anhenaobe/industrial-comunication-gateway/docs/industrial_linux_gateway_requirements.md

# Industrial Communication Gateway

## Revisión 0.5 — Especificación técnica preliminar de producto y sistema

| Campo | Valor |
|---|---|
| Proyecto | Industrial Communication Gateway (nombre provisional) |
| Tipo de documento | Especificación técnica preliminar de producto y sistema |
| Revisión | 0.5 |
| Estado | Fase de diseño y requisitos; baseline de componentes seleccionada provisionalmente; sin esquemático, PCB, firmware validado ni prototipo completo |
| Fecha | 2026-10-04 |
| Propietario | Equipo del proyecto universitario de Diseño Electrónico |
| Archivo maestro | `docs/industrial_linux_gateway_requirements.md` |

> **Estado de plataforma.** Rev. A utilizará **STM32H723VET6** como plataforma principal de procesamiento y **Zephyr RTOS** como base de software embebido. Esta decisión está **ACCEPTED / BASELINE FOR REV A**. La revisión externa del pinout confirmó recursos suficientes para las interfaces previstas, pero la asignación concreta de pines y periféricos sigue **TBD** y deberá congelarse antes del esquemático. La decisión no implica que existan firmware, PCB, prototipo o validación funcional.

---

## 1. Propósito, descripción y alcance

Este documento define el baseline técnico preliminar de un gateway de comunicación industrial destinado a integrar equipos de campo heterogéneos con redes IP, servicios de supervisión, servidores o sistemas SCADA. Conserva los requisitos y decisiones de revisiones anteriores, registra los cambios de arquitectura aceptados y separa explícitamente lo decidido, los objetivos de diseño, lo implementado, lo validado y los elementos todavía TBD.

### 1.1 Problema

Los entornos industriales combinan equipos con RS-485, CAN-FD, señales digitales de 24 V, interfaces Ethernet y dispositivos legacy que no ofrecen integración directa con servicios IP modernos. Las diferencias de interfaz eléctrica, protocolo, referencia de tierra, protección, temporización y mantenibilidad impiden conectar esos equipos directamente a una red superior de forma defendible.

El equipo, la instalación y el flujo que constituirán el caso industrial demostrador concreto todavía son **TBD** (TBD-02/03). No se atribuyen cliente, planta, pérdidas ni métricas sin evidencia.

El problema de ingeniería no es solo traducir datos. El sistema debe:

- adaptar y proteger las interfaces eléctricas de campo;
- adquirir, validar, asociar tiempo y normalizar información;
- traducir protocolos sin asumir control crítico en tiempo real;
- conservar datos y evidencia diagnóstica ante fallos razonables;
- ofrecer configuración, mantenimiento y recuperación reproducibles;
- separar la electrónica expuesta al entorno industrial del dominio de procesamiento embebido.

### 1.2 Solución propuesta y propósito

La solución se compone de una PCB propia con un **STM32H723VET6**, software embebido basado en **Zephyr RTOS** y bloques industriales de alimentación, protección, conversión, transceptores, acondicionamiento de E/S, almacenamiento persistente, conectores, diagnóstico y prueba. Los componentes principales de interfaz están seleccionados provisionalmente (§3.6); la tecnología y capacidad del almacenamiento y la asignación concreta de pines permanecen TBD.

El producto actúa como puente entre:

| Lado | Función |
|---|---|
| **FIELD SIDE** | Conexión a RS-485, CAN-FD, E/S digitales de 24 V y equipos Ethernet de máquina. |
| **NETWORK / SERVER SIDE** | Comunicación IP con SCADA, servidor, servicios de gestión o API seleccionada. |

Las capacidades objetivo comprenden adquisición, traducción de protocolos, procesamiento local, almacenamiento, logging, diagnóstico y comunicación con servidor. El gateway no se define como controlador de seguridad ni como plataforma de control crítico de tiempo real.

### 1.3 Filosofía de diseño

| Principio | Aplicación al proyecto |
|---|---|
| Modularidad funcional | Mantener límites eléctricos y lógicos documentados entre procesamiento, alimentación, red e interfaces de campo. |
| Robustez | Definir protección, retornos de corriente, aislamiento y comportamiento ante fallos según evidencia del entorno. |
| Mantenibilidad | Proporcionar identificación de versiones, logs, consola de servicio, actualización y recuperación documentadas. |
| Testabilidad | Incorporar puntos de prueba, diagnóstico por bloques y procedimientos reproducibles desde Rev. A. |
| Escalabilidad | Reservar capacidades y expansión externa sin convertirlas en requisitos de Rev. A. |
| Separación de dominios | Mantener el procesamiento embebido separado de transceptores y front-ends expuestos al campo. |
| Diseño industrial | Tratar alimentación, ESD/EFT/surge, grounding, conectores y mecánica como partes del sistema. |
| Trazabilidad | Vincular decisiones, requisitos, TBD y evidencia de verificación mediante IDs estables. |

### 1.4 Alcance de Rev. A

#### In Scope

- integración del STM32H723VET6 como plataforma principal y Zephyr RTOS como base de software;
- congelación de la asignación de periféricos y pines a partir de la suficiencia ya verificada;
- diseño de la PCB propia y su integración mecánica;
- entrada industrial nominal de 24 VDC, regulación, filtrado y protección;
- una interfaz Ethernet como uplink principal y evaluación de una segunda interfaz como objetivo TBD;
- dos canales RS-485 y un canal CAN-FD como arquitectura objetivo;
- cuatro entradas digitales industriales de 24 V y dos salidas digitales industriales como arquitectura objetivo;
- interfaz de servicio desde PC; medio físico y cantidad de interfaces TBD;
- consola o mecanismo de mantenimiento, indicadores de estado y estrategia de watchdog; implementación TBD;
- integración Zephyr, drivers, adquisición y servicios embebidos básicos;
- logging, almacenamiento local, timestamping, configuración y diagnóstico;
- validación eléctrica, funcional y de comunicaciones;
- documentación, DFM y DFT básicas.

#### Out of Scope para Rev. A

- diseño RF, Wi-Fi integrado, antenas propias o LTE integrado directamente en la PCB;
- diseño de memoria DDR externa;
- GPU como requisito de aplicación;
- pantalla local o GUI en pantalla integrada;
- certificación del producto completo o declaración de cumplimiento EMC;
- seguridad funcional certificada;
- visión artificial, IA o control de motores;
- interfaces analógicas industriales 0–10 V o 4–20 mA sin un caso de uso que las justifique;
- procesador o MCU auxiliar adicional sin requisito que lo justifique.

#### Future Expansion

- LTE mediante módulo comercial externo;
- entradas 4–20 mA y 0–10 V;
- TSN, secure boot y actualizaciones firmadas;
- monitorización avanzada y canales adicionales CAN o RS-485;
- procesador auxiliar solo si aparece un requisito específico conforme a §3.3.

### 1.5 Convenciones

- **Deberá:** requisito verificable; **TBD:** parámetro, componente o decisión pendiente de evidencia.
- **Must / Should / Could / Won't:** prioridad MoSCoW para Rev. A.
- **Accepted:** decisión vigente; **Preliminary Accepted:** baseline de diseño sujeto a validación; **Planned:** uso reservado, no dependencia obligatoria; **Deferred:** fuera de Rev. A; **Superseded:** decisión histórica reemplazada.
- Una cantidad marcada **TARGET / PRELIMINARY BASELINE** orienta la arquitectura, pero no se considera congelada hasta cerrar sus criterios de aceptación.
- **SELECTED / PROVISIONAL DESIGN BASELINE:** selección provisional para la arquitectura actual; no implica fabricación, circuito probado ni validación física.
- **Origen:** necesidad, caso de uso o decisión que justifica el requisito.
- Producto (§5) define comportamiento; sistema (§7) lo descompone por responsabilidad.
- **Decided:** decisión formal vigente; **Implemented:** existe una realización revisable; **Validated:** existe evidencia contra un criterio de aceptación; **Not implemented / Not validated:** estado explícito cuando solo existe intención o decisión.

### 1.6 Verificación

| Código | Método | Evidencia |
|---|---|---|
| I | Inspección | Documentación, configuración, montaje o marcado. |
| A | Análisis | Cálculo, simulación o evaluación técnica. |
| T | Ensayo | Medición o estímulo controlado. |
| D | Demostración | Ejecución funcional representativa. |

Un requisito no puede cerrarse mientras su criterio de aceptación siga siendo TBD.

---

## 2. Contexto y Decision Register

### 2.1 Hechos conocidos

| ID | Hecho |
|---|---|
| H-01 | El STM32H723VET6 es la plataforma principal de procesamiento seleccionada para Rev. A y Zephyr RTOS es la base de software embebido. |
| H-02 | El proyecto incluye el diseño de una PCB industrial propia con separación funcional entre procesamiento e interfaces expuestas al campo. |
| H-03 | El sistema integrará equipos industriales externos con una red IP, servidor o SCADA. |
| H-04 | No existe todavía esquemático ni PCB del gateway. |
| H-05 | No se han realizado ensayos eléctricos o funcionales del gateway completo. |
| H-06 | La tecnología, capacidad, resistencia y arquitectura del almacenamiento persistente permanecen TBD. |
| H-07 | Rev. A no incorpora un procesador o MCU auxiliar adicional sin un requisito que lo justifique. |
| H-08 | Una revisión externa del pinout confirmó que el STM32H723VET6 dispone de pines suficientes para las interfaces previstas; la asignación concreta de señales y periféricos sigue TBD. La referencia durable de esa revisión debe incorporarse al repositorio (TBD-38). |

### 2.2 Baseline funcional objetivo de Rev. A

| Elemento | Objetivo preliminar | Estado |
|---|---|---|
| Plataforma de procesamiento | STM32H723VET6 + Zephyr RTOS | Decided / Accepted for Rev. A; firmware not implemented, not validated |
| Ethernet principal | 1 × DP83826I, 10/100, RMII previsto | Seleccionado provisionalmente; implementación pendiente |
| Segundo Ethernet | Segunda interfaz independiente | Target / TBD; requiere justificación y validación de recursos |
| RS-485 | 2 × THVD1420, half-duplex | Seleccionados provisionalmente; parámetros de bus TBD |
| CAN | 1 × ATA6561 CAN-FD | Seleccionado provisionalmente; parámetros de bus TBD |
| Entradas digitales | 2 × ISO1212 → 4 DI aisladas de 24 V | Seleccionados provisionalmente; pasivos y umbrales TBD |
| Salidas digitales | 2 × BSP75N → 2 DO low-side, 24 V / 500 mA nominales por canal | Seleccionados provisionalmente; adaptación de control y estado seguro TBD |
| Interfaz de servicio | Medio soportado desde PC | Función Accepted por D-17; medio, cantidad, protocolo y conectores TBD |
| Almacenamiento | Persistencia local para configuración, logs y datos pendientes | Función accepted; tecnología, capacidad y resistencia TBD |
| Indicadores | Alimentación, sistema y fault; actividad adicional si es práctica | Target; cantidad y semántica TBD |
| Alimentación | 24 VDC nominal → protección → filtro → conversión | Rails mínimos 3.3 V, 5 V y campo 24 V; presupuesto y conversión TBD |

### 2.3 Decision Register

Se preservan los IDs `D-*` de las revisiones anteriores. Las decisiones solicitadas para esta revisión se incorporan sin duplicar las ya existentes.

| ID | Decisión | Estado | Justificación / consecuencia |
|---|---|---|---|
| D-01 | Arquitectura Linux con separación entre plataforma de cómputo y carrier industrial. | **Superseded by D-18** | Se conserva como decisión histórica. La separación funcional entre procesamiento e interfaces industriales permanece, pero Linux y el SoM dejaron de ser el baseline vigente. |
| D-02 | Ethernet cableado como uplink principal. | Accepted | Proporciona la interfaz primaria con la red superior y facilita integración y diagnóstico IP. |
| D-03 | Wi-Fi fuera del alcance inicial. | Accepted | Rev. A no incorpora conectividad Wi-Fi integrada. |
| D-04 | LTE solo mediante módulo comercial externo o expansión futura. | Deferred | Evita diseño RF propio y mantiene LTE fuera de la función base. |
| D-05 | Sin antena ni front-end RF propio. | Accepted | El diseño de RF no forma parte de Rev. A. |
| D-06 | No seleccionar plataforma ni componentes en la revisión 0.2. | Superseded by D-07 | Se conserva por trazabilidad histórica; ya no describe el estado vigente. |
| D-07 | MYC-YM6231 basado en TI AM6231 / AM62x como plataforma de cómputo de Rev. A. | **Superseded by D-18** | Decisión histórica de Rev. 0.3. Se conserva su razonamiento: SoM con Cortex-A53, Cortex-M4F, PRU, Linux, DDR, eMMC y PMIC integrados. Ya no describe la arquitectura vigente. |
| D-08 | No utilizar un MCU auxiliar adicional en Rev. A. | Accepted; clarified by D-18 | Se refiere a un segundo procesador auxiliar. No contradice que la plataforma principal sea ahora un MCU. Solo se reabrirá si aparece una necesidad que el STM32H723VET6 y circuitos de supervisión más simples no puedan satisfacer. |
| D-09 | Reservar el Cortex-M4F interno del SoM anterior para supervisión y tareas deterministas. | **Superseded by D-18** | Decisión histórica asociada exclusivamente al MYC-YM6231; ese recurso no forma parte de la arquitectura vigente. |
| D-10 | Reservar PRU del SoM anterior para I/O determinista o protocolos futuros. | **Superseded by D-18** | Decisión histórica asociada exclusivamente al MYC-YM6231; ese recurso no forma parte de la arquitectura vigente. |
| D-11 | Dos interfaces Gigabit Ethernet como arquitectura objetivo. | Reopened / TBD | Ethernet cableado principal permanece Accepted por D-02. La necesidad, velocidad y viabilidad de una segunda interfaz deben justificarse; no se consideran cerradas. |
| D-12 | Dos interfaces RS-485 independientes. | Preliminary Accepted | 2 × THVD1420 seleccionados provisionalmente en half-duplex; aislamiento, terminación, bias y parámetros de operación TBD. |
| D-13 | Un canal CAN-FD en Rev. A. | Preliminary Accepted | ATA6561 seleccionado provisionalmente; aislamiento, velocidad de operación, terminación y protocolo TBD. |
| D-14 | Cuatro DI de 24 V y dos DO industriales. | Preliminary Accepted | 2 × ISO1212 para DI aisladas y 2 × BSP75N para DO low-side seleccionados provisionalmente; adaptación, pasivos, protecciones específicas y estados seguros TBD. |
| D-15 | Entrada nominal de 24 VDC. | Preliminary Accepted | El rango, potencia y perfil de perturbaciones deben definirse antes de seleccionar protección y conversión. |
| D-16 | Sin pantalla local en Rev. A. | Accepted | La operación y configuración se realizarán mediante interfaces de red y servicio. |
| D-17 | Uso de PC externo para mantenimiento y configuración. | Accepted | El medio podrá ser Ethernet, USB, UART u otro mecanismo soportado; protocolo, conector, permisos y procedimiento permanecen TBD. SSH no es una obligación universal. |
| D-18 | Rev. A utilizará STM32H723VET6 como plataforma principal de procesamiento y Zephyr RTOS como base de software embebido. | **Accepted / Baseline for Rev. A** | Se verificó externamente suficiencia de pines para las interfaces previstas, sin congelar asignaciones concretas. El dispositivo integra Ethernet MAC, CAN-FD y UART/USART suficientes para el alcance planteado; su capacidad de procesamiento se considera adecuada como decisión de arquitectura, pendiente de validación bajo carga. El encapsulado LQFP100 favorece el diseño y fabricación de una PCB propia. Para el alcance actual no se requiere una plataforma Linux completa y una arquitectura embebida dedicada se alinea mejor con las funciones previstas. Coste, consumo, tamaño final, robustez y rendimiento medido no se consideran demostrados. |

### 2.4 Candidatos y decisiones todavía abiertas

| ID | Elemento | Estado y condición para decidir |
|---|---|---|
| C-01 | Perfil completo de alimentación de 24 VDC | Rango, corriente, transientes, hold-up y entorno TBD. |
| C-02 | Parámetros RS-485 | THVD1420 half-duplex seleccionado provisionalmente; velocidad de operación, terminación, bias y aislamiento TBD. |
| C-03 | Parámetros eléctricos y de protocolo de CAN-FD | El canal está aceptado preliminarmente; velocidad, carga, terminación, aislamiento y protocolo están abiertos. |
| C-04 | Cuatro DI aisladas | 2 × ISO1212 seleccionados provisionalmente; umbrales, corriente, pasivos, protección y diagnóstico TBD. |
| C-05 | Dos DO low-side | 2 × BSP75N seleccionados provisionalmente; 24 V / 500 mA nominales por canal; adaptación de control, cargas concretas, estado seguro y protección adicional TBD. |
| C-06 | Entradas analógicas 0–10 V o 4–20 mA | Could / Future Expansion; requieren caso de uso y requisitos metrológicos. |
| C-07 | Procesador o MCU auxiliar | Won't para Rev. A por D-08; no se refiere al MCU principal seleccionado por D-18. |
| C-08 | Aislamiento galvánico por interfaz o dominio | Requiere análisis de tierras, cableado, fallos, EMC y costo. |
| C-09 | Supervisor/watchdog externo | Requiere matriz fallo-detector-acción y justificar independencia respecto al MCU principal. |
| C-10 | Segunda interfaz Ethernet | La necesidad, velocidad, arquitectura física y consumo de recursos permanecen TBD. |
| C-11 | Almacenamiento persistente | Tecnología, interfaz, capacidad, resistencia, integridad y retención permanecen TBD. |

### 2.5 Supuestos de trabajo

| ID | Supuesto | Acción de validación |
|---|---|---|
| S-01 | El demostrador dispondrá de al menos un equipo industrial con interfaz documentada. | Identificar equipo, manual, protocolo y acceso para ensayos. |
| S-02 | La red superior permitirá pruebas Ethernet con servidor o SCADA. | Definir infraestructura, direccionamiento y servicio de prueba. |
| S-03 | Zephyr RTOS proporcionará o permitirá integrar los drivers y servicios necesarios para Rev. A. | Verificar versión, soporte de placa/SoC, drivers, subsistemas y restricciones antes del firmware mínimo. |
| S-04 | La suficiencia global de pines del STM32H723VET6 está validada externamente. | Incorporar la referencia durable de la revisión (TBD-38) y congelar la asignación concreta de periféricos y pines antes del esquemático; no inferir señales individuales. |

---

## 3. Arquitectura del sistema

### 3.1 Arquitectura funcional

```mermaid
flowchart TB
    FIELD["Field devices<br/>Equipos legacy / sensores / actuadores"]
    IFACES["RS-485 ×2 TARGET<br/>CAN-FD ×1 TARGET<br/>Digital I/O 24 V: 4 DI + 2 DO TARGET"]
    CARRIER["Industrial carrier<br/>Power / protection / transceivers<br/>DI isolation integrated / other isolation TBD<br/>Diagnostics / connectors"]
    MCU["STM32H723VET6<br/>Rev. A processing baseline<br/>Pin assignment TBD"]
    ZEPHYR["Zephyr RTOS<br/>Acquisition / protocol services<br/>Normalization / logging / diagnostics"]
    ETH["Ethernet primary<br/>Second interface TBD<br/>DP83826I 10/100 / RMII<br/>Implementation pending"]
    SERVER["SCADA / server<br/>Network-side services TBD"]

    FIELD <--> IFACES
    IFACES <--> CARRIER
    CARRIER <--> MCU
    MCU <--> ZEPHYR
    ZEPHYR <--> ETH
    ETH <--> SERVER
```

El diagrama representa límites funcionales, no conexiones eléctricas finales. Cantidades marcadas `TARGET` corresponden al baseline preliminar y sus implementaciones permanecen sujetas a validación.

### 3.2 Arquitectura de procesamiento y software embebido

```mermaid
flowchart TB
    FIELD["Periféricos e interfaces de campo<br/>Asignación concreta TBD"]
    MCU["STM32H723VET6<br/>Plataforma principal decidida"]
    ZEPHYR["Zephyr RTOS<br/>Base de software decidida<br/>Firmware not implemented / not validated"]
    SERVICES["Adquisición / validación / normalización<br/>Networking / logging / persistencia<br/>Diagnóstico / configuración / actualización"]

    FIELD <--> MCU
    MCU --> ZEPHYR
    ZEPHYR --> SERVICES
```

#### STM32H723VET6 + Zephyr RTOS

| Responsabilidad objetivo | Prioridad Rev. A | Límite actual |
|---|---|---|
| Inicialización de Zephyr RTOS y servicios embebidos | Must | Versión, configuración, arranque y criterios TBD; no implementado. |
| Drivers de interfaces habilitadas | Must | Deben validarse contra la asignación de pines y soporte de Zephyr. |
| Adquisición, validación y normalización de datos | Must | Variables, tasas, latencia y formato TBD. |
| Logging, almacenamiento local y cola persistente | Must | Tecnología, capacidad, retención, integridad y resistencia TBD. |
| Timestamping y orden de eventos | Must | Fuente, exactitud y retención de tiempo TBD. |
| Gestión de red y comunicación con servidor/SCADA | Must | Direccionamiento, protocolos y seguridad TBD. |
| Configuración y diagnóstico | Must | Modelo de datos, permisos y endpoints TBD. |
| Modbus RTU | Should | Aplicable a RS-485; mapa, función y nodos TBD. |
| Modbus TCP | Should | Aplicable si el caso de uso lo requiere. |
| CAN-FD mediante drivers y API soportados | Should; Must si se activa CAN-FD | Driver, bitrate y protocolo de capa superior TBD. |
| MQTT | Should | Broker, QoS, esquema y credenciales TBD. |
| Mantenimiento desde PC | Should | Medio, protocolo, permisos y seguridad TBD. |
| Actualización de software | Should | Mecanismo, autenticación, rollback y firma TBD. |
| API REST | Could | No obligatoria mientras no exista consumidor definido. |
| Interfaz web ligera | Could | Solo si se justifica; no implica pantalla local. |

La lista asigna responsabilidades funcionales a la plataforma STM32H723VET6 + Zephyr. No afirma que el firmware exista ni que todas las funciones `Should` o `Could` se implementarán en Rev. A. MQTT, Modbus TCP, REST y una interfaz web permanecen opciones condicionadas al caso de uso; no son protocolos definitivos por la selección de Zephyr.

### 3.3 Política sobre procesador auxiliar

El STM32H723VET6 es el procesador principal de Rev. A. Rev. A no incorporará otro MCU o procesador auxiliar salvo que aparezca evidencia de una necesidad que no pueda satisfacerse razonablemente con el MCU principal y circuitos de supervisión más simples:

- supervisión independiente del dominio de alimentación del MCU principal;
- power-cycle autónomo del MCU principal;
- requisito de seguridad funcional;
- aislamiento físico de funciones críticas;
- periféricos necesarios no disponibles en la plataforma principal;
- supervisión que deba continuar con el MCU principal apagado.

Reabrir la decisión requerirá actualizar D-08, requisitos, presupuesto de potencia, BOM, arquitectura de firmware, comunicaciones internas, pruebas y análisis de nuevos modos de fallo.

### 3.4 Arquitectura preliminar de alimentación

```mermaid
flowchart TB
    VIN["24 VDC nominal<br/>Input range / current / transients TBD"]
    PROT["Input protection<br/>Fuse/eFuse / reverse polarity / TVS TBD"]
    EMI["EMI filter<br/>Topology and targets TBD"]
    CONV["Power conversion<br/>Topology / components / efficiency TBD"]
    MCU_RAILS["MCU and digital rails<br/>3.3 V / sequence / budget TBD"]
    FIELD_RAILS["Interface / field rails<br/>5 V / 24 V field<br/>Isolation / budget TBD"]

    VIN --> PROT
    PROT --> EMI
    EMI --> CONV
    CONV --> MCU_RAILS
    CONV --> FIELD_RAILS
```

La arquitectura funcional aceptada es `24 VDC nominal → protección → filtrado → conversión → rails requeridos por procesamiento e interfaces`. Se identifican necesidades mínimas de 3.3 V, 5 V y dominio de campo de 24 V; la topología, secuencias, reguladores, DC/DC y potencia siguen pendientes.

Antes de seleccionar componentes de conversión deben definirse: rango de entrada, presupuesto de corriente, carga pico, objetivo de eficiencia, transientes, inversión de polaridad, surge/EFT, hold-up, brownout y presupuesto térmico.

#### Rails mínimos y Power Budget inicial

| Rail / dominio | Necesidades previstas |
|---|---|
| 3.3 V | STM32H723, DP83826I / lógica según configuración, 2 × THVD1420, VIO del ATA6561, VCC1 de los 2 × ISO1212 y lógica adicional. |
| 5 V | VCC del ATA6561; posible interfaz de control del BSP75N. ATA6561 introduce la necesidad de este rail. |
| 24 V | Dominio de campo, entradas digitales y alimentación de cargas externas de las DO según arquitectura final. |

Base para la siguiente fase: extracción formal de consumos desde datasheets, sin estimaciones ni selección de reguladores o DC/DC. El power budget no está completo.

| Bloque | Componente | Cant. | Rail | Ityp | Imax | Ipeak | Estado del dato |
|---|---|---:|---|---|---|---|---|
| Procesamiento | STM32H723VET6 | 1 | 3.3 V; configuración interna pendiente | TO EXTRACT FROM DATASHEET | TO EXTRACT FROM DATASHEET | TO EXTRACT FROM DATASHEET | Pendiente de extracción formal |
| Ethernet PHY | DP83826I | 1 | 3.3 V / lógica según configuración | TO EXTRACT FROM DATASHEET | TO EXTRACT FROM DATASHEET | TO EXTRACT FROM DATASHEET | Pendiente de extracción formal |
| RS-485 | THVD1420 | 2 | 3.3 V | TO EXTRACT FROM DATASHEET | TO EXTRACT FROM DATASHEET | TO EXTRACT FROM DATASHEET | Pendiente de extracción formal |
| CAN-FD | ATA6561 | 1 | VCC 5 V; VIO 3.3 V | TO EXTRACT FROM DATASHEET | TO EXTRACT FROM DATASHEET | TO EXTRACT FROM DATASHEET | Pendiente de extracción por rail |
| DI aisladas | ISO1212 | 2 | VCC1 3.3 V; entradas de campo 24 V | TO EXTRACT FROM DATASHEET | TO EXTRACT FROM DATASHEET | TO EXTRACT FROM DATASHEET | Pendiente: separar lógica y corriente de entrada |
| DO low-side | BSP75N | 2 | Cargas externas 24 V; control ≈5 V mediante adaptación TBD | TO EXTRACT FROM DATASHEET | TO EXTRACT FROM DATASHEET | TO EXTRACT FROM DATASHEET | Pendiente: separar control, cargas y disipación |

Los 500 mA nominales por DO son una especificación preliminar de carga externa, no un consumo interno extraído. La adaptación de control y los bloques adicionales se incorporarán al presupuesto cuando se definan.

### 3.5 System Functional Blocks

| # | Bloque | Función | Estado | Dependencia principal | Componentes/subbloques por seleccionar |
|---:|---|---|---|---|---|
| 1 | Processing platform | Ejecutar firmware Zephyr, adquisición, procesamiento, comunicaciones y diagnóstico. | STM32H723VET6 + Zephyr decided; not implemented / not validated | Asignación concreta, soporte de drivers y presupuesto de recursos | Pin mapping, configuración de Zephyr, memoria y estrategia térmica TBD |
| 2 | Industrial power input | Recibir alimentación industrial nominal de 24 VDC. | Preliminary Accepted | Perfil de instalación | Conector, rango y presupuesto TBD |
| 3 | Input protection | Limitar daño por sobrecorriente, polaridad inversa y transientes. | Required; diseño TBD | Perfil eléctrico/ambiental | Fusible/eFuse, reverse-polarity, TVS TBD |
| 4 | Power conversion | Generar los rails requeridos desde 24 V nominal. | Functional architecture accepted; implementación TBD | Tensiones, secuencia, potencia, eficiencia y térmica | Topología, convertidores, inductores y pasivos TBD |
| 5 | Ethernet interface | Conectar la red superior; segundo enlace TBD. | DP83826I seleccionado provisionalmente | MAC del MCU, 10/100, RMII | Magnetics, clocks, conector y protección TBD |
| 6 | RS-485 interfaces | Dos buses independientes half-duplex. | 2 × THVD1420 seleccionados provisionalmente | UARTs, aislamiento y topología | Terminación, bias, protección y bitrate de operación TBD |
| 7 | CAN-FD interface | Conectar un bus CAN-FD. | ATA6561 seleccionado provisionalmente | FDCAN; VCC 5 V / VIO 3.3 V | Terminación, protección, aislamiento y bitrate de operación TBD |
| 8 | Digital input front-end | Cuatro entradas aisladas de 24 V. | 2 × ISO1212 seleccionados provisionalmente | VCC1 3.3 V; 2 canales por dispositivo | RSENSE, RTHR, CIN y EMC/surge TBD |
| 9 | Digital output stage | Dos DO low-side, 24 V / 500 mA nominales por canal. | 2 × BSP75N seleccionados provisionalmente | Control ≈5 V mediante adaptación TBD | Adaptación, protección adicional, feedback y estado seguro TBD |
| 10 | PC service interface | Servicio, actualización, recuperación o expansión. | Required function; medio TBD | Periféricos y recursos del MCU | USB/UART/Ethernet, conectores, alimentación y ESD TBD |
| 11 | Maintenance console | Exponer logs de arranque, recuperación y debug cuando aplique. | Target | Interfaz soportada por el firmware y niveles eléctricos | Medio, conector/adaptador y protección TBD |
| 12 | Status indicators | Indicar alimentación, heartbeat, fault y actividad práctica. | Target | GPIO, software y panel mecánico | LEDs, drivers, colores y semántica TBD |
| 13 | Supervisor/watchdog strategy | Detectar fallos y ejecutar recuperación con autoridad conocida. | Required strategy; implementación TBD | Matriz fallo-detector-acción | Watchdog del MCU o supervisor externo TBD |
| 14 | Isolation strategy | Separar dominios cuando el análisis lo justifique. | Analysis required | Grounding, cables, entorno y costo | Barreras, aisladores y fuentes aisladas TBD |
| 15 | ESD/EFT/surge protection | Proteger conexiones externas según perfil definido. | Analysis required | Objetivos de ensayo TBD | Dispositivos y redes de protección TBD |
| 16 | Grounding strategy | Definir tierras lógica, chasis y campo, retornos y blindajes. | TBD | Envolvente, aislamiento y EMC | Net classes, unión a chasis y terminación de shield TBD |
| 17 | Persistent storage | Alojar firmware cuando corresponda, configuración, logs y datos pendientes. | Required function; tecnología TBD | Volumen y carga de escritura | Tecnología, interfaz, capacidad, resistencia, organización e integridad TBD |
| 18 | External connectors | Proporcionar conexiones identificadas y retenidas. | TBD | Mecánica, corrientes y cableado | Conectores de power, field, Ethernet, USB y servicio TBD |
| 19 | Test points / DFT | Permitir prueba de rails, reset y señales críticas. | Required | Plan de prueba y layout | Lista, geometría, fixtures y cobertura TBD |
| 20 | Mechanical integration | Alojar PCB, conectores y cableado, disipar calor y dar acceso seguro. | TBD | Dimensiones, conectores y térmica | Envolvente, montaje, retención y solución térmica TBD |

### 3.6 Selección provisional de componentes y subbloques pendientes

Todos los componentes siguientes quedan **SELECTED / PROVISIONAL DESIGN BASELINE** para la arquitectura actual. Son la base del siguiente paso, construir el power budget; no existe hardware fabricado, circuito probado ni selección validada físicamente, y el esquemático y PCB finales siguen pendientes. Se conserva la arquitectura STM32H723VET6 + Zephyr RTOS.

| Bloque | Componente | Cant. | Función y características de la selección provisional |
|---|---|---:|---|
| PROCESSING | STM32H723VET6 | 1 | Microcontrolador principal; arquitectura sin cambios y asignación concreta pendiente. |
| NETWORK | DP83826I | 1 | PHY externo 10BASE-Te / 100BASE-TX para el MAC Ethernet del STM32H723; RMII previsto, lógica compatible con 3.3 V, aplicaciones y temperatura industriales. No es un controlador Ethernet completo. |
| INDUSTRIAL COMMUNICATION / RS-485 | THVD1420 | 2 | Dos interfaces físicas independientes half-duplex; alimentación compatible con 3.3 V, hasta 12 Mbps, fail-safe, protección ESD/EFT elevada, hasta 256 nodos y temperatura industrial. Reemplaza la selección provisional previa de SP3485. |
| INDUSTRIAL COMMUNICATION / CAN-FD | ATA6561 | 1 | Transceiver físico CAN FD, hasta aproximadamente 5 Mbps, protecciones integradas de bus; VCC = 5 V y VIO = 3.3 V para compatibilidad lógica. Se selecciona ATA6561, no ATA6560. |
| INDUSTRIAL I/O / DI | ISO1212 | 2 | Dos canales por dispositivo → 4 entradas digitales aisladas de 24 V. Receptor de 24–60 V; IEC 61131-2 Type 1, 2 y 3, configurable sourcing/sinking, salida compatible con 3.3 V, aislamiento integrado, sin alimentación de campo independiente. Corriente de entrada configurable mediante RSENSE; lado lógico alimentado por VCC1. |
| INDUSTRIAL I/O / DO | BSP75N | 2 | Dos salidas **LOW-SIDE**, especificación preliminar 24 V nominales / 500 mA nominales por salida. Dispositivo autoprotegido, VDS continuo = 60 V, destinado a aplicaciones de 12 V y 24 V con cargas resistivas, inductivas y capacitivas. Protecciones contra cortocircuito, sobretemperatura y sobrecorriente; active clamp, load dump y elevada capacidad de energía inductiva. |

CAN-FD previsto: `STM32H723 FDCAN → ATA6561 → CANH / CANL`. Su VCC requiere disponer de un rail de 5 V.

**Control BSP75N pendiente:** aunque puede activarse con niveles lógicos relativamente bajos, las protecciones están especificadas correctamente a partir de aproximadamente **VIN ≥ 4.5 V**. No asumir conexión directa `STM32 GPIO 3.3 V → BSP75N`. Camino previsto: `STM32 3.3 V → etapa de adaptación / driver TBD → señal ≈5 V → BSP75N`. La etapa exacta aún no está seleccionada.

Los pasivos de las DI no se diseñan en esta actualización. Los procedimientos del datasheet para RSENSE, RTHR, CIN y EMC/surge protection se desarrollarán posteriormente, junto con las protecciones específicas de las otras interfaces.

Fuente de esta actualización: documentación vigente y decisiones de selección comunicadas por el equipo. No se encontraron datasheets locales de los componentes seleccionados; las características aquí registradas proceden de esas decisiones y su verificación documental y extracción formal de consumos siguen pendientes.

Subbloques que todavía requieren definición:

| Block | Required function | Status | Selection pending |
|---|---|---|---|
| 24 V input connector | Recibir alimentación y mantener polaridad/retención identificables. | TBD | Familia, corriente, pitch, orientación y retención |
| Fuse / eFuse | Limitar sobrecorriente y energía de fallo. | TBD | Tecnología, rating, coordinación y recuperación |
| Reverse polarity protection | Evitar daño bajo el perfil de polaridad definido. | TBD | Topología, pérdida y rating |
| TVS | Limitar transientes en la entrada y puertos aplicables. | TBD | Tipo, standoff, clamp y energía según perfil TBD |
| EMI filter | Atenuar perturbaciones conducidas. | TBD | Topología, corner, damping y componentes |
| Power conversion | Alimentar MCU e interfaces con margen. | TBD | Topología, tensiones, secuencia, controladores, frecuencia, potencia y magnetics |
| Auxiliary regulators | Generar los rails adicionales requeridos. | TBD | Tensiones, secuencia, cargas y reguladores |
| Ethernet PHY / magnetics | Enlace desde MAC integrado. | DP83826I seleccionado provisionalmente | Magnetics, clocks, termination y protección |
| Ethernet connector | Conectar el enlace principal; posible segundo enlace TBD. | TBD | Con/sin magnetics, LEDs, shield y retención |
| RS-485 transceivers | Dos interfaces half-duplex. | 2 × THVD1420 seleccionados provisionalmente | Aislamiento, terminación, bias y protección |
| CAN-FD transceiver | Adaptar FDCAN al bus. | ATA6561 seleccionado provisionalmente | Bitrate de operación, aislamiento, terminación y standby |
| Digital input front-end | Cuatro DI aisladas de 24 V. | 2 × ISO1212 seleccionados provisionalmente | RSENSE, RTHR, CIN, EMC/surge y diagnóstico |
| Digital output driver | Dos DO low-side de 24 V / 500 mA nominales. | 2 × BSP75N seleccionados provisionalmente | Adaptación 3.3 V → ≈5 V, estado seguro, protección adicional y feedback |
| Isolators | Cruzar barreras justificadas. | TBD after isolation analysis | Tecnología, canales, ratings y isolated power |
| PC service connector / protection | Exponer el medio de mantenimiento seleccionado. | TBD | USB/UART/Ethernet, tipo de conector, role, ESD y alimentación |
| UART/service interface | Proporcionar consola segura y accesible. | TBD | Nivel lógico, conector, adapter y protección |
| LEDs | Mostrar estados no ambiguos. | TBD | Cantidad, color, brillo, driver y ubicación |
| Temperature / board monitoring sensor | Medir condición de placa si el análisis lo requiere. | Conditional / TBD | Necesidad, sensor, ubicación y bus |
| Watchdog / supervisor | Recuperar fallos no cubiertos si se justifica dispositivo externo. | Conditional / TBD | Cobertura, independencia, timeout y autoridad |
| Field connectors | Conectar RS-485, CAN-FD y E/S. | TBD | Familia, poles, current, keying y shield |
| Test points | Facilitar bring-up, fabricación y diagnóstico. | Required; details TBD | Señales, formato, acceso y fixture |

### 3.7 Flujo conceptual de datos y comandos

| Dirección | Flujo |
|---|---|
| Adquisición | Field device → physical interface → protection/transceiver/input stage → MCU peripheral → Zephyr driver → validation/protocol handling → normalization → local processing → network service → SCADA/server. Logging o persistencia se aplican en los puntos definidos por la política TBD; no todo paquete debe almacenarse antes de transmitirse. |
| Comando | SCADA/server → Ethernet → Zephyr network service → authorization/validation TBD → protocol handler → MCU peripheral → protected field interface → device |

Los comandos solo se habilitarán para casos de uso y actores autorizados. El gateway no se asume apto para lazo de control crítico o respuesta hard real-time; latencia, pérdida de enlace y estados seguros deben definirse por caso de uso.

### 3.8 Arquitectura de comunicaciones

| Interfaz | Objetivo | Uso previsto | Pendiente |
|---|---|---|---|
| Ethernet | DP83826I 10/100, RMII; segundo enlace TBD | Uplink principal | Magnetics, clocks, protocolo, conector, protección y segundo enlace TBD |
| RS-485 | 2 × THVD1420 half-duplex | Modbus RTU y equipos legacy | Aislamiento, bias, terminación, protección y bitrate de operación TBD |
| CAN-FD | ATA6561 desde FDCAN | Driver Zephyr y protocolo de aplicación TBD | Aislamiento, bitrate de operación, terminación, protección y carga TBD |
| USB | Capacidad por definir | Posible mantenimiento, actualización o expansión | Necesidad, roles, alimentación, conectores y protección TBD |
| Interfaz de servicio | Acceso desde PC | Configuración, logs de arranque, recuperación y debug | Medio, nivel, conector, acceso y protección TBD |

### 3.9 Diagnóstico y mantenimiento

| Capacidad | Prioridad | Alcance preliminar |
|---|---|---|
| Power LED | Should | Presencia de rail/estado a definir; no sustituye medición. |
| System/heartbeat LED | Should | Estado y fuente de control TBD. |
| Network/link status | Should | Indicadores del conector, software o ambos TBD. |
| Fault indicator | Should | Causas agrupadas y semántica TBD. |
| Actividad RS-485/CAN | Could | Solo si es práctica y no afecta integridad de señal. |
| Boot logs | Must | Accesibles mediante UART o medio equivalente validado. |
| Firmware and system logs | Must | Persistencia, rotación y retención TBD. |
| Watchdog | Should | Cobertura, timeout y autoridad TBD. |
| Maintenance console | Should | UART de servicio y/o consola de red controlada. |
| Controlled remote/local service | Should | Medio, política de acceso y configuración segura TBD. |
| Diagnostics endpoint | Should | Interfaz, autenticación y datos expuestos TBD. |
| Test points | Must | Rails y señales críticas definidos durante diseño. |

---

## 4. Actores y casos de uso

| Actor | Interacción |
|---|---|
| Equipo industrial | Datos, estados y comandos autorizados mediante RS-485, CAN-FD, E/S digital o Ethernet según el caso. |
| Servidor/SCADA/API | Recepción de datos, consulta de estado y configuración o comandos autorizados por Ethernet/IP. |
| Técnico/usuario | Instalación, configuración, diagnóstico, actualización y recuperación desde PC externo; acceso y permisos TBD. |
| Fuente industrial | Energía nominal de 24 VDC dentro del perfil TBD. |
| Red Ethernet | Conectividad IP, incluidas interrupciones temporales y potencial separación de redes. |

| Caso | Comportamiento esperado |
|---|---|
| UC-01 — Integrar un equipo con IP | Con equipo, interfaz y protocolo documentados: adquirir, validar, normalizar y transmitir datos; asociar tiempo cuando aplique y registrar resultados. Manejar datos inválidos, interfaz/red no disponible y rechazo del servidor. |
| UC-02 — Interrupción de red | Detectar indisponibilidad, conservar datos pendientes dentro de la capacidad definida y recuperar transferencia sin borrar antes del criterio de entrega. |
| UC-03 — Fallo de alimentación | Detectar o tolerar degradación, limitar corrupción y estados indeterminados; autoarrancar, comprobar estado y recuperar operación o informar fallo. |
| UC-04 — Diagnóstico de campo | Distinguir fallos de alimentación, plataforma de procesamiento, electrónica de interfaces, campo y red; consultar versiones/configuración, ejecutar recuperación autorizada y registrar resultado. |
| UC-05 — Configuración y mantenimiento | Validar cambios antes de activarlos, actualizar de forma controlada y recuperar versión/configuración operativa ante fallo. |
| UC-06 — Verificación integrada | Identificar la unidad, probar alimentación, interfaces y diagnóstico, y registrar versiones/resultados; localizar fallos hasta un bloque mantenible cuando sea posible. |

---

## 5. Requisitos de producto

### 5.1 Requisitos funcionales

| ID | Requisito | Especificación/valor | MoSCoW Rev. A | Origen |
|---|---|---|---|---|
| F-01 | El producto deberá adquirir datos de al menos un equipo industrial representativo del caso de uso seleccionado. | Equipo, datos, tasa y protocolo: TBD | Must | UC-01 |
| F-02 | El producto deberá comunicarse mediante al menos una interfaz de campo del baseline aceptado. | RS-485, CAN-FD, E/S digital o Ethernet; selección del demostrador TBD | Must | UC-01, D-11 a D-14 |
| F-03 | El producto deberá procesar localmente los datos necesarios para el caso de uso demostrador. | Validación, normalización y latencia: TBD | Must | UC-01 |
| F-04 | El producto deberá transmitir a un servidor/SCADA los datos definidos mediante Ethernet cableado. | Protocolo, formato, seguridad y rendimiento: TBD | Must | UC-01, D-02 |
| F-05 | El producto deberá detectar una interrupción de comunicación con el destino superior. | Tiempo y criterio de detección: TBD | Must | UC-02 |
| F-06 | El producto deberá almacenar temporalmente datos pendientes y reanudar transferencia al recuperarse la conectividad. | Capacidad, retención y política de reenvío: TBD | Must | UC-02 |
| F-07 | El producto deberá arrancar automáticamente y recuperar una condición operativa definida después del retorno de alimentación válida. | Tiempo de recuperación y estado operativo: TBD | Must | UC-03 |
| F-08 | El producto deberá proporcionar diagnóstico de alimentación, comunicaciones de campo, plataforma/firmware y enlace superior hasta el nivel soportado. | Variables, acceso y granularidad: TBD | Must | UC-01, UC-04 |
| F-09 | El producto deberá permitir consultar identificación, versiones y configuración, y aplicar cambios mediante un procedimiento controlado. | PC externo; medio, permisos y procedimiento TBD | Should | UC-04, UC-05, D-17 |
| F-10 | El producto podrá adquirir y accionar señales industriales discretas conforme al baseline preliminar. | Target: 4 DI de 24 V + 2 DO; características TBD | Should | D-14 |
| F-11 | El producto podrá adquirir señales 0–10 V o 4–20 mA si un caso de uso futuro lo justifica. | Cantidad y desempeño metrológico: TBD | Could | C-06 |
| F-12 | El producto no incorporará conectividad Wi-Fi en Rev. A. | No incluida | Won't | D-03 |
| F-13 | El producto no incorporará diseño propio de antena ni front-end RF en Rev. A. | No incluido | Won't | D-04, D-05 |
| F-14 | El producto podrá usar LTE mediante módulo comercial externo si un caso futuro lo justifica. | Interfaz y módulo: TBD; sin diseño RF propio | Could | D-04 |
| F-15 | El producto no incorporará LTE como función base de Rev. A. | No incluido como función base | Won't | D-04 |
| F-16 | El producto no incorporará un procesador o MCU auxiliar adicional en Rev. A sin requisito que lo justifique. | STM32H723VET6 es el MCU principal; supervisión adicional mediante circuitos justificables TBD | Won't | D-08, D-18 |
| F-17 | El producto no incorporará pantalla local en Rev. A. | Mantenimiento mediante PC externo | Won't | D-16, D-17 |

### 5.2 Requisitos no funcionales

| ID | Requisito | Especificación/valor | MoSCoW Rev. A | Origen |
|---|---|---|---|---|
| NF-01 | El producto deberá mantener comportamiento determinable ante pérdida, corrupción o ausencia de datos de campo. | Estados, timeouts y política: TBD | Must | UC-01 |
| NF-02 | El producto deberá preservar consistencia de datos pendientes frente a interrupciones de red y reinicios razonables. | Modelo de entrega e integridad: TBD | Must | UC-02 |
| NF-03 | El producto deberá evitar estados de salida no definidos durante arranque, apagado, brownout y reinicio. | Estado seguro por salida: TBD | Must si se incluyen salidas | UC-03 |
| NF-04 | El producto deberá operar durante el periodo definido para el demostrador y registrar reinicios o fallos detectables. | Duración y disponibilidad objetivo: TBD | Must | UC-03 |
| NF-05 | El producto deberá ser mantenible mediante documentación versionada, identificación y procedimientos reproducibles. | Artefactos y formato: TBD | Must | UC-04, UC-05 |
| NF-06 | El producto deberá permitir localizar fallos entre alimentación, plataforma/firmware, electrónica de interfaces, campo y red superior cuando la arquitectura lo permita. | Cobertura diagnóstica: TBD | Should | UC-04 |
| NF-07 | Software y configuración deberán poder actualizarse de manera controlada sin sustituir hardware. | Mecanismo, autenticación y recuperación: TBD | Should | UC-05 |
| NF-08 | La PCB deberá diseñarse para fabricación y prueba mediante procesos documentados acordes con los recursos del proyecto. | Reglas DFM/DFT y cobertura: TBD | Must | UC-06 |
| NF-09 | El producto deberá considerar ESD, transientes, EMI/EMC y aislamiento según entorno e interfaces. | Niveles y criterios: TBD | Must | Restricción del entorno |
| NF-10 | El producto deberá tolerar las condiciones mecánicas y ambientales definidas para demostración o instalación. | Temperatura, humedad y vibración: TBD | Must | Restricción del entorno |

---

## 6. Aplicación de MoSCoW

Las tablas de requisitos son la referencia normativa. El baseline incluye Ethernet principal; dos RS-485, un CAN-FD, cuatro entradas digitales y dos salidas son objetivos preliminares que orientan la arquitectura, pero no sustituyen el cierre de interfaces, cargas, aislamiento y validación. La segunda interfaz Ethernet y las interfaces analógicas permanecen `TBD` o `Could / Future Expansion`. Evaluar aislamiento o recuperación no impone un componente concreto, un procesador auxiliar ni un supervisor independiente.

---

## 7. Requisitos de sistema

### 7.1 Alimentación — SR-PWR

| ID | Requisito | Especificación/valor | MoSCoW | Origen | Verificación |
|---|---|---|---|---|---|
| SR-PWR-01 | El sistema deberá aceptar alimentación industrial nominal de 24 VDC. | TARGET; rango, potencia y conector: TBD | Must | UC-03, D-15 | I, A, T |
| SR-PWR-02 | El sistema deberá impedir daño ante inversión de polaridad dentro del perfil definido. | Perfil y respuesta: TBD | Must | UC-03 | A, T |
| SR-PWR-03 | El sistema deberá limitar efectos de sobrecorriente o cortocircuito interno conforme a estrategia documentada. | Umbrales, energía y recuperación: TBD | Must | Protección | A, T |
| SR-PWR-04 | El sistema deberá limitar sobretensiones y transientes hasta niveles compatibles con circuitos internos. | Formas de onda, niveles y criterios: TBD | Must | NF-09 | A, T |
| SR-PWR-05 | El sistema deberá filtrar perturbaciones conducidas conforme al objetivo EMC definido. | Banda, atenuación y límites: TBD | Must | NF-09 | A, T |
| SR-PWR-06 | El sistema deberá generar los rails requeridos por el STM32H723VET6 y los circuitos de interfaz. | Tensiones, tolerancias, secuencia, rails y cargas: TBD | Must | D-18, arquitectura | A, T |
| SR-PWR-07 | El sistema deberá llevar MCU, firmware e interfaces a estados definidos durante brownout, pérdida y retorno de alimentación. | Umbrales, tiempos y estados: TBD | Must | UC-03, NF-03 | A, T, D |
| SR-PWR-08 | El sistema deberá proporcionar estado de alimentación suficiente para diagnóstico y recuperación. | Power-good, mediciones o eventos: TBD | Should | UC-04 | I, T, D |
| SR-PWR-09 | El presupuesto de potencia deberá incluir carga continua, picos, margen, eficiencia y disipación. | Valores y margen: TBD | Must | D-15 | A |
| SR-PWR-10 | La necesidad de hold-up o apagado controlado deberá resolverse contra el riesgo de corrupción del almacenamiento persistente o de los datos. | Tiempo y estrategia: TBD | Should | UC-03, NF-02 | A, T |

### 7.2 Comunicaciones — SR-COM

| ID | Requisito | Especificación/valor | MoSCoW | Estado | Origen | Verificación |
|---|---|---|---|---|---|---|
| SR-COM-01 | El sistema deberá proporcionar Ethernet cableado como enlace principal con la red superior. | DP83826I 10/100 RMII provisional; conector, cable, clocks, magnetics, protección y alcance TBD | Must | Accepted; not implemented / not validated | D-02, D-18, UC-01 | I, T, D |
| SR-COM-02 | El sistema deberá proporcionar al menos una interfaz de campo compatible con el equipo demostrador. | Selección entre baseline; protocolo, velocidad y topología TBD | Must | Accepted | F-02, UC-01 | I, A, T, D |
| SR-COM-03 | La arquitectura deberá contemplar dos canales RS-485 independientes. | 2 × THVD1420 half-duplex provisionales; terminación, bias, protección, aislamiento y bitrate de operación TBD | Should | Preliminary Accepted | D-12 | I, A, T |
| SR-COM-04 | La arquitectura deberá contemplar un canal CAN-FD en Rev. A. | ATA6561 provisional; bitrate de operación, carga, terminación, protección, aislamiento y protocolo TBD | Should | Preliminary Accepted | D-13 | I, A, T |
| SR-COM-05 | Cada interfaz de campo implementada deberá reportar condiciones de error observables. | Condiciones y contadores: TBD | Must | Accepted | UC-04, F-08 | A, T, D |
| SR-COM-06 | La electrónica de interfaz deberá conectar los puertos de campo a periféricos del STM32H723VET6 mediante límites eléctricos y lógicos documentados. | Suficiencia de pines validada externamente; pin mapping y asignación concreta TBD | Must | Accepted como arquitectura; not implemented | D-18, H-08 | I, A |
| SR-COM-07 | Ethernet deberá recuperar comunicación tras una interrupción temporal sin ciclo manual de potencia. | Tiempo y condiciones: TBD | Must | Accepted | UC-02 | T, D |
| SR-COM-08 | La necesidad de una segunda interfaz Ethernet independiente deberá resolverse antes de congelar la arquitectura de red. | Caso de uso, velocidad, recursos y hardware TBD | Should si se justifica | Reopened / TBD | D-11, C-10 | I, A, T |
| SR-COM-09 | La arquitectura deberá proporcionar un medio de servicio desde PC y evaluar USB cuando sea adecuado. | Medio, cantidad, roles, alimentación y conectores TBD | Should | Target | D-17 | I, A, T |
| SR-COM-10 | La arquitectura deberá contemplar una interfaz de servicio para configuración, logs de arranque, recuperación y debug. | USB, UART, Ethernet u otro medio; nivel, conector, acceso y protección TBD | Should | Target | D-17, UC-04 | I, T, D |

### 7.3 Entradas y salidas industriales — SR-IO

| ID | Requisito | Especificación/valor | MoSCoW | Estado | Origen | Verificación |
|---|---|---|---|---|---|---|
| SR-IO-01 | La arquitectura deberá contemplar cuatro entradas digitales de 24 V sin aplicar niveles industriales directamente al dominio lógico del MCU. | 2 × ISO1212 provisionales, aislamiento integrado; umbrales, corriente, filtro y protección adicional TBD | Should | Preliminary Accepted | D-14 | I, A, T |
| SR-IO-02 | La arquitectura deberá contemplar dos salidas digitales con estado seguro definido durante arranque, apagado, brownout y pérdida de control. | 2 × BSP75N low-side provisionales, 24 V / 500 mA nominales por canal; adaptación de control, cargas concretas, estado seguro y aislamiento TBD | Should; comportamiento seguro Must si se implementan | Preliminary Accepted | D-14, NF-03 | A, T |
| SR-IO-03 | Cada salida implementada deberá limitar efectos de sobrecarga y cargas transientes conforme al perfil definido. | Corriente, energía y recuperación: TBD | Must si hay salidas | Preliminary Accepted | D-14 | A, T |
| SR-IO-04 | Si se incluyen entradas 0–10 V o 4–20 mA, deberán cumplir parámetros metrológicos y de protección definidos. | Rango, exactitud, resolución, impedancia y bandwidth TBD | Could | Future | C-06 | A, T |
| SR-IO-05 | Las I/O implementadas deberán exponer diagnóstico suficiente para distinguir estado de proceso de fallos observables. | Cobertura: TBD | Should | Target | UC-04 | A, T, D |

### 7.4 Plataforma y software embebido — SR-LNX

El prefijo `SR-LNX` se conserva por trazabilidad histórica. Desde Rev. 0.4 no implica Linux. Los IDs se reformulan o retiran explícitamente, sin reutilizarlos silenciosamente.

| ID | Requisito | Especificación/valor | MoSCoW | Origen | Verificación |
|---|---|---|---|---|---|
| SR-LNX-01 | El STM32H723VET6 deberá contar con soporte Zephyr adecuado para las funciones del ciclo de Rev. A. | Versión Zephyr, board support, drivers y periodo de mantenimiento: TBD | Must | D-18, UC-01 | I, D |
| SR-LNX-02 | La plataforma deberá proporcionar procesamiento, memoria e I/O suficientes con margen para las cargas del gateway. | Presupuesto y margen: TBD | Must | UC-01 | A, T |
| SR-LNX-03 | El sistema deberá proporcionar almacenamiento persistente suficiente para firmware cuando corresponda, registros, configuración y datos temporales. | Tecnología, interfaz, capacidad, resistencia e integridad: TBD | Must | H-06, UC-02 | I, A, T |
| SR-LNX-04 | El software deberá mantener cola persistente conforme a políticas documentadas de inserción, confirmación, reintento y descarte. | Capacidad, orden y semántica de entrega: TBD | Must | UC-02, NF-02 | I, T, D |
| SR-LNX-05 | El MCU y su firmware deberán autoarrancar después de restaurar alimentación válida. | Tiempo hasta servicio: TBD | Must | UC-03, D-18 | I, T, D |
| SR-LNX-06 | Zephyr deberá iniciar automáticamente las funciones del gateway y permitir supervisar su estado. | Dependencias, secuencia y recuperación: TBD | Must | UC-03, D-18 | I, T, D |
| SR-LNX-07 | El sistema deberá informar versiones y soportar actualización y recuperación controladas. | Mecanismo, autenticación, firma y rollback: TBD | Should | UC-05 | I, T, D |
| SR-LNX-08 | El STM32H723VET6 deberá asignar recursos suficientes para Ethernet, buses de campo, E/S, desarrollo y mantenimiento del baseline. | Suficiencia de pines validada externamente; asignación, multiplexación, DMA, interrupciones y concurrencia TBD | Must | D-12, D-13, D-14, D-18, H-08 | I, A, D |
| SR-LNX-09 | La plataforma deberá soportar watchdog compatible con la estrategia de recuperación. | Fuente, cobertura, timeout y autoridad: TBD | Should | UC-03, C-09 | I, A, T |
| SR-LNX-10 | Zephyr deberá proporcionar o permitir integrar drivers y servicios para las interfaces efectivamente implementadas. | UART/USART, CAN-FD, Ethernet, USB, GPIO y otros según diseño; disponibilidad y configuración TBD | Must | D-18, UC-01 | I, T, D |
| SR-LNX-11 | El software deberá separar adquisición, manejo de protocolo, normalización, persistencia y servicio de red mediante interfaces documentadas. | Arquitectura de software: TBD | Should | §3.7 | I, A, D |
| SR-LNX-12 | Requisito histórico: ninguna función Must dependería del M4F o PRU del SoM anterior sin validar su integración. | No aplicable a la arquitectura STM32H723VET6 | Retired | D-09, D-10, D-18 | I |

#### 7.4.1 Clasificación de migración de SR-LNX

| Clase | IDs | Tratamiento Rev. 0.4 |
|---|---|---|
| A — Funcional y necesario | SR-LNX-02, 04, 07, 09, 11 | Se conservan con semántica independiente del sistema operativo. |
| B — Implementación Linux anterior | SR-LNX-01, 03, 05, 06, 08, 10 | Se reformulan para STM32H723VET6, Zephyr y almacenamiento genérico, manteniendo los IDs. |
| C — Obsoleto | SR-LNX-12 | Se conserva como `Retired`; no se reutiliza. |
| D — Requiere cierre adicional | SR-LNX-01 a 11 excepto 12 | Versión de Zephyr, drivers, recursos, almacenamiento, actualización, watchdog y presupuestos siguen TBD o pendientes de validación. |

### 7.5 Diagnóstico — SR-DIA

| ID | Requisito | Especificación/valor | MoSCoW | Origen | Verificación |
|---|---|---|---|---|---|
| SR-DIA-01 | El sistema deberá registrar eventos de campo y red suficientes para determinar estado, errores y recuperación. | Eventos, severidad y retención: TBD | Must | UC-01, UC-04 | I, T, D |
| SR-DIA-02 | El sistema deberá registrar inicio, fin y efecto observable de interrupciones de conectividad superior. | Resolución temporal y campos: TBD | Must | UC-02 | T, D |
| SR-DIA-03 | El sistema deberá registrar causa de reinicio cuando sea observable por hardware o software. | Causas distinguibles: TBD | Must | UC-03 | A, T, D |
| SR-DIA-04 | El técnico deberá disponer de un medio documentado para consultar estado, logs, versiones y configuración. | PC externo; medio y permisos TBD | Must | UC-04, D-17 | I, D |
| SR-DIA-05 | El sistema deberá distinguir, donde la arquitectura lo permita, fallos de MCU/firmware, electrónica de interfaces, alimentación, campo y Ethernet. | Cobertura y códigos: TBD | Should | UC-04, NF-06 | A, T, D |
| SR-DIA-06 | El sistema deberá mantener referencia temporal suficiente para ordenar eventos y datos. | Fuente, exactitud y retención: TBD | Must | UC-01, UC-04 | A, T |
| SR-DIA-07 | Los indicadores locales implementados deberán tener estados y significados no ambiguos documentados. | Power, heartbeat, network y fault target; detalles TBD | Should | UC-04 | I, D |
| SR-DIA-08 | El sistema deberá conservar logs de arranque y firmware conforme a una política que limite pérdida y desgaste del almacenamiento seleccionado. | Medio, retención, rotación y persistencia: TBD | Must | UC-03, UC-04 | I, T, D |
| SR-DIA-09 | El sistema debería exponer un endpoint de diagnóstico controlado para estado operativo y contadores seleccionados. | Interfaz, autenticación y datos: TBD | Should | UC-04 | I, T, D |

### 7.6 Protección eléctrica y comportamiento ante fallos — SR-SAF

> Esta sección no afirma certificación de seguridad funcional. Define protección del equipo y comportamiento preliminar ante fallos.

| ID | Requisito | Especificación/valor | MoSCoW | Origen | Verificación |
|---|---|---|---|---|---|
| SR-SAF-01 | El sistema deberá pasar a estados definidos ante alimentación fuera de rango, fallo detectable o pérdida de comunicación relevante. | Estado por modo de fallo: TBD | Must | UC-03 | A, T |
| SR-SAF-02 | Las conexiones externas deberán incorporar estrategia documentada frente a ESD y transientes acorde con el entorno definido. | Puertos, niveles y criterio: TBD | Must | NF-09 | I, A, T |
| SR-SAF-03 | La necesidad de aislamiento galvánico deberá evaluarse por interfaz externa y dominio de alimentación. | Criterios y rating, si aplica: TBD | Must | C-08 | I, A |
| SR-SAF-04 | Cuando se requiera aislamiento, todos los elementos que crucen la barrera deberán mantener la separación definida. | Rating, distancias y excepciones: TBD | Must si aplica | SR-SAF-03 | I, A, T |
| SR-SAF-05 | Comandos, reinicios o actualizaciones no autorizados no deberán habilitarse por defecto en interfaces expuestas. | Modelo de acceso y autenticación: TBD | Must | UC-05 | I, A, T |
| SR-SAF-06 | La recuperación deberá evitar ciclos de reinicio indefinidos sin evidencia diagnóstica persistente cuando sea técnicamente posible. | Límites y política: TBD | Should | UC-03, UC-04 | A, T |
| SR-SAF-07 | El diseño deberá documentar grounding, unión a chasis, retornos y tratamiento de shields antes del layout final. | Estrategia: TBD | Must | NF-09 | I, A |

### 7.7 Ambientales y EMC — SR-ENV

| ID | Requisito | Especificación/valor | MoSCoW | Origen | Verificación |
|---|---|---|---|---|---|
| SR-ENV-01 | El sistema deberá operar dentro del rango de temperatura definido para el escenario objetivo. | Rango y gradientes: TBD | Must | NF-10 | A, T |
| SR-ENV-02 | El sistema deberá operar o almacenarse dentro de límites de humedad y condensación definidos. | Límites: TBD | Must | NF-10 | A, T |
| SR-ENV-03 | La arquitectura deberá considerar ESD, EFT/surge y perturbaciones conducidas/radiadas según entorno documentado. | Fenómenos, niveles y criterios: TBD | Must | NF-09 | A, T |
| SR-ENV-04 | El diseño deberá controlar emisiones conducidas y radiadas contra un objetivo definido antes del layout final. | Límites y configuración: TBD | Must | NF-09 | A, T |
| SR-ENV-05 | El sistema deberá tolerar el perfil de vibración y choque definido para instalación, transporte y demostración. | Perfil y criterio: TBD | Must | NF-10 | I, A, T |
| SR-ENV-06 | El sistema deberá soportar operación continua durante el intervalo de validación definido sin pérdida no recuperable de función. | Duración y carga: TBD | Must | NF-04 | T |

Ningún requisito afirma cumplimiento EMC, certificación o nivel de inmunidad específico.

### 7.8 Mecánicos — SR-MEC

| ID | Requisito | Especificación/valor | MoSCoW | Origen | Verificación |
|---|---|---|---|---|---|
| SR-MEC-01 | El conjunto deberá alojar PCB, conectores, cableado y montaje dentro de envolventes definidas. | Dimensiones y montaje: TBD | Must | H-02 | I, A |
| SR-MEC-02 | Conectores de alimentación, campo, Ethernet y servicio deberán ser accesibles e identificados. | Ubicación y marcado: TBD | Must | UC-04, UC-05 | I, D |
| SR-MEC-03 | El diseño deberá permitir ensamblaje, inspección, prueba y sustitución de módulos mantenibles. | Accesos y herramientas: TBD | Must | UC-06, NF-08 | I, D |
| SR-MEC-04 | El sistema deberá proporcionar retención y alivio de esfuerzos para cables y conectores. | Fuerzas y método: TBD | Should | NF-10 | I, A, T |
| SR-MEC-05 | El grado de protección del envolvente no se fijará hasta definir instalación y exposición. | Grado IP: TBD | Won't definir en esta revisión | Pregunta abierta | I |
| SR-MEC-06 | La integración deberá contemplar disipación del MCU, conversión de potencia y etapas de salida con datos de carga reales. | Modelo térmico y límites: TBD | Must | SR-PWR-09 | A, T |

### 7.9 Mantenibilidad — SR-MNT

| ID | Requisito | Especificación/valor | MoSCoW | Origen | Verificación |
|---|---|---|---|---|---|
| SR-MNT-01 | El sistema deberá exponer identificación única de revisiones de hardware, software y configuración. | Formato y ubicación: TBD | Must | UC-04, UC-05 | I, D |
| SR-MNT-02 | La documentación deberá mantener trazabilidad entre requisitos, decisiones, pruebas y resultados. | Markdown/Git; detalle TBD | Must | Ingeniería de requisitos | I |
| SR-MNT-03 | El sistema deberá contar con procedimiento documentado de instalación, configuración, respaldo y recuperación. | Procedimiento: TBD | Must | UC-05 | I, D |
| SR-MNT-04 | La documentación deberá registrar compatibilidad entre revisiones de PCB, firmware, configuración y subconjuntos reemplazables definidos. | Matriz de compatibilidad: TBD | Should | D-18, UC-05 | I, D |
| SR-MNT-05 | El sistema deberá preservar o restaurar configuración válida después de actualización fallida. | Estrategia y límites: TBD | Should | UC-05, NF-07 | A, T |
| SR-MNT-06 | La configuración y mantenimiento normales deberán poder realizarse desde un PC externo sin pantalla local. | Interfaces, herramientas y permisos: TBD | Should | D-16, D-17 | I, D |

### 7.10 Testabilidad — SR-TST

| ID | Requisito | Especificación/valor | MoSCoW | Origen | Verificación |
|---|---|---|---|---|---|
| SR-TST-01 | La PCB deberá proporcionar acceso de prueba a rails y señales críticas. | Lista, geometría y carga admisible: TBD | Must | UC-06, DFT | I, T |
| SR-TST-02 | Deberá ser posible verificar por separado alimentación, interfaces de campo, MCU/firmware y Ethernet. | Estímulos y criterios: TBD | Must | UC-06 | I, T, D |
| SR-TST-03 | Cada requisito aceptado deberá vincularse con procedimiento o evidencia antes de cerrar diseño. | Matriz de verificación | Must | Ingeniería de requisitos | I |
| SR-TST-04 | Las pruebas deberán registrar versiones, configuración, equipos de medida y resultado. | Plantilla y repositorio: TBD | Must | UC-06 | I |
| SR-TST-05 | La PCB deberá incluir DFT suficiente para detectar fallos de ensamblaje relevantes con recursos disponibles. | Cobertura y recursos: TBD | Must | NF-08 | I, A, T |

### 7.11 Rendimiento y capacidad — SR-PER

No se fijan cifras sin una carga de trabajo y evidencia de medición. Los siguientes parámetros deberán presupuestarse y medirse:

| Métrica | Estado | Método/evidencia pendiente |
|---|---|---|
| CPU utilization | TBD | Perfil por servicio y carga representativa |
| RAM utilization | TBD | Medición en estado estable y transientes |
| Storage throughput | TBD | Escritura/lectura de logs y cola persistente |
| Network throughput | TBD | Tráfico por interfaz y simultaneidad |
| Maximum Modbus nodes | TBD | Caso de uso, polling y tiempos de respuesta |
| CAN utilization | TBD | Bitrate, frame mix y carga de bus |
| Maximum logging rate | TBD | Eventos, tamaño, retención y desgaste |
| Startup time | TBD | Power valid hasta servicio operativo |
| Recovery time | TBD | Fallo definido hasta recuperación |
| Watchdog timeout | TBD | Matriz de fallos y peor caso legítimo |

| ID | Requisito | Especificación/valor | MoSCoW | Origen | Verificación |
|---|---|---|---|---|---|
| SR-PER-01 | El presupuesto de recursos deberá incluir CPU, RAM, almacenamiento, red y buses bajo carga representativa. | Límites y escenarios: TBD | Must | SR-LNX-02 | A, T |
| SR-PER-02 | Como objetivo de diseño, el sistema deberá evitar uso sostenido cercano al 100 % de CPU y conservar margen para carga transitoria. | Margen y umbral de aceptación: TBD | Should | Buen diseño / capacidad | A, T |
| SR-PER-03 | Los tiempos de arranque, recuperación y watchdog deberán derivarse del caso de uso y validarse con medición. | Todos los valores: TBD | Must | UC-03 | A, T |

---

## 8. Trazabilidad preliminar

| Fuente | Necesidad principal | Requisitos de producto | Requisitos de sistema principales |
|---|---|---|---|
| D-18 | Baseline STM32H723VET6 + Zephyr RTOS | F-01 a F-09, F-16 | SR-PWR-06, SR-COM-06, SR-LNX-01 a SR-LNX-11 |
| D-08 | Sin procesador auxiliar en el baseline | F-16 | SR-LNX-09, SR-DIA-03, SR-SAF-01/06 |
| D-11 a D-14 | Interfaces objetivo de Rev. A | F-02, F-10 | SR-COM-01 a SR-COM-10, SR-IO-01 a SR-IO-05 |
| UC-01 | Integrar equipo industrial con red IP | F-01 a F-04, F-08, NF-01 | SR-COM-01 a SR-COM-06, SR-LNX-01/02/08/10/11, SR-DIA-01/06 |
| UC-02 | Conservar y reenviar datos | F-05, F-06, NF-02 | SR-COM-07, SR-LNX-03/04, SR-DIA-02/08 |
| UC-03 | Recuperarse de fallos de alimentación | F-07, NF-03, NF-04 | SR-PWR-01 a SR-PWR-10, SR-LNX-05/06/09, SR-DIA-03, SR-SAF-01/06, SR-PER-03 |
| UC-04 | Diagnosticar fallos | F-08, F-09, NF-05, NF-06 | SR-DIA-01 a SR-DIA-09, SR-MNT-01 a SR-MNT-06 |
| UC-05 | Configurar y mantener | F-09, NF-05, NF-07 | SR-LNX-07, SR-SAF-05, SR-MNT-01 a SR-MNT-06 |
| UC-06 | Verificar fabricación e integración | NF-08 | SR-MEC-03, SR-TST-01 a SR-TST-05 |
| Entorno | Robustez eléctrica, EMC y mecánica | NF-09, NF-10 | SR-SAF-02 a SR-SAF-04/07, SR-ENV-01 a SR-ENV-06, SR-MEC-01 a SR-MEC-06 |

Las decisiones D-07, D-09 y D-10 se conservan como historia de la arquitectura MYC-YM6231/Linux y fueron reemplazadas por D-18. La trazabilidad detallada requisito-prueba se desarrollará cuando los TBD relevantes tengan criterios de aceptación.

### 8.1 Trazabilidad NABC: necesidad, arquitectura, beneficio y estado

| Need respaldado | Requisitos | Bloque de arquitectura | Beneficio esperado | Estado de evidencia |
|---|---|---|---|---|
| Integrar RS-485, CAN-FD y señales digitales con una red IP. | F-01 a F-04; SR-COM-01 a SR-COM-06; SR-IO-01 a SR-IO-05 | Field devices → interfaces protegidas → STM32H723VET6/Zephyr → network | Integración de interfaces heterogéneas y adaptación hacia IP. | Decidido como alcance; no implementado; no validado. |
| Conservar información durante interrupciones de conectividad. | F-05 a F-07; SR-COM-07; SR-LNX-03/04 | Procesamiento → almacenamiento persistente TBD → red | Persistencia y reenvío controlado cuando corresponda. | Objetivo de diseño; medio y política TBD; no validado. |
| Detectar y atender fallos del gateway. | F-08/F-09; SR-DIA-01 a SR-DIA-09; SR-MNT-01 a SR-MNT-06 | Diagnóstico/configuración/mantenimiento asociados a la plataforma principal | Mejor capacidad esperada de diagnóstico y mantenimiento. | Objetivo de diseño; no implementado; no validado. |
| Operar con interfaces de campo en un entorno industrial por definir. | NF-09/NF-10; SR-SAF-02 a SR-SAF-04/07; SR-ENV-01 a SR-ENV-06 | Protección/acondicionamiento y aislamiento donde se justifique | Electrónica de campo diseñada alrededor de los riesgos reales del caso de uso. | Requisitos preliminares; niveles y aislamiento TBD. |
| Preparar una Rev. A verificable y fabricable. | NF-08; SR-MEC-03; SR-TST-01 a SR-TST-05 | PCB propia y puntos/medios de prueba por definir | Testabilidad y fabricación consideradas desde requisitos. | Objetivo de diseño; no existe PCB fabricada. |

---

## 9. Estrategia preliminar de verificación

| Nivel | Objetivo | Evidencia prevista |
|---|---|---|
| Revisión de requisitos | Confirmar necesidad, claridad, trazabilidad y clasificación de TBD. | Revisión aprobada y lista de TBD actualizada. |
| Integración STM32H723VET6 + Zephyr | Congelar asignación de periféricos/pines y verificar soporte, drivers, concurrencia, arranque y recursos. | Matriz de periféricos/pines, compilaciones reproducibles y pruebas de firmware. |
| Análisis de arquitectura | Verificar potencia, recursos, ancho de banda, almacenamiento, aislamiento, térmica y EMC. | Cálculos, simulaciones y decisiones registradas. |
| Prueba de PCB Rev. A | Verificar rails, protecciones, interfaces, I/O, diagnóstico y DFT. | Procedimientos y registros por revisión de hardware. |
| Integración hardware-firmware | Verificar arranque, periféricos, control, diagnóstico y recuperación. | Pruebas reproducibles con versiones identificadas. |
| Prueba de sistema | Ejecutar UC-01 a UC-06 con equipo de campo y servidor/SCADA representativos. | Resultados, logs y matriz requisito-evidencia. |
| Ensayos de robustez | Aplicar perfiles ambientales y eléctricos definidos. | Informes de ensayo; niveles todavía TBD. |

No podrá declararse satisfecho un requisito cuyo criterio de aceptación siga siendo TBD.

---

## 10. Riesgos preliminares

| ID | Riesgo | Consecuencia | Tratamiento inicial | Estado |
|---|---|---|---|---|
| R-01 | La asignación concreta de periféricos, DMA, interrupciones o drivers Zephyr presenta conflictos de concurrencia. | Reducción de alcance o iteración del diseño. | Congelar y revisar el mapa de periféricos/pines antes del esquemático; la suficiencia total de pines ya fue validada externamente. | Abierto |
| R-02 | El caso de uso se define tarde o sin equipo real. | Protocolos sin validación representativa. | Seleccionar equipo, manuales, cableado y ventana de ensayo. | Abierto |
| R-03 | El perfil de 24 VDC y sus transientes no se conoce. | Protección insuficiente o sobredimensionada. | Caracterizar fuente y entorno antes de seleccionar componentes. | Abierto |
| R-04 | La pérdida de energía corrompe el almacenamiento persistente o los datos pendientes. | Pérdida de servicio o información. | Definir medio, organización de datos, escrituras, brownout, hold-up y power cycling. | Abierto |
| R-05 | Diferencias de tierra o ruido degradan interfaces de campo. | Errores intermitentes o daño. | Analizar grounding, cableado, aislamiento y protección por puerto. | Abierto |
| R-06 | EMC se considera después del layout. | Iteraciones costosas y fallos de ensayo. | Definir retornos, filtrado, partición y plan de evaluación antes del PCB. | Abierto |
| R-07 | La arquitectura anterior dependía de M4F/PRU sin validación de integración. | Fallos de integración y cronograma en el baseline anterior. | Riesgo histórico eliminado del baseline por D-18; conservar la evidencia de la decisión. | Cerrado por D-18 |
| R-08 | El almacenamiento temporal no tiene capacidad o resistencia suficiente. | Pérdida de datos o desgaste prematuro. | Definir tasa, retención, reintento y presupuesto de escrituras. | Abierto |
| R-09 | Watchdog con cobertura o autoridad insuficiente. | El sistema no se recupera de bloqueos relevantes. | Construir matriz fallo-detector-acción y probar cada ruta. | Abierto |
| R-10 | Alcance excesivo por interfaces simultáneas. | Implementación incompleta o validación superficial. | Congelar demostrador mínimo y usar el baseline como target, no obligación ciega. | Abierto |
| R-11 | Servicios de red se habilitan sin modelo de acceso cerrado. | Superficie expuesta o mantenimiento inseguro. | Definir activos, actores, protocolos y política de actualización. | Abierto |
| R-12 | Restricciones mecánicas o térmicas aparecen tarde. | PCB o envolvente incompatibles. | Obtener modelos, montaje, conectores y datos térmicos antes del diseño físico. | Abierto |
| R-13 | Los recursos de memoria, almacenamiento, alimentación o térmica no cubren la carga real. | Revisión del alcance o del diseño de Rev. A. | Elaborar presupuestos y medir una carga representativa antes de congelar producción. | Abierto |
| R-14 | Añadir un MCU externo sin reabrir formalmente D-08. | Complejidad y modos de fallo no justificados. | Aplicar criterios de §3.3 y control de cambios. | Abierto |

---

## 11. Limitaciones y exclusiones

Los parámetros sin evidencia se concentran en §12. Aunque la plataforma de Rev. A está seleccionada, no hay asignación concreta de periféricos/pines congelada, equipo demostrador final, esquemático, PCB, firmware validado ni ensayos del gateway completo.

| Alcance excluido | Referencia o condición |
|---|---|
| Wi-Fi, antena y front-end RF propios | D-03 a D-05; F-12/F-13 |
| LTE como función base | F-15; solo expansión externa/futura |
| MCU externo adicional | D-08; F-16 |
| Pantalla local | D-16; F-17 |
| Memoria DDR externa | No requerida por el baseline actual; cualquier necesidad futura exige control de cambios. |
| Interfaces analógicas industriales | Could / Future Expansion hasta justificar caso de uso |
| Desarrollo completo de todos los protocolos listados | Se implementarán según MoSCoW y caso de uso |
| Certificación, declaración de cumplimiento EMC, producción en serie y homologación formal | Sin alcance aprobado ni evidencia de conformidad |

---

## 12. Lista consolidada de TBD y cierres históricos

| ID | TBD por cerrar | Impacto principal | Evidencia necesaria |
|---|---|---|---|
| TBD-01 | Versión de Zephyr, soporte de placa, toolchain, drivers, uso de memoria, alimentación y comportamiento térmico. | Integración de plataforma | Documentación oficial, compilación y pruebas de plataforma. |
| TBD-02 | Equipo industrial y escenario demostrador. | Alcance y validación | Acceso a equipo, manual y necesidad del usuario. |
| TBD-03 | Interfaz y protocolo que se demostrarán primero. | Carrier y software | Derivación desde TBD-02. |
| TBD-04 | Velocidad, topología, cableado, terminación, bias y aislamiento de RS-485/CAN-FD. | Integridad y protección | Manuales, entorno y análisis de bus. |
| TBD-05 | Perfil de entrada: rango, corriente, potencia, conector, transientes y comportamiento de fuente. | Protección y conversión | Medición o especificación de instalación. |
| TBD-06 | Rails auxiliares, secuencias, tolerancias, cargas pico, eficiencia y margen. | Arquitectura eléctrica | Presupuesto de potencia y selección de interfaces. |
| TBD-07 | Brownout, hold-up, apagado y recuperación. | Integridad de datos | Capacidades del MCU, arquitectura de alimentación y análisis de almacenamiento. |
| TBD-08 | Datos, tasa, latencia y procesamiento local. | Recursos y pruebas | Caso de uso y protocolo. |
| TBD-09 | Protocolo de red, formato, direccionamiento y seguridad. | Software e interoperabilidad | Requisitos del servidor/SCADA. |
| TBD-10 | Capacidad, retención y descarte de datos pendientes. | Almacenamiento | Modelo de tráfico y necesidad del usuario. |
| TBD-11 | Semántica de entrega: confirmación, duplicados, orden y reintentos. | Integridad de datos | Necesidad del servidor y análisis de fallos. |
| TBD-12 | Tiempo de arranque y recuperación. | Disponibilidad | Caso de uso y medición del firmware. |
| TBD-13 | Variables, granularidad, acceso y retención de diagnóstico. | Mantenimiento | Escenarios de fallo y actores. |
| TBD-14 | Fuente, exactitud y retención de tiempo. | Orden de eventos | Caso de uso y conectividad. |
| TBD-15 | Cobertura, timeout y autoridad del watchdog/supervisor. | Recuperación | Matriz fallo-detector-acción. |
| TBD-16 | Criterios que reabrirían la decisión de MCU externo. | Control de alcance | Nueva necesidad conforme a §3.3; Won't en Rev. A. |
| TBD-17 | I/O digital: niveles, umbrales, cargas, diagnóstico y estados seguros. | Electrónica de campo | Casos de uso y cargas reales. |
| TBD-18 | Aislamiento por puerto o dominio. | Protección, EMC y costo | Análisis de tierras, cableado y fallos. |
| TBD-19 | Temperatura, humedad, condensación, vibración y choque. | Mecánica y selección | Escenario de instalación. |
| TBD-20 | Objetivos de ESD, EFT/surge, emisiones e inmunidad. | Protección y layout | Entorno y objetivos de ensayo. |
| TBD-21 | Envolvente, montaje, dimensiones, conectores y grado IP. | Diseño mecánico | Lugar de instalación y selección de componentes. |
| TBD-22 | Duración de operación continua y disponibilidad objetivo. | Validación | Necesidad académica y operativa. |
| TBD-23 | Actualización, autenticación, firma y recuperación. | Mantenimiento y seguridad | Arquitectura de software y modelo de acceso. |
| TBD-24 | DFM/DFT, puntos de prueba, fixtures y cobertura. | Fabricación y prueba | Tecnología PCB y recursos de laboratorio. |
| TBD-25 | Procedimientos y criterios de aceptación por requisito. | Cierre de verificación | Cierre de TBD anteriores. |
| TBD-26 | Asignación concreta de pines/periféricos y conflictos de DMA, interrupciones o concurrencia. La suficiencia total de pines ya fue validada externamente. | Congelación del baseline | Datasheet, referencia del MCU, configuración Zephyr y revisión del mapa de recursos. |
| TBD-27 | Implementación Ethernet con DP83826I provisional y decisión sobre segundo enlace. | PCB y red | Magnetics, clocks, conector, protección y caso de uso. |
| TBD-28 | THVD1420 y ATA6561 seleccionados provisionalmente; implementación y validación pendientes. | BOM e interfaces | Parámetros de bus, terminación, protección y aislamiento. |
| TBD-29 | ISO1212 y BSP75N seleccionados provisionalmente; adaptación STM32 3.3 V → control BSP75N ≈5 V sin seleccionar. | BOM y estado seguro | Pasivos DI, protecciones específicas, cargas y diagnóstico. |
| TBD-30 | Componentes de protección, filtro y DC/DC principal. | Alimentación y EMC | Cierre de TBD-05/06/20. |
| TBD-31 | Medio físico, roles, alimentación y protección de la interfaz de servicio desde PC. | Servicio/expansión | Casos de mantenimiento y arquitectura de acceso. |
| TBD-32 | Implementación de la consola o interfaz de servicio. | Bring-up y recuperación | Medio, niveles, conector y política de acceso. |
| TBD-33 | Semántica y ubicación de indicadores. | Diagnóstico/mecánica | Casos de fallo y panel. |
| TBD-34 | Uso de M4F/PRU de la arquitectura MYC-YM6231 anterior. | Historia de arquitectura | Cerrado/no aplicable al baseline actual por D-18. |
| TBD-35 | Presupuestos de CPU, RAM, storage, network, Modbus, CAN y logging. | Capacidad | Carga representativa y mediciones. |
| TBD-36 | Grounding, chasis, shields y retornos. | EMC e integridad | Mecánica, aislamiento y revisión de layout. |
| TBD-37 | Presupuesto térmico de MCU, conversión de potencia, interfaces y salidas. | Fiabilidad del diseño | Potencia medida, modelos y prueba térmica. |
| TBD-38 | Referencia durable de la revisión externa que validó la suficiencia global de pines. | Trazabilidad de D-18, H-08 y S-04 | Autor o entidad, fecha, alcance y artefacto revisado; sin inventar asignaciones individuales. |

---

## 13. Preguntas de alcance pendientes

- ¿Qué equipo y protocolo conforman el demostrador mínimo de Rev. A? (TBD-02/03).
- ¿El demostrador solo adquiere datos o también emite comandos y acciona salidas? (TBD-02/17).
- ¿Se requieren simultáneamente todas las interfaces objetivo o se poblarán/probarán por etapas? (TBD-26/27/28/29).
- ¿Qué fallos requieren recuperación automática y qué autoridad necesita el watchdog? (TBD-07/15).
- ¿Qué entorno eléctrico y mecánico limita protección, aislamiento y validación? (TBD-05/18/19/20/21).
- ¿Se reservará físicamente expansión para LTE comercial sin implementarla como función base? (F-14/F-15, TBD-31).
- ¿Existe una necesidad verificable para un segundo Ethernet o debe quedar fuera de Rev. A? (D-11, TBD-27).
- ¿Qué medio de almacenamiento persistente y qué política de retención se usarán? (TBD-07/10/11).
- ¿Qué versión y configuración de Zephyr soportarán las funciones del baseline? (TBD-01).

---

## 14. Próximos pasos de Rev. A

| Prioridad | Decisión | Resultado esperado |
|---:|---|---|
| 1 | Cerrar el caso demostrador. | Equipo, flujo, datos y criterios de éxito definidos. |
| 2 | Cerrar requisitos todavía TBD que condicionan la arquitectura. | Baseline verificable y controlado. |
| 3 | Congelar asignación de periféricos y pinout. | Mapa revisado sin afirmar asignaciones antes de validarlas. |
| 4 | Extraer consumos y construir el power budget. | Datos por componente y rail, cargas, picos y disipación; después definir conversión y reguladores. |
| 5 | Desarrollar interfaces desde la baseline provisional. | Adaptación STM32 → BSP75N, pasivos y protecciones específicos definidos y revisados. |
| 6 | Definir almacenamiento persistente. | Medio, capacidad, retención y recuperación definidos. |
| 7 | Desarrollar el esquemático. | Diseño revisable de Rev. A. |
| 8 | Validar interfaces y presupuestos antes del layout. | Evidencia de viabilidad eléctrica y de recursos. |
| 9 | Desarrollar firmware mínimo en Zephyr. | Bring-up y funciones mínimas reproducibles. |
| 10 | Diseñar PCB Rev. A. | Layout revisado contra requisitos eléctricos, EMC y DFT. |
| 11 | Fabricar Rev. A. | Unidades identificadas para evaluación. |
| 12 | Probar el sistema. | Matriz requisito-evidencia y resultados del demostrador. |

---

## 15. Control de revisión

### 15.1 Reglas de edición

- Modificar este archivo mediante cambios descriptivos y revisables.
- No reutilizar IDs eliminados; conservarlos como retirados o reemplazados.
- Registrar cambios de requisito en historial y actualizar trazabilidad, TBD y preguntas abiertas.
- No reemplazar TBD por estimaciones sin evidencia o decisión registrada.
- Identificar toda decisión que cambie alcance o arquitectura.
- Las revisiones liberadas deberán recibir el mecanismo de control definido por el equipo.

### 15.2 Historial de revisiones

| Revisión | Fecha | Autor | Estado | Descripción |
|---|---|---|---|---|
| 0.1 | 2026-09-07 | Equipo del proyecto / Codex | Preliminary Product and System Requirements | Primera versión: problema, contexto, casos de uso, requisitos de producto y sistema, MoSCoW, diagramas, arquitectura, riesgos, TBD y decisiones siguientes. |
| 0.2 | 2026-09-08 | Equipo del proyecto / Codex | Preliminar | Revisión editorial: compactación de narrativa y duplicados, diagrama funcional consolidado, plataforma Linux pendiente y aclaración de candidatos. Se conservaron IDs y prioridades. |
| 0.3 | 2026-09-13 | Equipo del proyecto / Codex | Preliminar; baseline Rev. A | Selección MYC-YM6231; decisión de no usar MCU externo; responsabilidades A53/Linux, M4F y PRU; alcance, bloques, potencia, interfaces, componentes pendientes, rendimiento, trazabilidad y TBD ampliados. |
| 0.4 | 2026-09-15 | Equipo del proyecto / Codex | Preliminar; baseline Rev. A actualizado | D-18 selecciona STM32H723VET6 + Zephyr RTOS. D-07, D-09 y D-10 quedan `SUPERSEDED`; se neutralizan dependencias Linux/SoM, se conserva trazabilidad de SR-LNX y se actualizan arquitectura, riesgos, TBD y pasos siguientes. |
| 0.5 | 2026-10-04 | Equipo del proyecto / Codex | Selección provisional de componentes | STM32H723VET6, DP83826I, THVD1420, ATA6561, ISO1212 y BSP75N como SELECTED / PROVISIONAL DESIGN BASELINE; rails mínimos, adaptación DO pendiente y tabla inicial de power budget sin consumos extraídos. |
