anhenaobe/industrial-comunication-gateway/docs/hardware/evidence/autonomous_closure/WORKING_PLAN.md

# Autonomous closure working record — 2026-11-08

User authorizes engineering changes, local symbols/footprints/BOM/docs/native reversible corrections, coherent commit on main, no push. No PCB/firmware/professor edits. Preserve manually drawn sheets; no whole-sheet regeneration. Current baseline backups and native reads are adjacent JSONs. No goal tool requested; no subagents authorized.

Phase1 complete: nativeAltium accessible;5sheets,108components,453pins;67source symbols/38footprints. Manual changes since previous audit must be preserved (new J3 SWD,D?PHYESD,updatedD2TDS3311,C7TORCH15u100V,R5/R8=100k,U10/U11BSPfootprint links). New criticalfault: U1UVLO2 andOVP3 physically shorted via wirePZUXORAP. R3=33.2k has both endsOVP. Currentrecords in disk_before.json/metadata_before.json. Mainproject main/no committedhardware/docs baseline; pre-existing firmware mods untouched.

Priority native fixes: Power remove wirePZUXORAP (10100,7500→10000,7500→9700,7500),replace only (10000,7500→9800,7500),keepingOVPlabel9800,7500. This disconnects U1OVP3 from UVLO2 verticalwire9700,7300..7700; optionalUVLOlabel10000,7700. C16 still16V on24V;C7nowTORCH15u100Vsymbolonly exactX7S not coveredfamily no verifiedlandpattern/effectiveC; retain only afterqualifiedalternative or replace with acceptedTDK4.7u100V bank. U2/U3NC3stillopen,CVCC1uFstale;PGpullupsR6/R9present;sourceguideCFFconditionalDNP. Ethernet C46/C52returnlogicGND insteadCHASSIS;J2shieldfloating;newD?ESDprotectedpins1/2/4/5attachedMDIbutNC6/7/9/10notpass-throughneedexternalcontinuity pairs1-10,2-9,4-7,5-6. FieldDI R21/R22 1k incorrectly onlogicOUT1/2;move only theseR tofieldside,retainOUTMCUports,attachfreeendsFIELD_DI1+/2+ andsense toSENSE1/2. U10/U11all8pinsunconnected. Usernowpermits necessaryarchitectureupdates.

DO investigated SN74LVC2T45 cannot guarantee4.5V loaded. TLV9032 minrelativeVOHgood butRevH explicitlydeletesPOR;TLV7012POR/failsafe good butVOH4.65specified5Vonly givesalmostzero marginat4.86railifdrop. BTF3050TE3.3Vprotected alternativeclamps40Vandcurrentlimit8A excessivefor500mA;BSPkept. Proposedbest: perchannel BC847B,215 NPN + Nexperia PMV65XP,215 PMOS usedonlyon5Vlogicdriver,not24Vload. GPIO existing10kdown→4.7k→NPNbase1,emitter2GND,collector3→100ohm→PMOSgate1;10kG-S tosource2=5V;drain3→BSP IN;2.49k IN-toSource/GND outputdown. Conservative VGSmin=(4.86249-.2)*9900/(9900+101)=4.615V (≥4.5);RDSmax.074ohm25C/.105ohm150C at-4.5V;loadscreenBSP2.7mA@7V plus5.17/2.465k≈4.8mA givesnegligibleVOHdrop;explicitmonotoniccurrentboundinference,notmanufacturerall-conditionguarantee. GPIOHiZdown→NPNoff→PMOSG=S→BSPoff;3.3Vonly/5VonlyOFF;MCUactivelyHIGHwhile5VriseswillturnON sofirmwareinitializeLOWandexternalDOsupplyoffbringup. Source specs PDF needdownload/readnotyet. BC847 maxVCEsat.2V at10mAIb.5mA;loadedcollector~.5mA withGPIObase~.3mAstrongsaturationengineeringderating. NPNleak5uA150C×gatepull10k=.05VwellbelowPMOSVthmin.47;PmosIDSS100uA150C×outputpull2.49k=.249VbelowBSPthresholdmin1V. PMOScurrentproduction verifiedNexperia producttable;stockunknown. Official PDFs: assets.nexperia.com/documents/data-sheet/BC847X_SER.pdf (Rev13July2022),PMV65XP.pdf(12Feb2013,2017branding);pin1B/G,2E/S,3C/D. PMV65XP datasheetp10 has manufacturerreflowSOT23lands;BC847SOT23 canuseNexperia/NXPSOT23samepackage drawinghttps://www.nxp.com/docs/en/package-information/SOT23.pdf. Needview exactpad dimensionsbeforeauthoring. SN74libraryhistoricalnotdelete;BOMqty0superseded,add4transistors/6newres+2outputdowns asappropriate.

Known tools schema stored functions stores mission_...; invoke suite exactnames afterschema. app_set_active_document(file_path) worksnativefocus. sch_place_components(placements,document_path) canfocusandbatchplace. sch_place_wires(wires{x1,y1,x2,y2} inmils) activeonly; sch_place_net_label(text,x,y) singular exists; obj_batch_modify scopes doc:absolute and exactfilters. proj_replace_component(designator,new_lib_ref,new_library) activeonly. No native edits performed in this mission yet. Prior save remintsallpinUniqueIds437;componentUID/model/electricalpreserved. Now userauthorityallowsreversibleedits;fullreadbacknotblindstopunlessotherbadmutation. Needdedicatedsave/check compareonlycorrectedproperties,fullnativegetnets/ERC. NativecompileLibPkgpossible notyetexplored. Officialfilebackend read/write librariespreferred no speculative scriptCurrentPartID.

Generator integration: docs/hardware/evidence/build_passive_deliverables.py uses layers freeze/tps/eth/cap/do overlay; add autonomous overlay LAST to patch currentselections/newrows/assets replacements withoutduplicates. sync_guide.py buildsfromolderbeforeguide snapshot;add missionoverridebeforefinalwrites orusecurrentguide asbaselineandstructuredpatchessaved forregen. NeverallowregenrestoreoldDO/MCUheader/TPSwiring. Docs currentcounts66/38 outdated67/38;guideJ3expected1Vref,2SWDIO... actualuserJ3=1SWDIO,2GND,3SWCLK,4NRST,5GND,6Vref. Adopt actual unkeyedproject-specificpinoutaftermechanicaldrawing;do not rewire validuserchoice. J3headerexistinggeneric noexactMPN;needsselectedverifieddrawing. J1actualCUI TB002-500-02BE validconnectorsourceoutsideproject;BOMoldJL126 needsreconcileexisting. NeedresetbuttonexactMPN,3polebus/DIand2poleDOterminals,terminationjumpersverifiedphysicaldrawings. Sourcepassivefootprintscandidatesmanyrequireauthoritativefamilylandpattern;donotclaimverifiedfrombodydimensions.

Next: obtain small official PDFs to libraries/sources/autonomous_closure (userauthorized),inspect neededpin/landpages,authornewDOsymbols/footprintsandresistors,repairTPS pad11 composite regionsviafilebackend ifsupportsPadCustomprimitive/netinheritance elsevalidatedconservativecentralpadwithmanufacturerrecommendedgeometry preservingcopper. RNX0012A/Binspectexisting vsdatasheets. Then nativecriticalfixes/newDOcompleteconnections with localplacementonly;restpassives/connectorswhereevidence. Updateguide/BOM/maps/report per-subsystemstates;reproduciblefullpin/net/component/coppervalidation+idempotentgenerators;nativeERC(actualstillerrorsnothide),compileonlygenuinelysupported;gitdiffcheck/status;commitonlycoherenttaskfilesneverfirmware,pushnone. Keepcommentary≤60sec.

Native execution change: deleted wirePZUXORAP,placed replacement10000,7500?9800,7500,andUVLOlabel10000,7700. proj_save verified. Savedrecords confirmexactoldwiregone/newwirepresent. SubsequentcompiledgetnetsstilloldOVP couldbestale;force_recompileblocked Pre-editcheckpointcannotverifycontext;proj_compilesameblocked;getnetsnow ExpectedoneAltiumeditorfound0. Noapplicationrestartattempted. TreatUVfixSAVED_GEOMETRY_ONLY_PENDING_NATIVE_RECOMPILE;stopnativeeditinguntilavailable. Continuelibraries/docs/research. Noothernativeeditsinmissionyet.

<!-- FINAL_STATE -->
Final decisions supersede the early research alternatives above. SelectedDOdriver:DiodesMMBT3904-7-F+DMP2035U-7,2each;4.7kbase/4.7kG-S/100ohmgate/2.49kBSPdown,existing10kGPIOdown. NoNexperiaalternativewasadopted. Sourceinventory76/48.20legacy passive/model links and13other existing verification-metadata updates;all67originalpinarrayspreserved. New9symbols/10feet. DQA/TPSradii corrected toAltiumhalf-side convention. AllmandatorysourcegeometryexceptTPSnetmapping closed;Samsungcatalogp159closesbothremainingMLCCfoottypes. NativePowergeometryrepairpendingfreshcompile;othernativefunctionalrecordsintact;projectsave regeneratedIDs/referencecache. NoPCB/professor/firmwarewrites. See finalreport/verification artifacts. No more CADwrites should occur withoutnewreadback.
