anhenaobe/industrial-comunication-gateway/docs/hardware/evidence/tps26620/resistor_specs.txt

RC0603FR-0713K3L.pdf
RC0603FR-0713K3L
Aliases (RC0603FR0713K3L)
YAGEO, RC, Thick Film, SMD Chip, 13.3 kOhms, 1%, 0603 / 1608
B1
L
W
B2
T
Click here for the 3D model.
General Information
Supplier
YAGEO
Series
RC
Style
SMD Chip
Description
Standard Thick Film Chip 
Resistors
RoHS
Yes
Termination
Tin
Shelf Life
104  Weeks
Case Code  (EIA / mm)
0603 / 1608
Dimensions
L
1.6mm +/-0.1mm
W
0.8mm +/-0.1mm
T
0.45mm +/-0.1mm
B1
0.25mm +/-0.15mm
B2
0.25mm +/-0.15mm
Specifications
Resistance
13.3 kOhms
Resistance Tolerance
1%
Power
0.1 W (70C)
Temp. Coefficient
-/+100 ppm/C
Temperature Range
-55/+155°C
Voltage DC
75 V (Max Continuous Voltage at 
Full Rated Power), 150 Max Over 
Voltage, 150 Dielectric 
Withstanding Voltage
Packaging Specifications
Packaging
T&R, 178mm
Statements of suitability for certain applications are based on our knowledge of typical operating conditions for such applications, but are not intended to constitute - and 
we specifically disclaim - any warranty concerning suitability for a specific customer application or use. This Information is intended for use only by customers who have the 
requisite experience and capability to determine the correct products for their application. Any technical advice inferred from this Information or otherwise provided by us 
with reference to the use of our products is given gratis, and we assume no obligation or liability for the advice given or results obtained.
Generated 11/07/2026
©︎ 2006 - 2026 YAGEO

RC0603FR-0730K1L.pdf
RC0603FR-0730K1L
Aliases (RC0603FR0730K1L)
YAGEO, RC, Thick Film, SMD Chip, 30.1 kOhms, 1%, 0603 / 1608
B1
L
W
B2
T
Click here for the 3D model.
General Information
Supplier
YAGEO
Series
RC
Style
SMD Chip
Description
Standard Thick Film Chip 
Resistors
RoHS
Yes
Termination
Tin
Shelf Life
104  Weeks
Case Code  (EIA / mm)
0603 / 1608
Dimensions
L
1.6mm +/-0.1mm
W
0.8mm +/-0.1mm
T
0.45mm +/-0.1mm
B1
0.25mm +/-0.15mm
B2
0.25mm +/-0.15mm
Specifications
Resistance
30.1 kOhms
Resistance Tolerance
1%
Power
0.1 W (70C)
Temp. Coefficient
-/+100 ppm/C
Temperature Range
-55/+155°C
Voltage DC
75 V (Max Continuous Voltage at 
Full Rated Power), 150 Max Over 
Voltage, 150 Dielectric 
Withstanding Voltage
Packaging Specifications
Packaging
T&R, 178mm
Statements of suitability for certain applications are based on our knowledge of typical operating conditions for such applications, but are not intended to constitute - and 
we specifically disclaim - any warranty concerning suitability for a specific customer application or use. This Information is intended for use only by customers who have the 
requisite experience and capability to determine the correct products for their application. Any technical advice inferred from this Information or otherwise provided by us 
with reference to the use of our products is given gratis, and we assume no obligation or liability for the advice given or results obtained.
Generated 11/07/2026
©︎ 2006 - 2026 YAGEO

RC0603FR-0733K2L.pdf
RC0603FR-0733K2L
Aliases (RC0603FR0733K2L)
YAGEO, RC, Thick Film, SMD Chip, 33.2 kOhms, 1%, 0603 / 1608
B1
L
W
B2
T
Click here for the 3D model.
General Information
Supplier
YAGEO
Series
RC
Style
SMD Chip
Description
Standard Thick Film Chip 
Resistors
RoHS
Yes
Termination
Tin
Shelf Life
104  Weeks
Case Code  (EIA / mm)
0603 / 1608
Dimensions
L
1.6mm +/-0.1mm
W
0.8mm +/-0.1mm
T
0.45mm +/-0.1mm
B1
0.25mm +/-0.15mm
B2
0.25mm +/-0.15mm
Specifications
Resistance
33.2 kOhms
Resistance Tolerance
1%
Power
0.1 W (70C)
Temp. Coefficient
-/+100 ppm/C
Temperature Range
-55/+155°C
Voltage DC
75 V (Max Continuous Voltage at 
Full Rated Power), 150 Max Over 
Voltage, 150 Dielectric 
Withstanding Voltage
Packaging Specifications
Packaging
T&R, 178mm
Statements of suitability for certain applications are based on our knowledge of typical operating conditions for such applications, but are not intended to constitute - and 
we specifically disclaim - any warranty concerning suitability for a specific customer application or use. This Information is intended for use only by customers who have the 
requisite experience and capability to determine the correct products for their application. Any technical advice inferred from this Information or otherwise provided by us 
with reference to the use of our products is given gratis, and we assume no obligation or liability for the advice given or results obtained.
Generated 11/07/2026
©︎ 2006 - 2026 YAGEO

RC0603FR-07768KL.pdf
RC0603FR-07768KL
Aliases (RC0603FR07768KL)
YAGEO, RC, Thick Film, SMD Chip, 768 kOhms, 1%, 0603 / 1608
B1
L
W
B2
T
Click here for the 3D model.
General Information
Supplier
YAGEO
Series
RC
Style
SMD Chip
Description
Standard Thick Film Chip 
Resistors
RoHS
Yes
Termination
Tin
Shelf Life
104  Weeks
Case Code  (EIA / mm)
0603 / 1608
Dimensions
L
1.6mm +/-0.1mm
W
0.8mm +/-0.1mm
T
0.45mm +/-0.1mm
B1
0.25mm +/-0.15mm
B2
0.25mm +/-0.15mm
Specifications
Resistance
768 kOhms
Resistance Tolerance
1%
Power
0.1 W (70C)
Temp. Coefficient
-/+100 ppm/C
Temperature Range
-55/+155°C
Voltage DC
75 V (Max Continuous Voltage at 
Full Rated Power), 150 Max Over 
Voltage, 150 Dielectric 
Withstanding Voltage
Packaging Specifications
Packaging
T&R, 178mm
Statements of suitability for certain applications are based on our knowledge of typical operating conditions for such applications, but are not intended to constitute - and 
we specifically disclaim - any warranty concerning suitability for a specific customer application or use. This Information is intended for use only by customers who have the 
requisite experience and capability to determine the correct products for their application. Any technical advice inferred from this Information or otherwise provided by us 
with reference to the use of our products is given gratis, and we assume no obligation or liability for the advice given or results obtained.
Generated 11/07/2026
©︎ 2006 - 2026 YAGEO
