anhenaobe/industrial-comunication-gateway/docs/hardware/evidence/native_schematic_audit/findings_initial.csv

id | severity | sheet | parts_pins | actual | expected | evidence | correction
A01 | CRITICAL | Power | U2.12,U3.12,L1.1,L2.1,C10.1,C19.1 | All on SW | Independent B3_SW and B5_SW | Native437-pin table; guide2/3; TI SNVSB49D p4/Fig10-1 | Rename the two SW power ports in each converter; no shared switch node
A02 | CRITICAL | Power | C7,C16 | C0805C475K4RACTU,16V on 24V | C5750X7R2A475K230KA,100V | Placed MPN/rating; guide2/3 exact capacitor selection | Replace these with selected100V parts; add one extra4.7uF per buck per selected bank
A03 | MAJOR | Power | U2.9/10,U3.9/10 | Vin only connected to both regulators/PG pullups; distinct from24V | Both VIN pins and EN to TPS OUT/24V | Native pins; TI SNVSB49D p4 pins2/10/9 | Rename Vin power ports to24V; retain existing protected rail alias
A04 | MAJOR | Power | R5,R7,R6 | R5=43.2k upper;R7=43.2k lower;R6=100k on PG | Upper100k/lower43.2k; PG open | TI SNVSB49D Table10-1/1V VFB; guide2 | R5 exact100k; remove/DNP PG pullupR6 separately; result currently nominal2V
A05 | MAJOR | Power | R8,R10,R9 | R8=43.2k upper;R10=24.9k lower;R9=100k on PG | Upper100k/lower24.9k;PG open | TI SNVSB49D Table10-1; guide3 | R8 exact100k; remove/DNP PG pullupR9 separately; result currently nominal2.735V
A06 | MAJOR | Power | U2.3,U3.3 | Individually single-pin nets | Each to its own SW12 | TI SNVSB49D p4 Pin Functions | Connect U2.3 to B3_SW and U3.3 to B5_SW; never join switch nodes
A07 | MAJOR | Power | C12,C21 | CL10A105KB8NNNC1uF | Selected C0805C225K5RACTU2.2uF50V | Guide2/3 current capacitor closure; TI p4 requires quality1uF | Replace exact selected CVCC parts; source1uF alone is not intrinsically wrong but superseded application selection
A08 | MAJOR | Power | D2.1–6 | TDS3011P.C | TDS3311P.C same functional6-pin shunt | Approved freeze; guide1 | Replace exact approved source model preserving1/2/3GND,4/5/6VIN_CLAMP; do not merely rename comment
A09 | MAJOR | Ethernet | J2.2,T1.14 | J2.1/2 bothTX+;T1.14TX- single-pin | J2.2 to T1.14TX- | Native nets; Pulse HX1188FNL sheet2/StewartCT710001;guide6 | Change only TX+ label at9600,5000 toTX-
A10 | MAJOR | Ethernet | C46.1,C52.1 | Both on logicGND | Both on CHASSIS; independent A/B capacitor branches | Guide6 accepted topology; native nets | Reassign both capacitor returns to defined CHASSIS after chassis policy confirmed; ground-boundary edits require separate approval
A11 | MAJOR | Ethernet | J2.S1/S2 | Separate single-pin floating nets | Defined CHASSIS shield return | Guide6; CT710001 shell drawing | Finish shield/chassis implementation; do not bond logicGND automatically
A12 | MAJOR | MCU | U4.71/76 | SWCLK onPA12/71;PA14/76 single-pin | SWCLK onPA14/76 | ST DS13313 LQFP100/Table7/8;guide4 | Move SWCLK label to actual PA14 connection6400,4000; no peripheral reassignment
A13 | MAJOR | MCU | Debug/reset access | No SWD header,NRST14 only capacitorC28;SW1 is BOOT recovery | Six-pin SWD/header + reset access perguide4 | Actual106-component inventory; guide4 | Add selected header/reset contacts after exact MPN/contact drawing closure; do not mistake SW1 for reset
A14 | MAJOR | Ethernet | PHY-side ESD | No TPD4E05U06DQAR placed | Selected PHY-side ESD array and explicit pass-through connections | Guide6 accepted circuit | Place selected model and four signal paths; avoid mass reroute
A15 | MAJOR | Ethernet | U6.6/7 and U7.6/7 | Single-pin bus nets; no RS485/CAN connector/termination jumper | A/B and CANH/L to approved external connectors; optional termination | Native nets/inventory; guide7/8 | Complete external interfaces after connector pin drawings; no extra bias/TVS selection
A16 | CRITICAL | Field_IO | R21.2/U8.4/U4.3 and R22.2/U8.5/U4.4 | 1k field threshold resistor tied to logic OUT/MCU net | 1k high side to external field input; low side to SENSE; never OUT | TI ISO1212 SLLSEY7G p4 Pin Functions/Fig8-2;guide9 | Remove RTHR free ends from OUT1/OUT2 and terminate on separate fieldDI terminals; ground/isolation-boundary correction requires separate approval
A17 | MAJOR | Field_IO | U10/U11.IN/D/S/S_TAB | All eight terminals individual single-pin nets; U9B1/B2 separate | IN←B1/B2; D→separate load negatives;S+tab→DO_EXT_RETURN | Diodes DS33016 pp1,8;guide10 | Complete local BSP wiring and external terminals; no invented numeric pads
A18 | MAJOR | Field_IO | U9B1/B2 | No B-side10k pull-downs | One10k from each DO_DRIVE to established source return | Guide10; native inventory R24/25 only A-side | Add two selected10k parts; preserve architecture and confirm defaultOFF before loads
A19 | MAJOR | Field_IO | U9→BSP drive | Physical wiring absent and loadedVOH not guaranteed | ≥4.5V IN-to-localS for overtemperature protection | Diodesp4/TI SCES516N Table5.5;guide10 | Retain separate loaded-drive/resetOFF acceptance; no driver architecture substitution
A20 | MAJOR | TopLevel | Four sheet symbols | FileName=File Name;Designator=Designator | Actual four sheet filenames and meaningful unique sheet IDs | Native eSheetSymbol/ERC detail; project Flat | Map each intended block explicitly; labels/positions alone do not prove which child was intended
A21 | CAD PENDING | All | R12,R14,C46,R19,R17,C52,U10,U11,R22,R21,SW1,L1,C6,C4,C5,L2,C15,C13,C14,F1,D1,U1,C2,C1,R1,R3,R4,R2 | 28 placed components have no footprint model | Exact compatible model required for PCB | Native BOM independently matched saved records | Bind verified models locally; do not global-update or infer missing links from library presence
A22 | CAD PENDING | Power/Ethernet/Field_IO | TPS,RNX,RHB,DBQ,DCT,genericR/C | Existing source CAD_CANDIDATE or absent instance models | Verified exact land/mask/paste/pin-pad map before PCB | Current CAD mapping; TPS custom EP unresolved | Next footprint task; no fabrication readiness claim
A23 | MINOR | Power | C11,C20,R6,R9 | No project variants; conditionalCFF and PG resistors physically present withoutDNP | CFF DNP unless approved;PG unused | Guide2/3;project variant_count0 | Record DNP explicitly or remove only intended option; no bulk variant changes
A24 | INFORMATIONAL | Power | U1.4/U1.9 | Open; ERC reports SHDN floating | Intentional internal enable; FLT unused | TI SLVSDT4F p4/9.3;guide1 | Do not wire SHDN to24V or groundRTN to silenceERC; targeted NC markers only
A25 | INFORMATIONAL | Ethernet | U5.1/.26/.27 | Open; ERC calls floating | Enhanced ModeSelect open;unusedRMII TXD2/3 perguide | TI SNLS647I pp5–7;guide5 | No false repair based onERC alone; mark intentional NC where appropriate
A26 | INFORMATIONAL | Power | J1 | TB002-500-02BE;BOM JL126-50002G01 | Actual selected/accepted connector identity needs reconciliation | Placed metadata vs currentBOM | Do not substitute valid connector automatically; retain actual identity in inventory
A27 | INFORMATIONAL | MCU/other | 10k pull-down parts | Several FOJAN5%FRC0603J103TS instead of selectedYageo1% | Selected exactMPN consistency | Placed metadata/currentBOM | Record mismatch; not an automatic electrical failure or mandatory equivalent replacement
