anhenaobe/industrial-comunication-gateway/docs/auditoria_nabc_2026-09-15.md

# Auditoría del proyecto Industrial Gateway

**Repositorio:** `anhenaobe/industrial-linux-gateway`

**Fecha de auditoría:** 2026-09-15

**Alcance:** repositorio completo, documentación técnica, diagramas, presentación y comparación con competidores.
**Restricciones observadas:** auditoría documental; no se modificaron los artefactos técnicos, no se seleccionó una plataforma de procesamiento y no se realizó ningún commit.

> **Nota de vigencia (actualizada el 2026-09-15):** este archivo conserva la auditoría del estado anterior a la decisión D-18 y debe leerse como una instantánea histórica. Después de la auditoría se decidió **STM32H723VET6 + Zephyr RTOS** como baseline de Rev. A, se creó la fuente NABC y se incorporaron referencias competitivas. Las frases de este informe que presentan la plataforma como abierta, o MYC-YM6231/Linux como baseline vigente, quedaron superadas por la revisión 0.4 del [documento maestro](industrial_linux_gateway_requirements.md). Los hallazgos no deben borrarse porque documentan el punto de partida.

## Resumen ejecutivo

El proyecto tiene una base técnica útil, pero todavía no está listo para cumplir la entrega NABC solicitada por el profesor.

Los problemas principales son:

1. no existe una presentación en el repositorio ni un enlace a una presentación externa;
2. no existe una sección de competencia, matriz competitiva ni referencias oficiales;
3. el documento maestro mantiene MYC-YM6231/Linux como baseline aceptado, mientras el diagrama más reciente deja abierta la plataforma entre Linux MPU/SoM y Zephyr MCU;
4. los diagramas están presentes únicamente en el árbol local y no están versionados en Git;
5. los beneficios son deducibles de los requisitos, pero no están formulados ni trazados como argumentos NABC;
6. no hay evidencia para afirmar menor coste, tamaño, consumo o mayor robustez.

El enfoque funcional del gateway sigue siendo pertinente: integración de interfaces industriales heterogéneas, adquisición y normalización de datos, comunicación IP, persistencia, diagnóstico y mantenimiento. La siguiente revisión debe reconciliar todos los artefactos alrededor de una plataforma todavía abierta y convertir esa base en una presentación breve, visual y verificable.

## 1. Inventario del repositorio

El repositorio remoto es público y su rama principal observada coincide con el commit local `afcd2f3`.

```text
industrial-linux-gateway/
├── LICENSE
└── docs/
    ├── industrial_linux_gateway_requirements.md
    └── figures/                                  ← sin seguimiento en Git
        ├── industrial_gateway_architecture.drawio
        ├── industrial_gateway_architecture.svg
        └── .$industrial_gateway_architecture.drawio.bkp
```

| Artefacto | Versión y estado identificado |
|---|---|
| Documento de requerimientos | Rev. 0.3, fecha interna 2026-09-13; último commit 2026-09-14. Es el documento maestro publicado, pero su estado arquitectónico está desactualizado. |
| `industrial_gateway_architecture.drawio` | Última modificación local: 2026-09-14 16:11. Es la versión editable más reciente encontrada y refleja la selección abierta. |
| `industrial_gateway_architecture.svg` | Última modificación local: 2026-09-14 10:56. Conserva el contenido funcional genérico, pero una disposición anterior. |
| `.$industrial_gateway_architecture.drawio.bkp` | Respaldo de edición anterior. No debe presentarse como otro documento vigente. |
| Decision Register | Está dentro del documento maestro, §2.3; no existe como archivo independiente. |
| Otros diagramas | Tres diagramas Mermaid dentro del documento: arquitectura funcional, procesamiento y alimentación. |
| README | No encontrado. |
| Presentación | No encontrada; tampoco se encontró un enlace a una presentación externa. |
| PDFs, PPTX, documentación adicional o material NABC independiente | No encontrados. |
| Esquemático, PCB, firmware, BOM o resultados de pruebas | No encontrados. |

Solo `LICENSE` y el documento de requerimientos estaban versionados al realizar la auditoría. La presencia local de las figuras no demuestra que el profesor pueda acceder a ellas desde el repositorio.

La desactualización del SVG no se dedujo únicamente de las fechas: su bloque de procesamiento tiene ancho 360 frente a 377 en el `.drawio`, y el panel de alimentación 1020 frente a 1150. Su geometría coincide con el respaldo anterior en los elementos contrastados.

## A. Cumplimiento de las instrucciones del profesor

Las calificaciones siguientes corresponden al material existente en el momento de la auditoría.

| Criterio | Resultado | Evidencia |
|---|---|---|
| Repositorio accesible | **PASS** | GitHub confirma un repositorio público y las referencias remotas son accesibles. |
| Presentación disponible | **FAIL** | No existe en el repositorio ni hay un enlace que permita localizarla. |
| Enfoque NABC | **PARTIAL** | Hay material para Need y Approach; Benefits está implícito y Competition está ausente. |
| Documento de requerimientos | **PARTIAL** | Existe una especificación extensa y trazable, pero contiene decisiones arquitectónicas desactualizadas. |
| Diagrama de bloques | **PARTIAL** | Existe localmente y contiene los bloques necesarios; no está publicado ni alineado con el documento maestro. |
| Competidores comerciales | **FAIL** | No hay comparación con Siemens, Moxa o Advantech. |
| Enlaces oficiales | **FAIL** | El documento técnico no incluye referencias a fabricantes competidores. |
| Análisis de beneficios | **PARTIAL** | Hay requisitos que permiten justificar beneficios, pero no una argumentación comparativa explícita. |
| Consistencia técnica | **FAIL** | Documento y diagrama describen estados diferentes de selección de plataforma. |
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
