anhenaobe/industrial-comunication-gateway/docs/competitor_references.md

# Competitor References

**Consulta:** 2026-09-15

**Propósito:** respaldar la sección Competition de la entrega NABC con fuentes oficiales del fabricante.

## Reglas de comparación

- Se compara una variante identificable, sin combinar características de otros miembros de la familia.
- `No documentado` no significa que una capacidad sea imposible mediante accesorios.
- Las capacidades del gateway propio son objetivos de diseño: no están implementadas ni validadas.
- Precio se deja `N/A` porque no se encontró una fuente oficial verificable y comparable.
- La posición defendible es mejor ajuste potencial al conjunto específico de requisitos, no superioridad global frente a productos comerciales.
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
