anhenaobe/industrial-comunication-gateway/docs/hardware/evidence/autonomous_closure/DBQ_p45.png

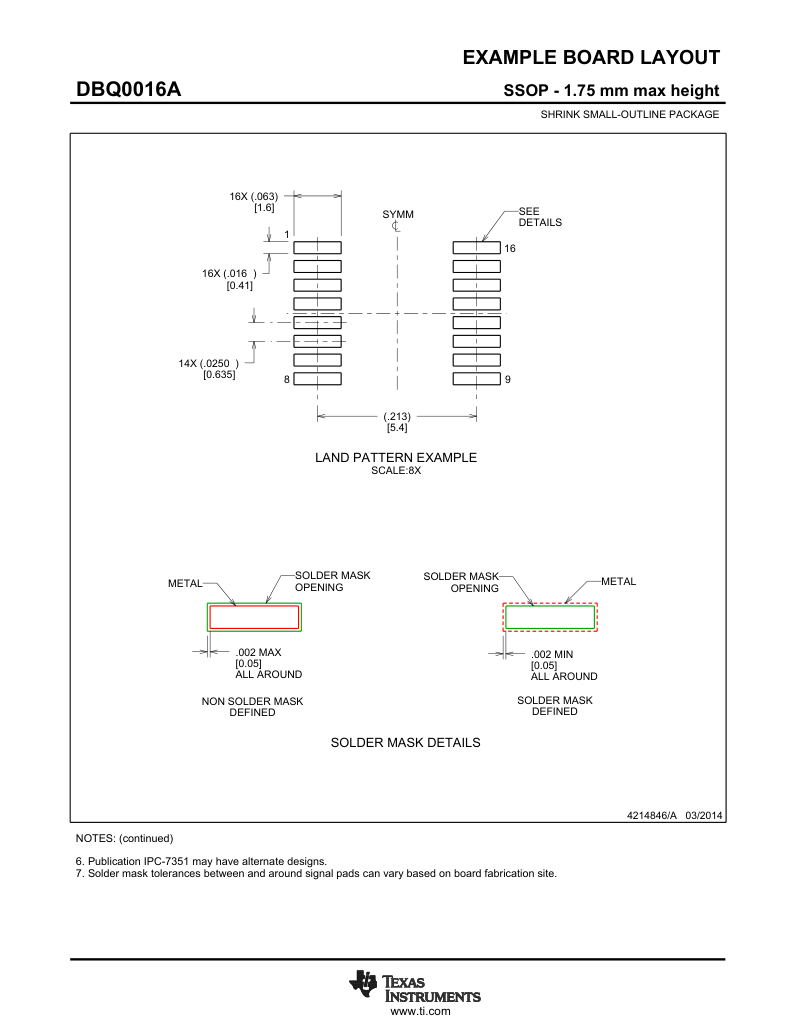
docs/hardware/evidence/autonomous_closure/DBQ_p45.png
