anhenaobe/industrial-comunication-gateway/docs/hardware/evidence/autonomous_closure/DMP2035U_p7.png

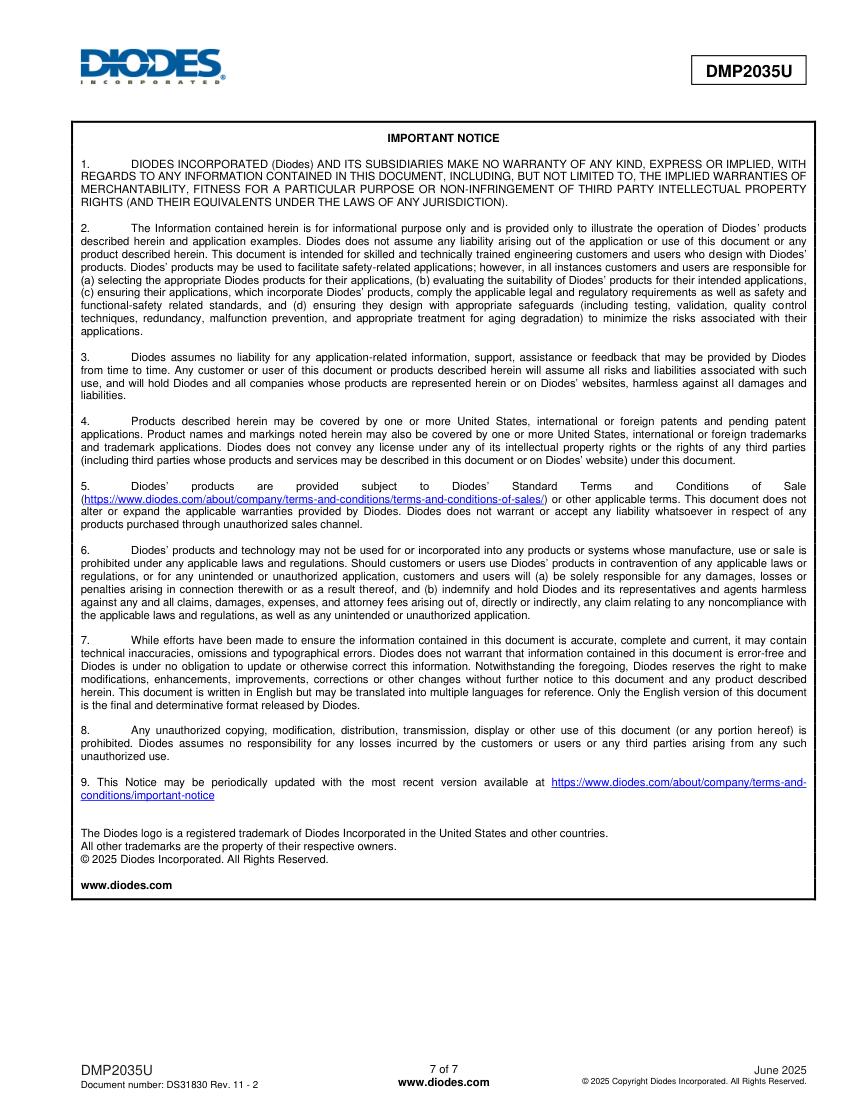
docs/hardware/evidence/autonomous_closure/DMP2035U_p7.png
