anhenaobe/industrial-comunication-gateway/docs/hardware/evidence/autonomous_closure/DQA_p29.png

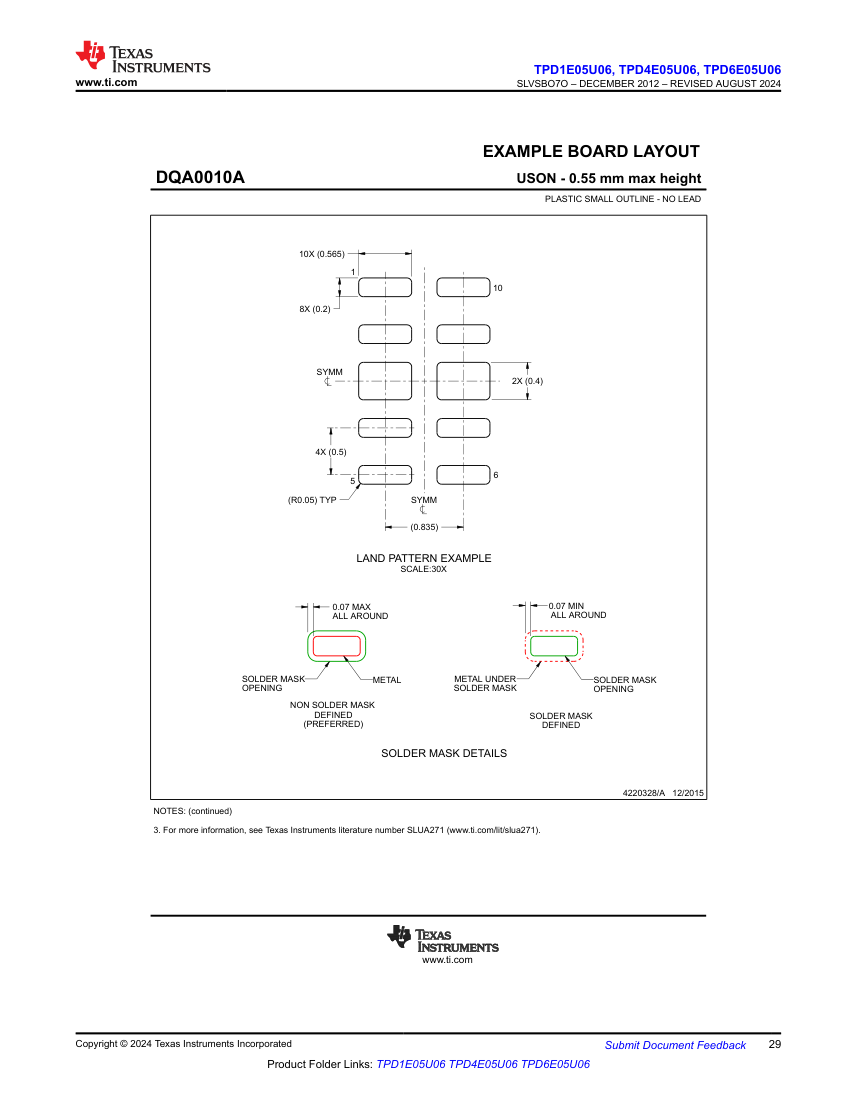
docs/hardware/evidence/autonomous_closure/DQA_p29.png
