anhenaobe/industrial-comunication-gateway/docs/hardware/evidence/autonomous_closure/DQA_p30.png

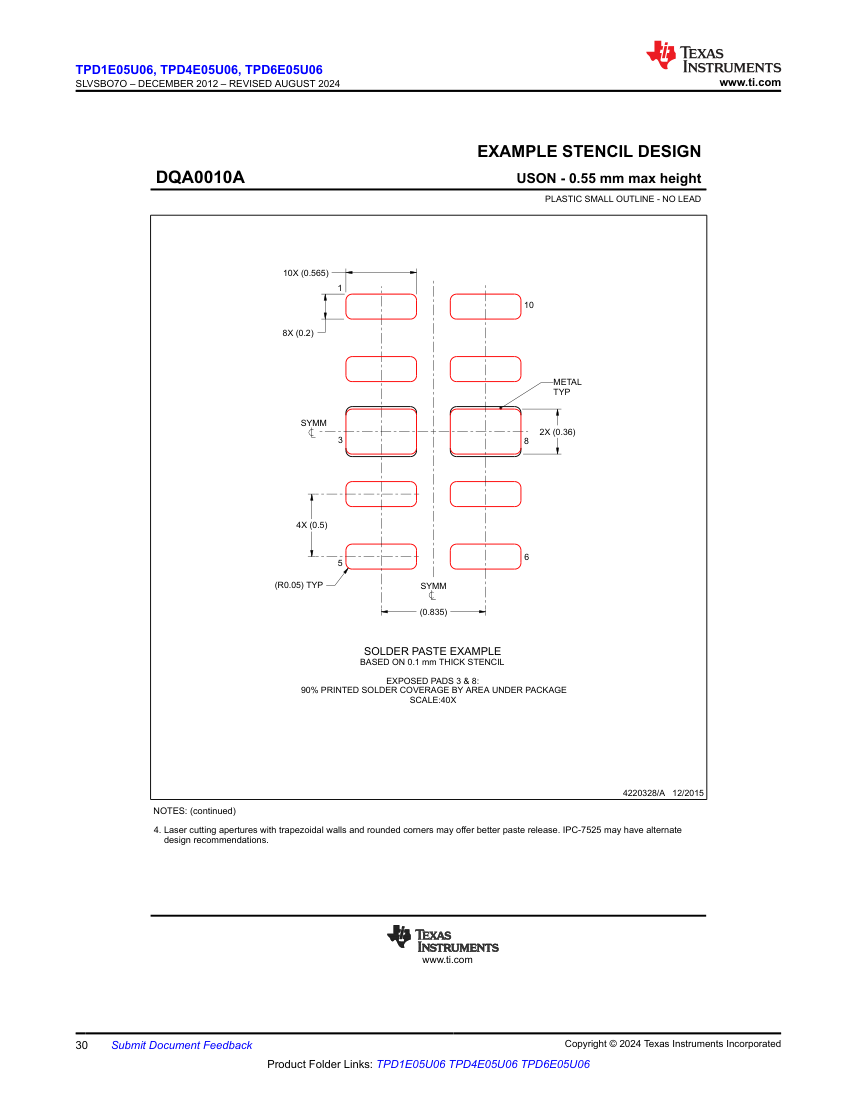
docs/hardware/evidence/autonomous_closure/DQA_p30.png
