anhenaobe/industrial-comunication-gateway/docs/hardware/evidence/autonomous_closure/HX_p2.png

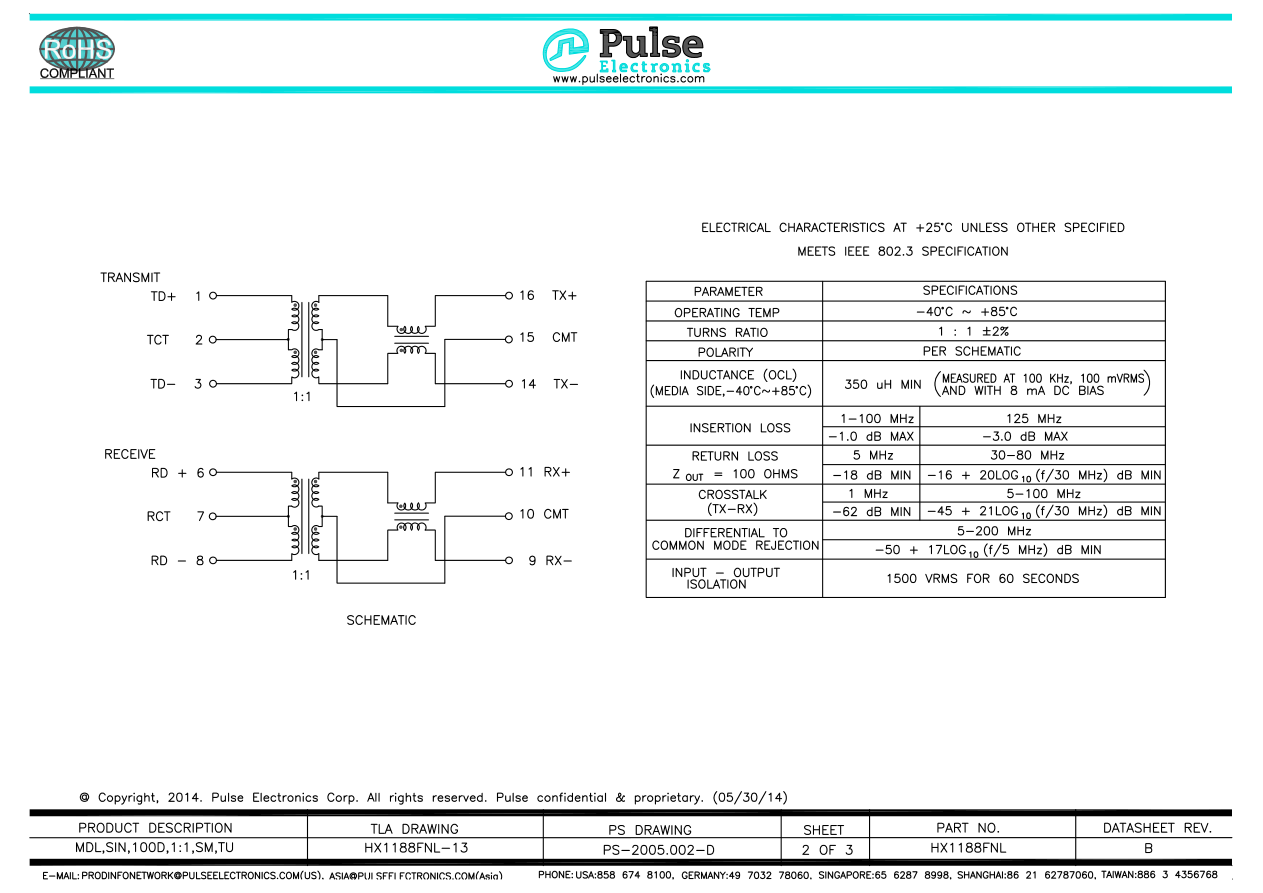
docs/hardware/evidence/autonomous_closure/HX_p2.png
