anhenaobe/industrial-comunication-gateway/docs/hardware/evidence/autonomous_closure/HX_p3.png

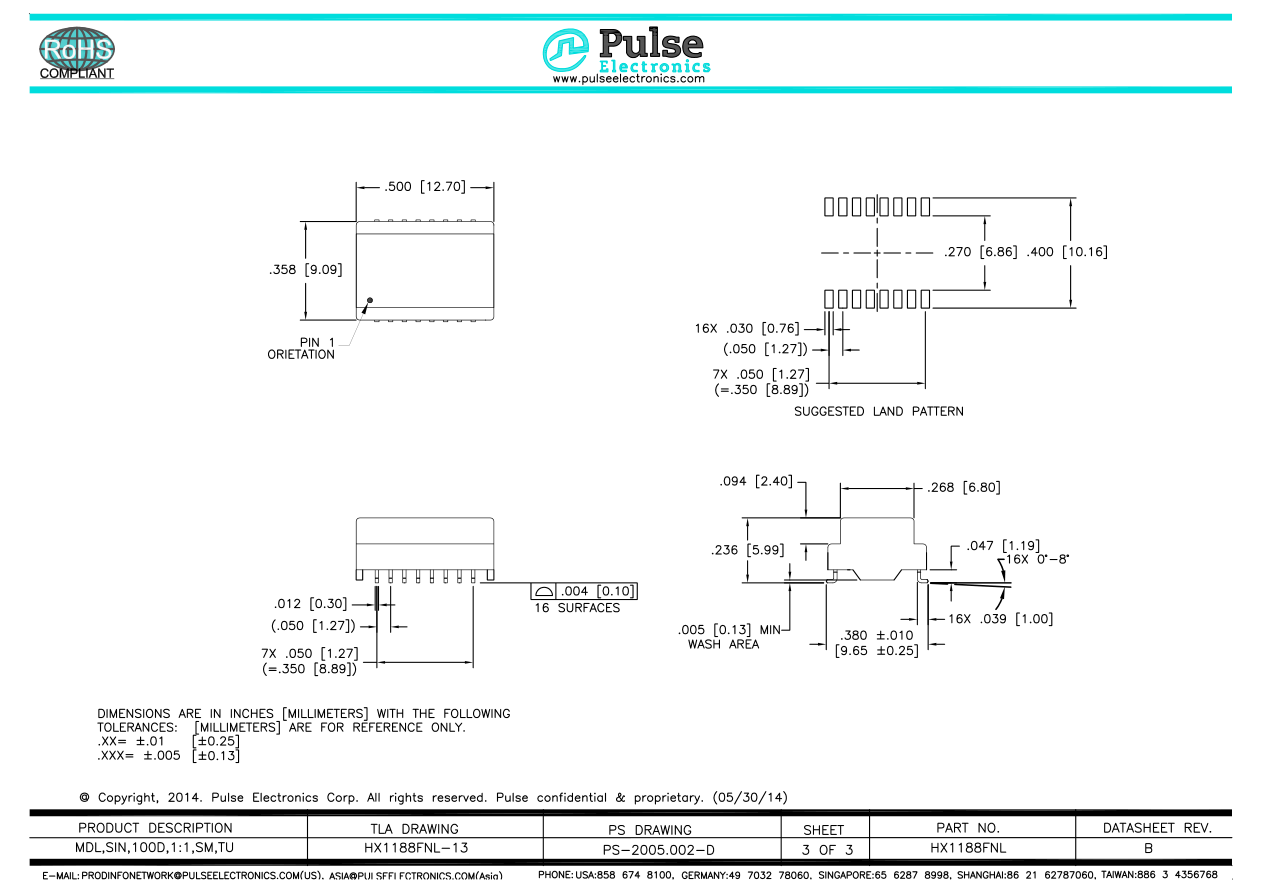
docs/hardware/evidence/autonomous_closure/HX_p3.png
