anhenaobe/industrial-comunication-gateway/docs/hardware/evidence/autonomous_closure/KC_p5.png

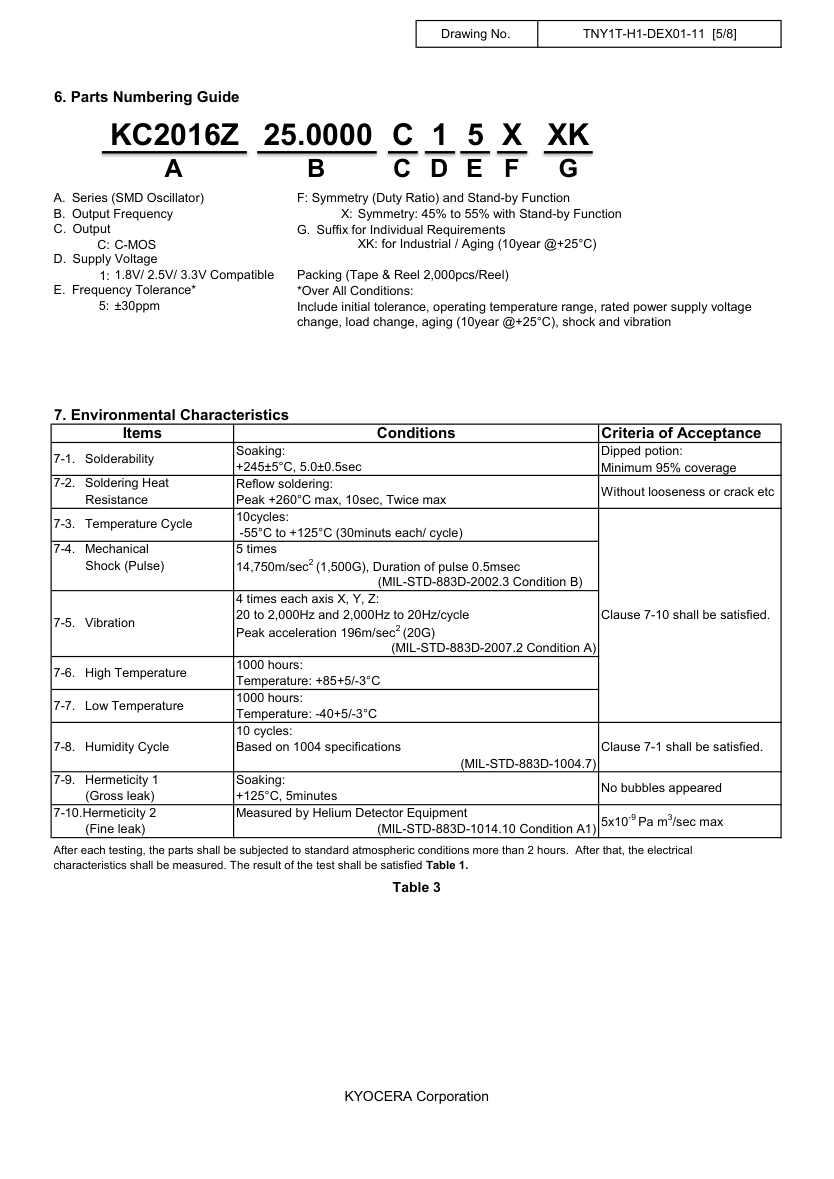
docs/hardware/evidence/autonomous_closure/KC_p5.png
