anhenaobe/industrial-comunication-gateway/docs/hardware/evidence/autonomous_closure/MMBT3904_p1.png

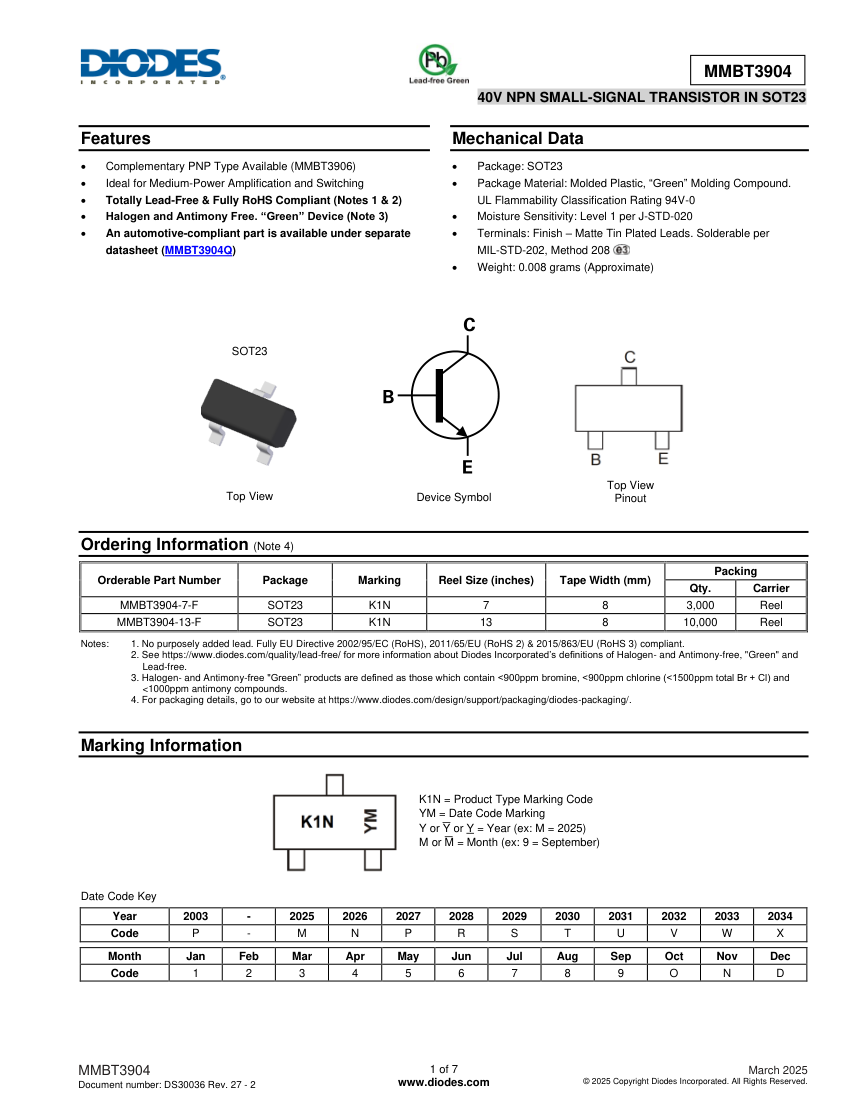
docs/hardware/evidence/autonomous_closure/MMBT3904_p1.png
