anhenaobe/industrial-comunication-gateway/docs/hardware/evidence/autonomous_closure/MMBT3904_p7.png

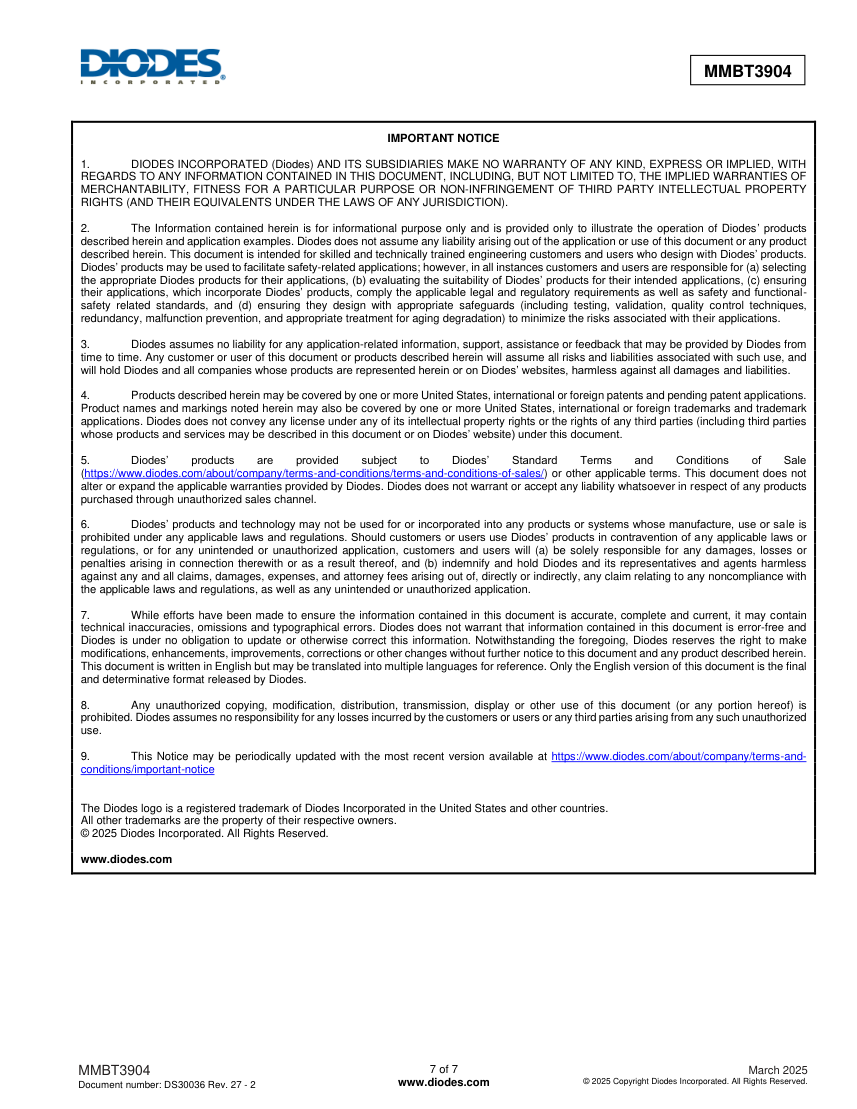
docs/hardware/evidence/autonomous_closure/MMBT3904_p7.png
