anhenaobe/industrial-comunication-gateway/docs/hardware/evidence/autonomous_closure/RHB_p112.png

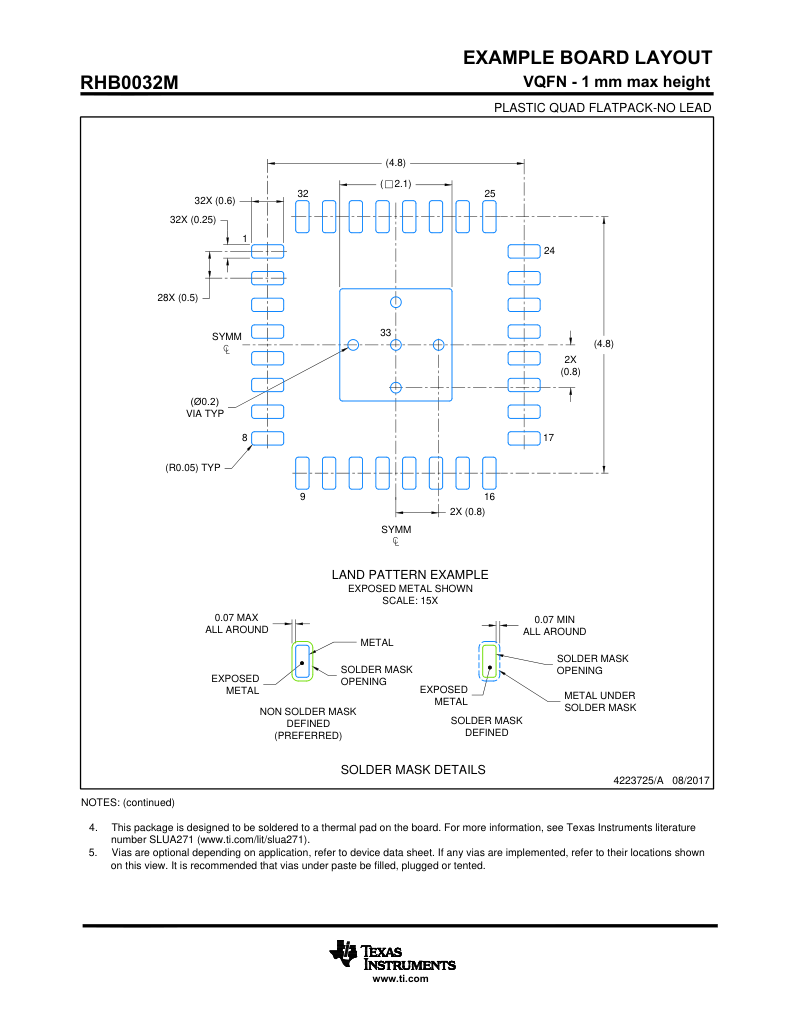
docs/hardware/evidence/autonomous_closure/RHB_p112.png
