anhenaobe/industrial-comunication-gateway/docs/hardware/evidence/autonomous_closure/RHB_p113.png

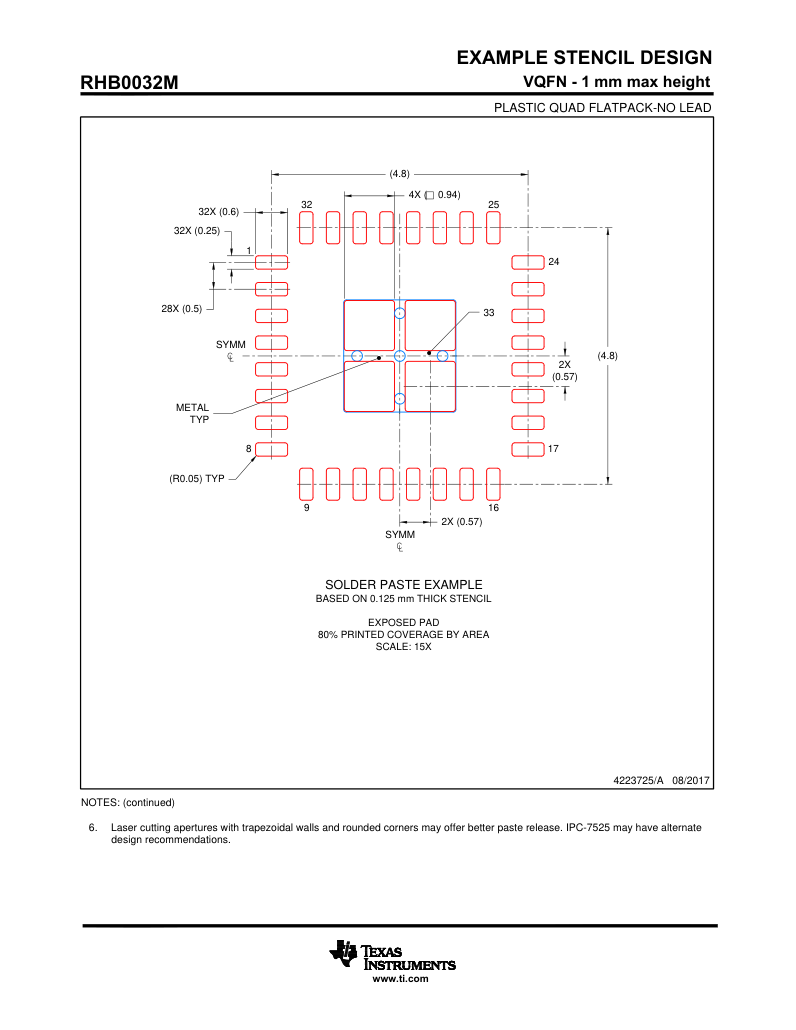
docs/hardware/evidence/autonomous_closure/RHB_p113.png
