anhenaobe/industrial-comunication-gateway/docs/hardware/evidence/autonomous_closure/RJ_holes_detail.png

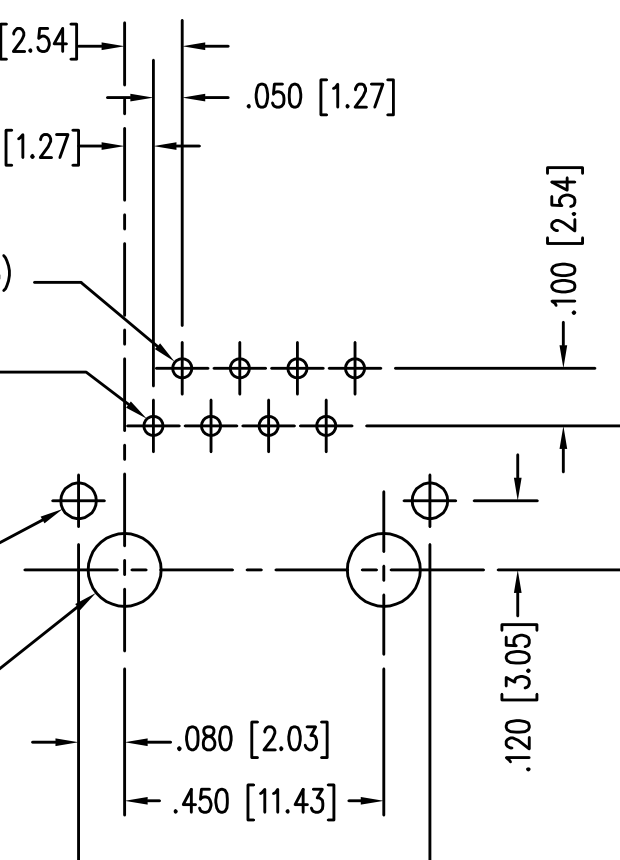
docs/hardware/evidence/autonomous_closure/RJ_holes_detail.png
