anhenaobe/industrial-comunication-gateway/docs/hardware/evidence/autonomous_closure/RJ_p1.png

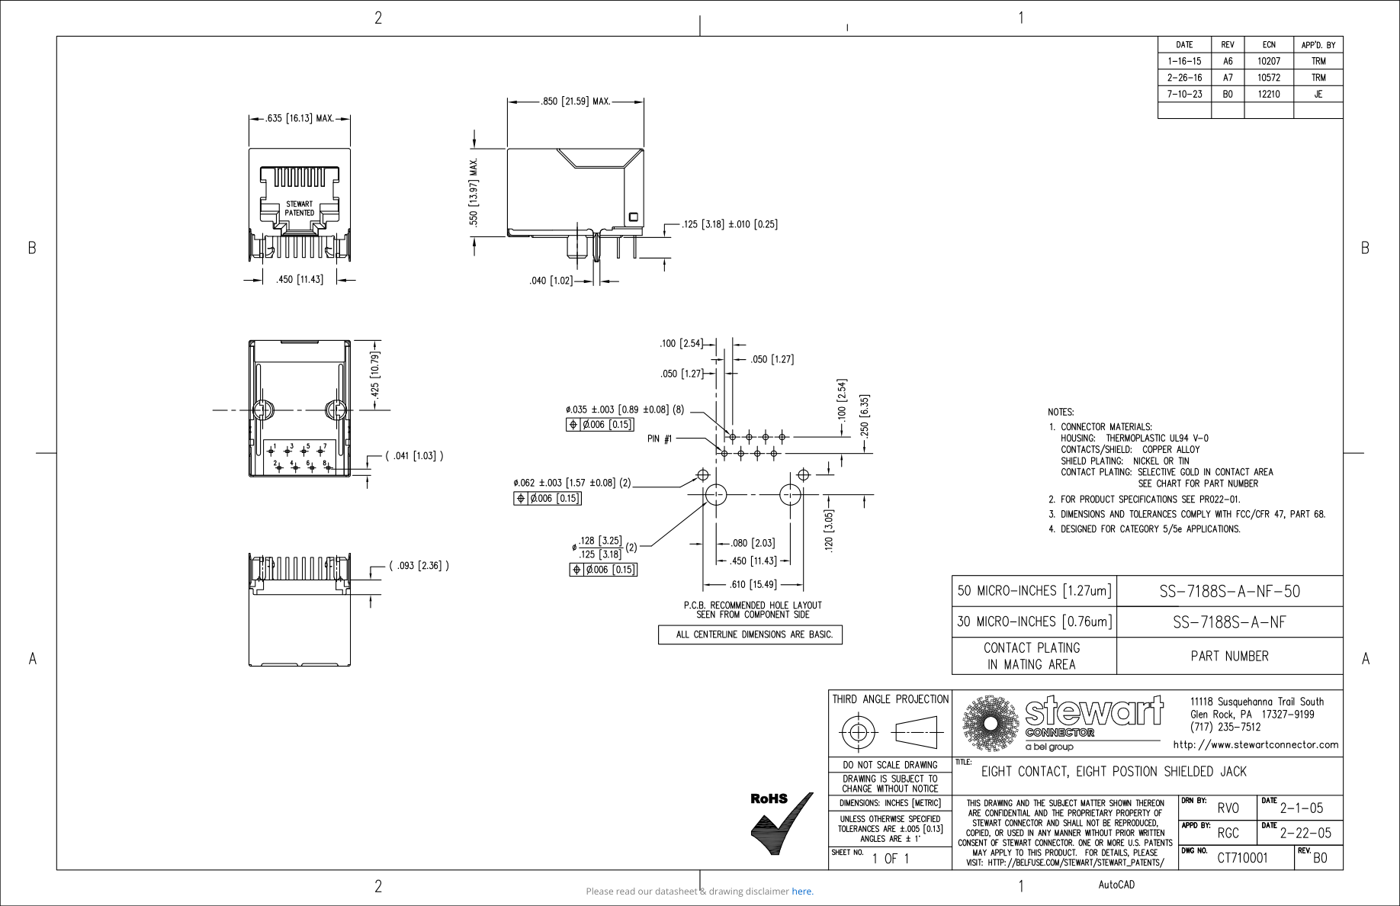
docs/hardware/evidence/autonomous_closure/RJ_p1.png
