anhenaobe/industrial-comunication-gateway/docs/hardware/evidence/autonomous_closure/RNX_p45.png

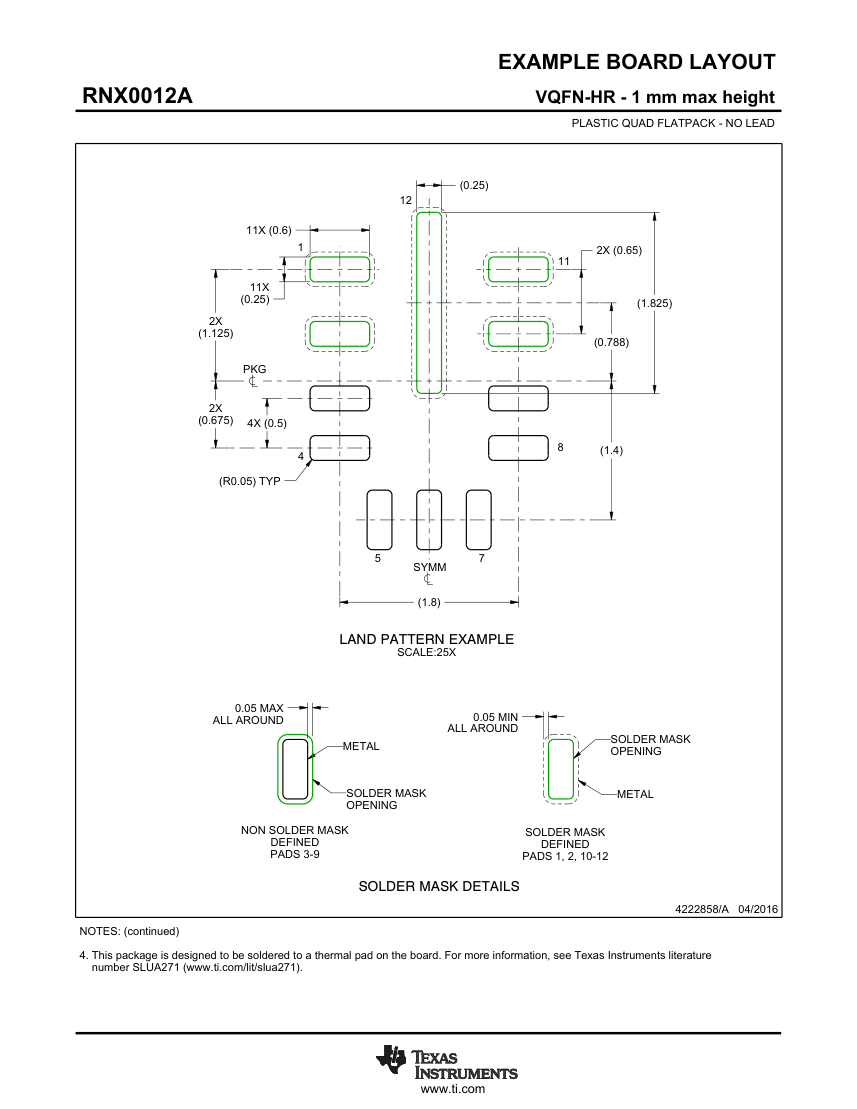
docs/hardware/evidence/autonomous_closure/RNX_p45.png
