anhenaobe/industrial-comunication-gateway/docs/hardware/evidence/autonomous_closure/Samsung_land_p159.png

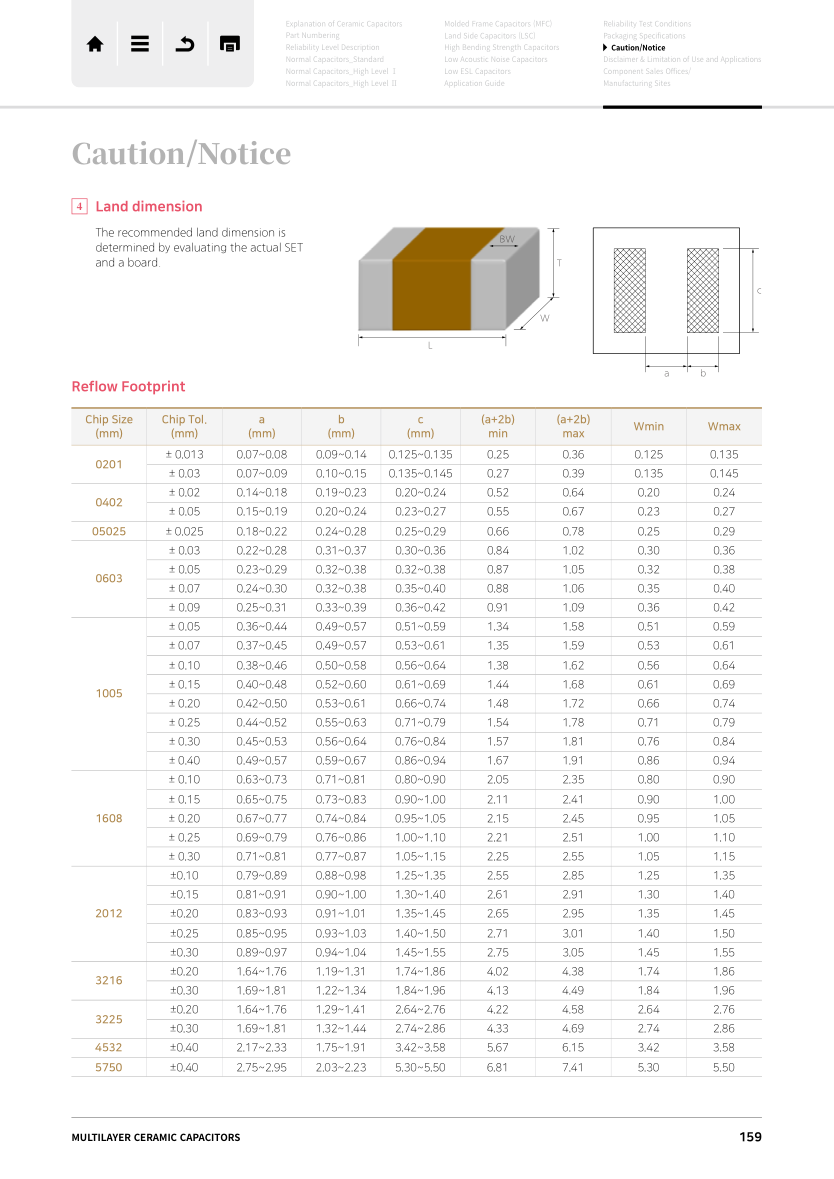
docs/hardware/evidence/autonomous_closure/Samsung_land_p159.png
