anhenaobe/industrial-comunication-gateway/docs/hardware/evidence/autonomous_closure/si2301cd_p8.png

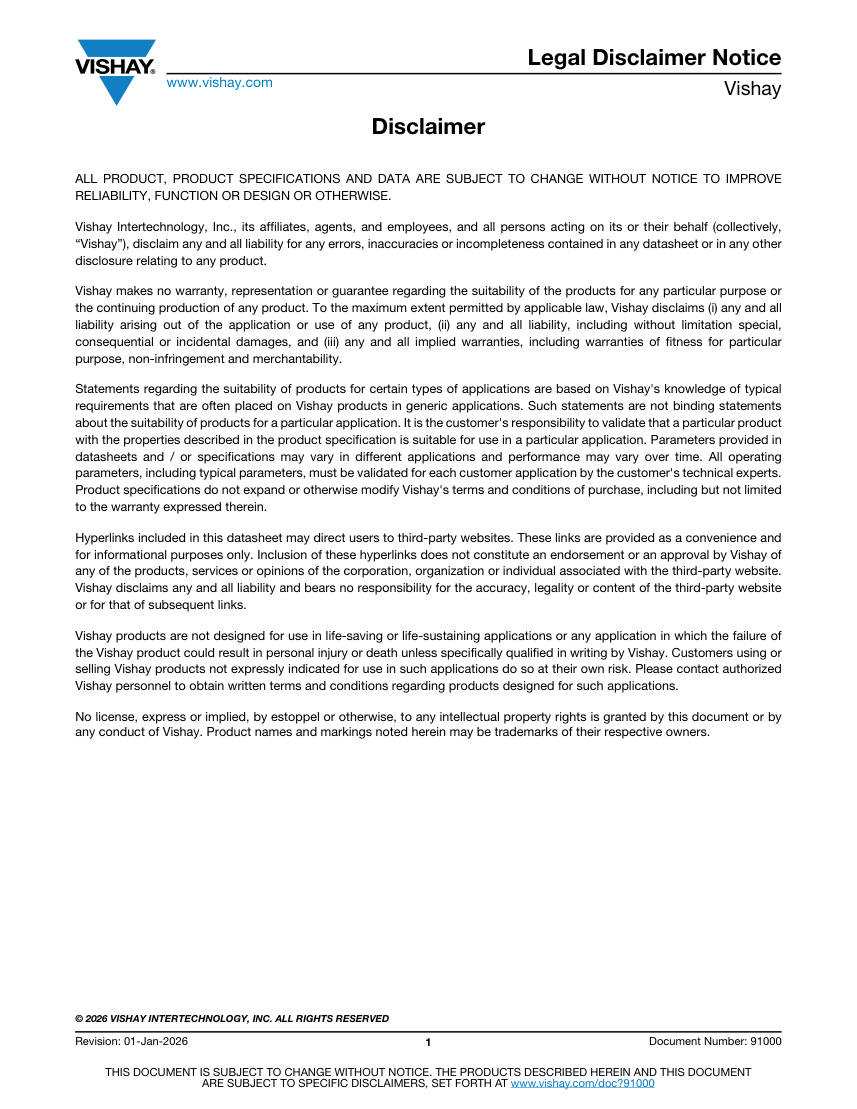
docs/hardware/evidence/autonomous_closure/si2301cd_p8.png
