anhenaobe/industrial-comunication-gateway/docs/hardware/evidence/autonomous_closure/SOIC_MC_p20.png

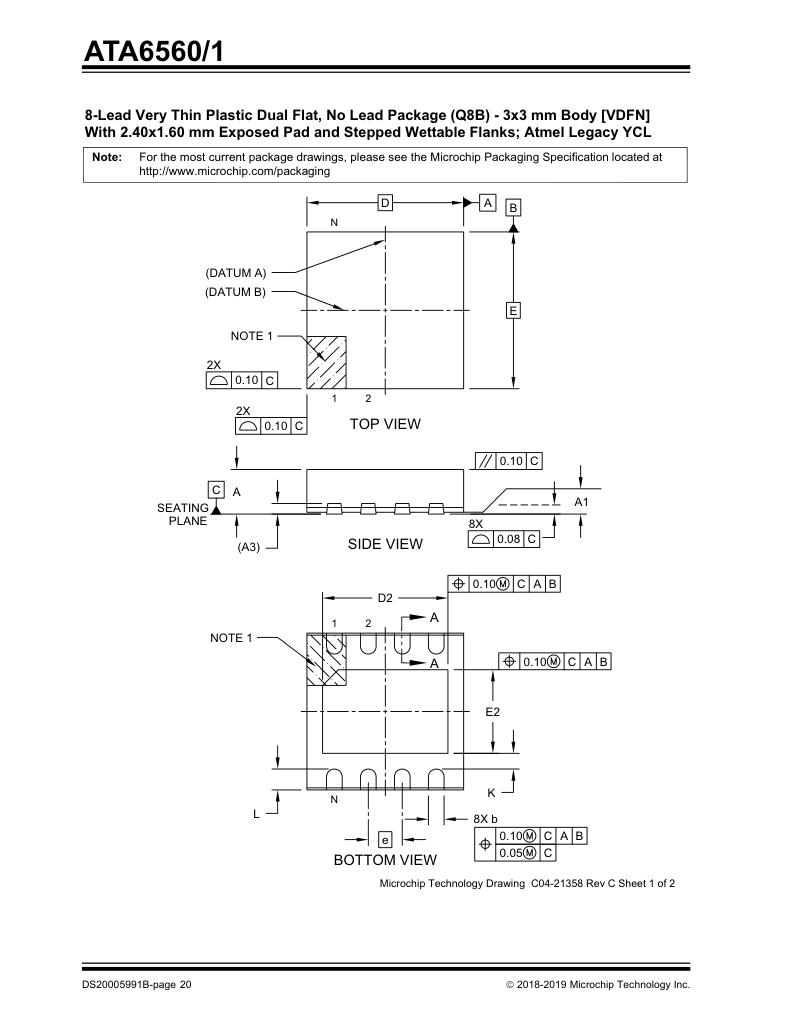
docs/hardware/evidence/autonomous_closure/SOIC_MC_p20.png
