anhenaobe/industrial-comunication-gateway/docs/hardware/evidence/autonomous_closure/SOIC_TI_p31.png

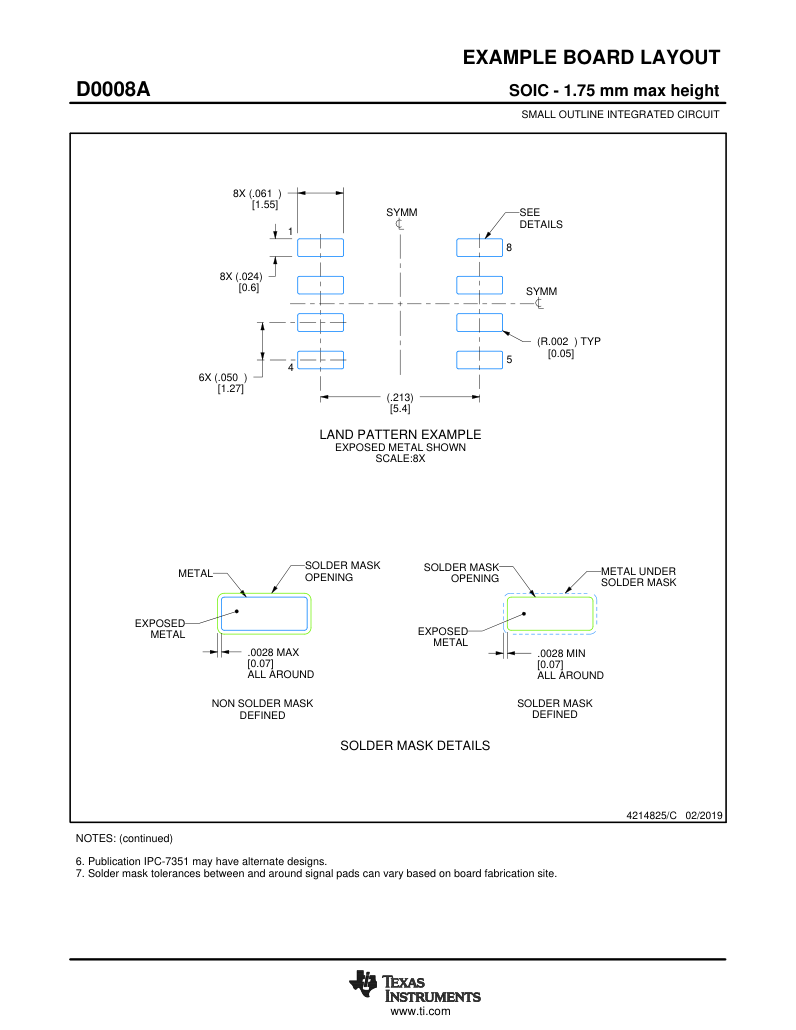
docs/hardware/evidence/autonomous_closure/SOIC_TI_p31.png
