anhenaobe/industrial-comunication-gateway/docs/hardware/evidence/autonomous_closure/tb_p1.png

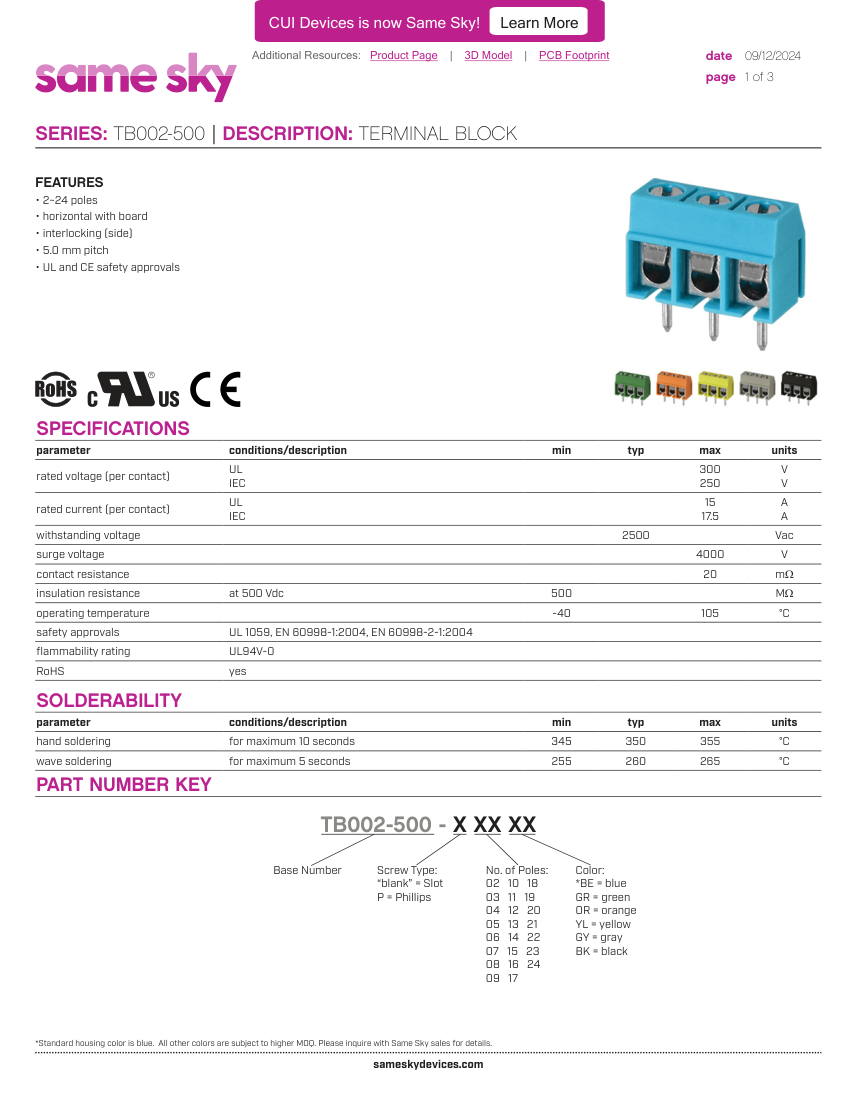
docs/hardware/evidence/autonomous_closure/tb_p1.png
