anhenaobe/industrial-comunication-gateway/docs/hardware/evidence/autonomous_closure/tb_p2.png

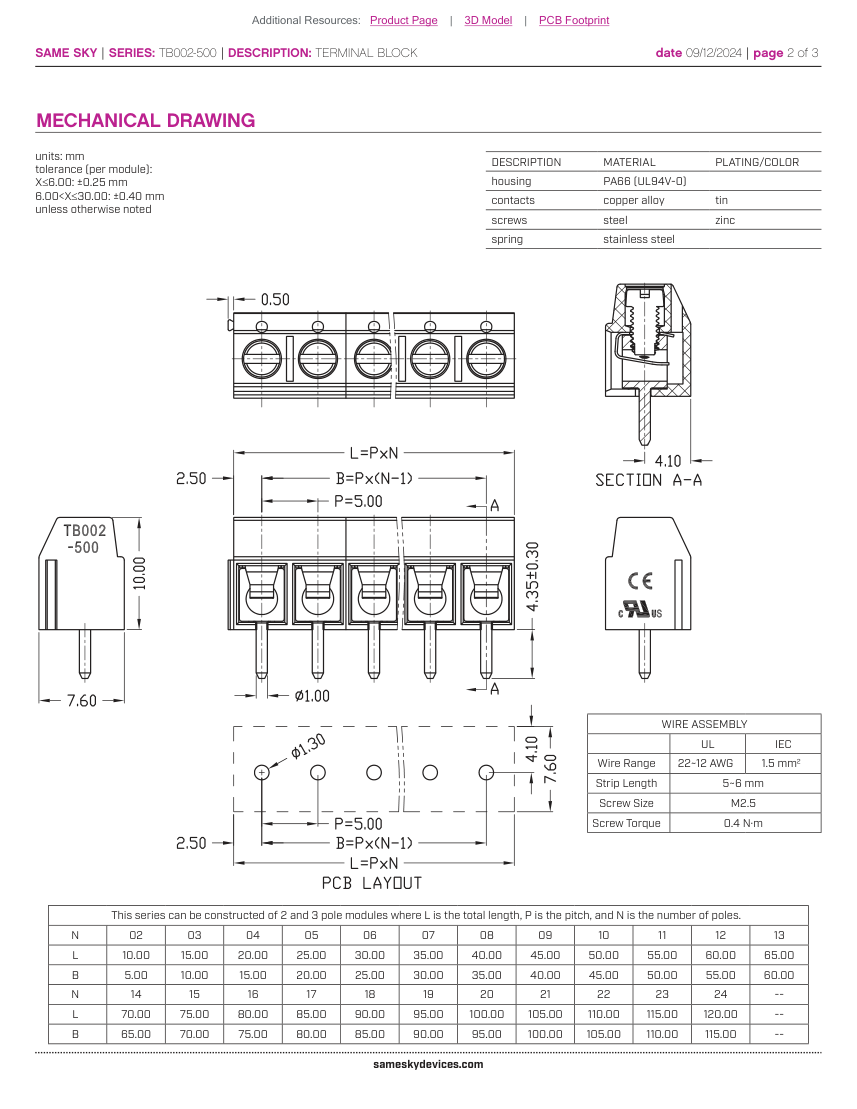
docs/hardware/evidence/autonomous_closure/tb_p2.png
