anhenaobe/industrial-comunication-gateway/docs/hardware/evidence/autonomous_closure/TPS_p43.png

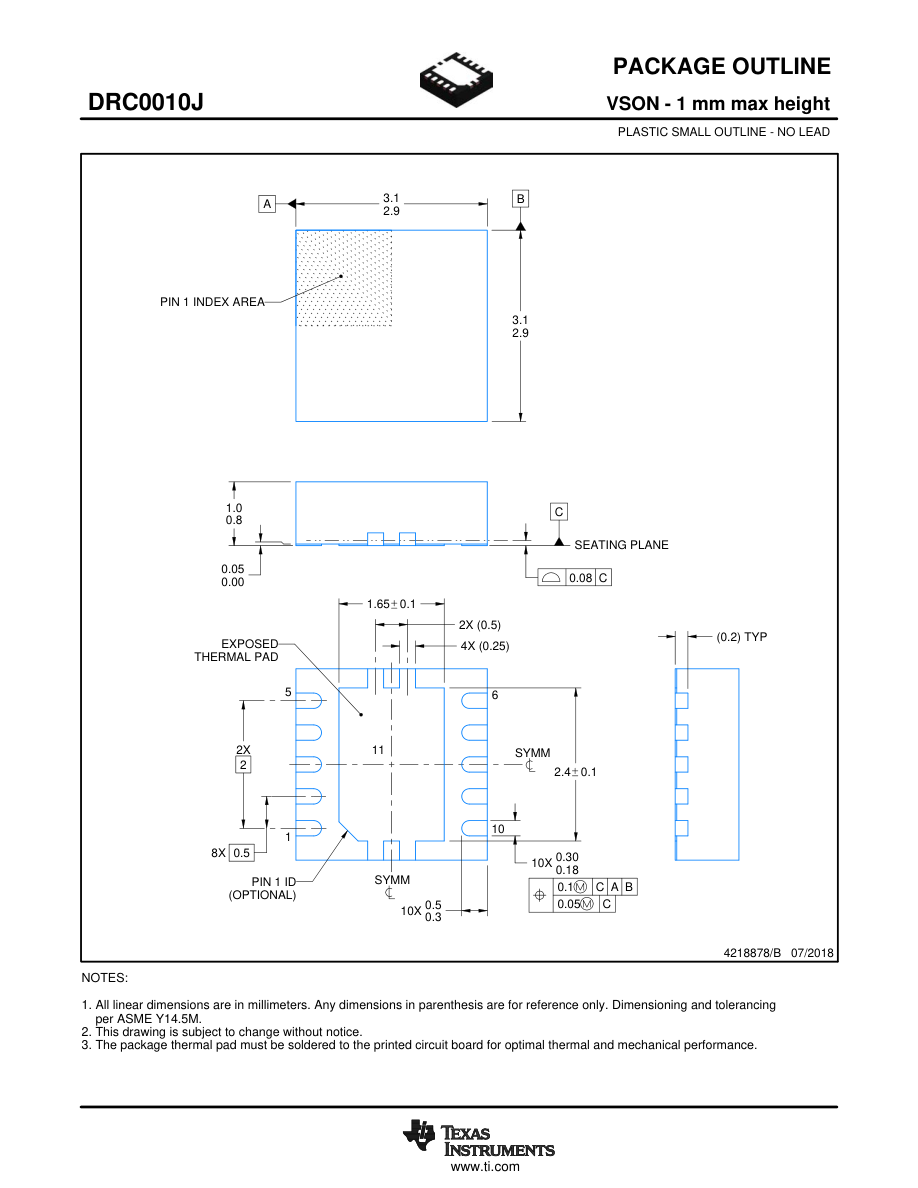
docs/hardware/evidence/autonomous_closure/TPS_p43.png
