anhenaobe/industrial-comunication-gateway/docs/hardware/evidence/autonomous_closure/XAL_lands_detail.png

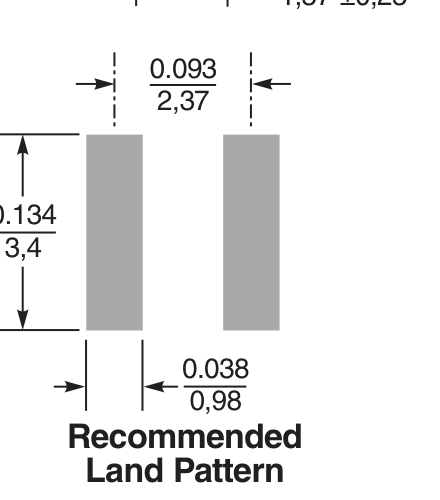
docs/hardware/evidence/autonomous_closure/XAL_lands_detail.png
