anhenaobe/industrial-comunication-gateway/docs/hardware/evidence/autonomous_closure/XAL_p4.png

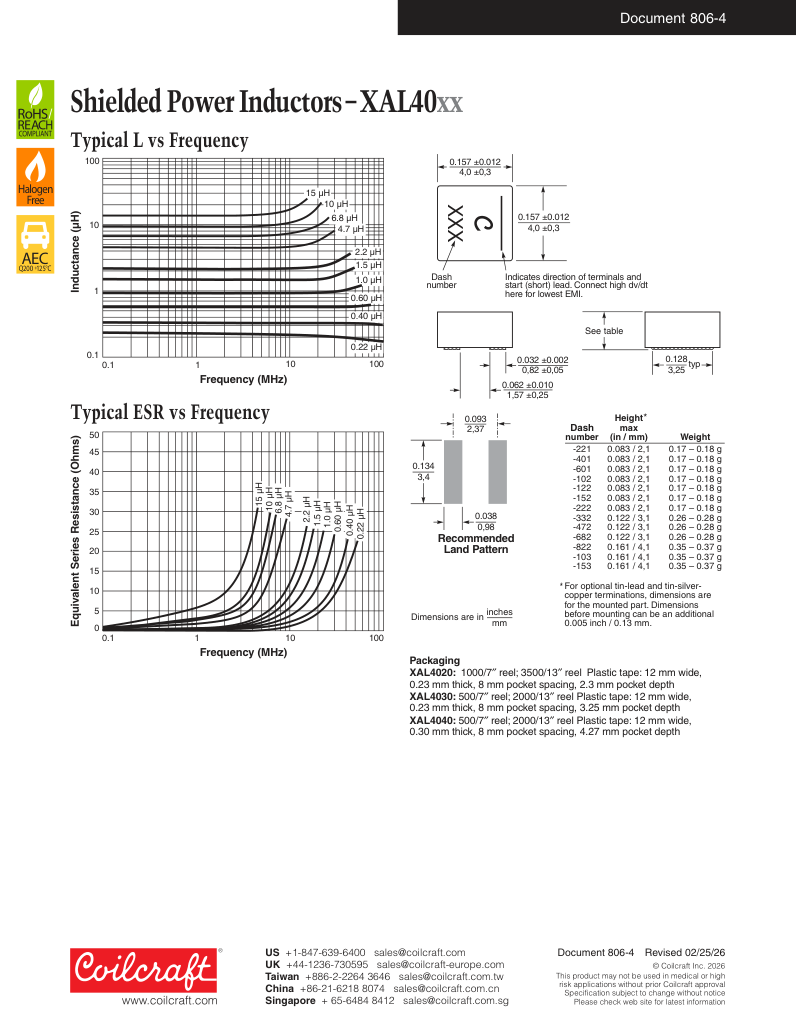
docs/hardware/evidence/autonomous_closure/XAL_p4.png
