anhenaobe/industrial-comunication-gateway/docs/hardware/evidence/bsp75n_closure/bsp_p1.png

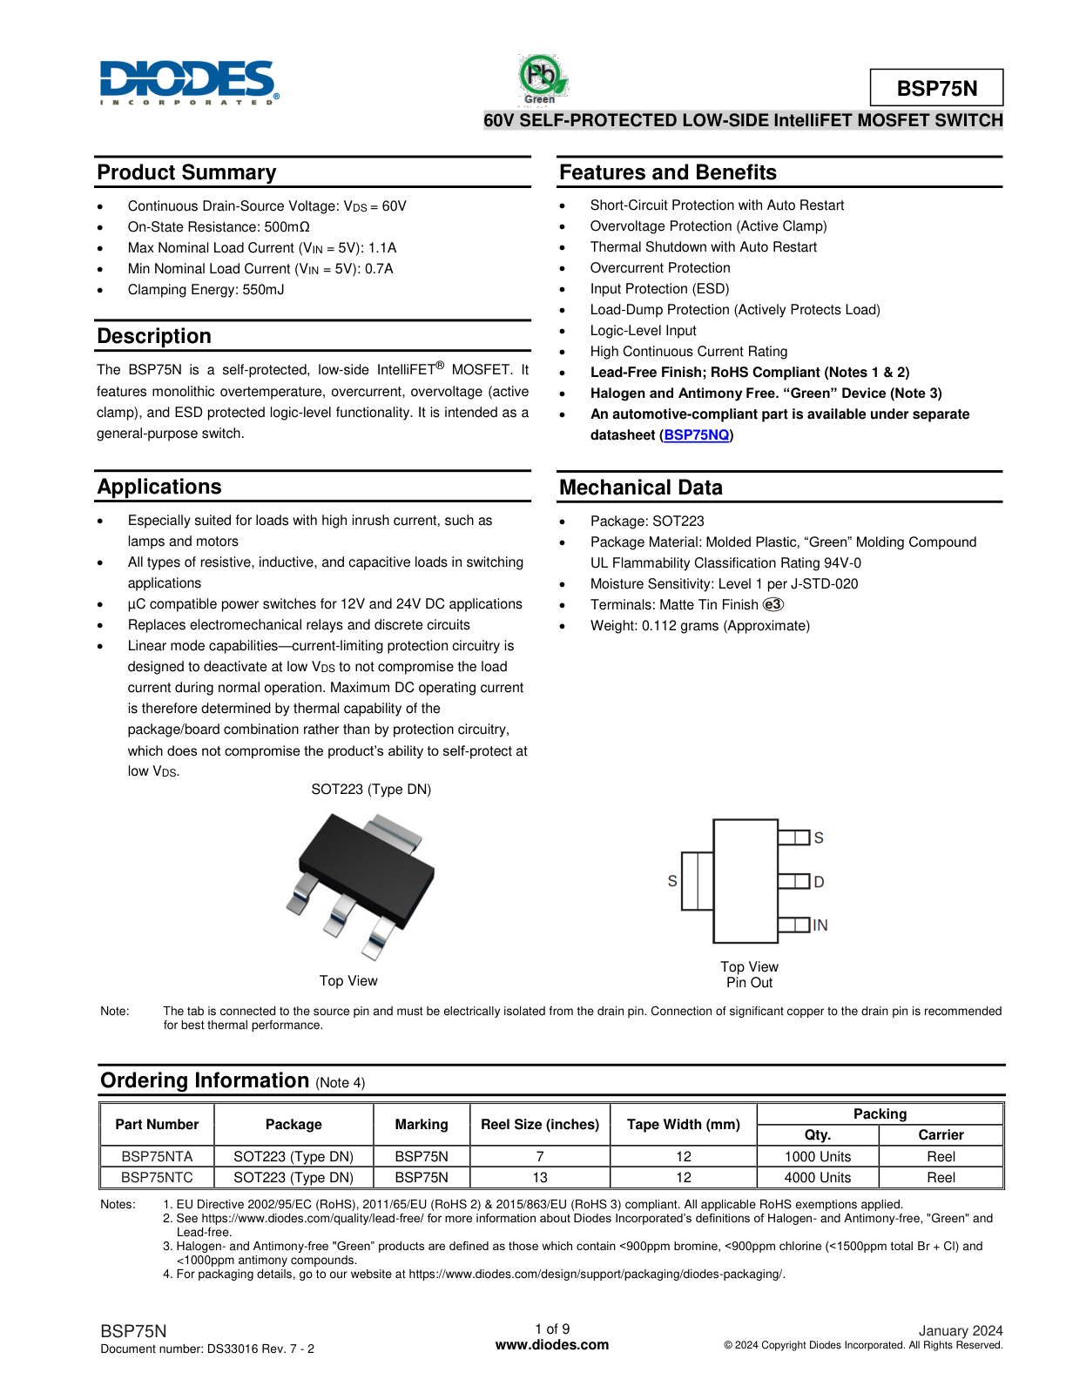
docs/hardware/evidence/bsp75n_closure/bsp_p1.png
