anhenaobe/industrial-comunication-gateway/docs/hardware/evidence/bsp75n_closure/bsp_p3.png

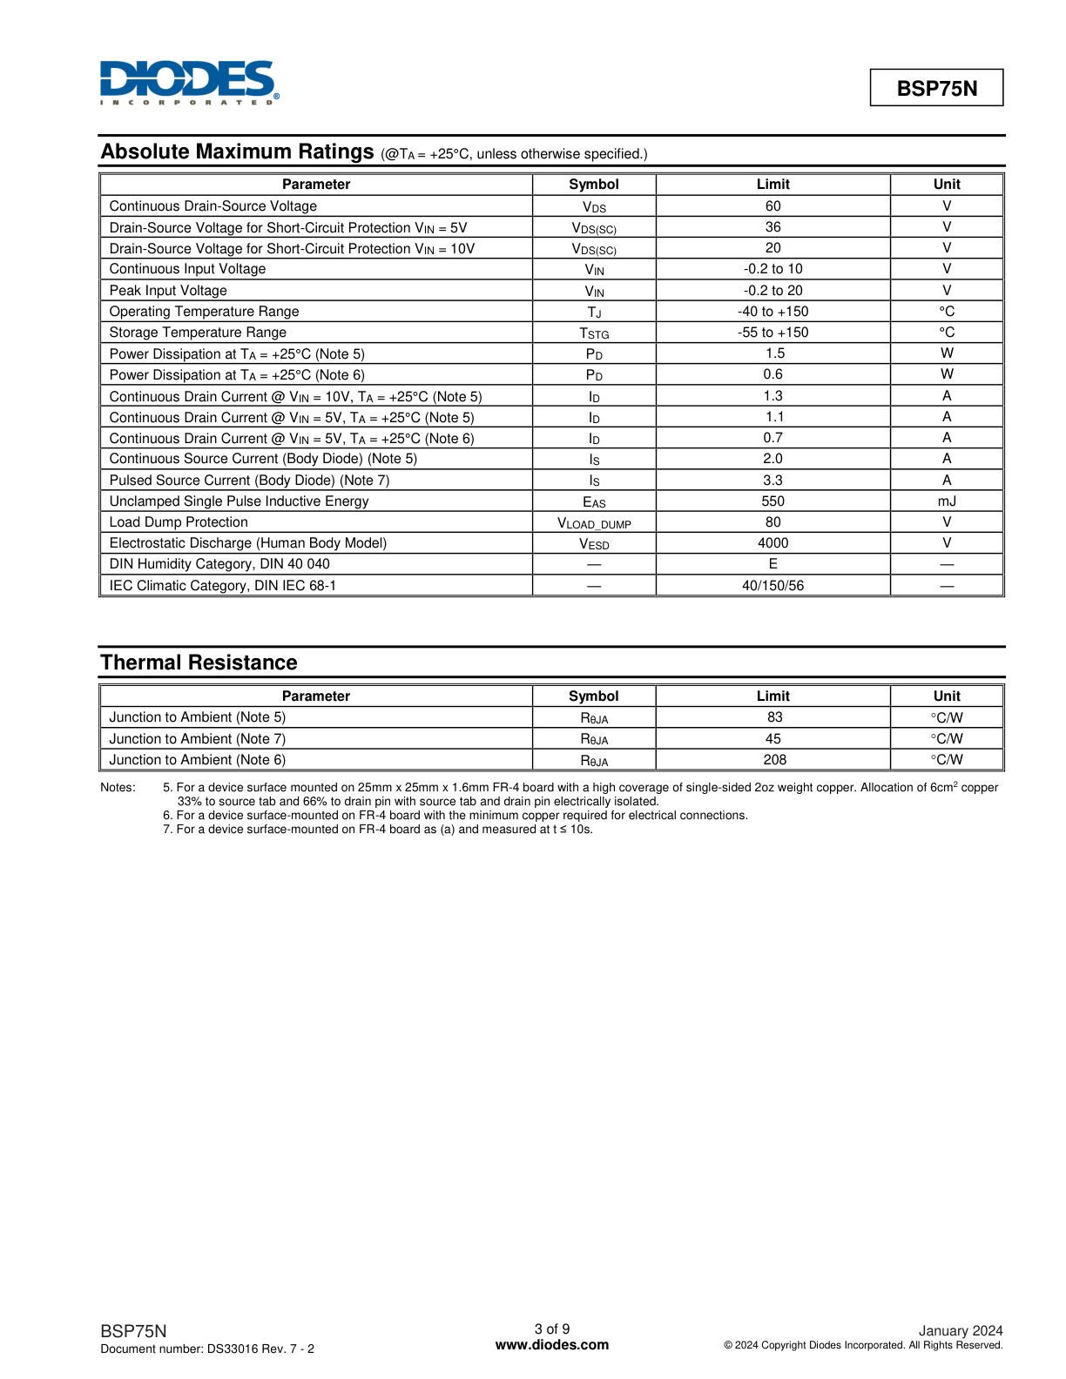
docs/hardware/evidence/bsp75n_closure/bsp_p3.png
