anhenaobe/industrial-comunication-gateway/docs/hardware/evidence/bsp75n_closure/translator_p6.png

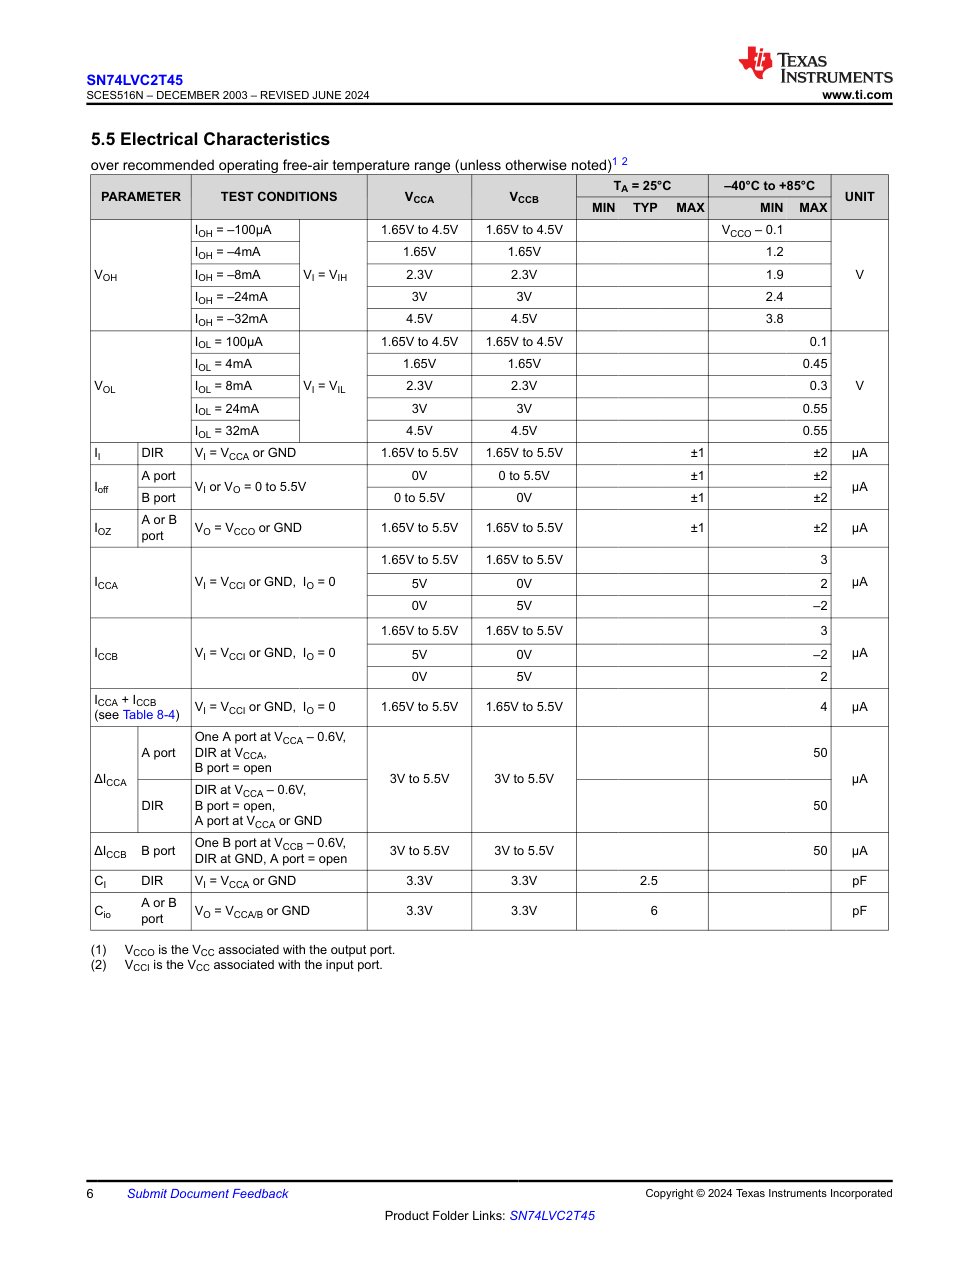
docs/hardware/evidence/bsp75n_closure/translator_p6.png
