anhenaobe/industrial-comunication-gateway/docs/hardware/evidence/electrical_closure/CDSOT23-SM712-p1.png

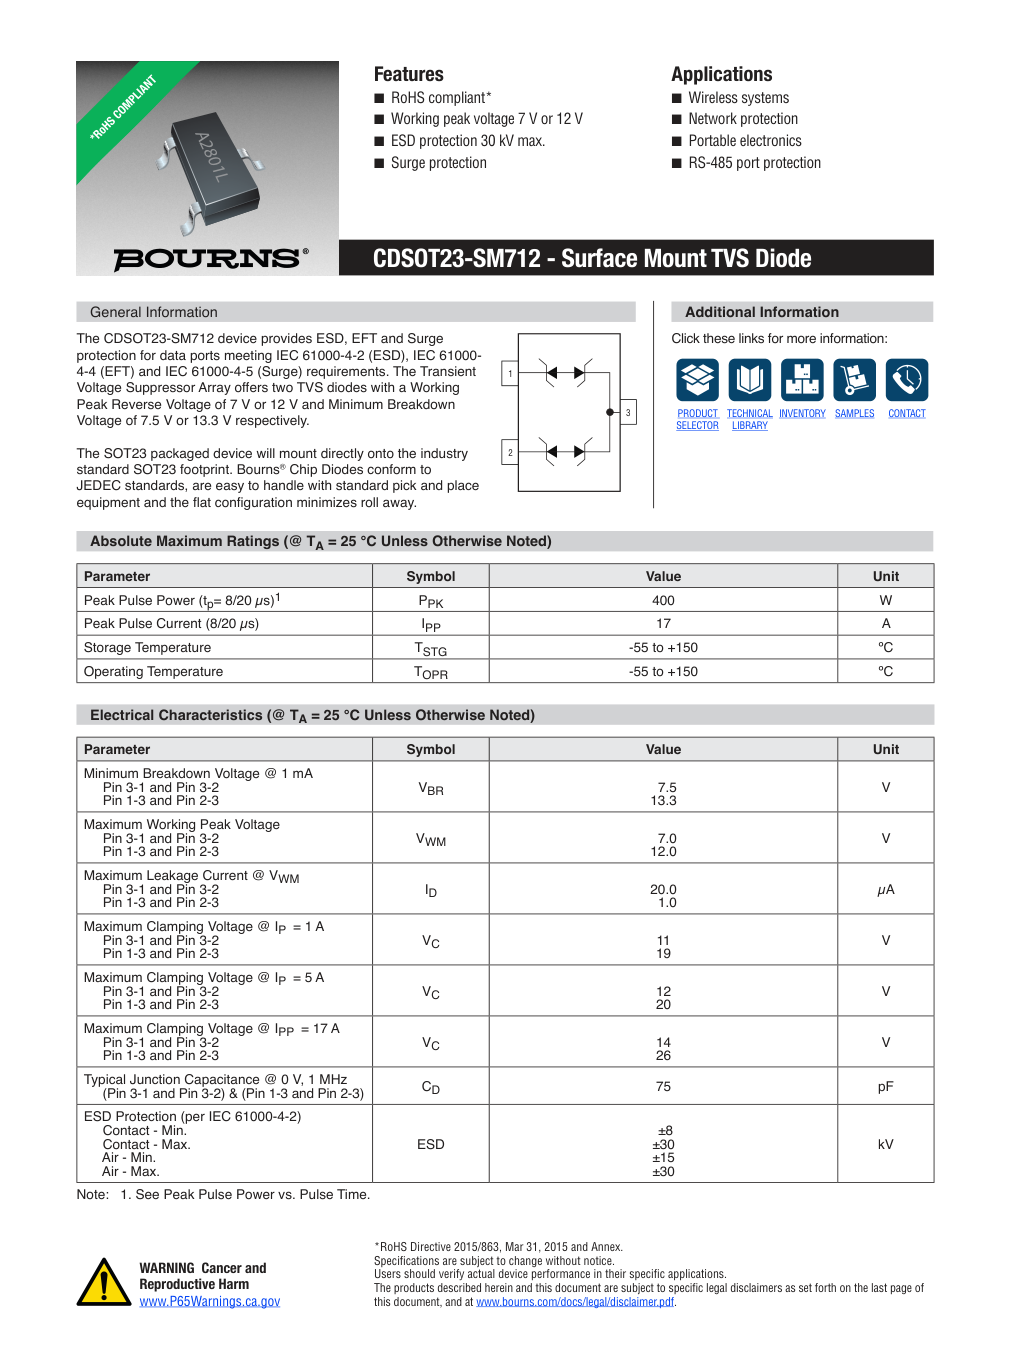
docs/hardware/evidence/electrical_closure/CDSOT23-SM712-p1.png
