anhenaobe/industrial-comunication-gateway/docs/hardware/evidence/electrical_closure/CDSOT23-SM712-p3.png

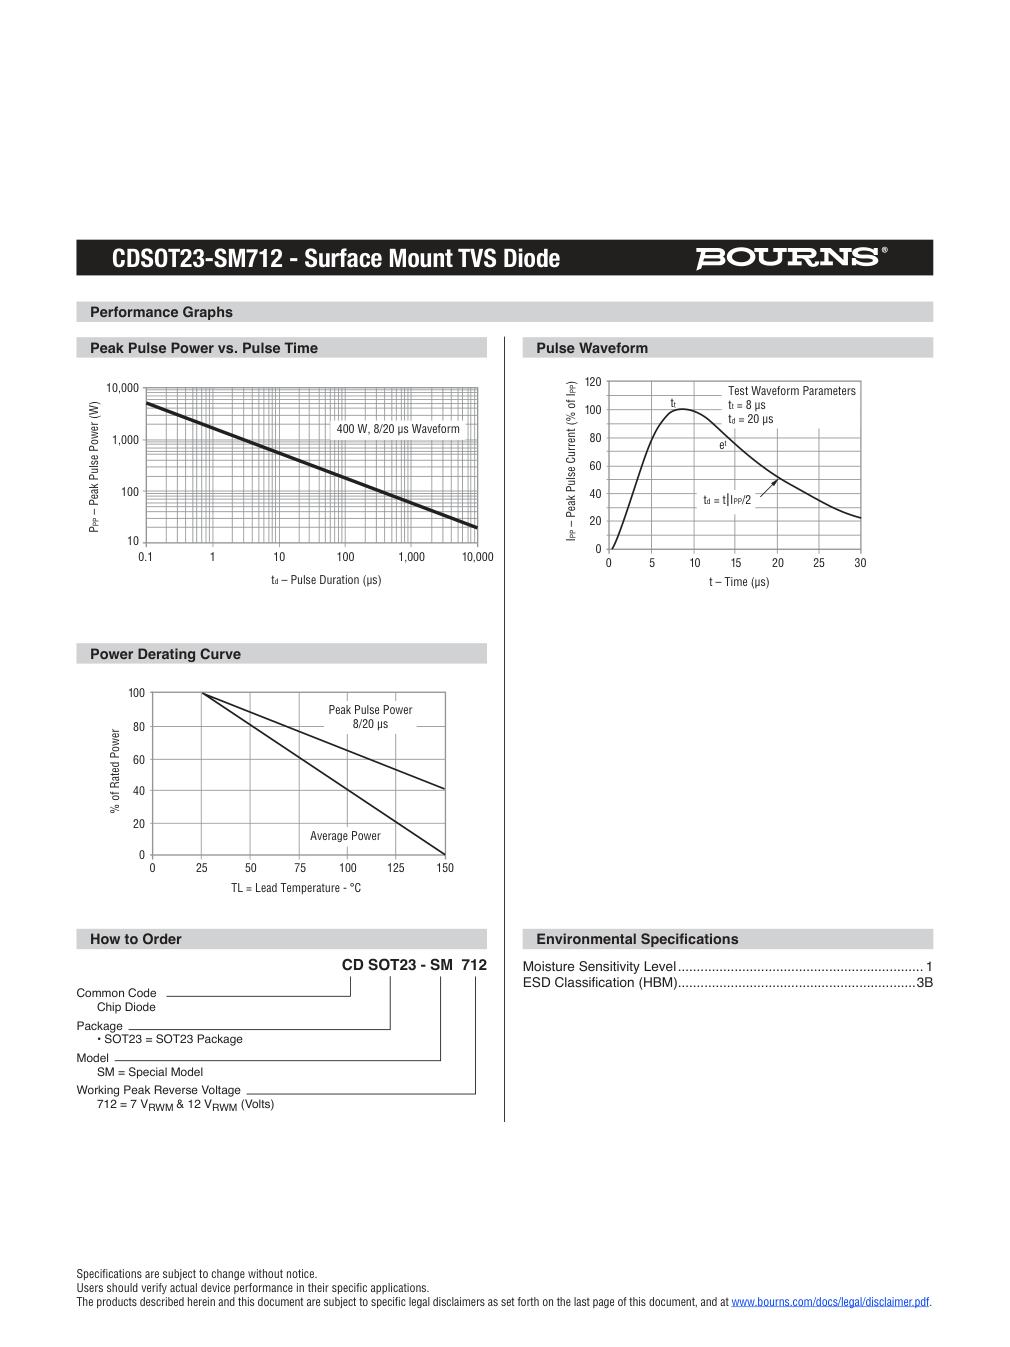
docs/hardware/evidence/electrical_closure/CDSOT23-SM712-p3.png
