anhenaobe/industrial-comunication-gateway/docs/hardware/evidence/electrical_closure/ethernet-evm-phy.png

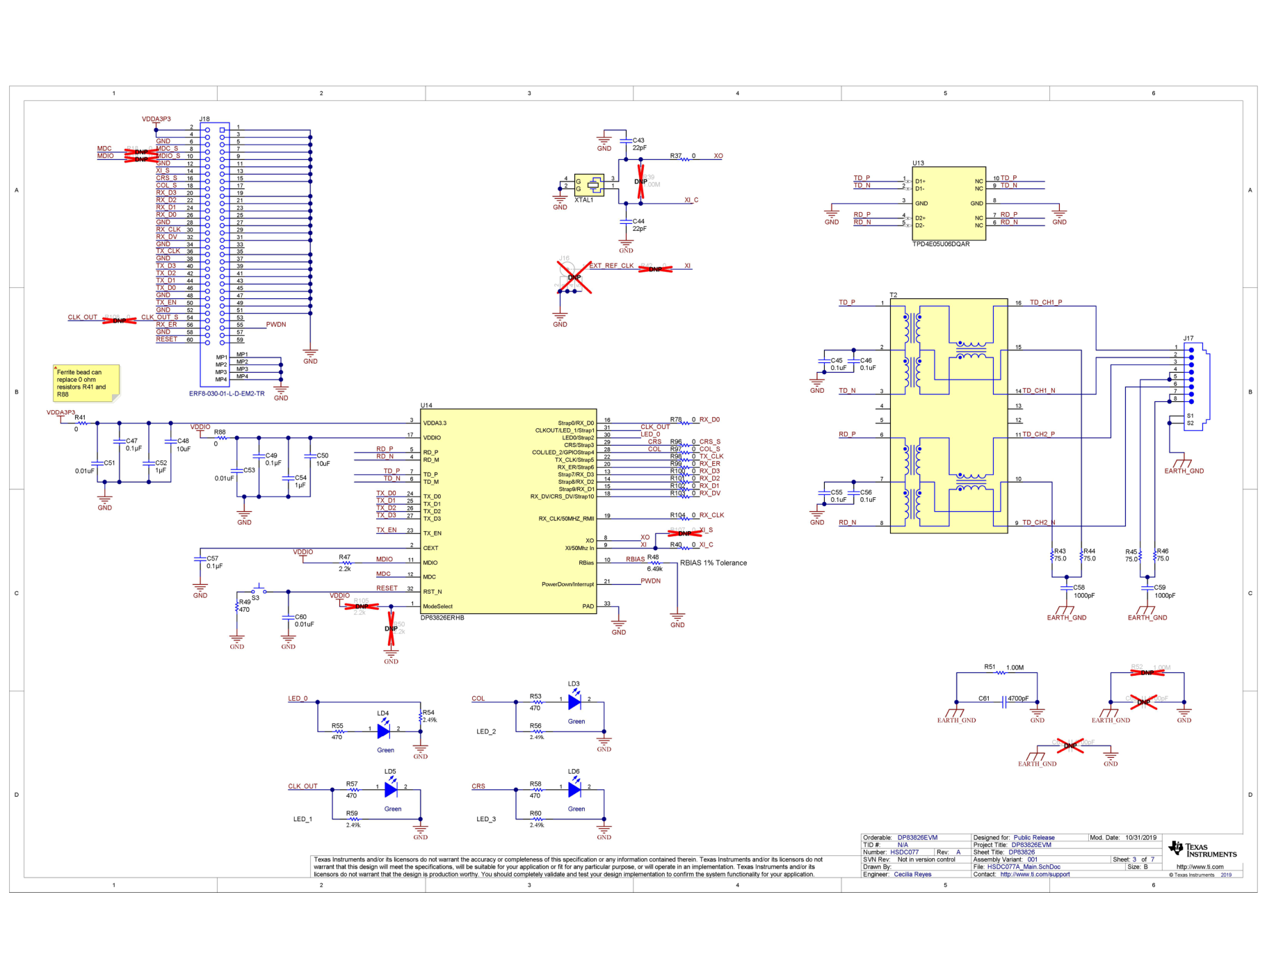
docs/hardware/evidence/electrical_closure/ethernet-evm-phy.png
