anhenaobe/industrial-comunication-gateway/docs/hardware/evidence/electrical_closure/ethernet-evm-reference.png

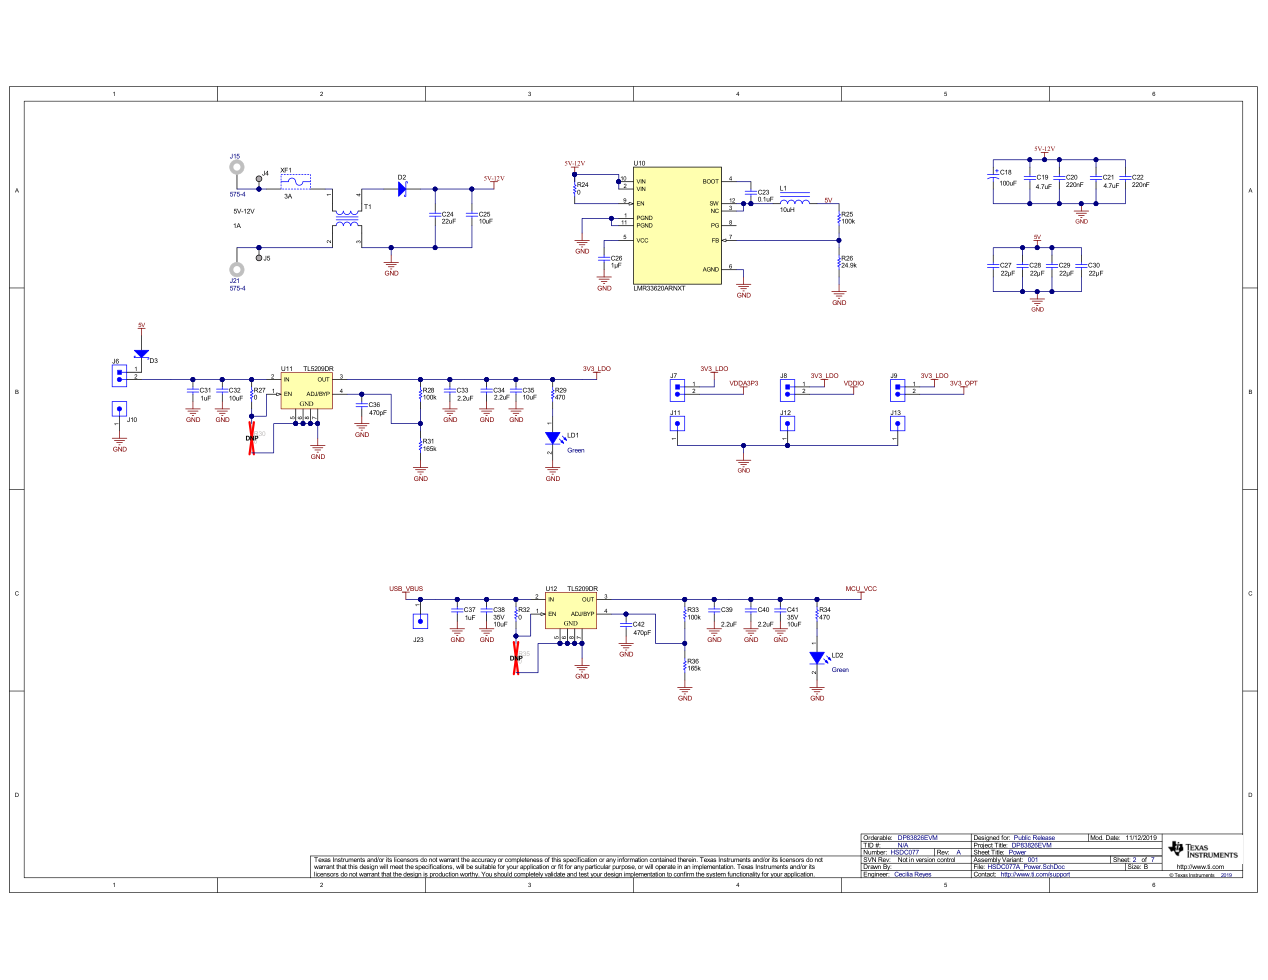
docs/hardware/evidence/electrical_closure/ethernet-evm-reference.png
