anhenaobe/industrial-comunication-gateway/docs/hardware/evidence/electrical_closure/Firstohm_MM-p2.png

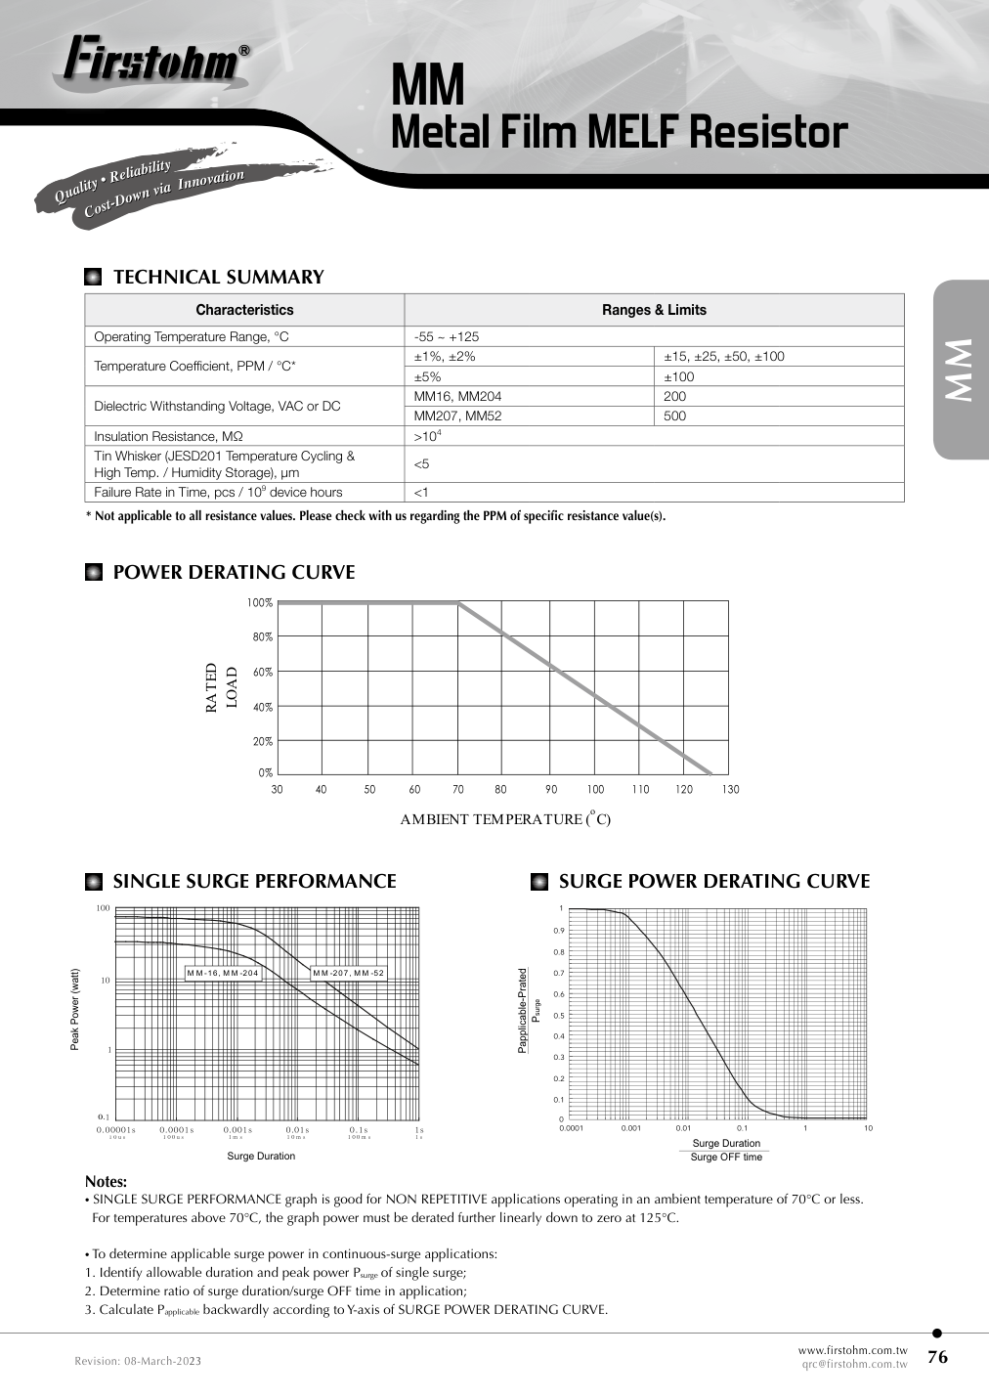
docs/hardware/evidence/electrical_closure/Firstohm_MM-p2.png
