anhenaobe/industrial-comunication-gateway/docs/hardware/evidence/electrical_closure/HX1188FNL-p1.png

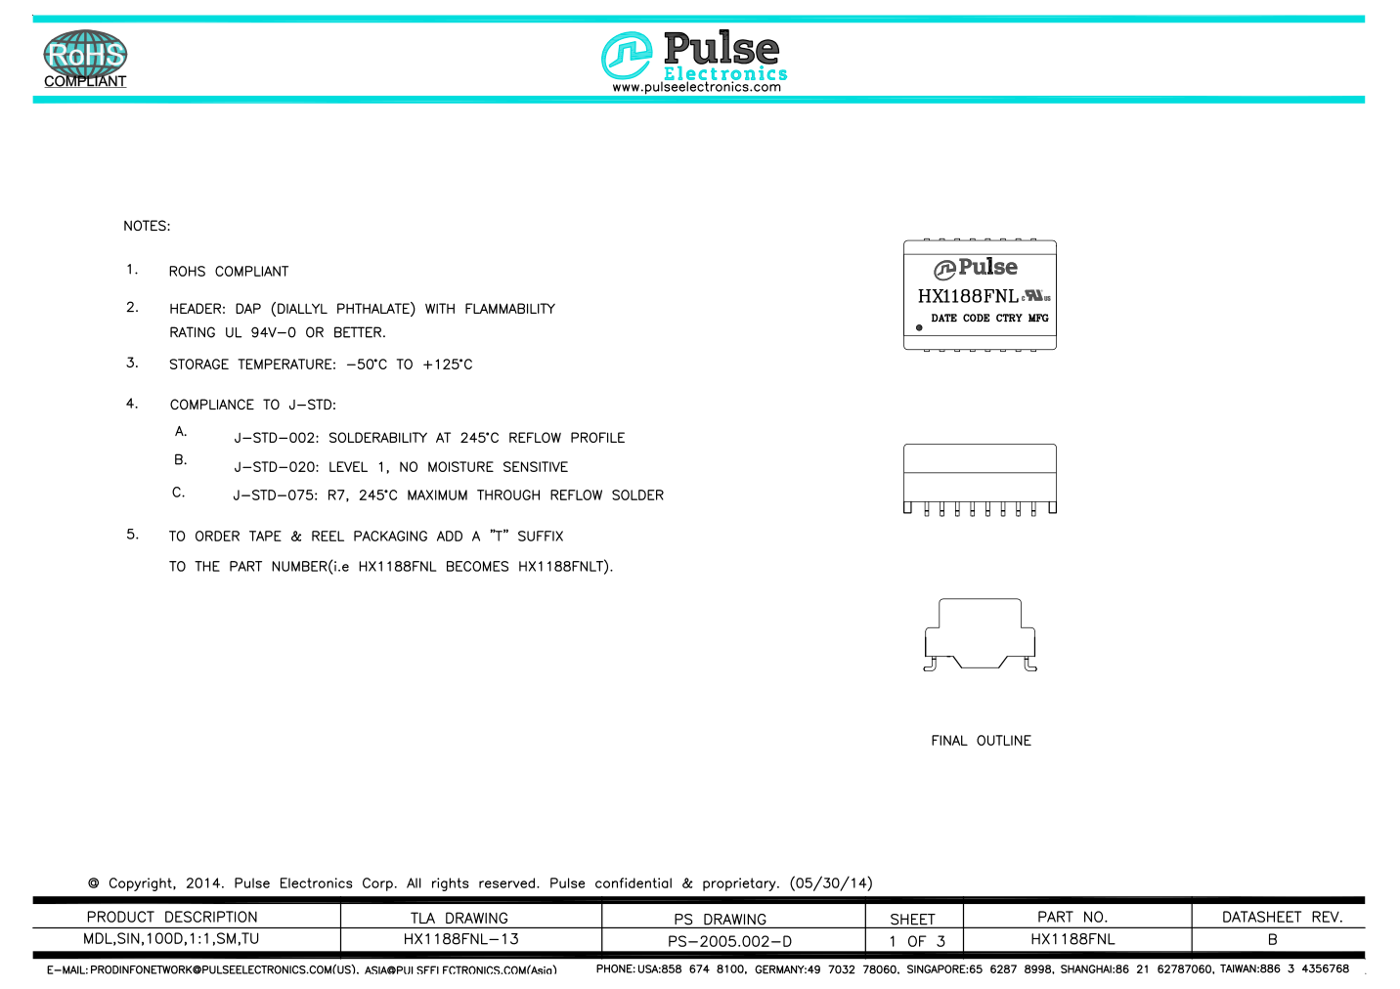
docs/hardware/evidence/electrical_closure/HX1188FNL-p1.png
