anhenaobe/industrial-comunication-gateway/docs/hardware/evidence/electrical_closure/rj45-hole-detail2.png

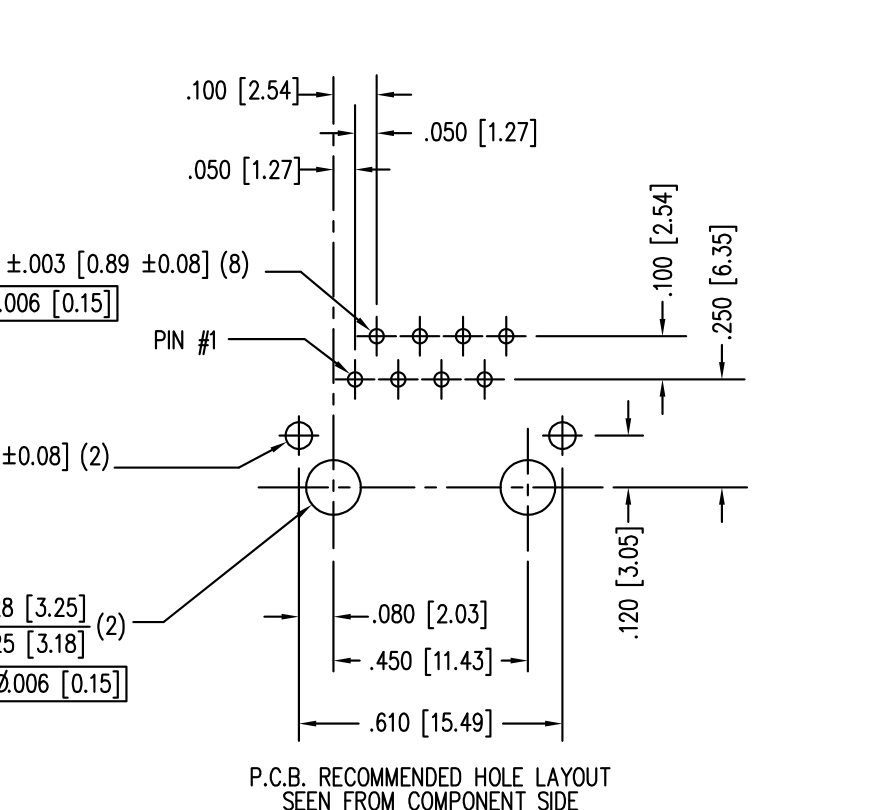
docs/hardware/evidence/electrical_closure/rj45-hole-detail2.png
