anhenaobe/industrial-comunication-gateway/docs/hardware/evidence/electrical_closure/rj45-hole-detail.png

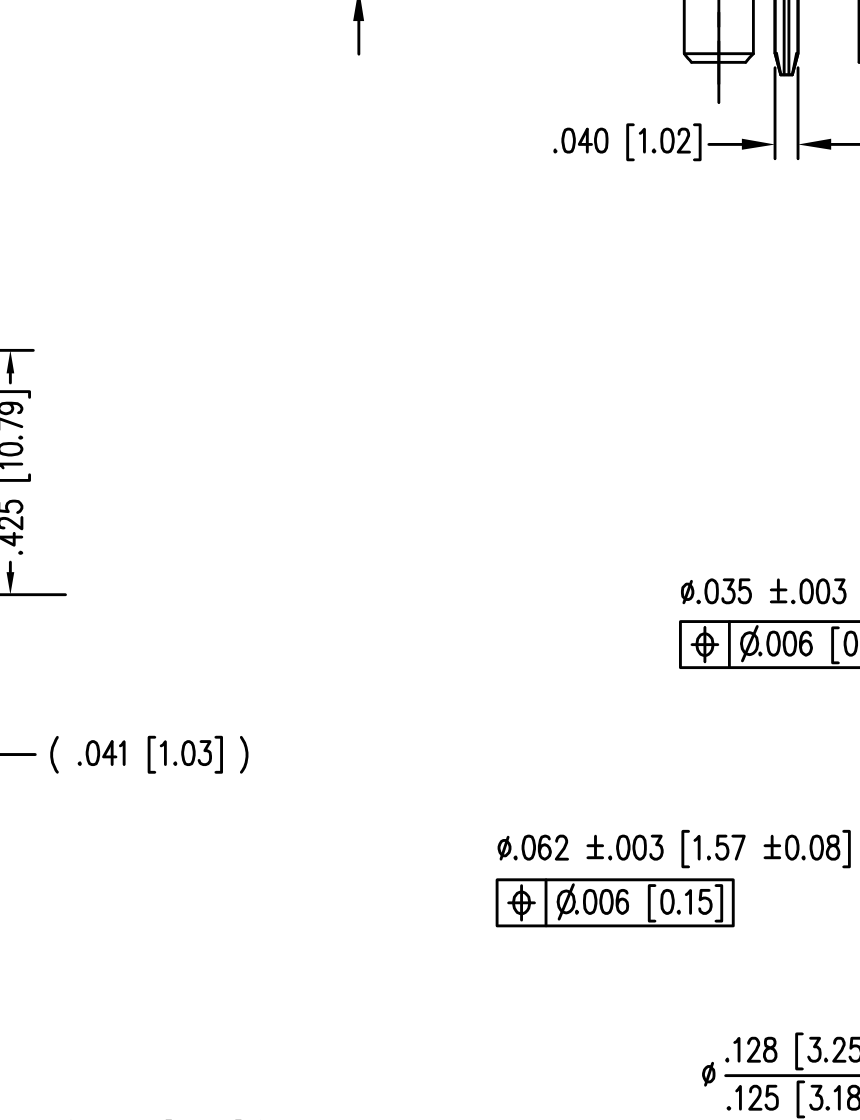
docs/hardware/evidence/electrical_closure/rj45-hole-detail.png
