anhenaobe/industrial-comunication-gateway/docs/hardware/evidence/electrical_closure/rs485-reference-p19.png

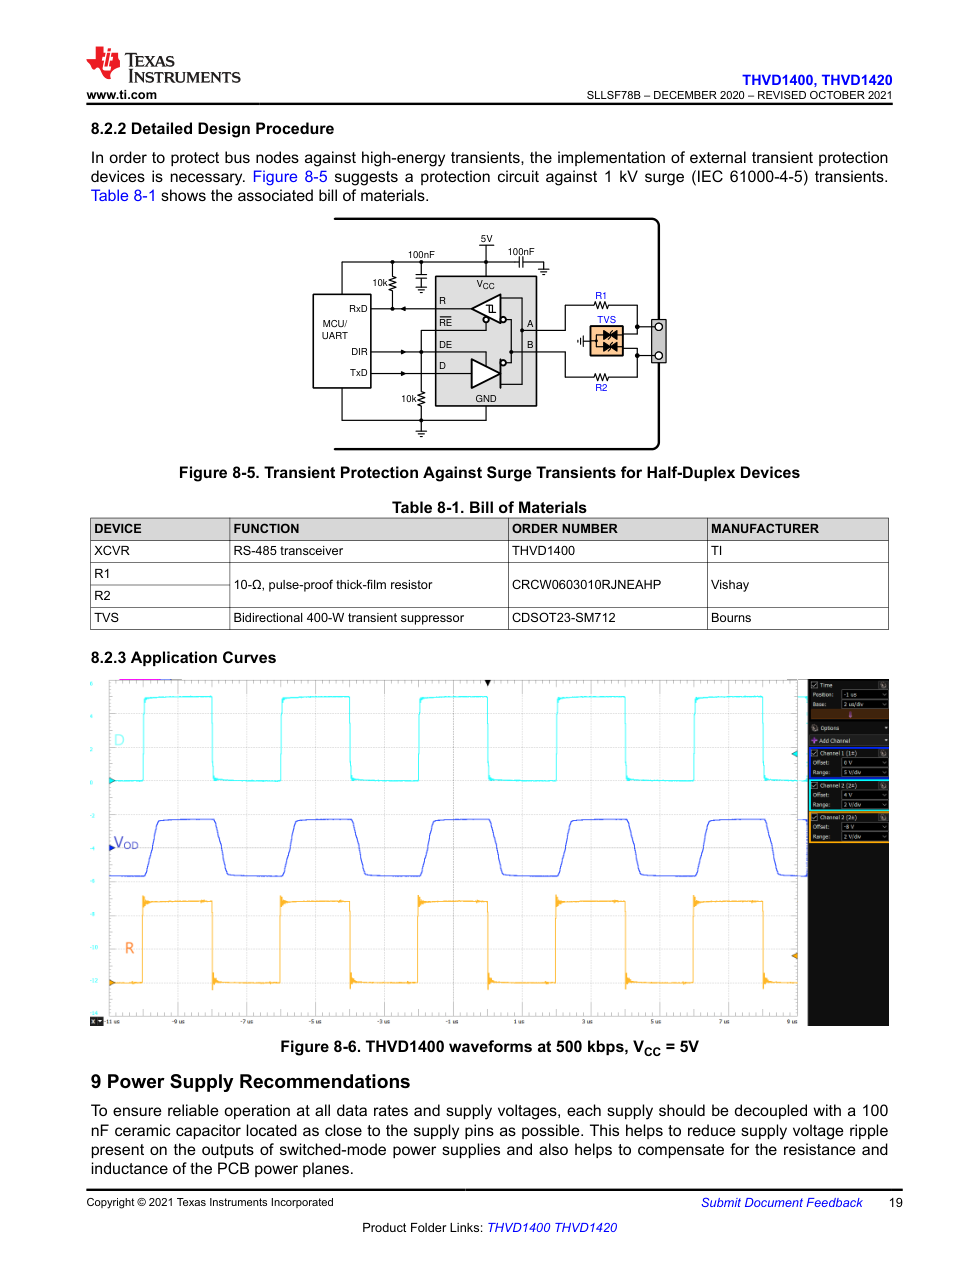
docs/hardware/evidence/electrical_closure/rs485-reference-p19.png
