anhenaobe/industrial-comunication-gateway/docs/hardware/evidence/electrical_closure/tpd4-p28.png

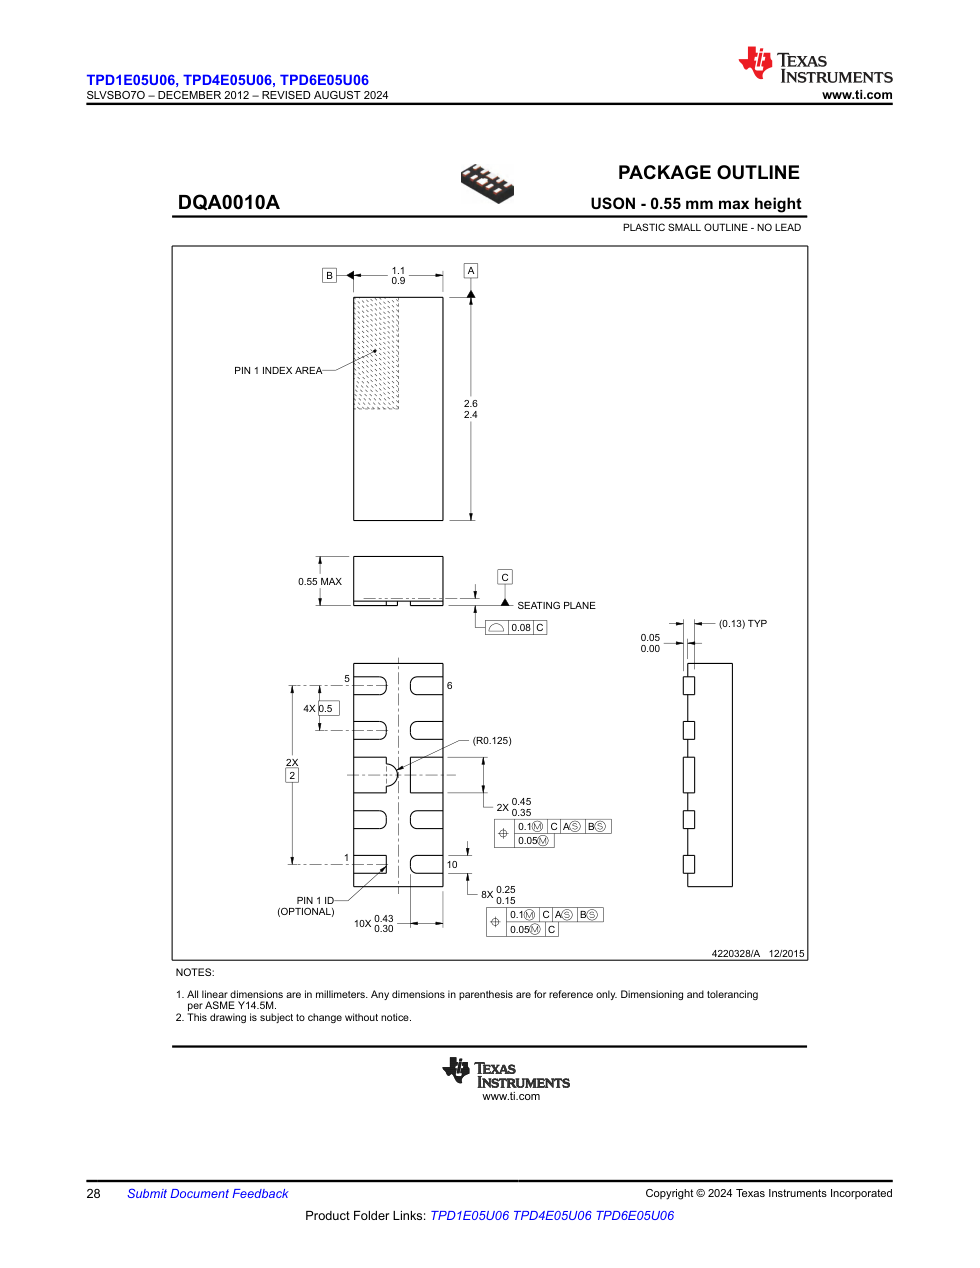
docs/hardware/evidence/electrical_closure/tpd4-p28.png
