anhenaobe/industrial-comunication-gateway/docs/hardware/evidence/ethernet_1nf/p4.png

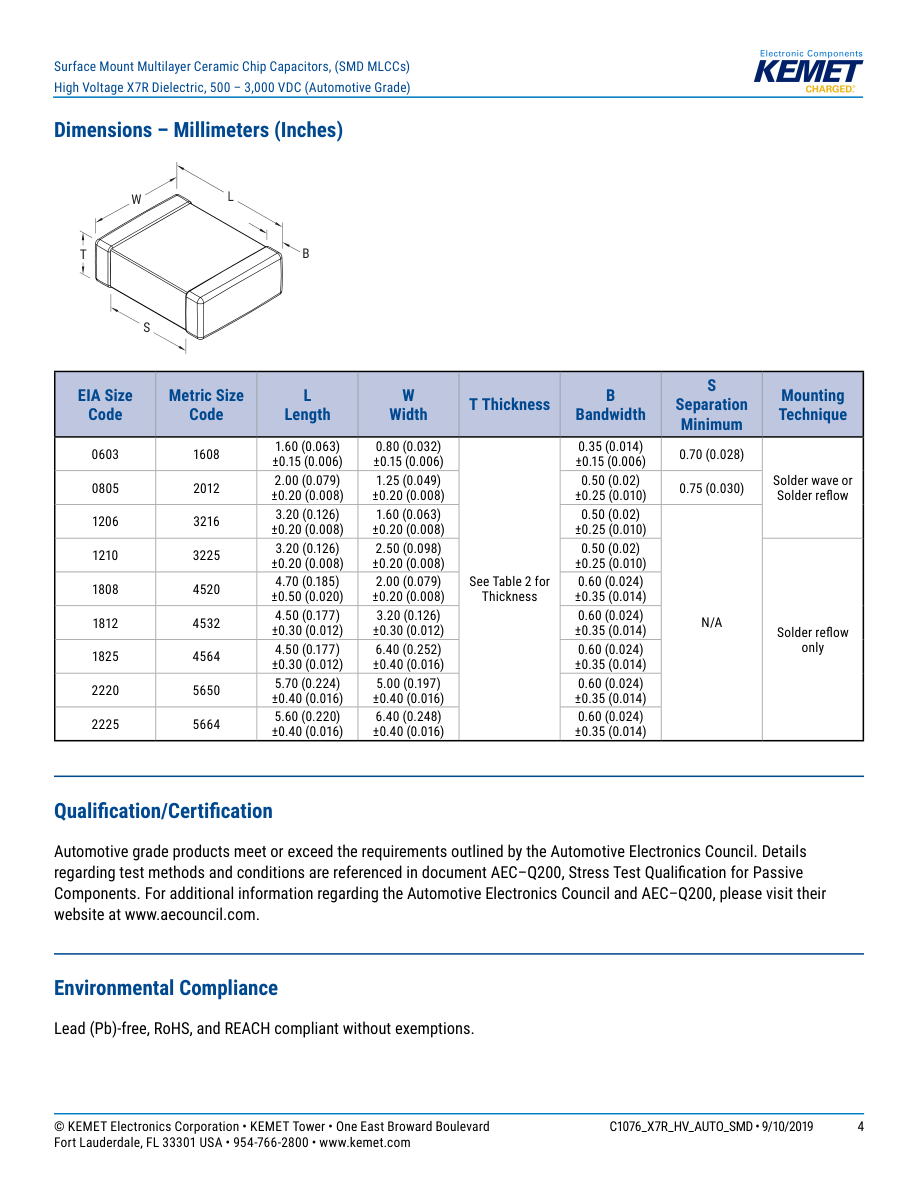
docs/hardware/evidence/ethernet_1nf/p4.png
