anhenaobe/industrial-comunication-gateway/docs/hardware/evidence/ethernet_1nf/p6.png

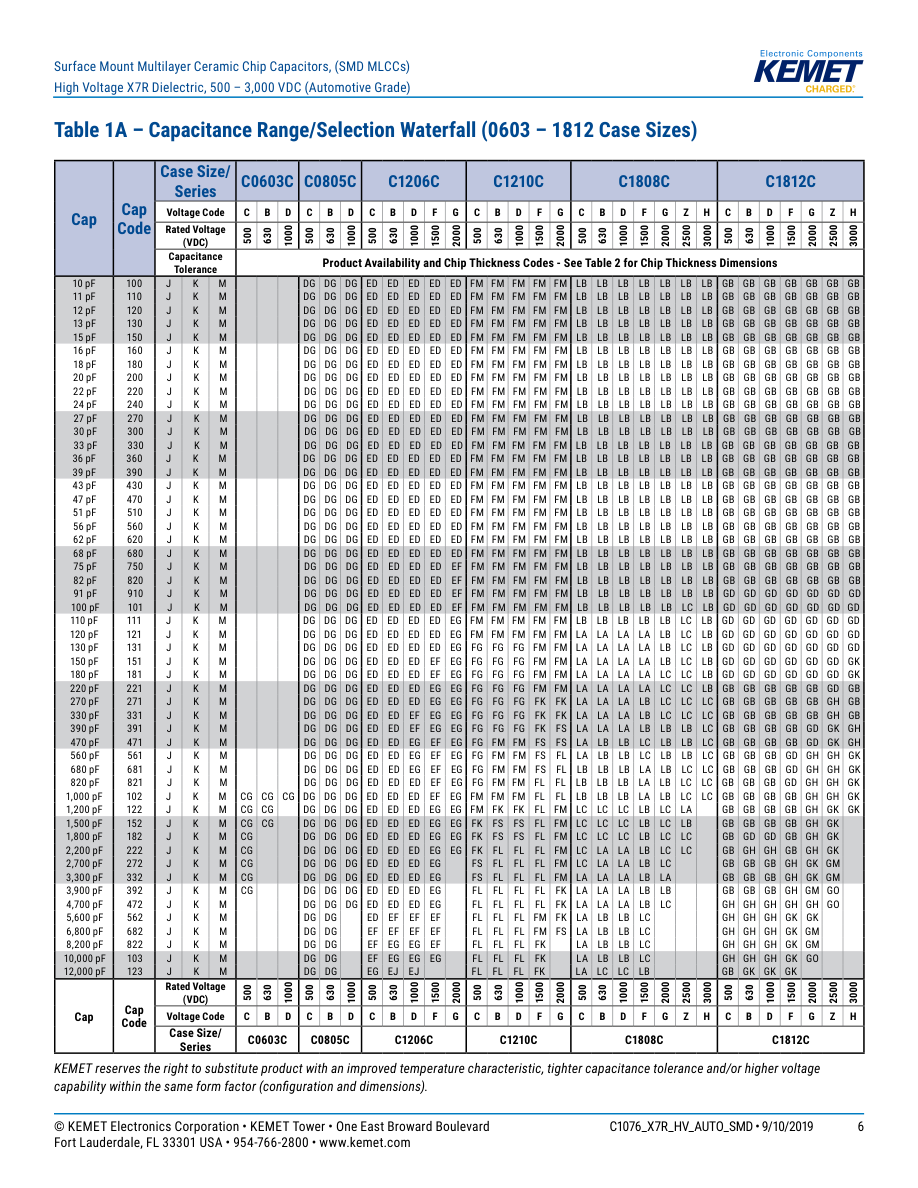
docs/hardware/evidence/ethernet_1nf/p6.png
