anhenaobe/industrial-comunication-gateway/docs/hardware/evidence/ethernet_1nf/p7.png

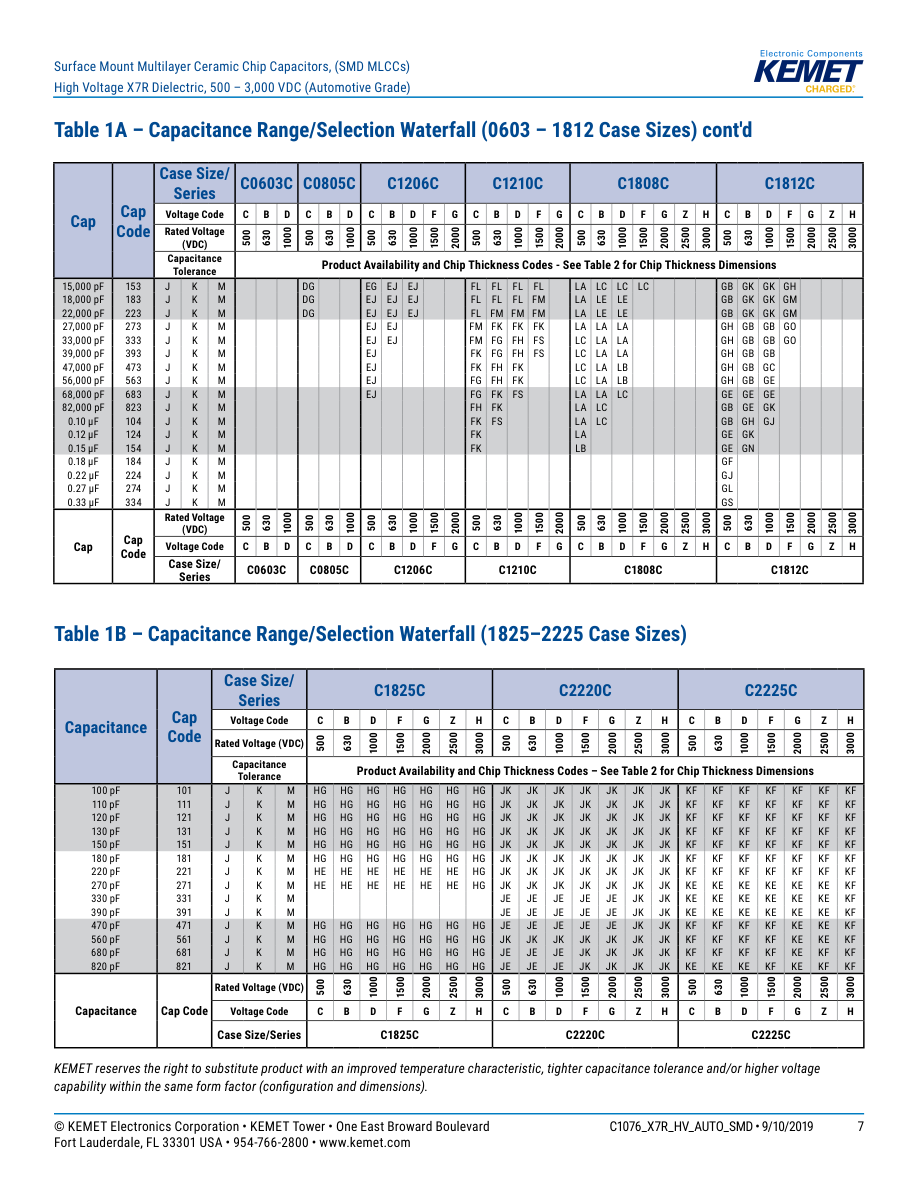
docs/hardware/evidence/ethernet_1nf/p7.png
