anhenaobe/industrial-comunication-gateway/docs/hardware/evidence/ethernet_1nf/p8.png

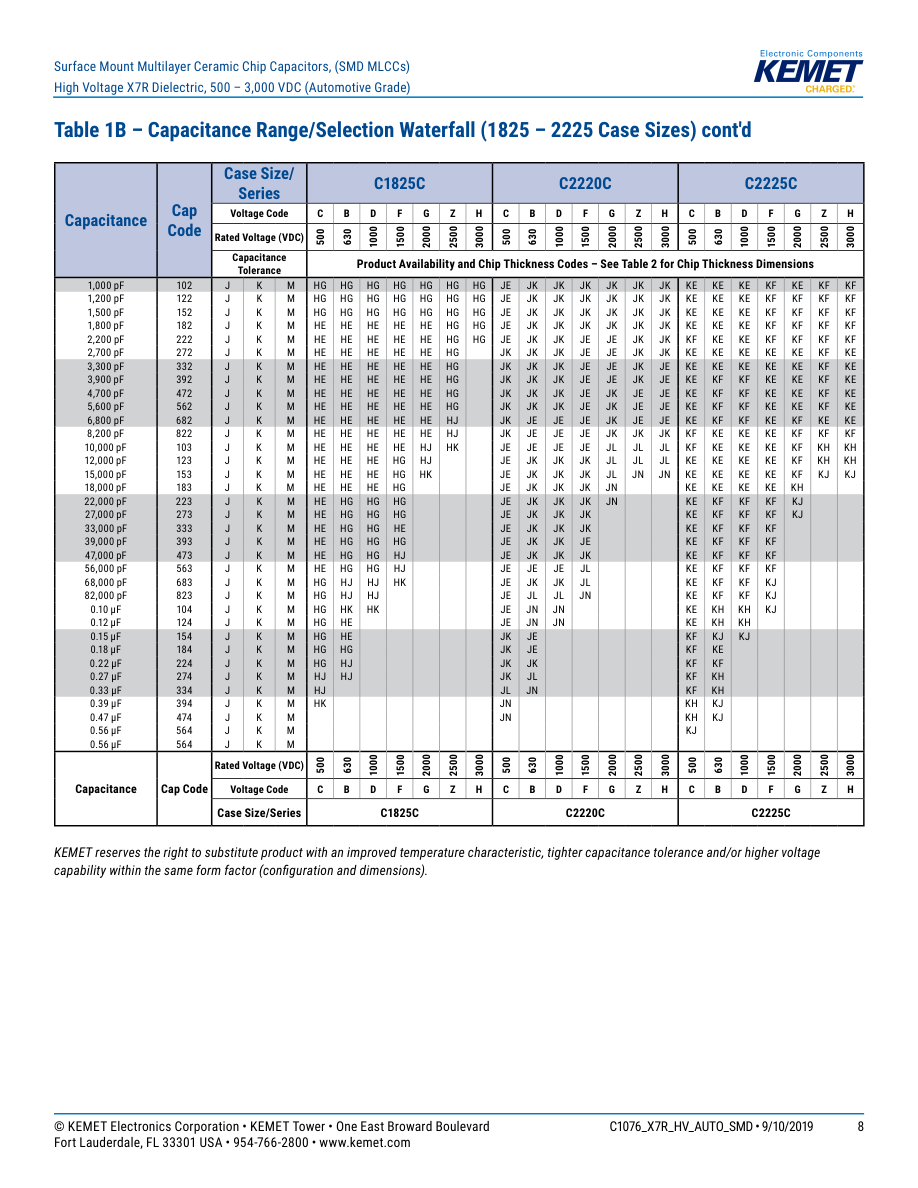
docs/hardware/evidence/ethernet_1nf/p8.png
