anhenaobe/industrial-comunication-gateway/docs/hardware/evidence/ethernet_1nf/p9.png

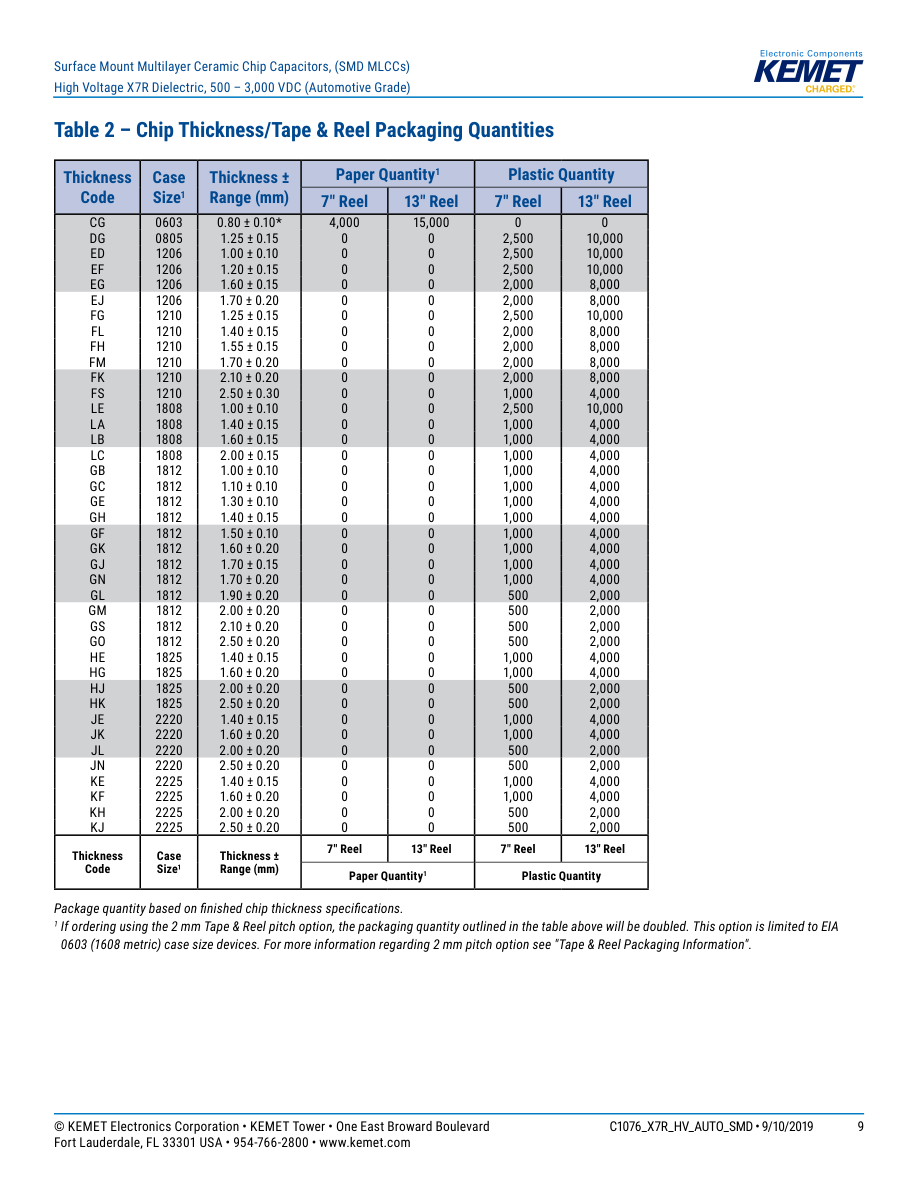
docs/hardware/evidence/ethernet_1nf/p9.png
