anhenaobe/industrial-comunication-gateway/docs/hardware/evidence/ethernet_1nf/p10.png

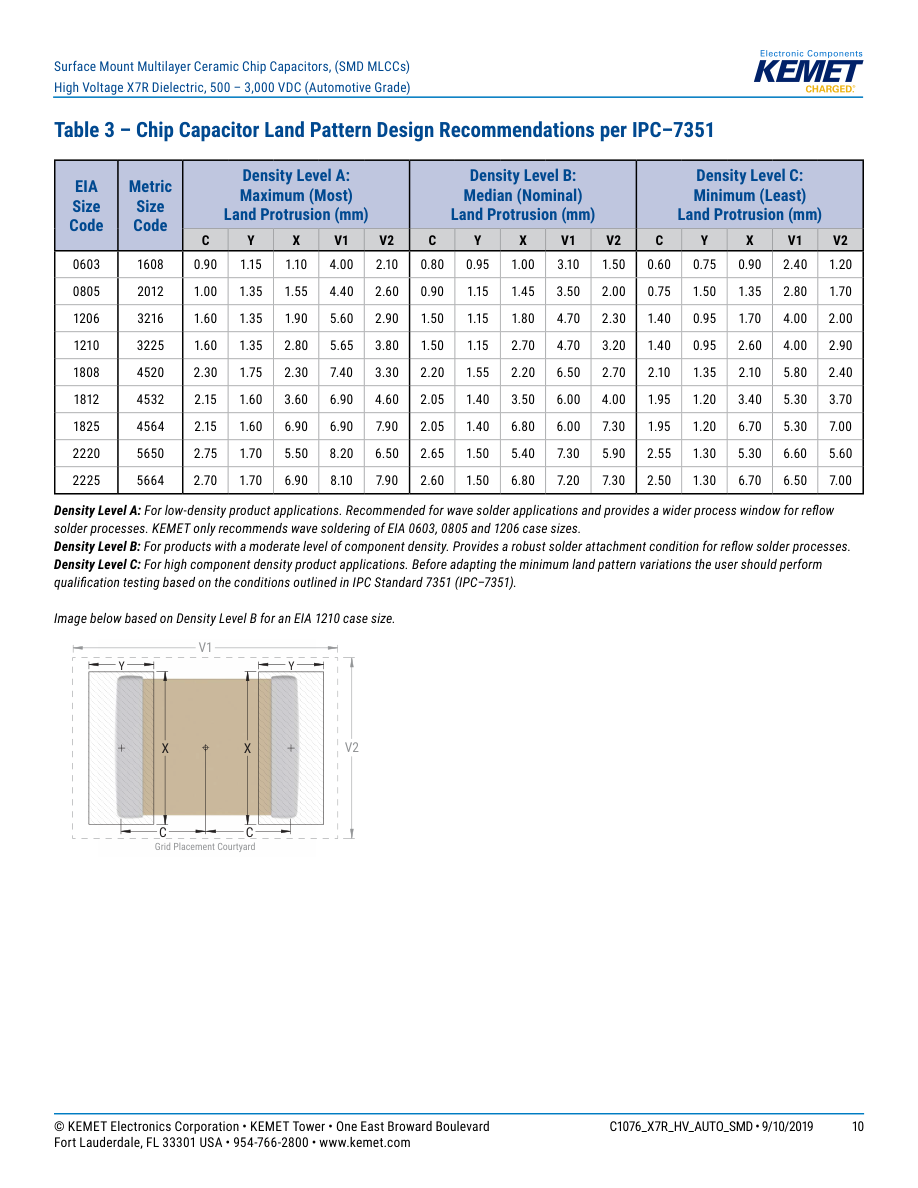
docs/hardware/evidence/ethernet_1nf/p10.png
