anhenaobe/industrial-comunication-gateway/docs/hardware/evidence/ethernet_75ohm/vishay_p9.png

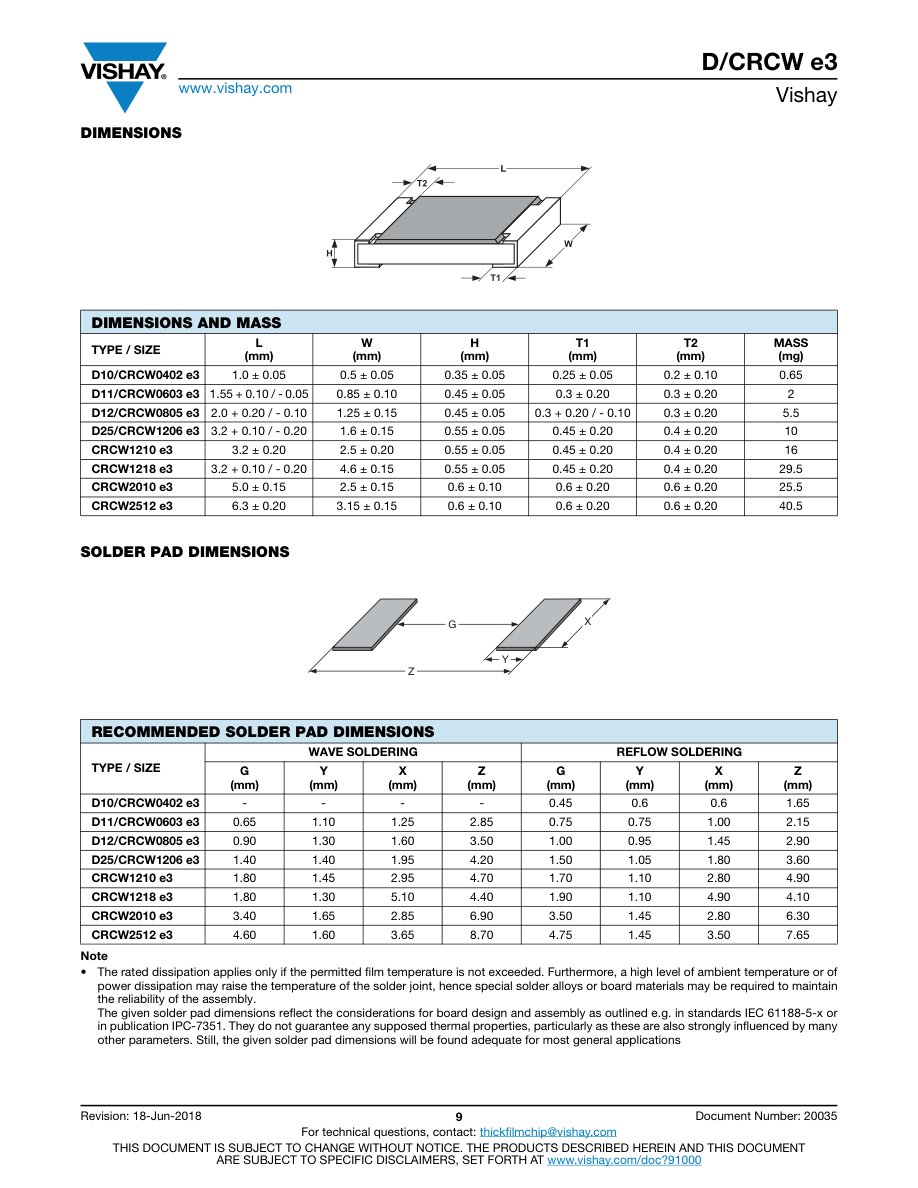
docs/hardware/evidence/ethernet_75ohm/vishay_p9.png
