anhenaobe/industrial-comunication-gateway/docs/hardware/evidence/input_protection/DMP6023LSS.pdf-p1.png

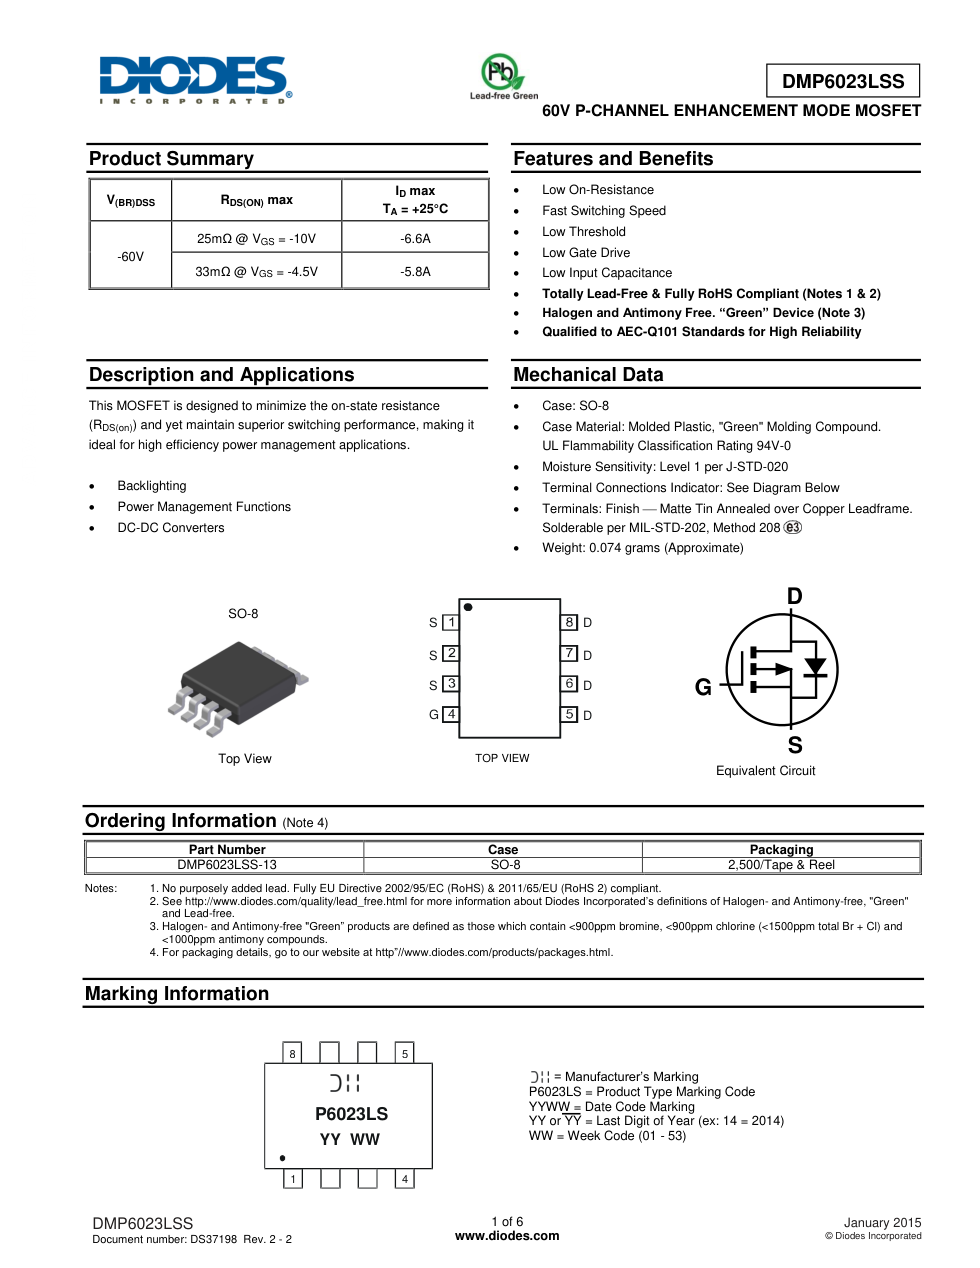
docs/hardware/evidence/input_protection/DMP6023LSS.pdf-p1.png
