anhenaobe/industrial-comunication-gateway/docs/hardware/evidence/input_protection/NIS3071-D.PDF-p1.png

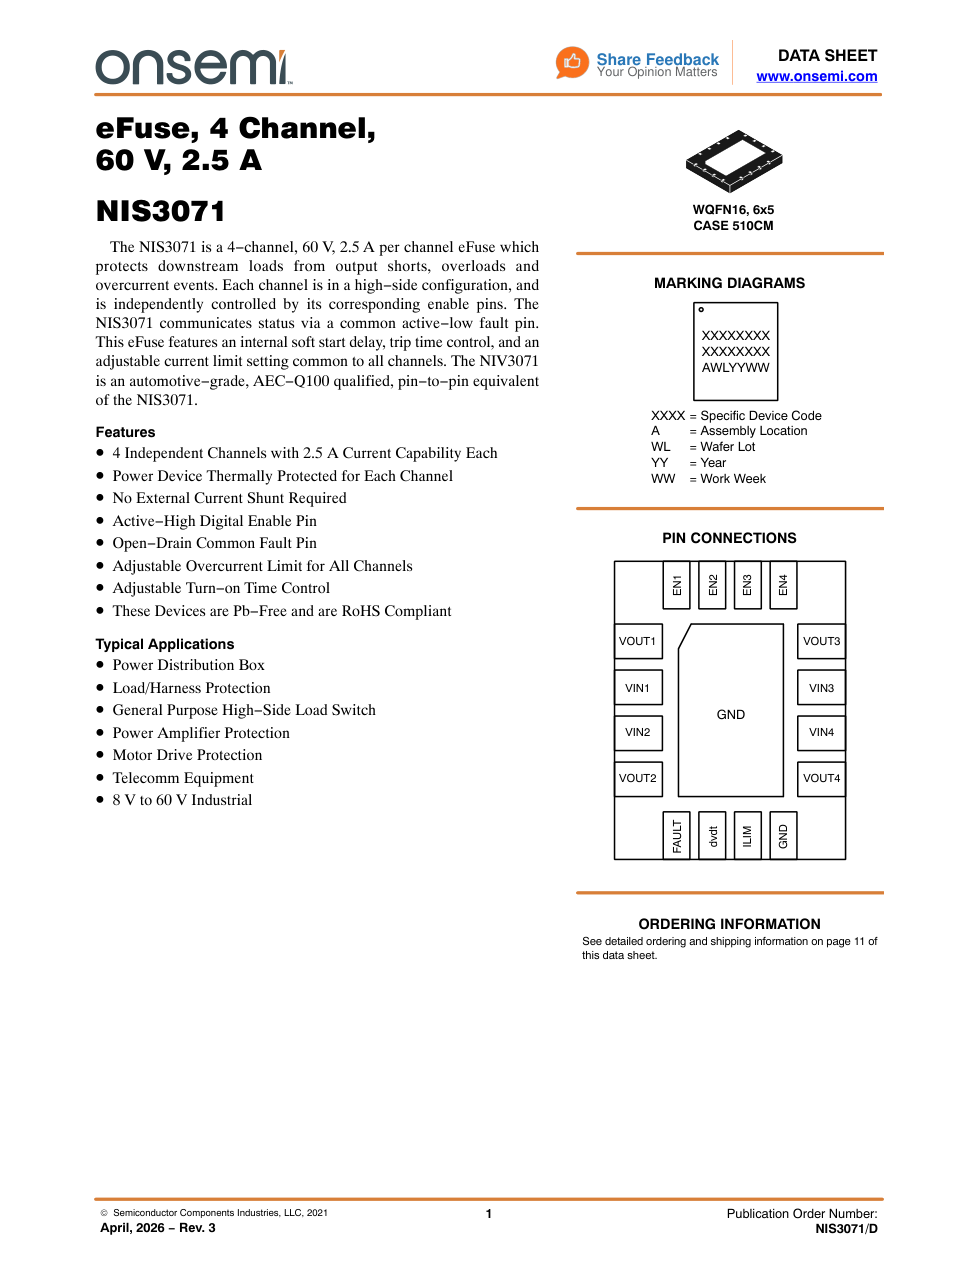
docs/hardware/evidence/input_protection/NIS3071-D.PDF-p1.png
