anhenaobe/industrial-comunication-gateway/docs/hardware/evidence/input_protection/NIS3071-D.PDF-p6.png

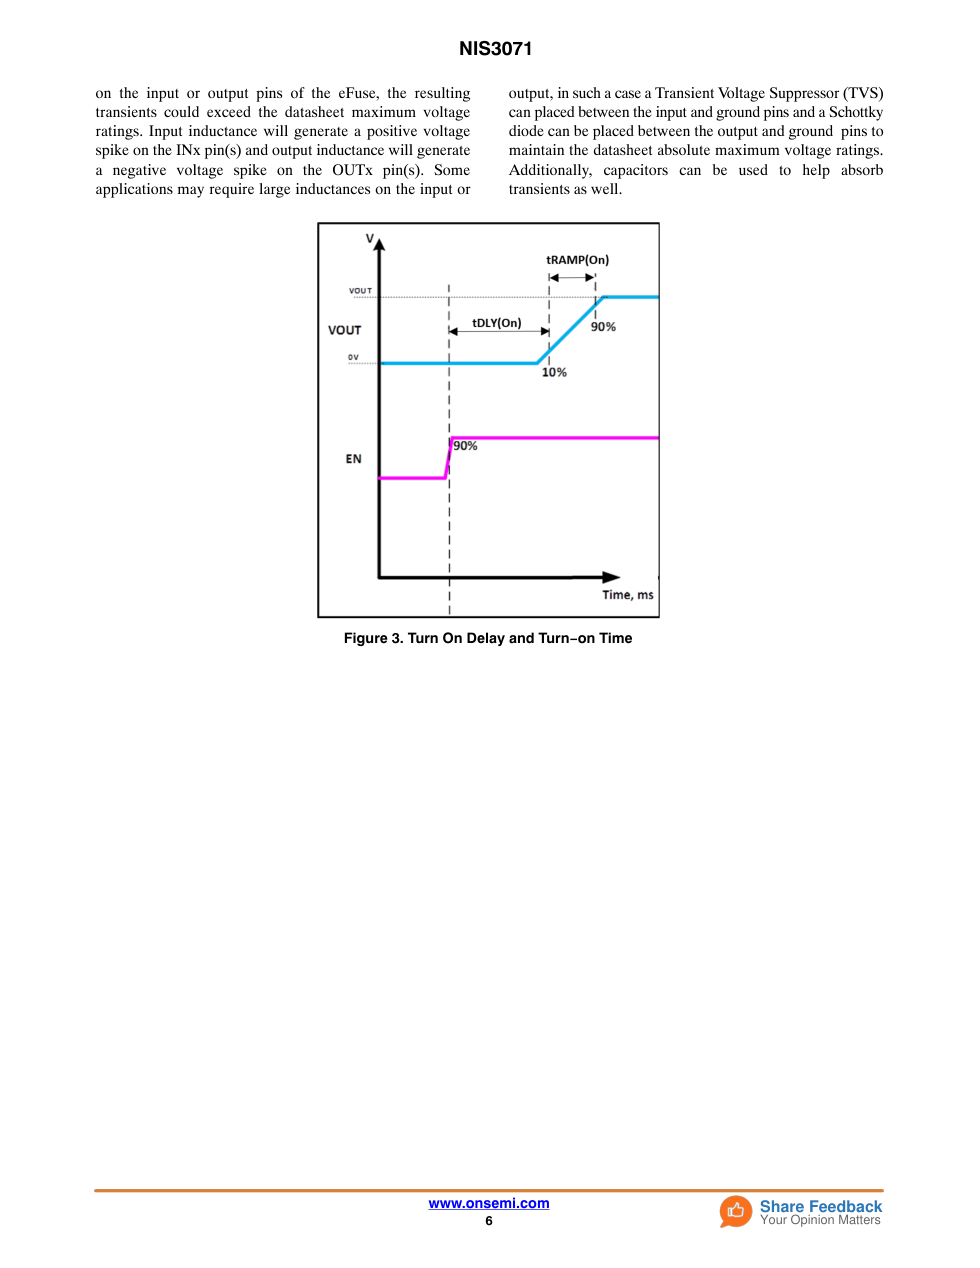
docs/hardware/evidence/input_protection/NIS3071-D.PDF-p6.png
