anhenaobe/industrial-comunication-gateway/docs/hardware/evidence/input_protection/nis_mount_detail.png

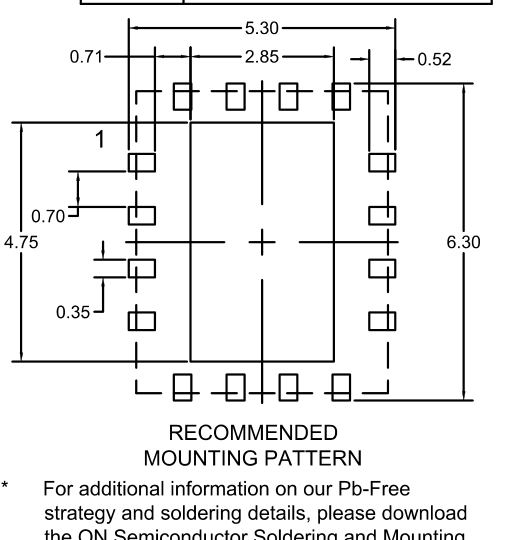
docs/hardware/evidence/input_protection/nis_mount_detail.png
