anhenaobe/industrial-comunication-gateway/docs/hardware/evidence/input_protection/ss3_p1.png

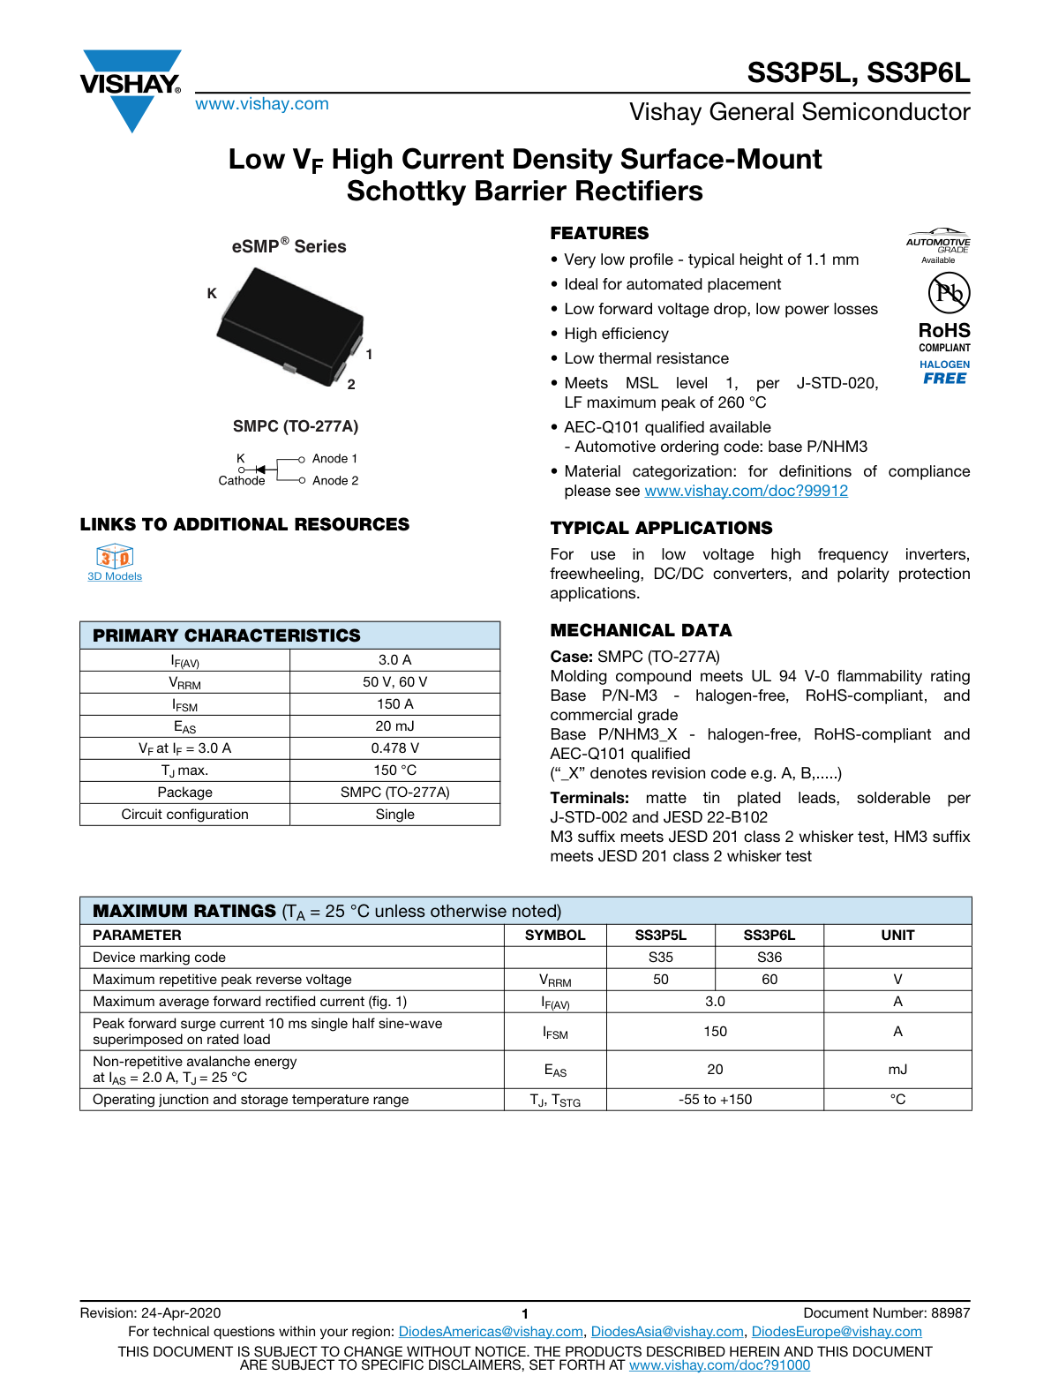
docs/hardware/evidence/input_protection/ss3_p1.png
