anhenaobe/industrial-comunication-gateway/docs/hardware/evidence/input_protection/ss3_p_land.png

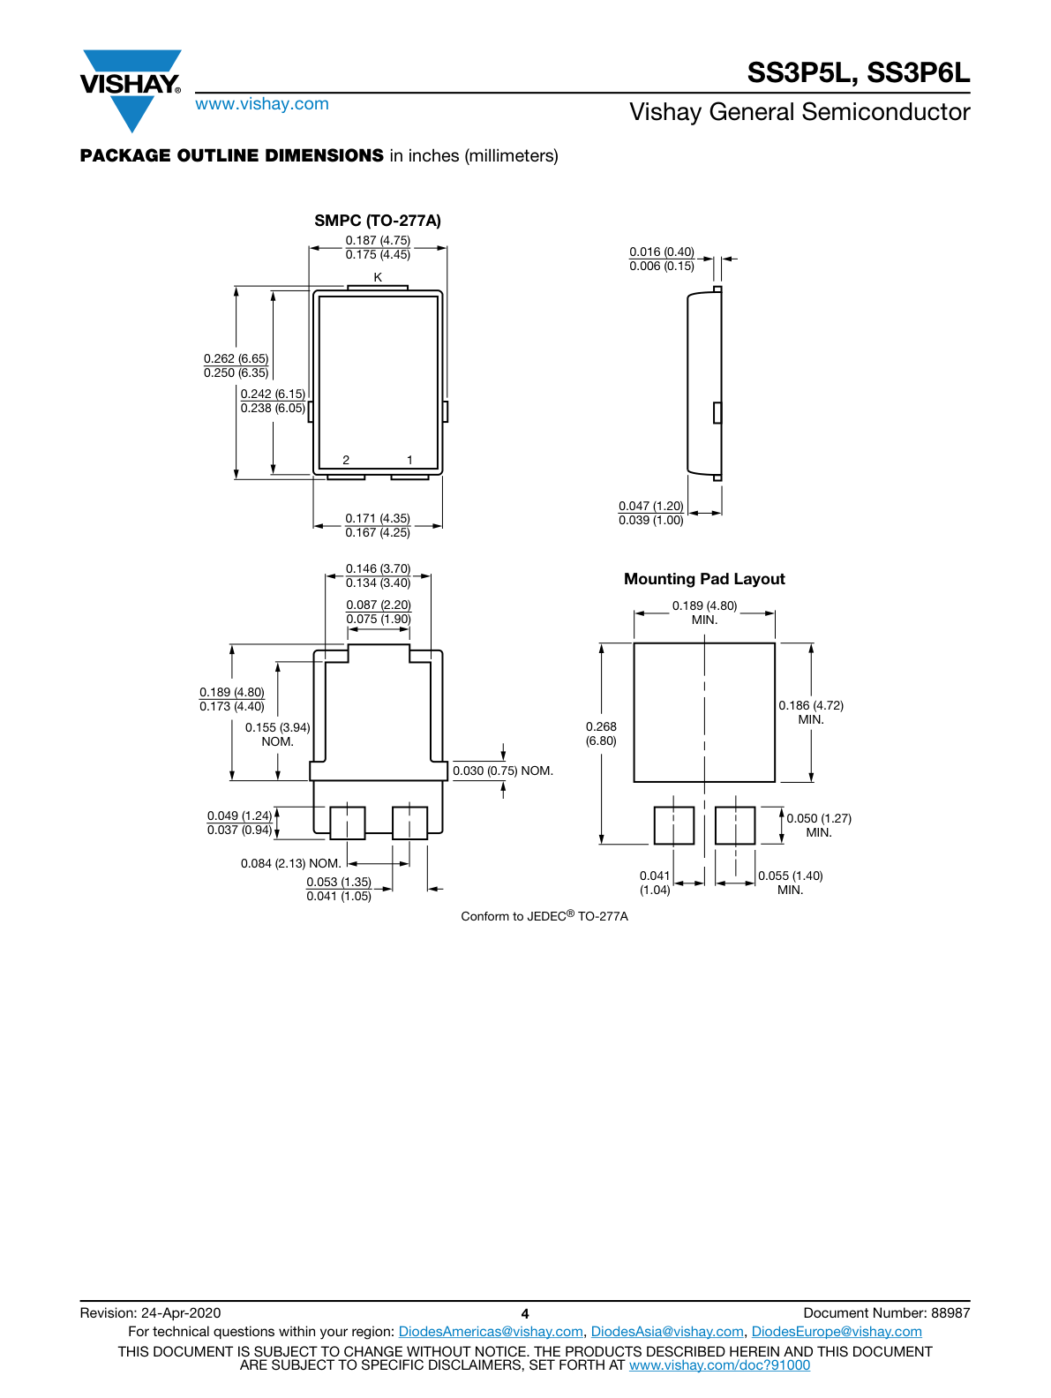
docs/hardware/evidence/input_protection/ss3_p_land.png
