anhenaobe/industrial-comunication-gateway/docs/hardware/evidence/input_protection/TDS3011P.pdf-p1.png

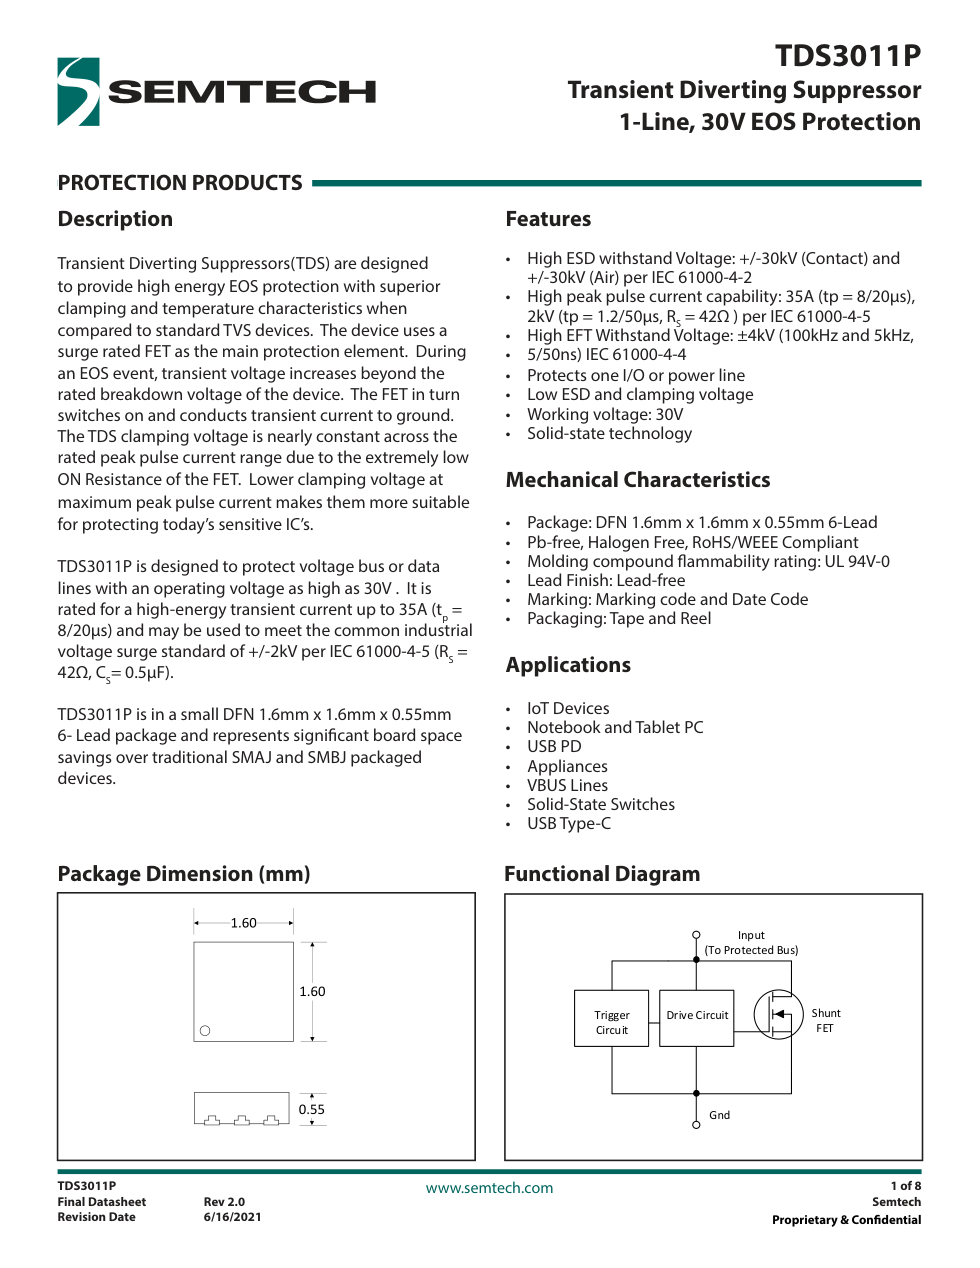
docs/hardware/evidence/input_protection/TDS3011P.pdf-p1.png
