anhenaobe/industrial-comunication-gateway/docs/hardware/evidence/input_protection/TDS3011P.pdf-p4.png

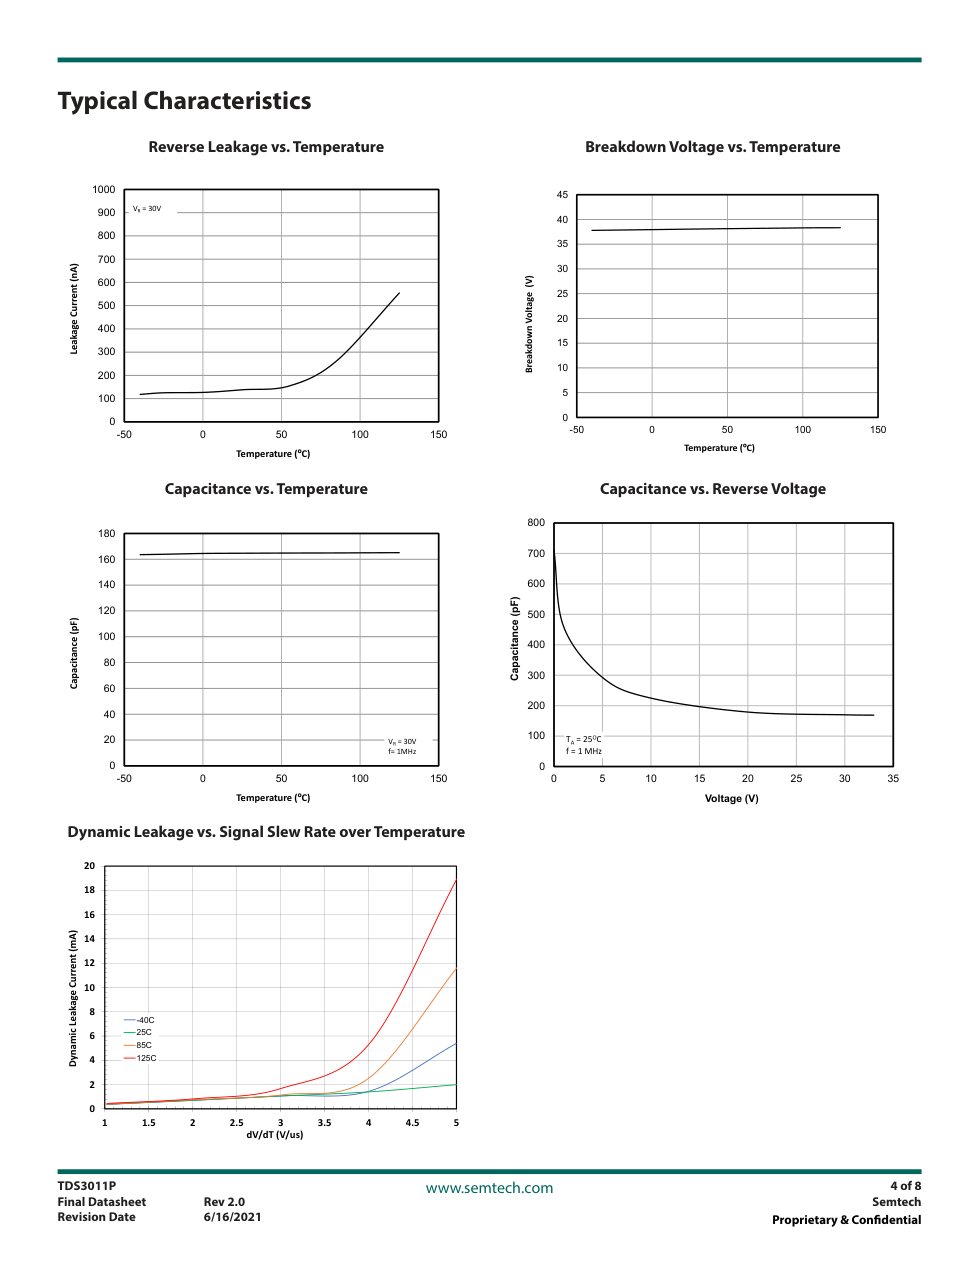
docs/hardware/evidence/input_protection/TDS3011P.pdf-p4.png
