anhenaobe/industrial-comunication-gateway/docs/hardware/evidence/input_protection/TDS3011P.pdf-p5.png

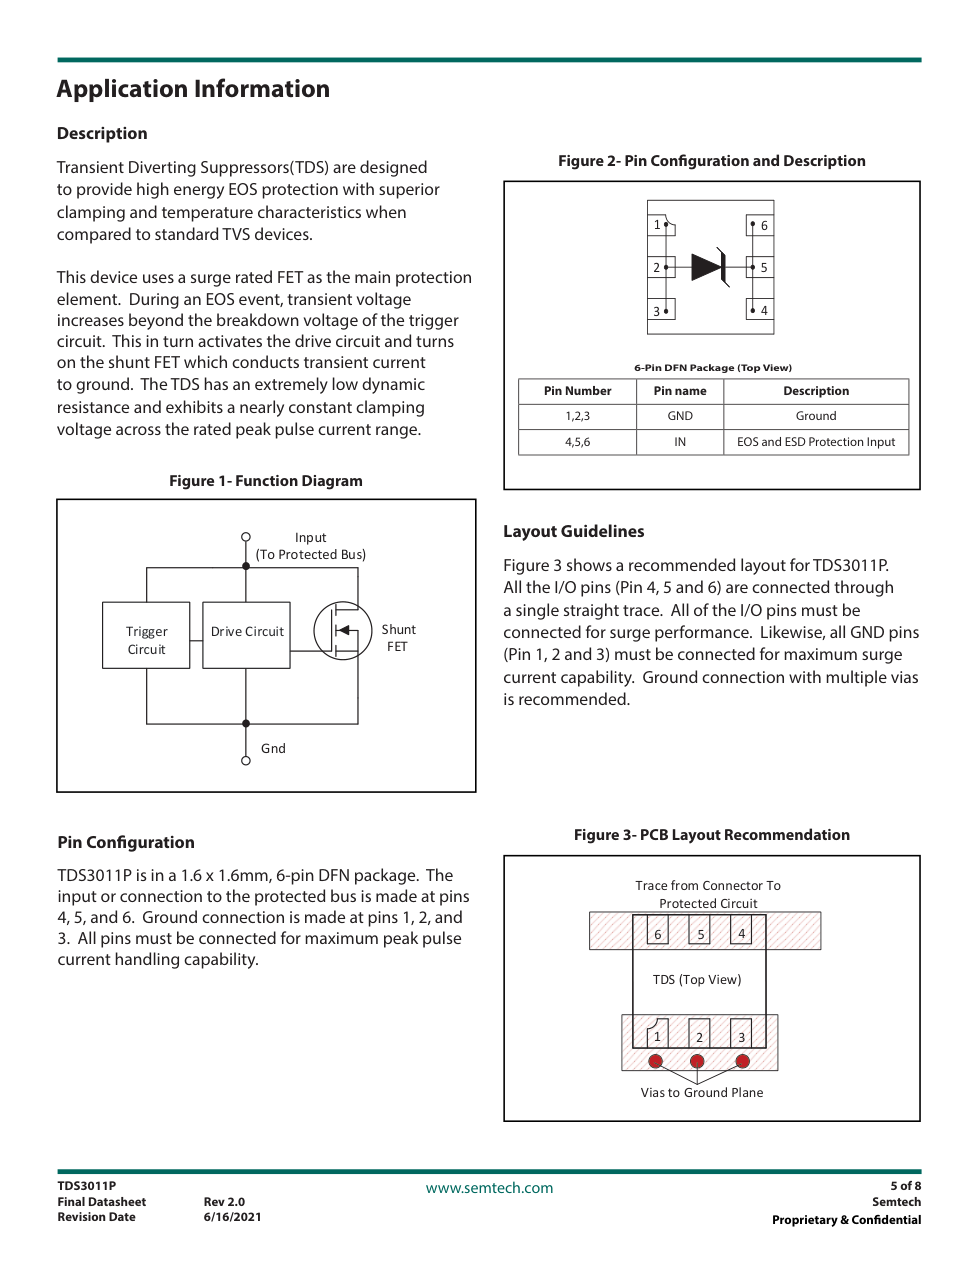
docs/hardware/evidence/input_protection/TDS3011P.pdf-p5.png
