anhenaobe/industrial-comunication-gateway/docs/hardware/evidence/input_protection_final_review/AND90248-p3.png

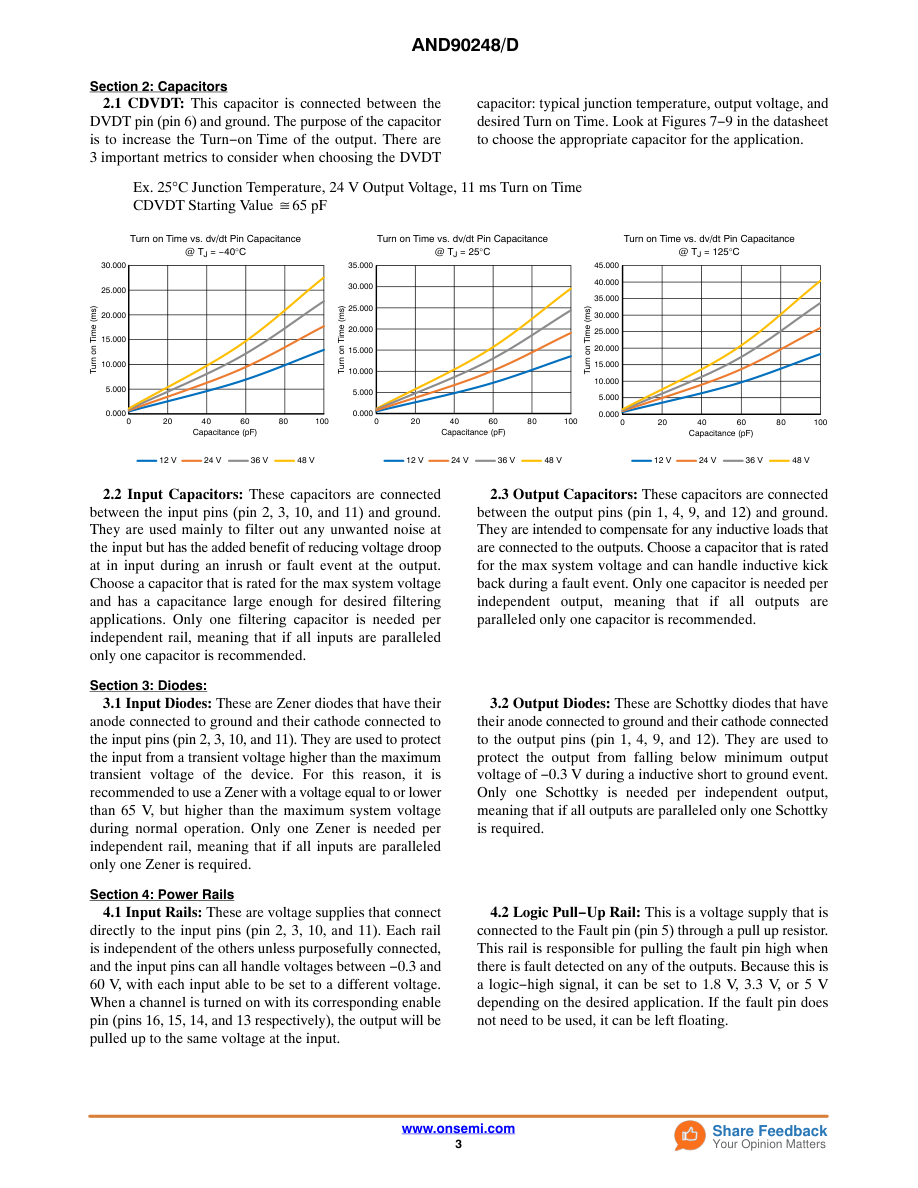
docs/hardware/evidence/input_protection_final_review/AND90248-p3.png
