anhenaobe/industrial-comunication-gateway/docs/hardware/evidence/input_protection_final_review/nis_dvdt.png

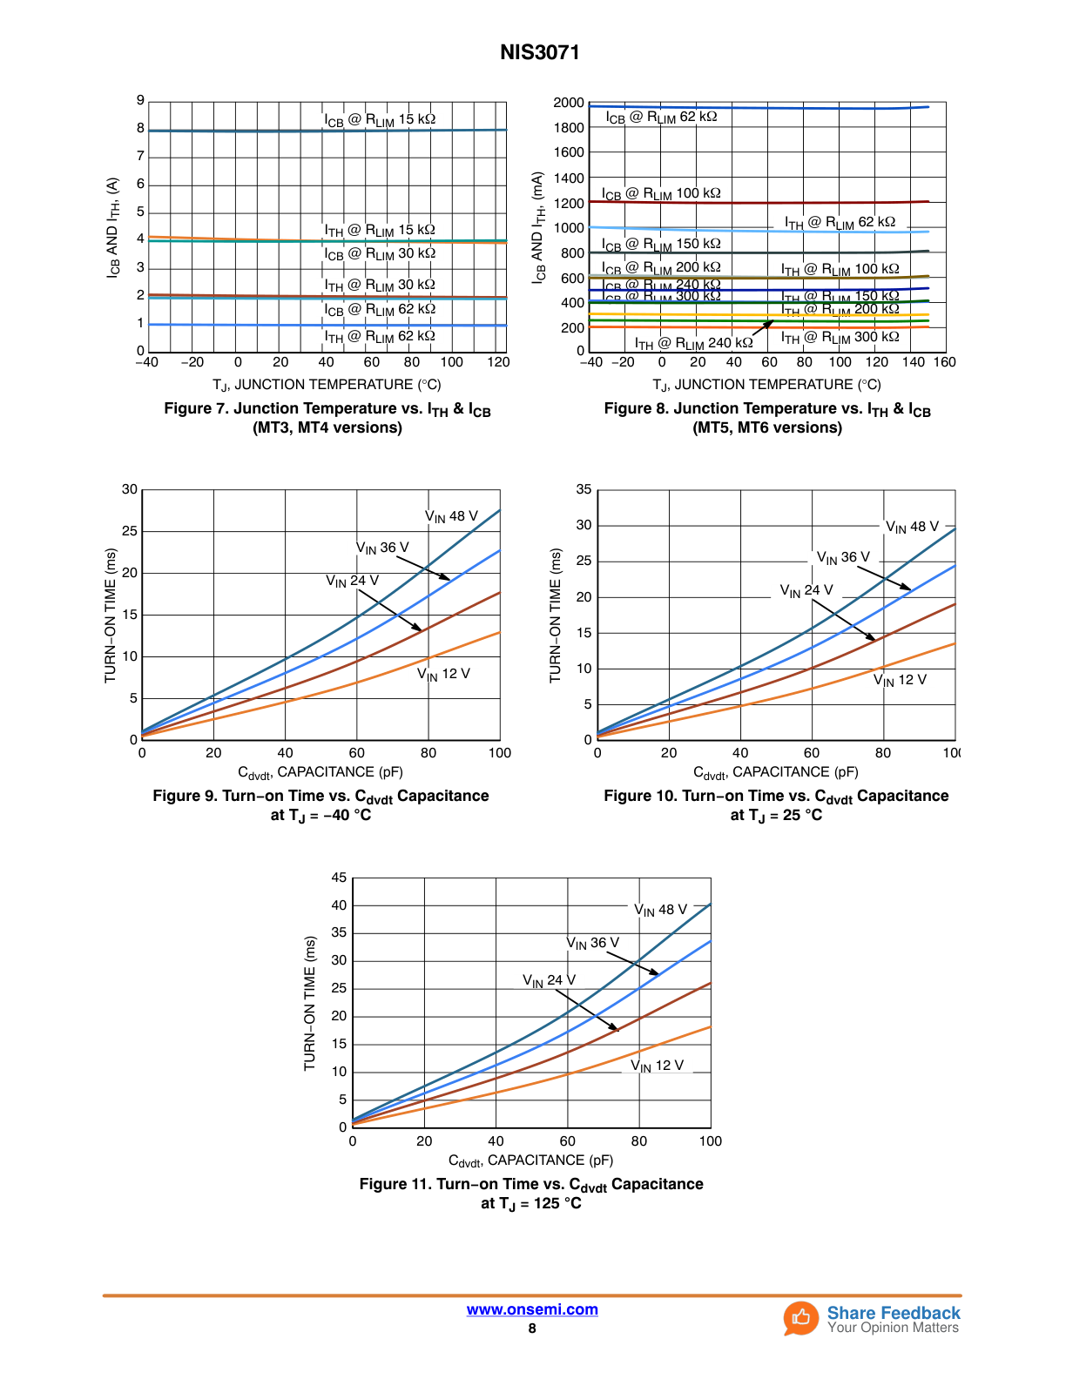
docs/hardware/evidence/input_protection_final_review/nis_dvdt.png
