anhenaobe/industrial-comunication-gateway/docs/hardware/evidence/input_protection_final_review/nis_rlim_full.png

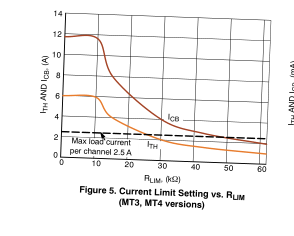
docs/hardware/evidence/input_protection_final_review/nis_rlim_full.png
