anhenaobe/industrial-comunication-gateway/docs/hardware/evidence/input_protection_freeze/cap.png

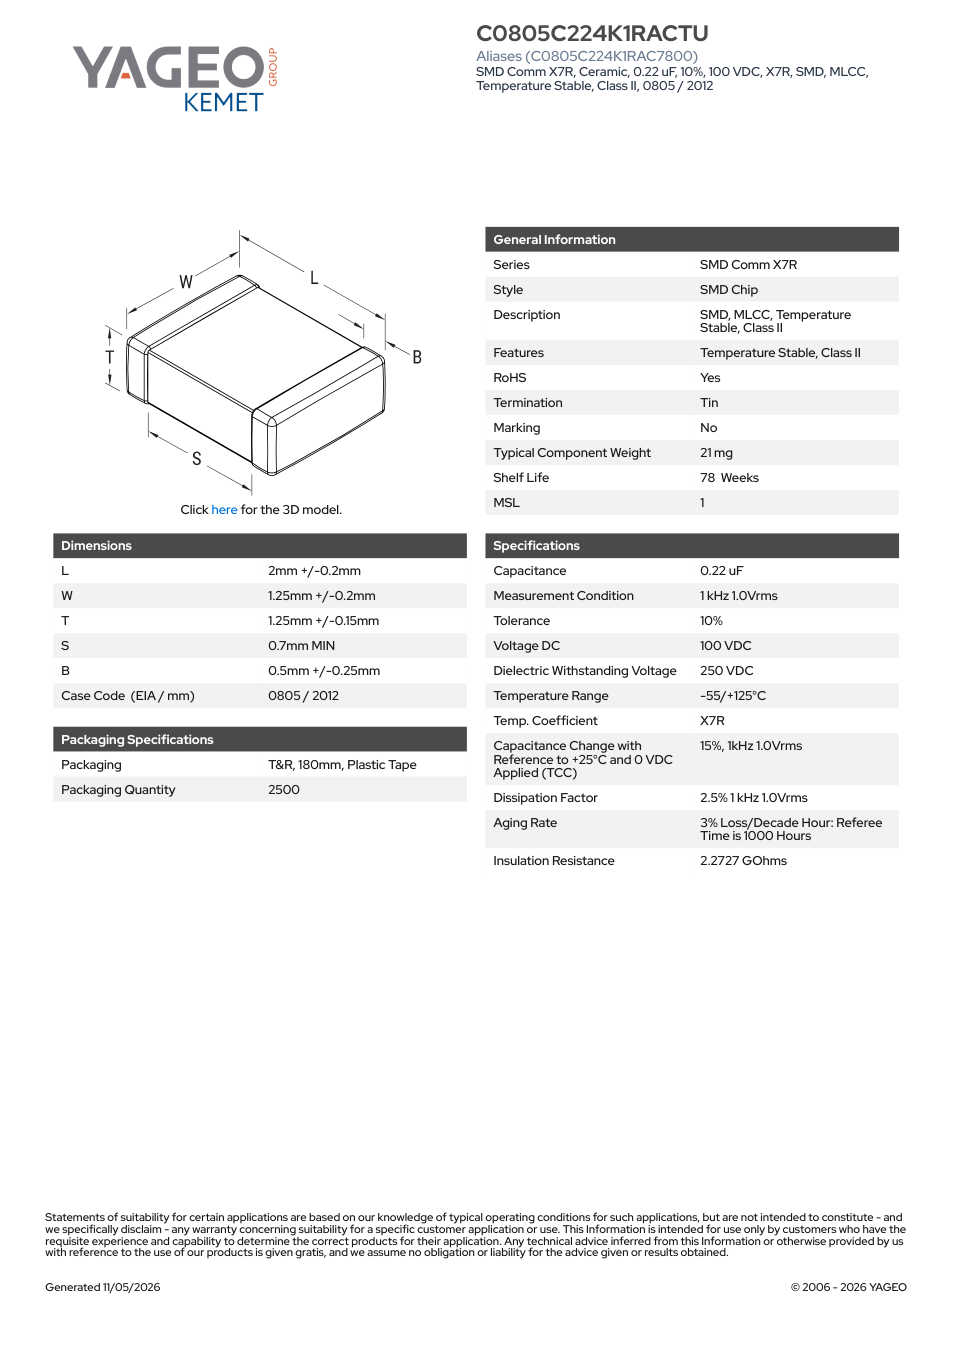
docs/hardware/evidence/input_protection_freeze/cap.png
