anhenaobe/industrial-comunication-gateway/docs/hardware/evidence/input_protection_freeze/KEMET_family.pdf-p12.png

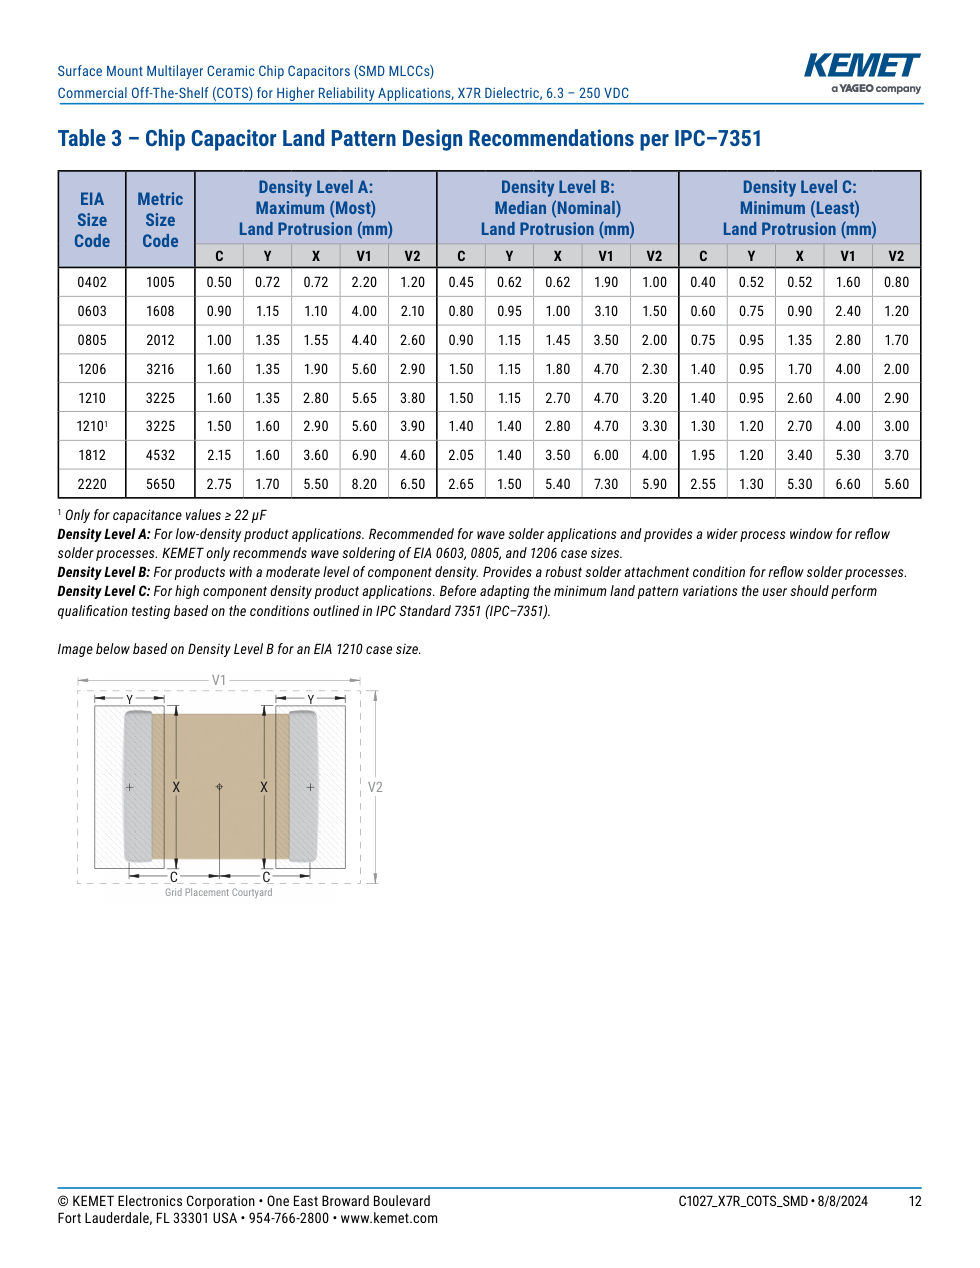
docs/hardware/evidence/input_protection_freeze/KEMET_family.pdf-p12.png
