anhenaobe/industrial-comunication-gateway/docs/hardware/evidence/input_protection_freeze/res.png

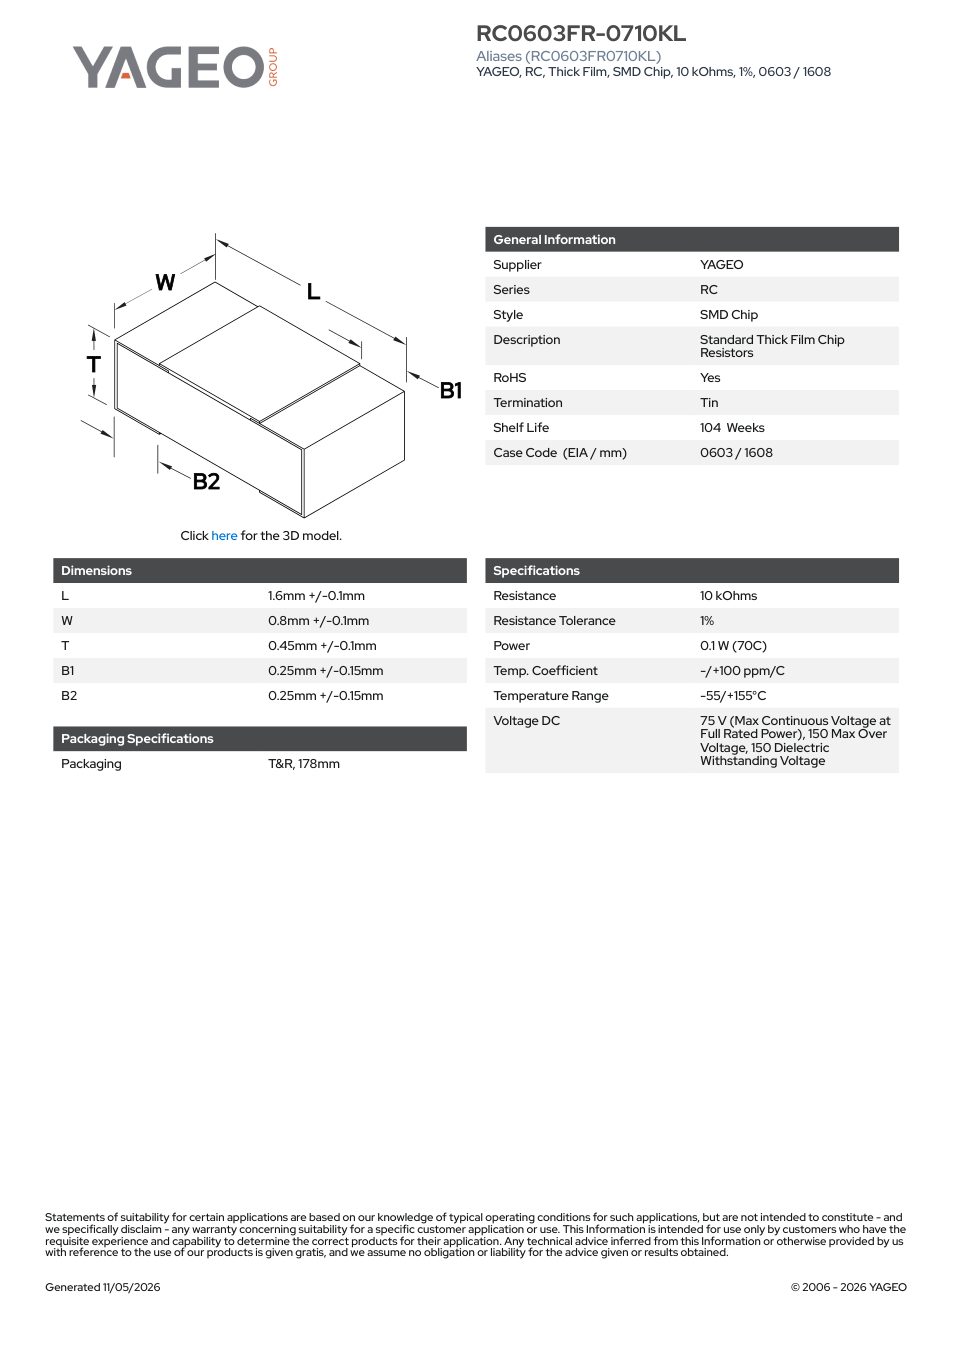
docs/hardware/evidence/input_protection_freeze/res.png
