anhenaobe/industrial-comunication-gateway/docs/hardware/evidence/input_protection_freeze/TDK_p1.png

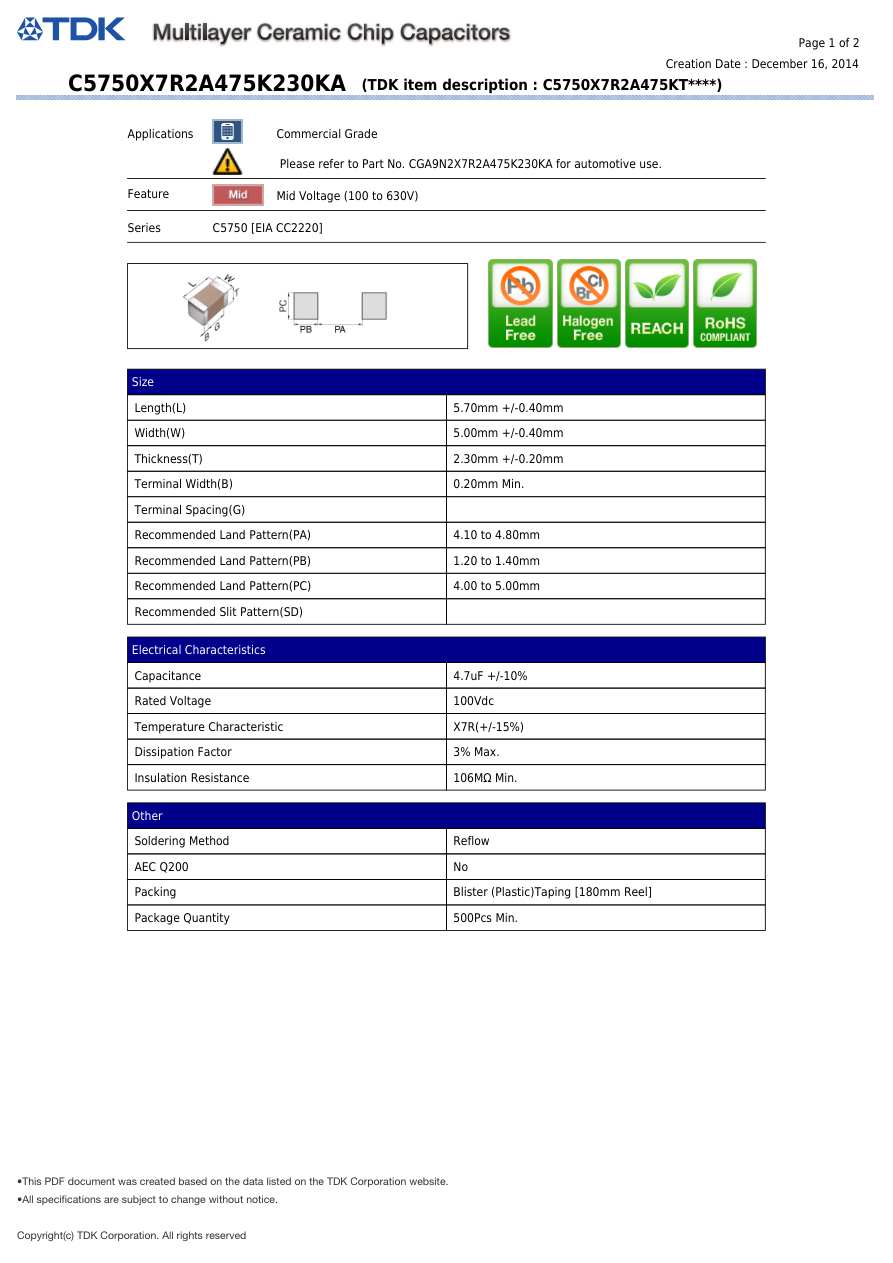
docs/hardware/evidence/input_protection_freeze/TDK_p1.png
