anhenaobe/industrial-comunication-gateway/docs/hardware/evidence/input_protection_freeze/TDK_p2.png

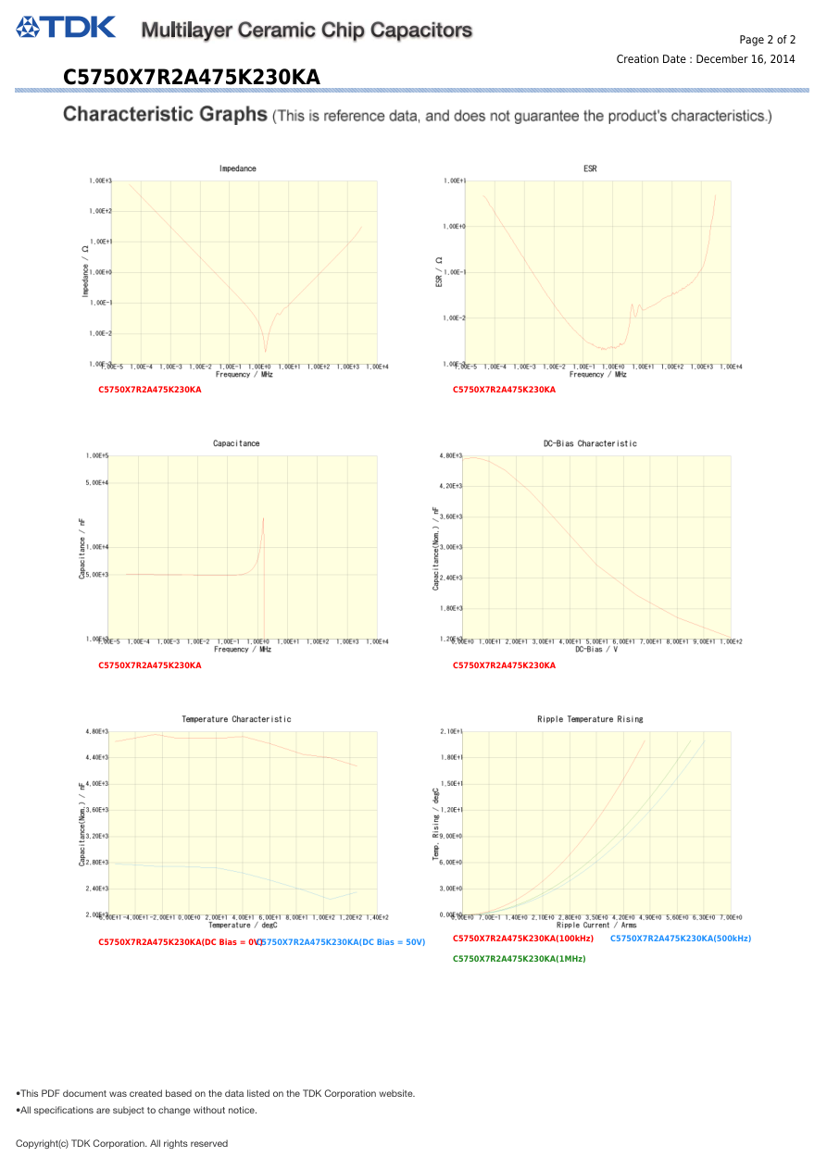
docs/hardware/evidence/input_protection_freeze/TDK_p2.png
