anhenaobe/industrial-comunication-gateway/docs/hardware/evidence/input_protection_freeze/yageo_lands.png

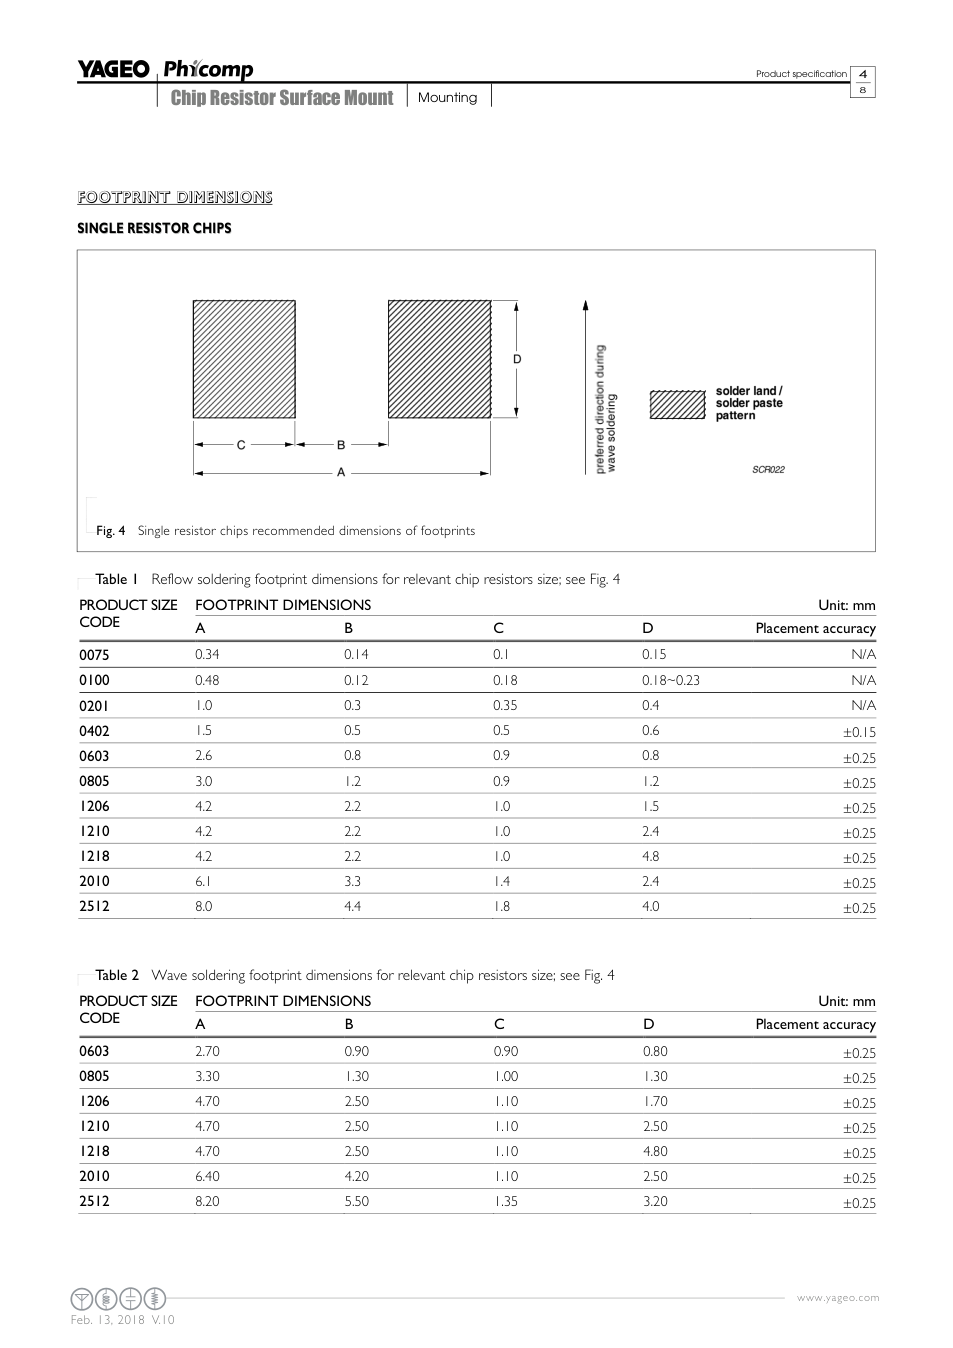
docs/hardware/evidence/input_protection_freeze/yageo_lands.png
