anhenaobe/industrial-comunication-gateway/docs/hardware/evidence/library_preparation/20005991B-p23.png

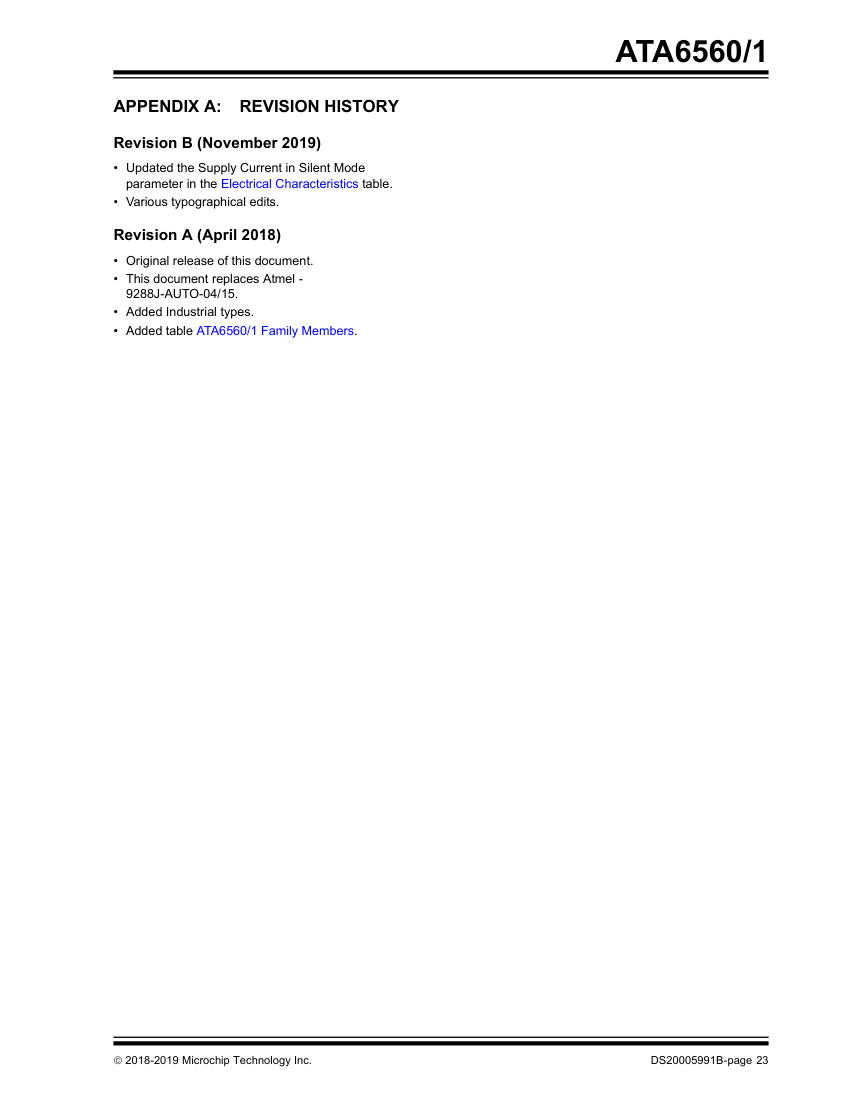
docs/hardware/evidence/library_preparation/20005991B-p23.png
