anhenaobe/industrial-comunication-gateway/docs/hardware/evidence/library_preparation/BSP75N-p7.png

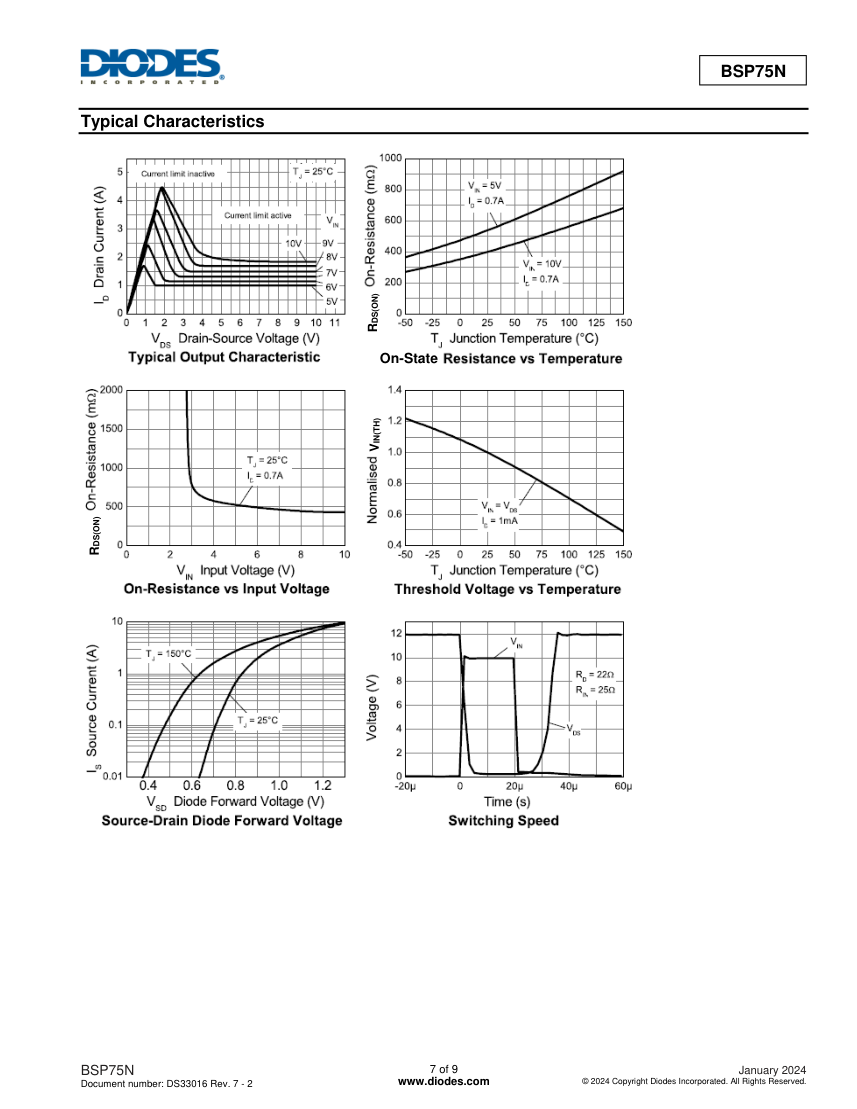
docs/hardware/evidence/library_preparation/BSP75N-p7.png
