anhenaobe/industrial-comunication-gateway/docs/hardware/evidence/library_preparation/dp83826i-p5.png

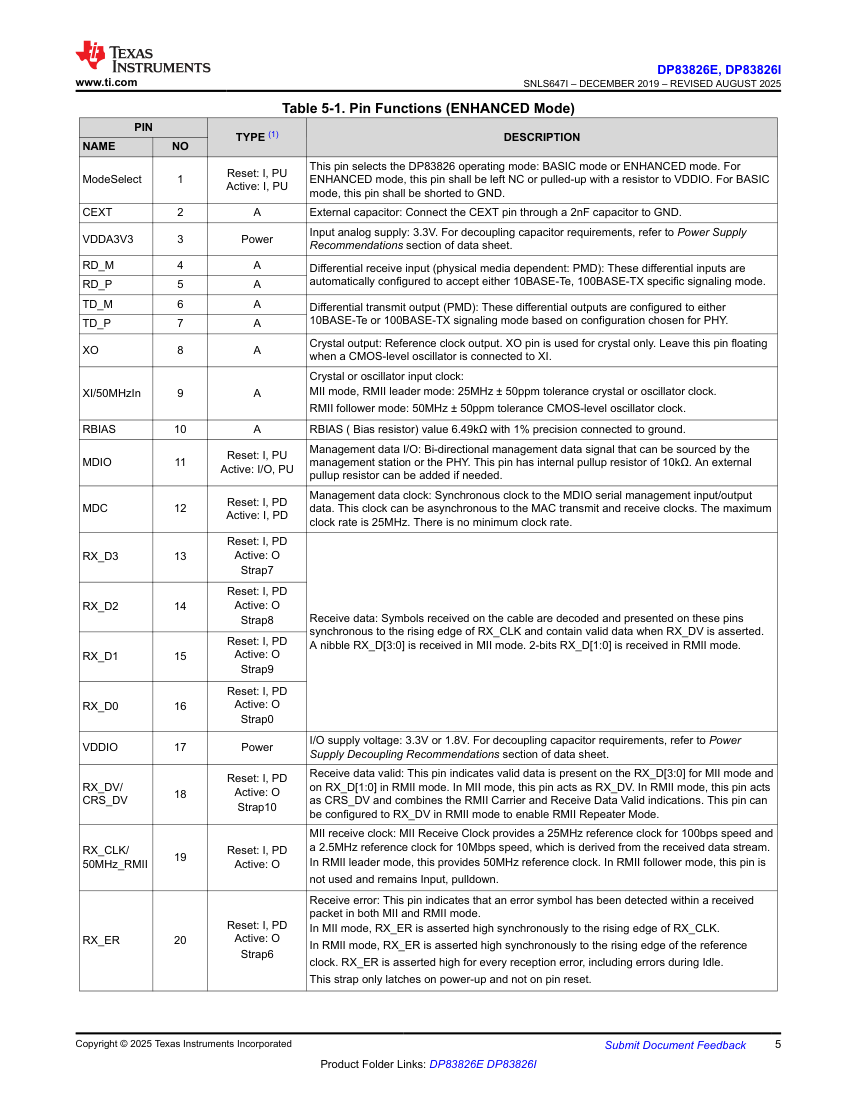
docs/hardware/evidence/library_preparation/dp83826i-p5.png
