anhenaobe/industrial-comunication-gateway/docs/hardware/evidence/library_preparation/dp83826i-p6.png

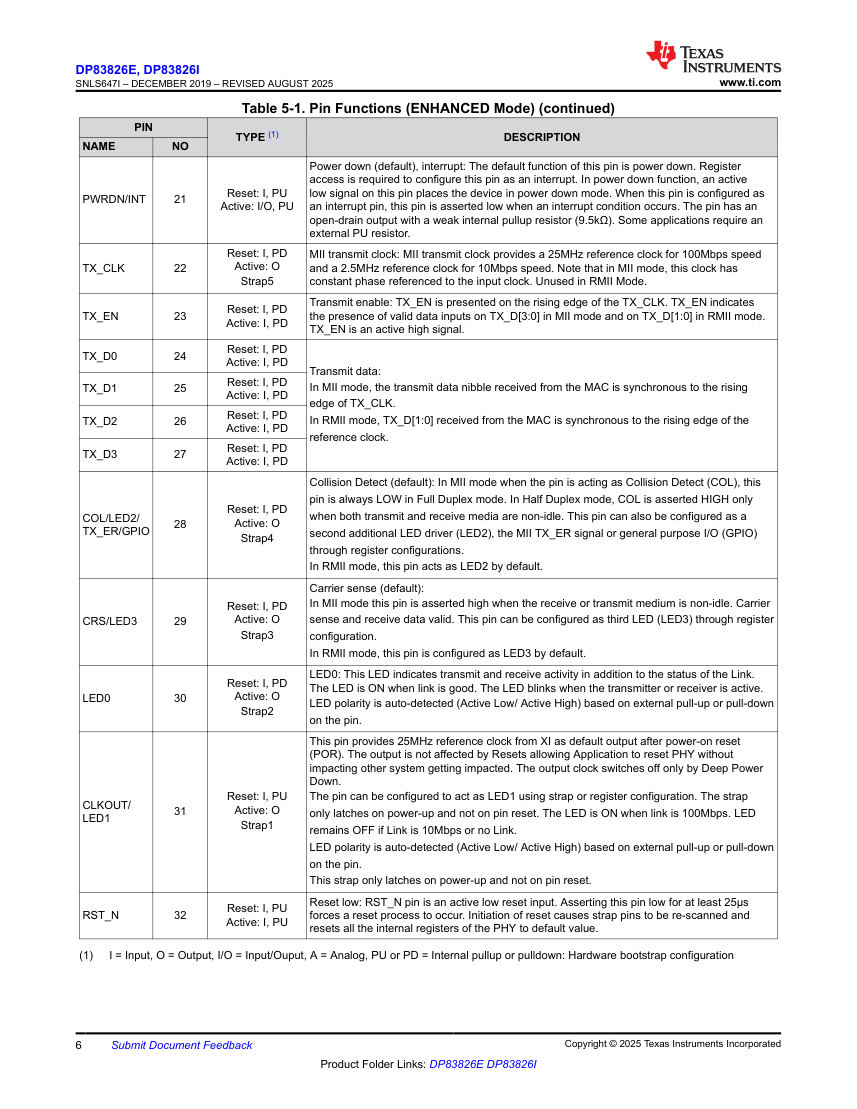
docs/hardware/evidence/library_preparation/dp83826i-p6.png
