anhenaobe/industrial-comunication-gateway/docs/hardware/evidence/library_preparation/DS_stm32h723zg-p219.png

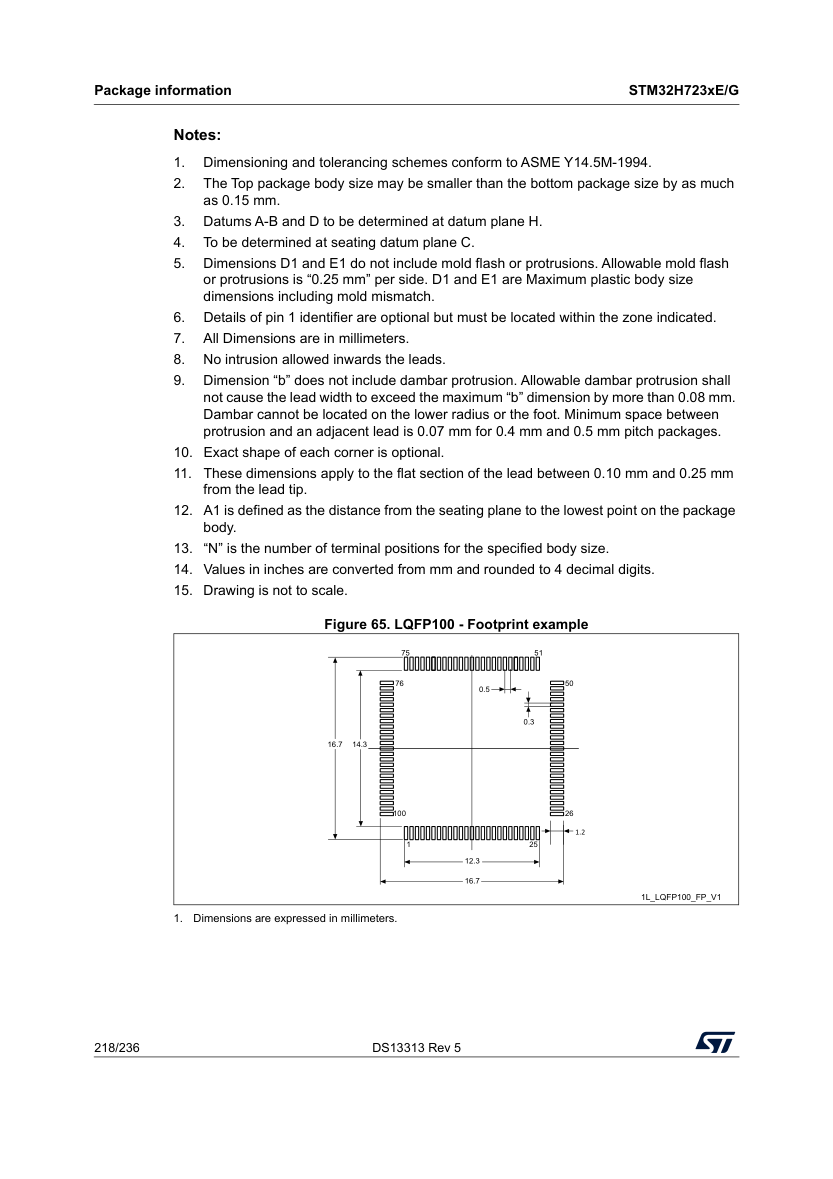
docs/hardware/evidence/library_preparation/DS_stm32h723zg-p219.png
