anhenaobe/industrial-comunication-gateway/docs/hardware/evidence/library_preparation/iso1212-p4.png

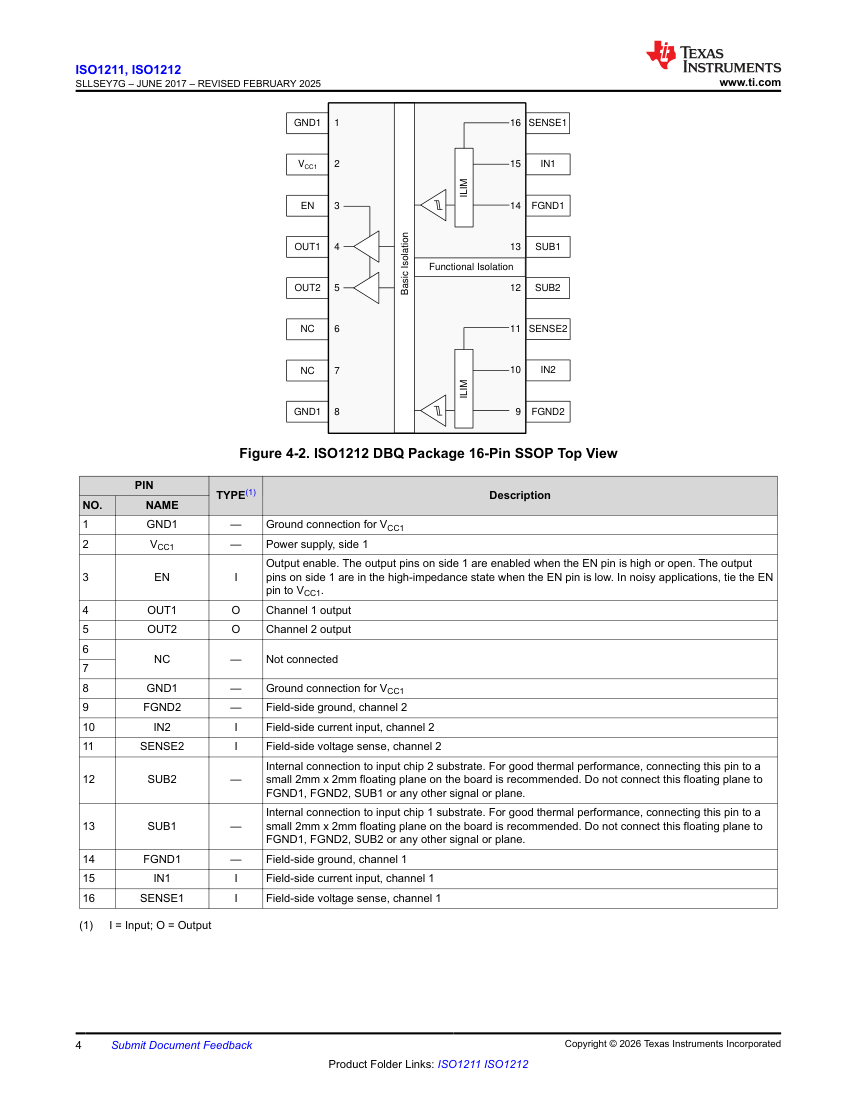
docs/hardware/evidence/library_preparation/iso1212-p4.png
