anhenaobe/industrial-comunication-gateway/docs/hardware/evidence/library_preparation/lmr36015-p44.png

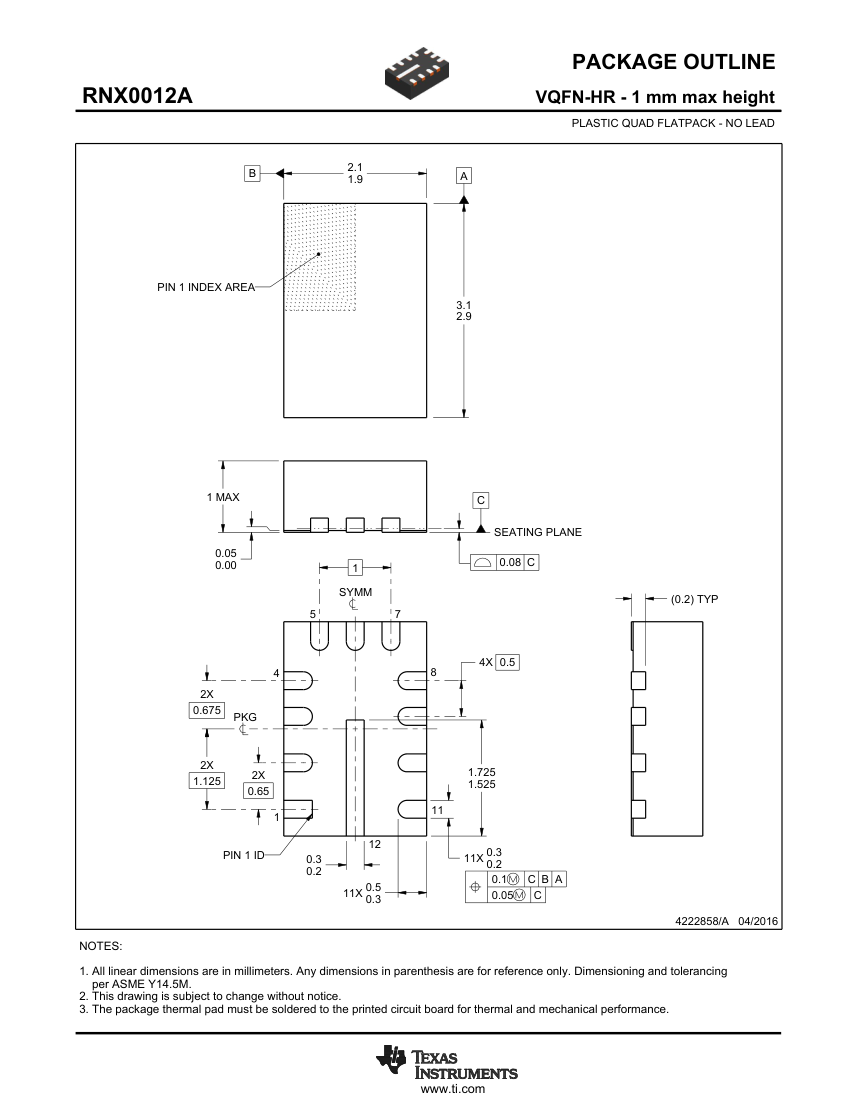
docs/hardware/evidence/library_preparation/lmr36015-p44.png
