anhenaobe/industrial-comunication-gateway/docs/hardware/evidence/library_preparation/sn74lvc2t45-p29.png

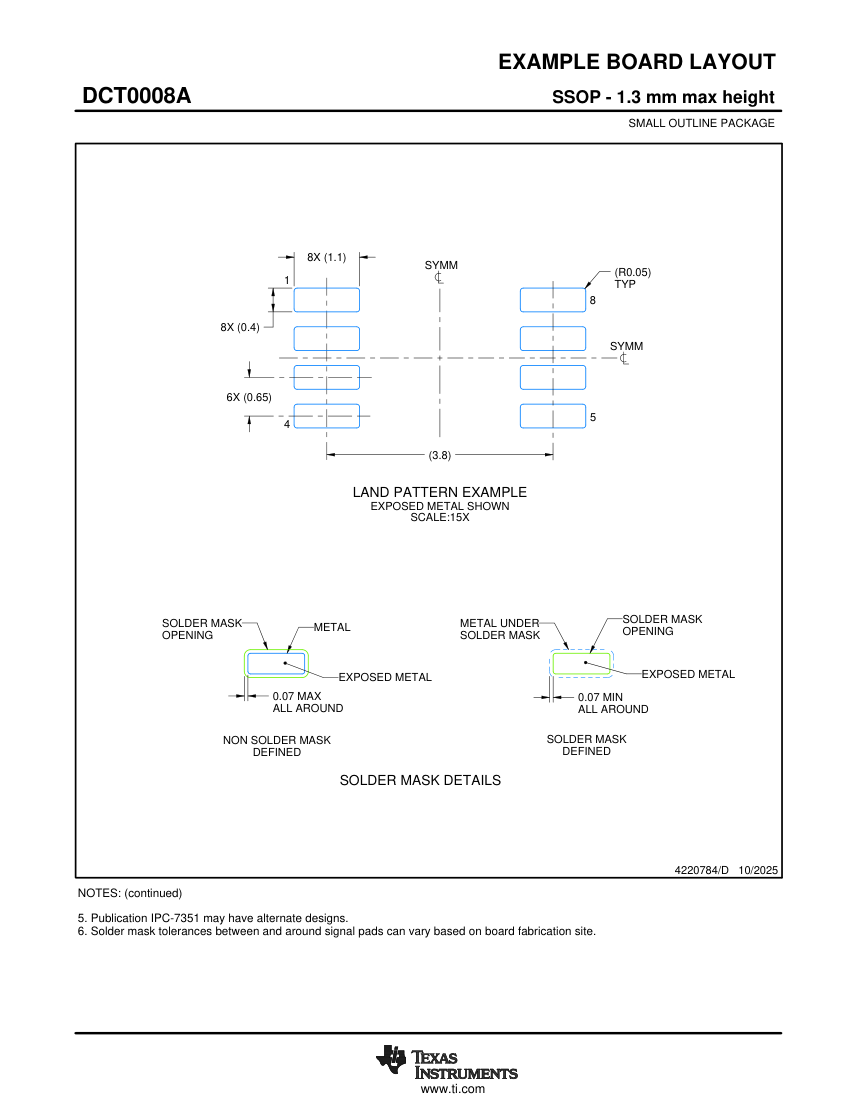
docs/hardware/evidence/library_preparation/sn74lvc2t45-p29.png
