anhenaobe/industrial-comunication-gateway/docs/hardware/evidence/library_preparation/thvd1400-p3.png

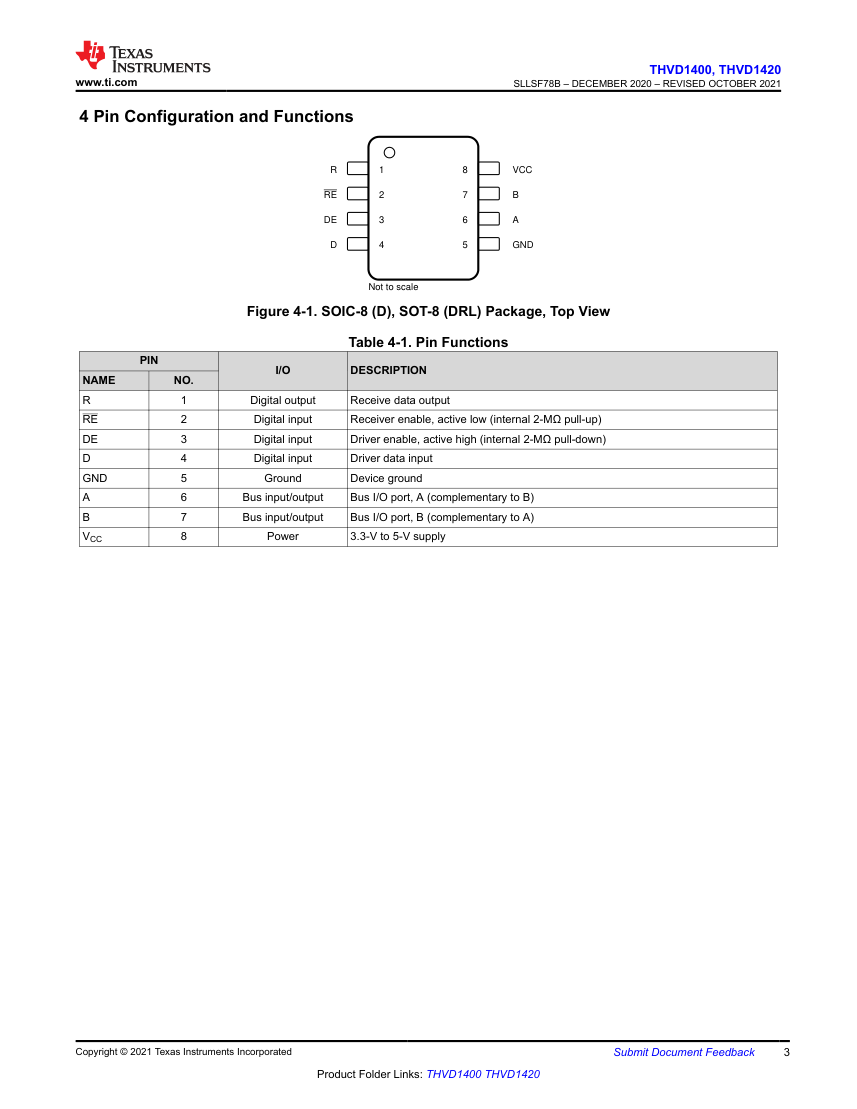
docs/hardware/evidence/library_preparation/thvd1400-p3.png
