anhenaobe/industrial-comunication-gateway/docs/hardware/evidence/library_preparation/thvd1400-p29.png

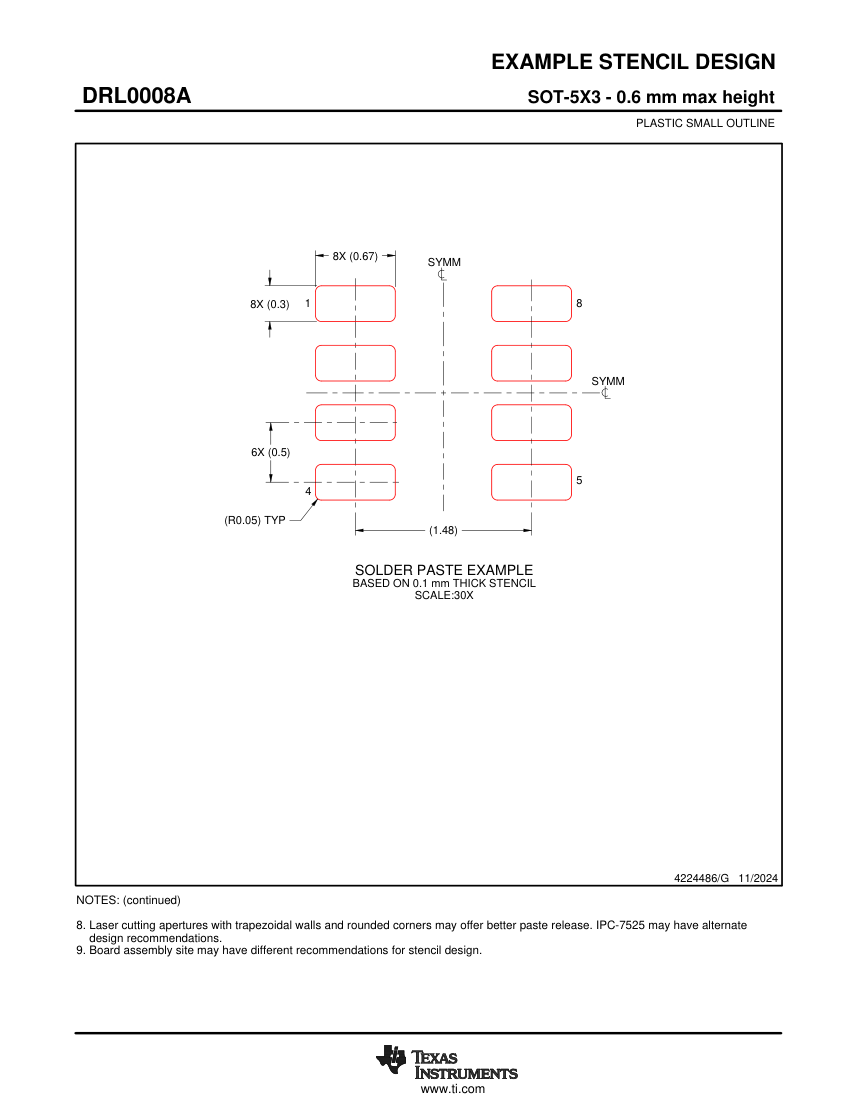
docs/hardware/evidence/library_preparation/thvd1400-p29.png
