anhenaobe/industrial-comunication-gateway/docs/hardware/evidence/passive_sources/dp83826i-p99.png

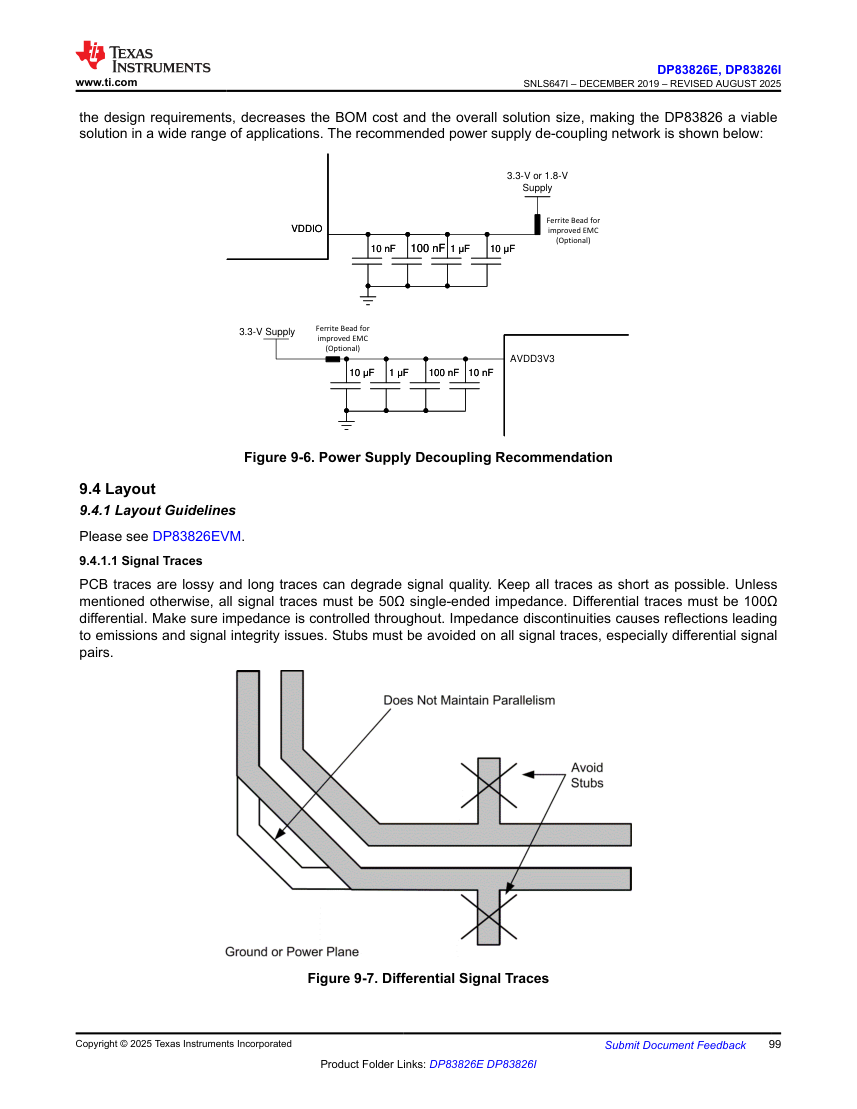
docs/hardware/evidence/passive_sources/dp83826i-p99.png
