anhenaobe/industrial-comunication-gateway/docs/hardware/evidence/passive_sources/DS_stm32h723zg-p54.png

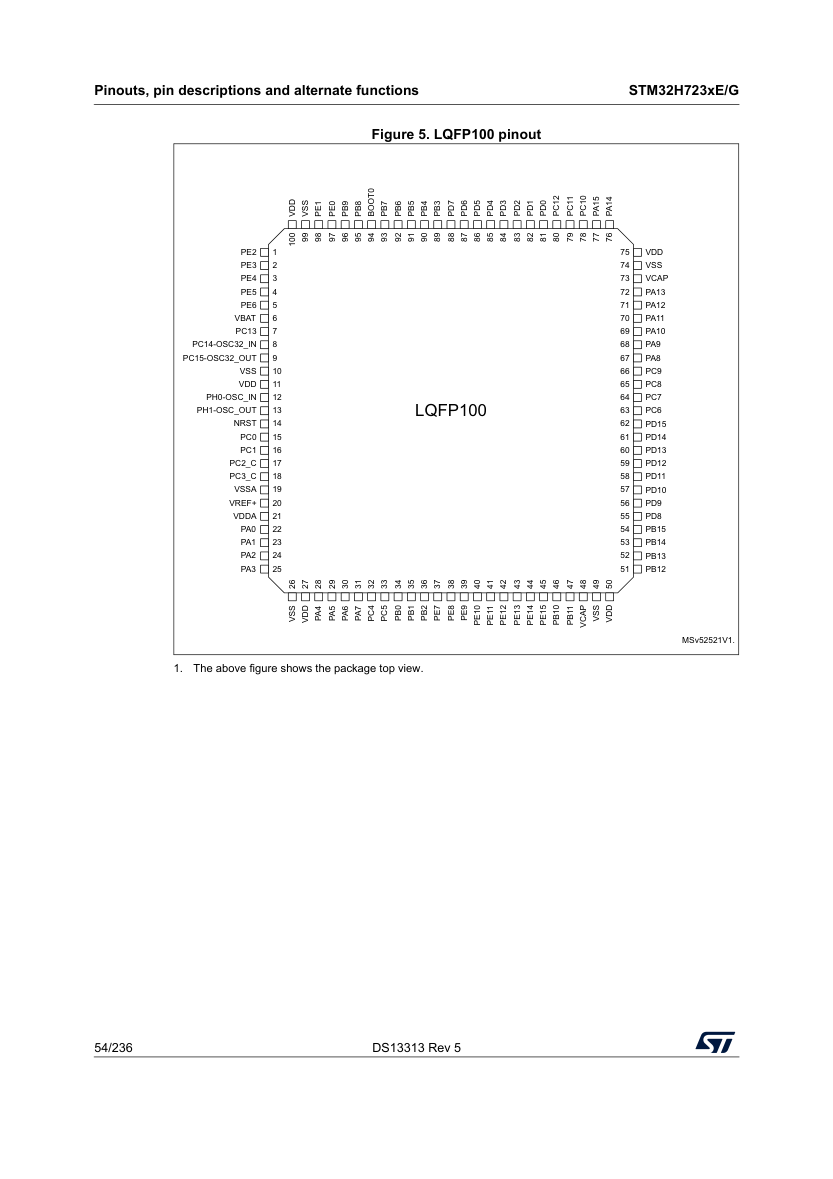
docs/hardware/evidence/passive_sources/DS_stm32h723zg-p54.png
