anhenaobe/industrial-comunication-gateway/docs/hardware/evidence/passive_sources/lmr36015-p21.png

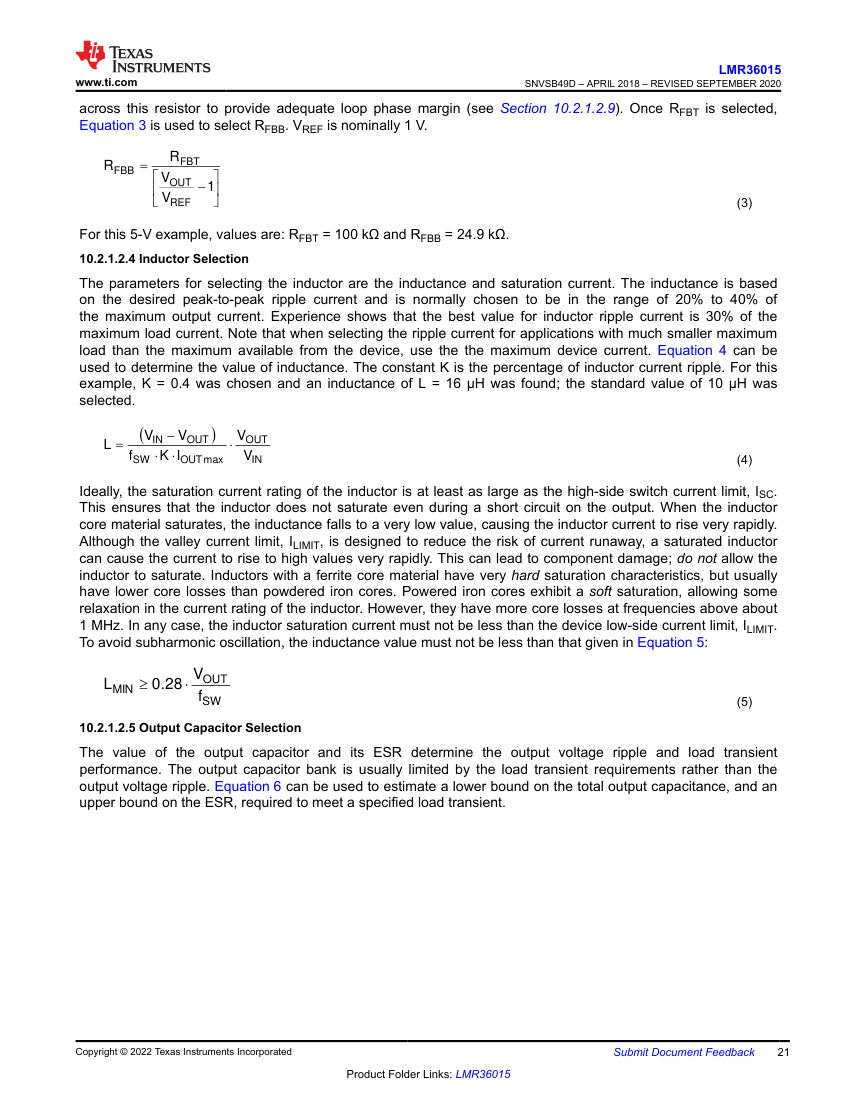
docs/hardware/evidence/passive_sources/lmr36015-p21.png
