anhenaobe/industrial-comunication-gateway/docs/hardware/evidence/pin_length_normalization/preview.png

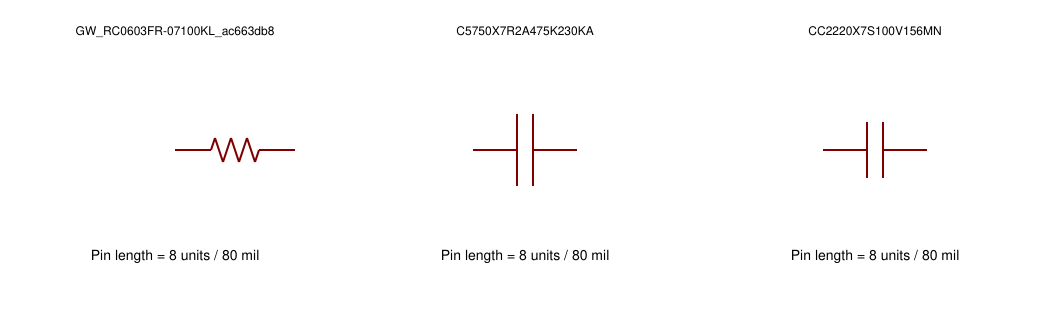
docs/hardware/evidence/pin_length_normalization/preview.png
