anhenaobe/industrial-comunication-gateway/docs/hardware/evidence/tps26620/p4.png

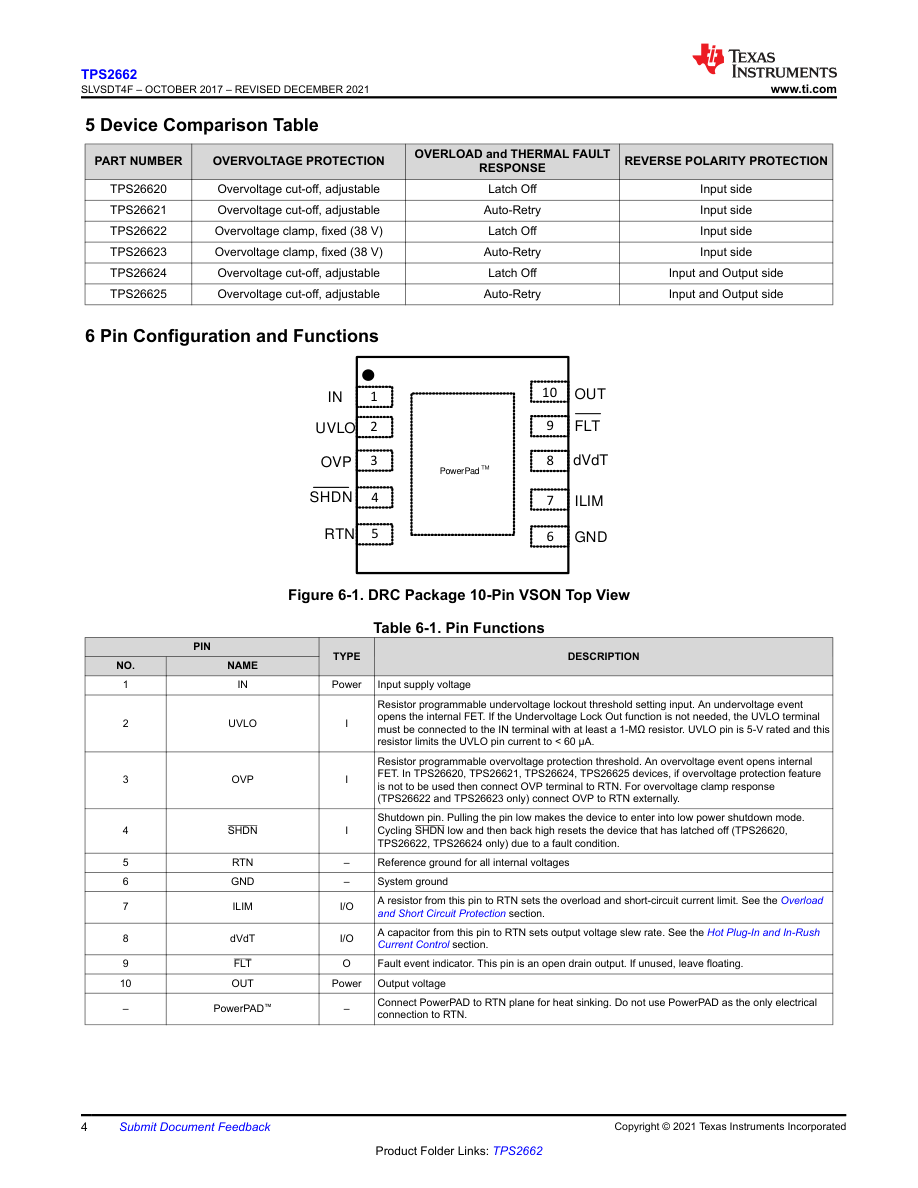
docs/hardware/evidence/tps26620/p4.png
