anhenaobe/industrial-comunication-gateway/docs/hardware/evidence/tps26620/p17.png

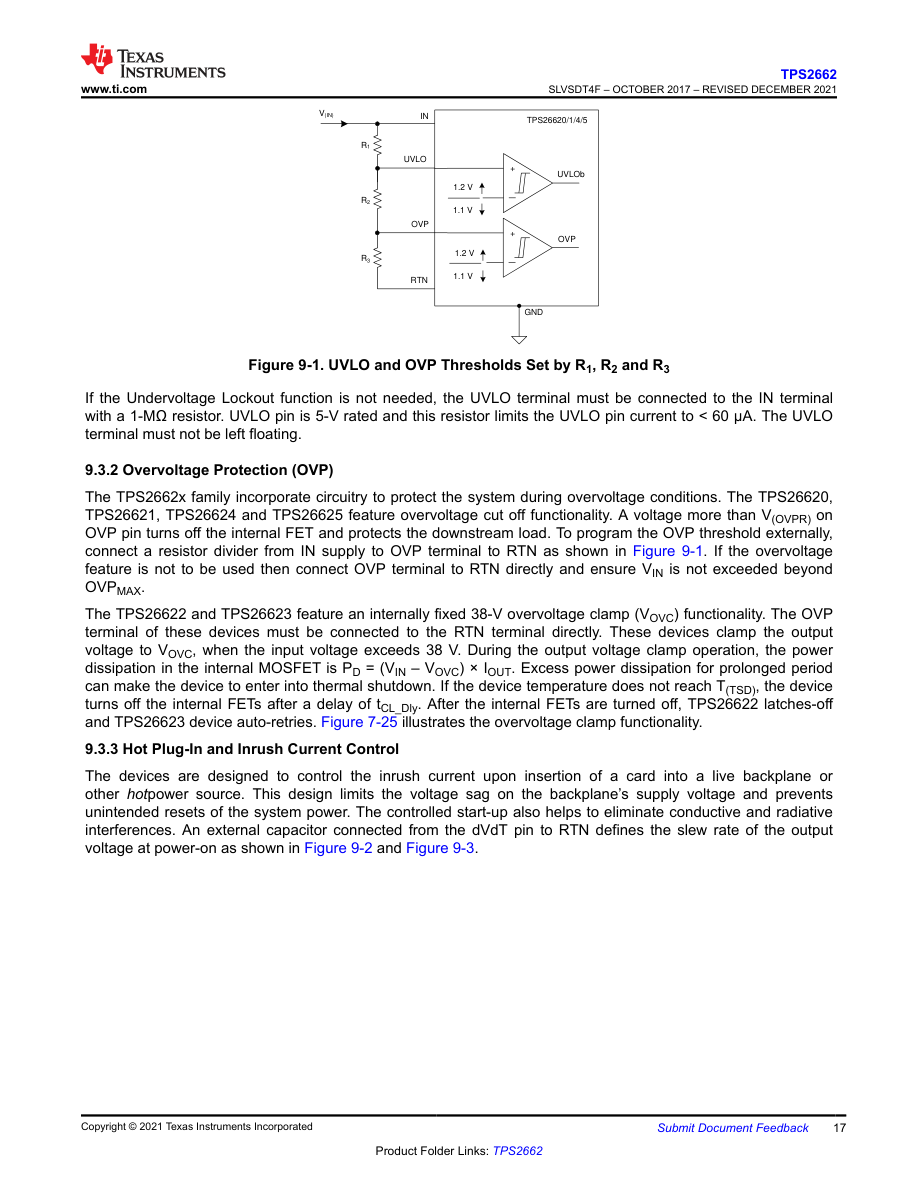
docs/hardware/evidence/tps26620/p17.png
