anhenaobe/industrial-comunication-gateway/docs/hardware/evidence/tps26620/p18.png

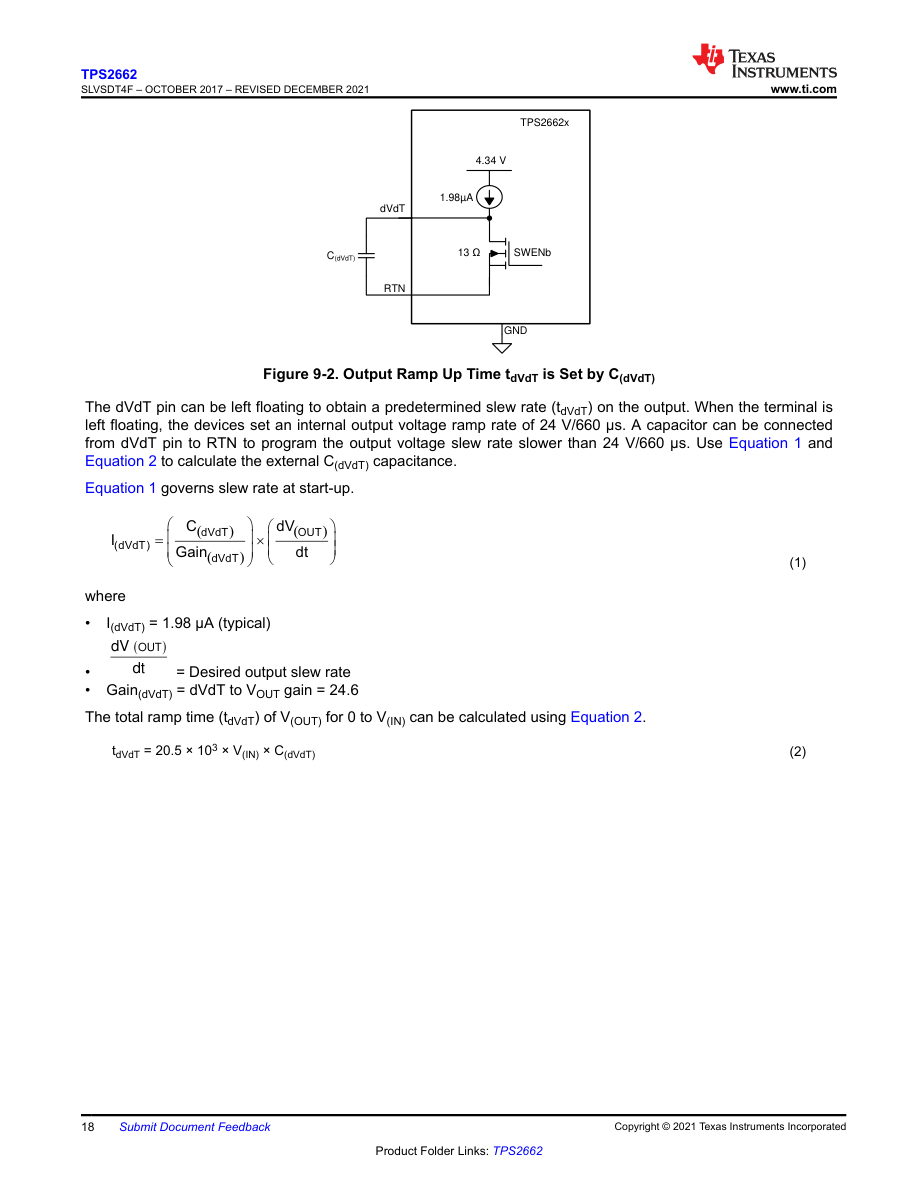
docs/hardware/evidence/tps26620/p18.png
