anhenaobe/industrial-comunication-gateway/docs/hardware/evidence/tps26620/p19.png

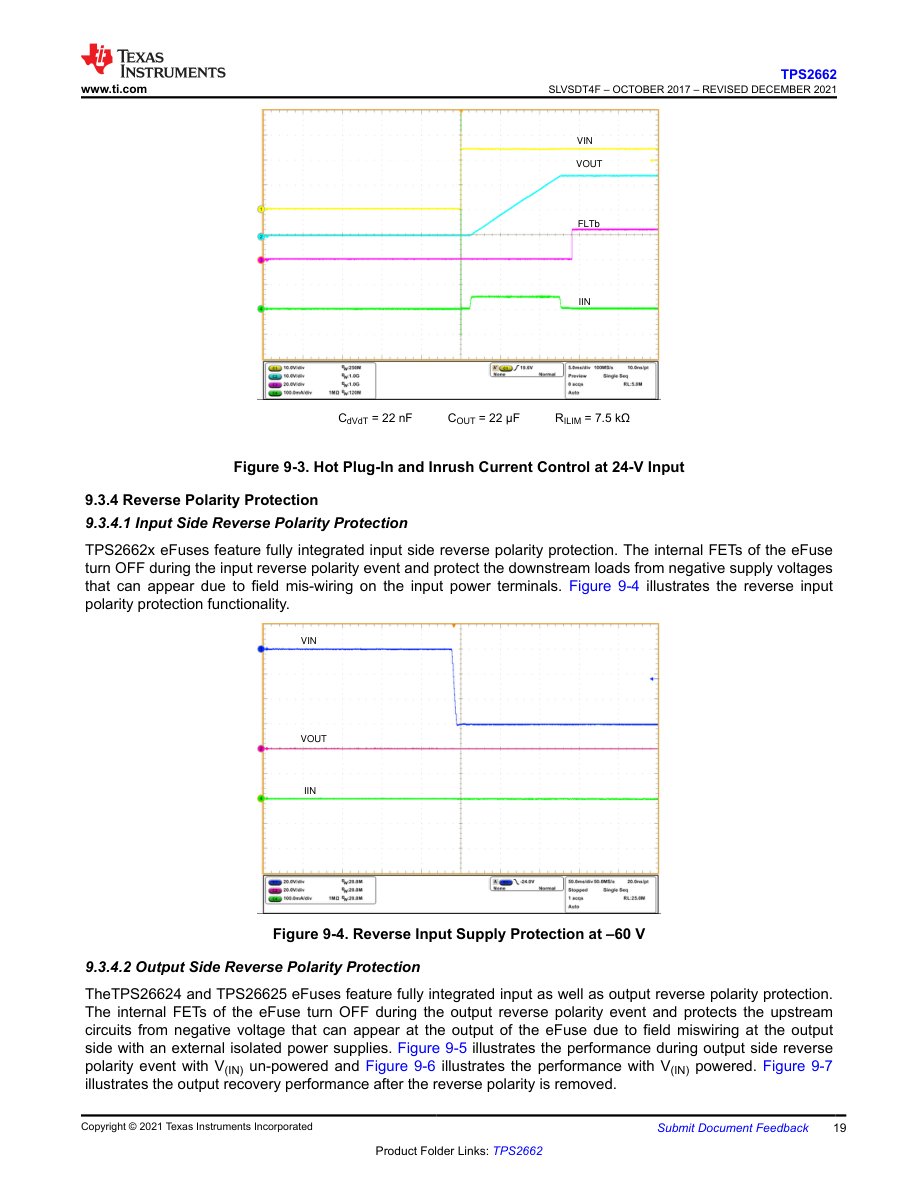
docs/hardware/evidence/tps26620/p19.png
