anhenaobe/industrial-comunication-gateway/docs/hardware/evidence/tps26620/p25.png

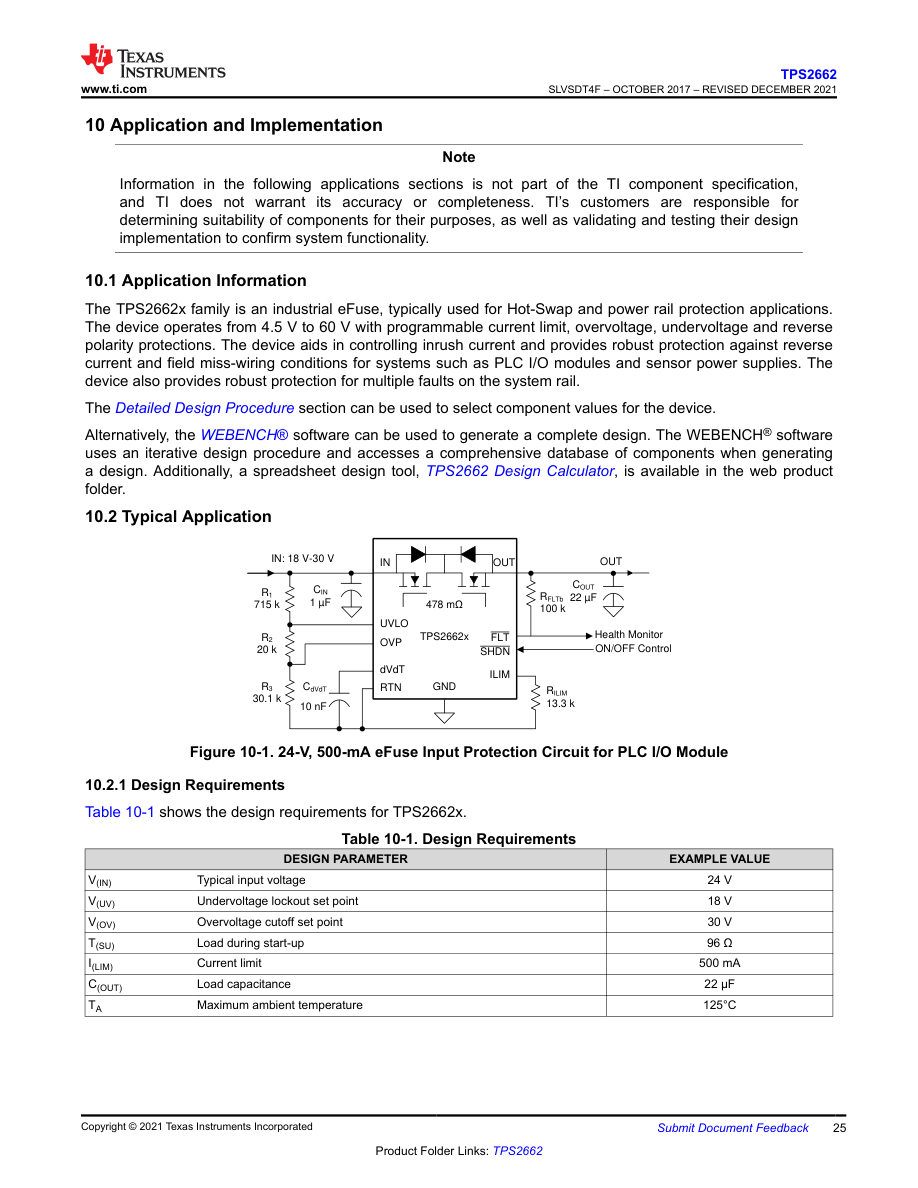
docs/hardware/evidence/tps26620/p25.png
