anhenaobe/industrial-comunication-gateway/docs/hardware/evidence/tps26620/p26.png

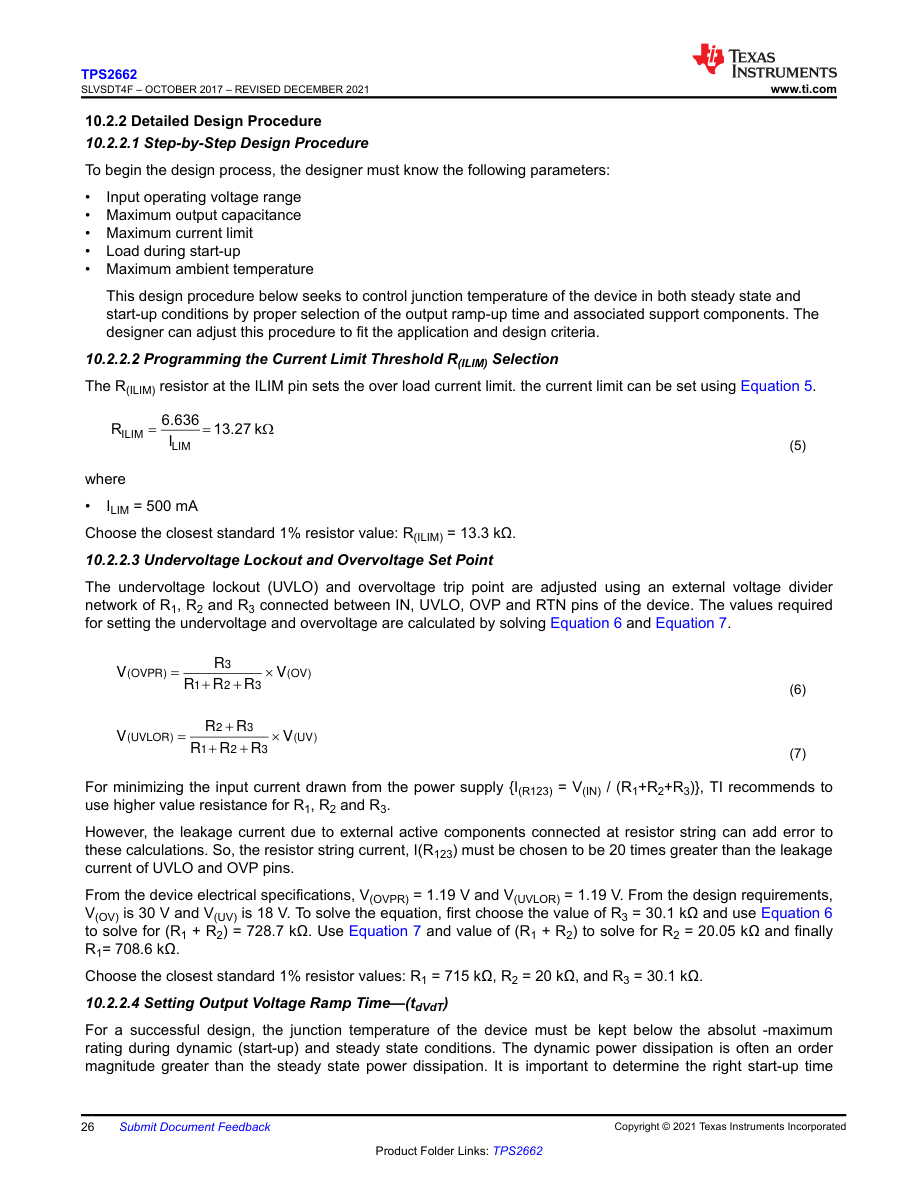
docs/hardware/evidence/tps26620/p26.png
