anhenaobe/industrial-comunication-gateway/docs/hardware/evidence/tps26620/p27.png

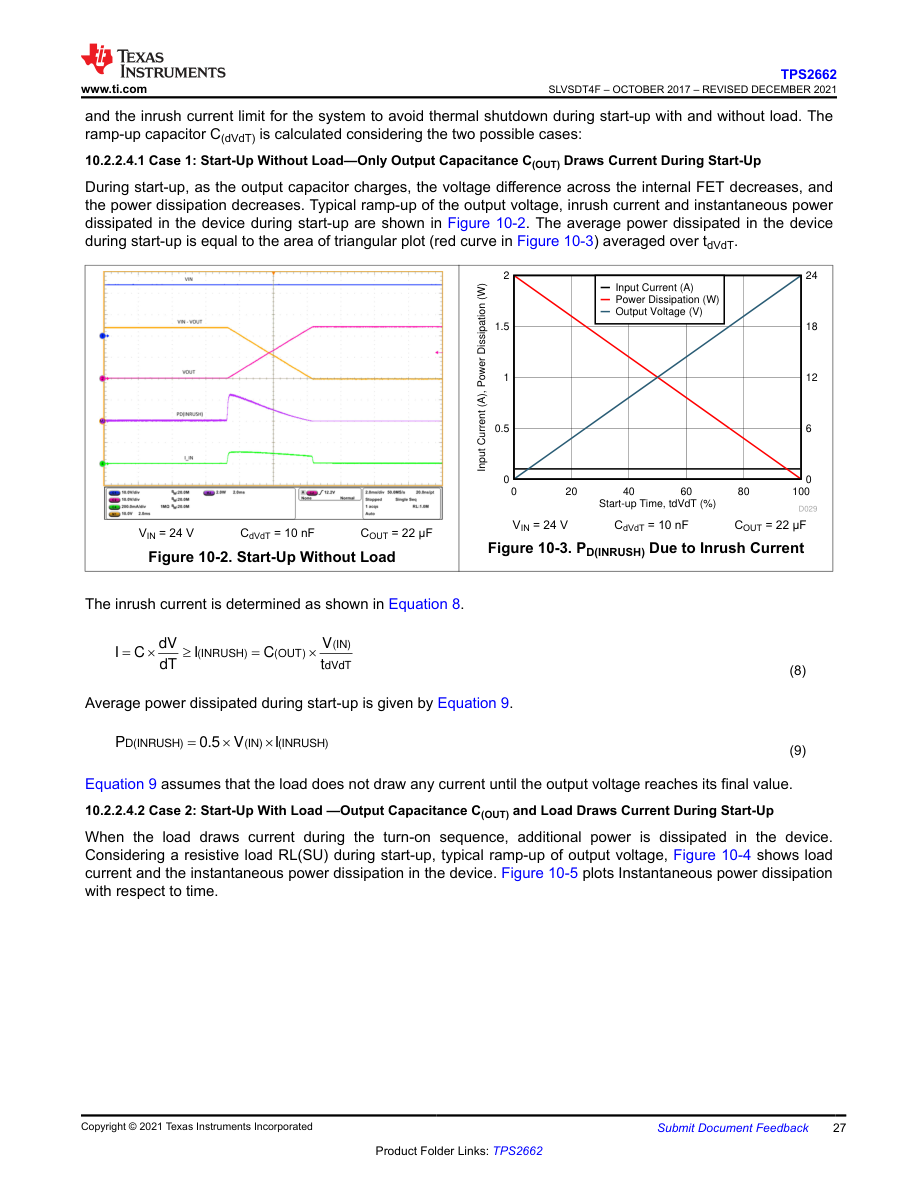
docs/hardware/evidence/tps26620/p27.png
