anhenaobe/industrial-comunication-gateway/docs/hardware/evidence/tps26620/p28.png

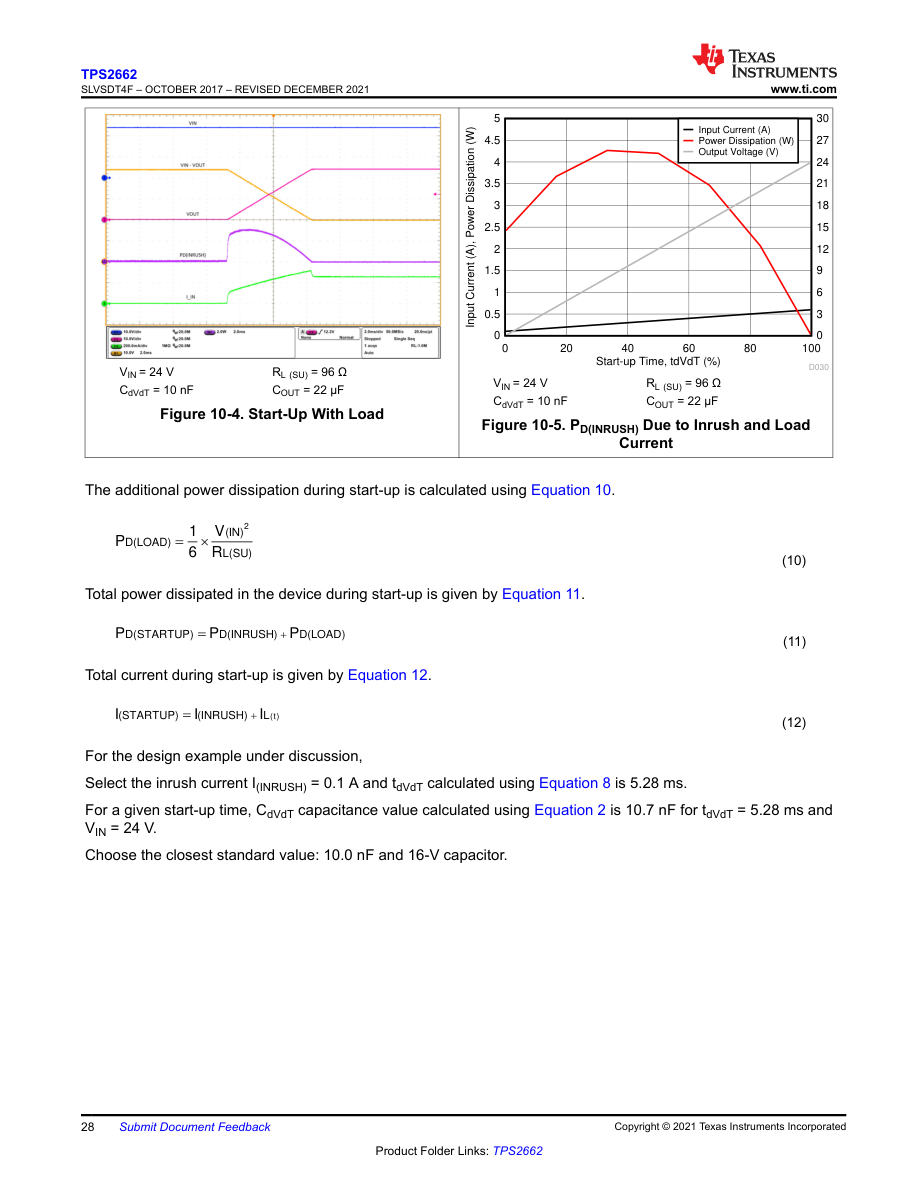
docs/hardware/evidence/tps26620/p28.png
