anhenaobe/industrial-comunication-gateway/docs/hardware/evidence/tps26620/p29.png

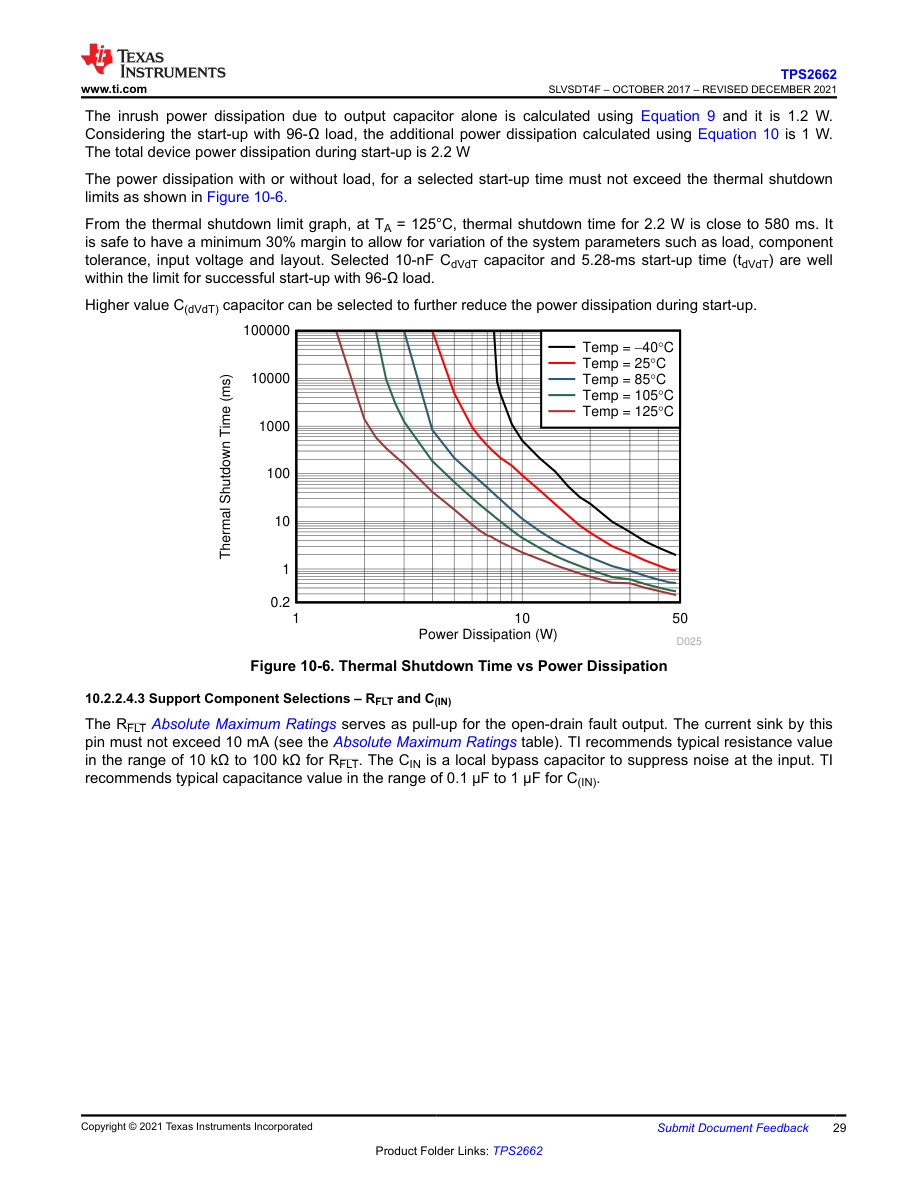
docs/hardware/evidence/tps26620/p29.png
