anhenaobe/industrial-comunication-gateway/docs/hardware/evidence/tps26620/p30.png

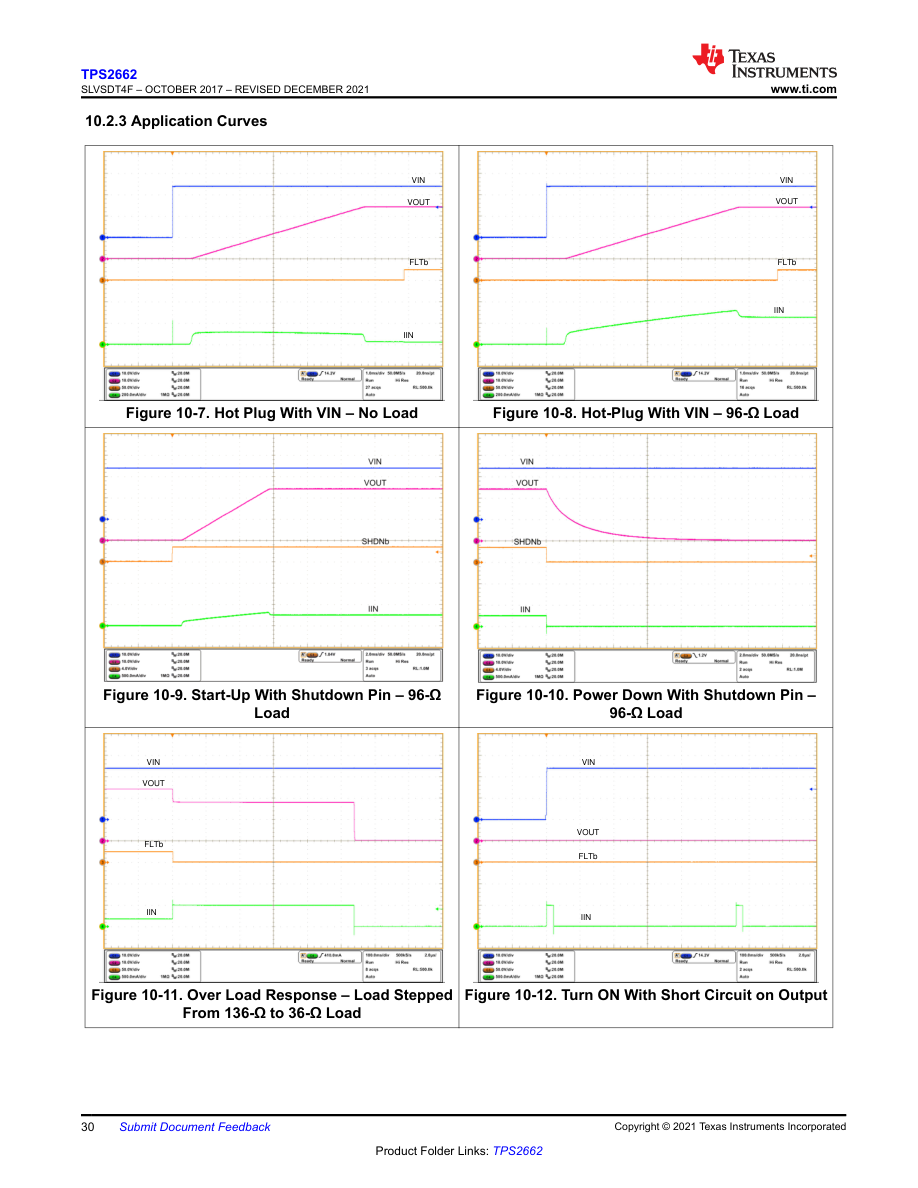
docs/hardware/evidence/tps26620/p30.png
