anhenaobe/industrial-comunication-gateway/docs/hardware/evidence/tps26620/p31.png

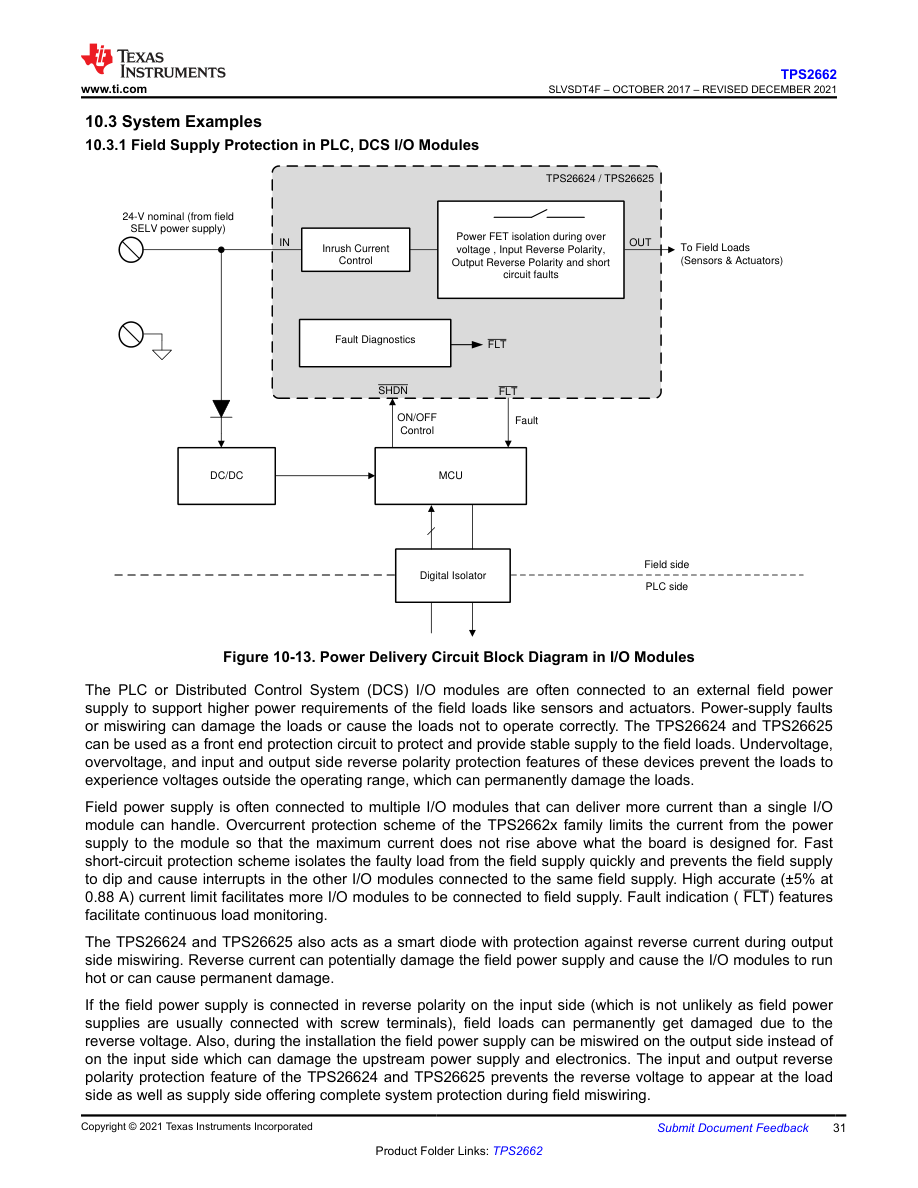
docs/hardware/evidence/tps26620/p31.png
