anhenaobe/industrial-comunication-gateway/docs/hardware/evidence/tps26620/p35.png

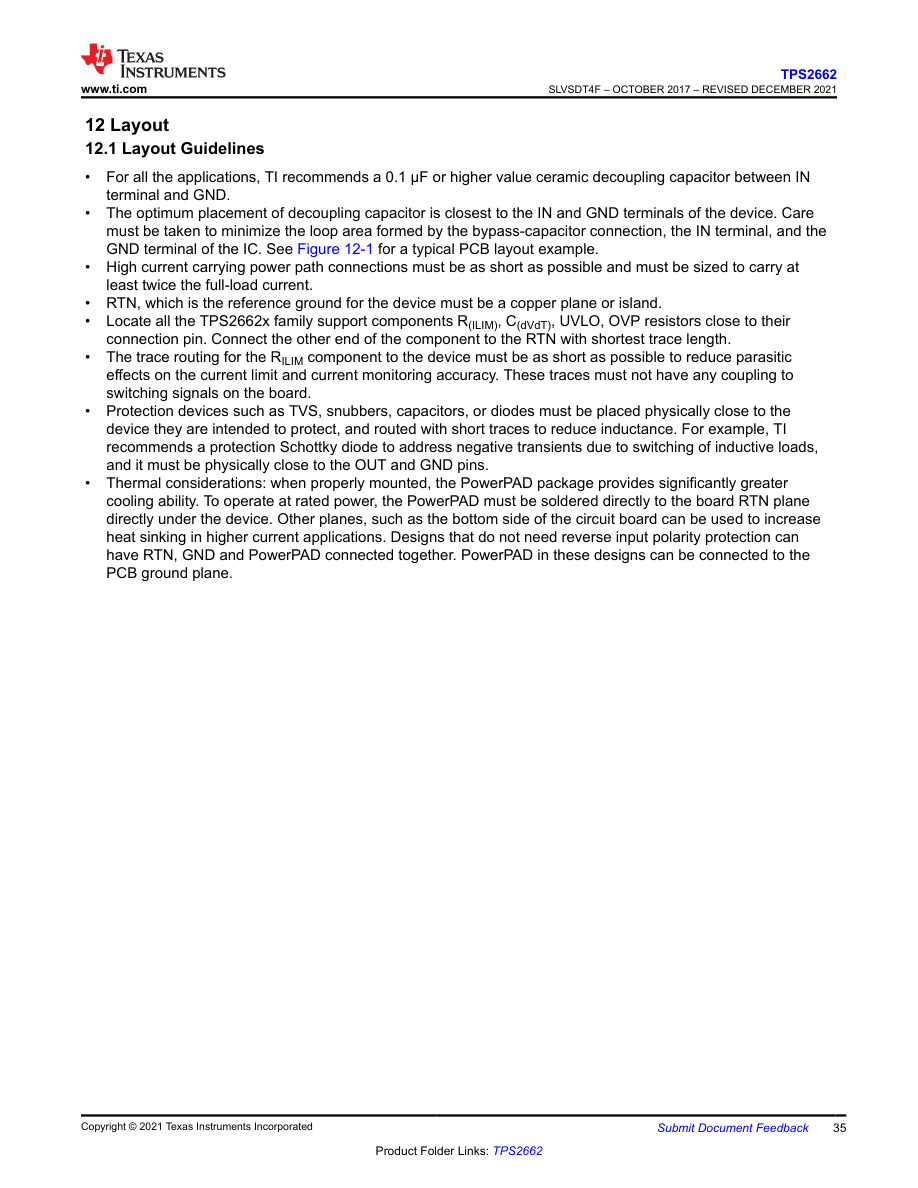
docs/hardware/evidence/tps26620/p35.png
