anhenaobe/industrial-comunication-gateway/docs/hardware/evidence/tps26620/p36.png

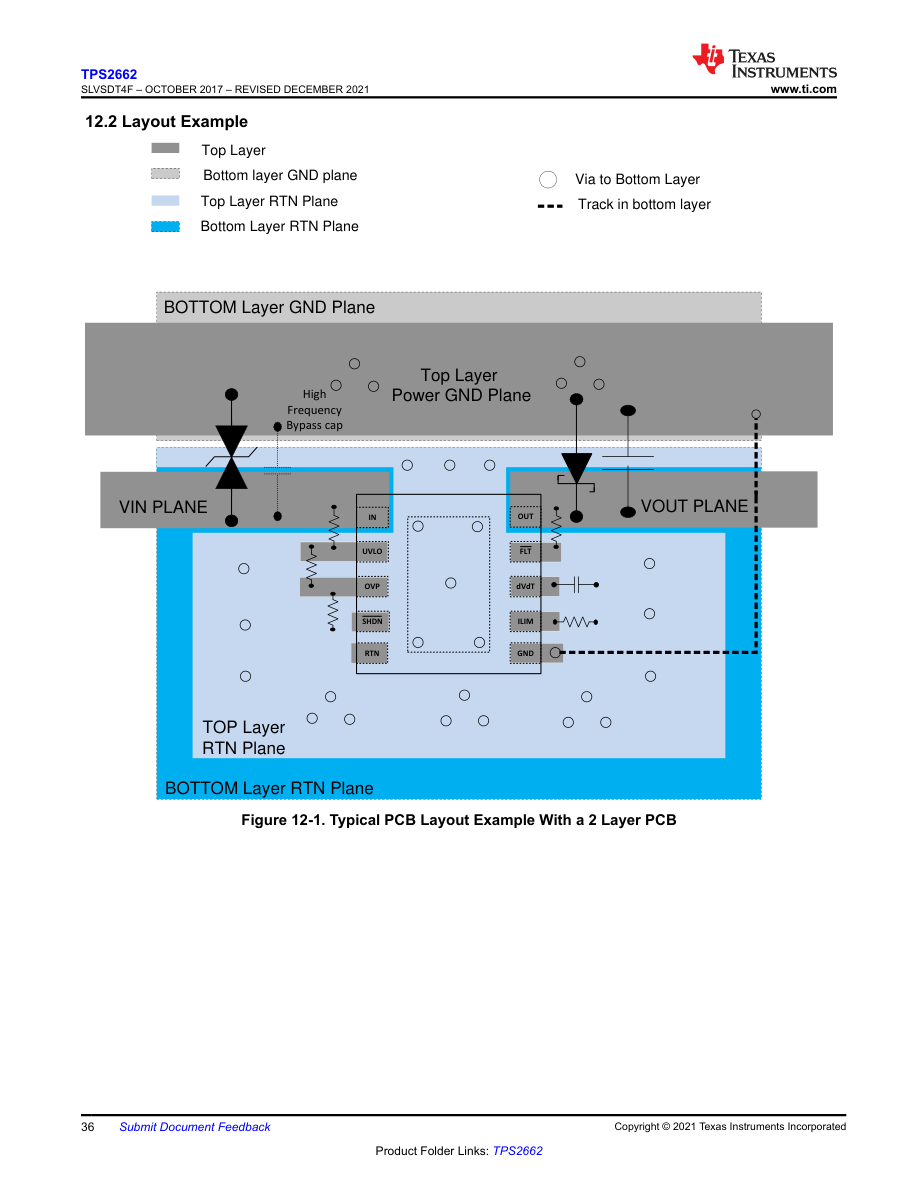
docs/hardware/evidence/tps26620/p36.png
