anhenaobe/industrial-comunication-gateway/docs/hardware/evidence/tps26620/p44.png

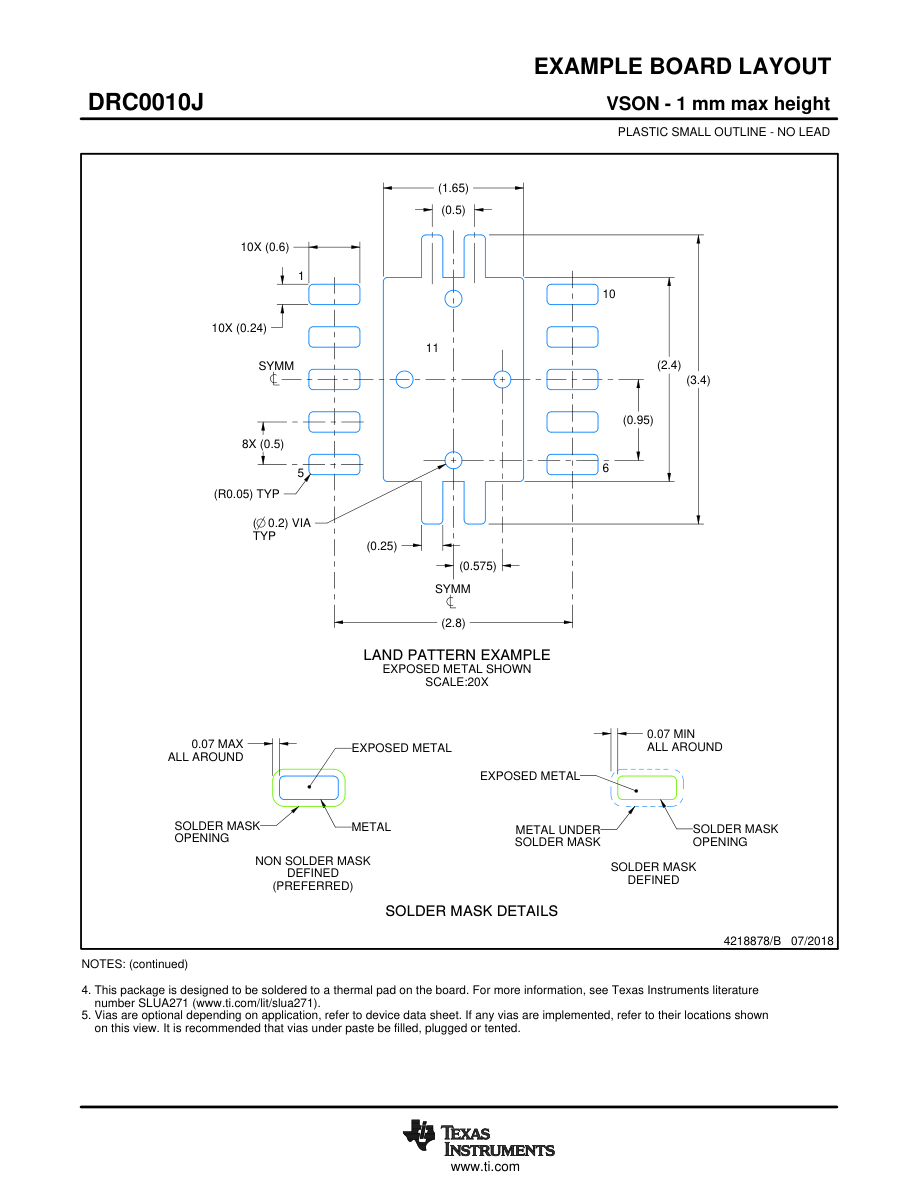
docs/hardware/evidence/tps26620/p44.png
