anhenaobe/industrial-comunication-gateway/docs/hardware/evidence/tps26620/p46.png

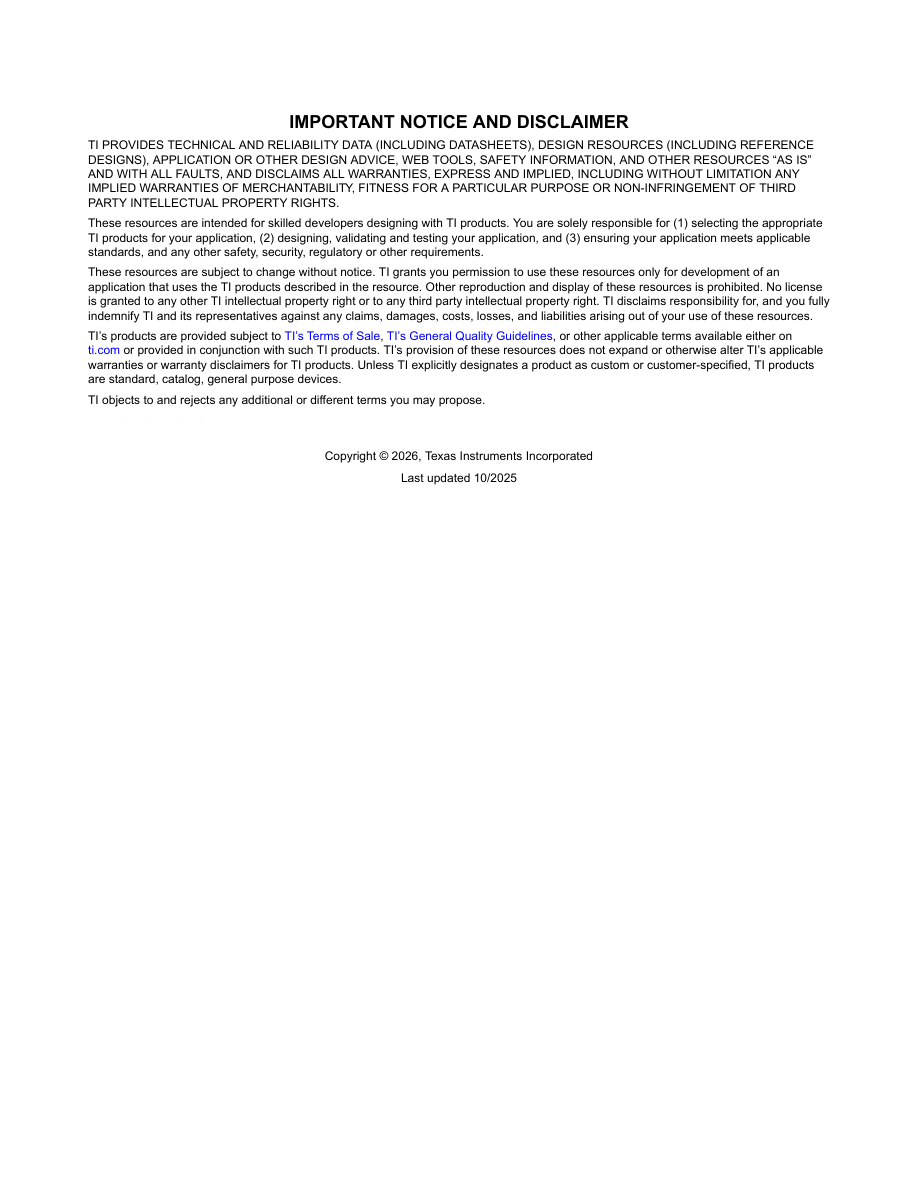
docs/hardware/evidence/tps26620/p46.png
