anhenaobe/industrial-comunication-gateway/docs/hardware/evidence/tps26620/symbol_preview.png

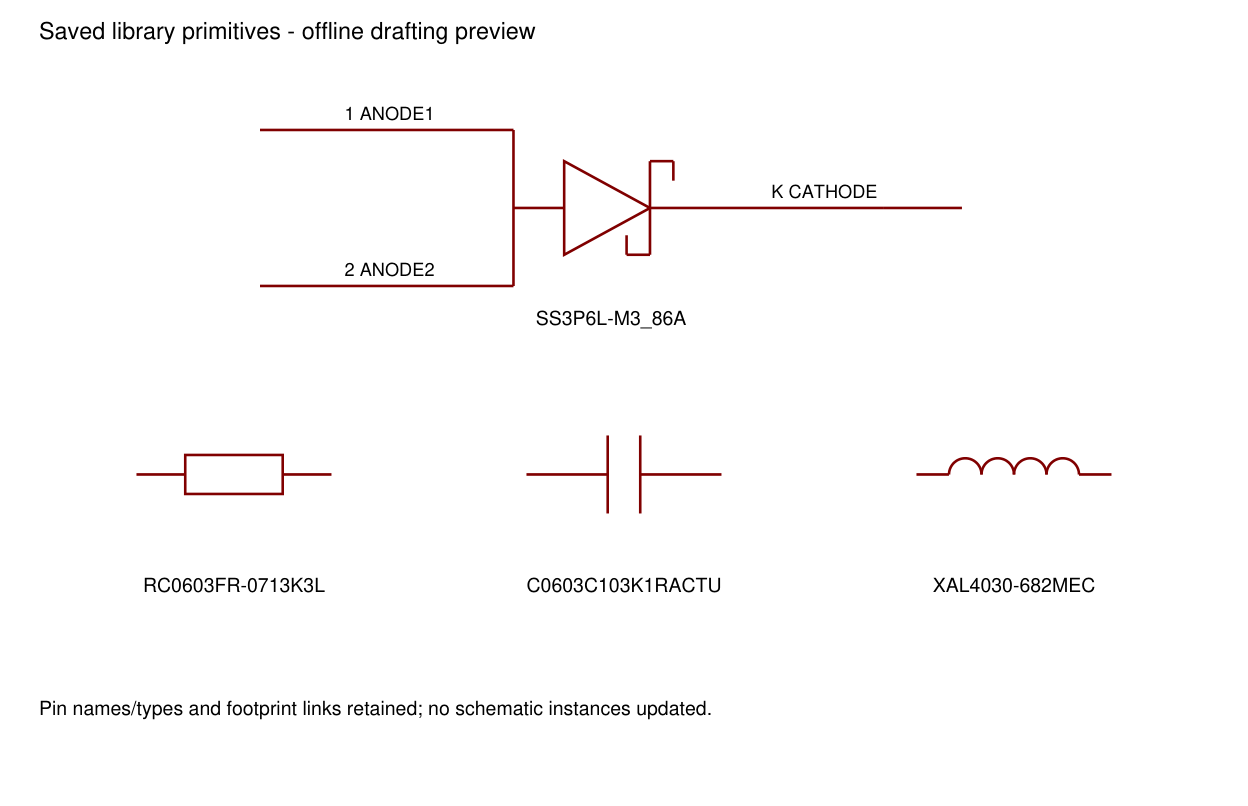
docs/hardware/evidence/tps26620/symbol_preview.png
