anhenaobe/industrial-comunication-gateway/presentation/assets/rendered_slides/Slide1.PNG

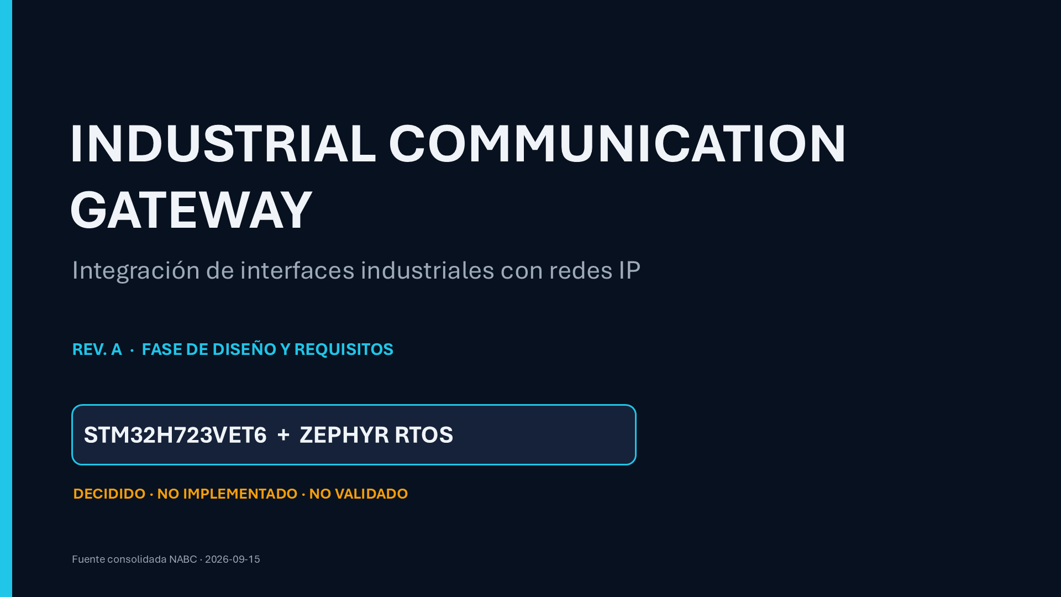
presentation/assets/rendered_slides/Slide1.PNG
