anhenaobe/industrial-comunication-gateway/presentation/assets/rendered_slides/Slide2.PNG

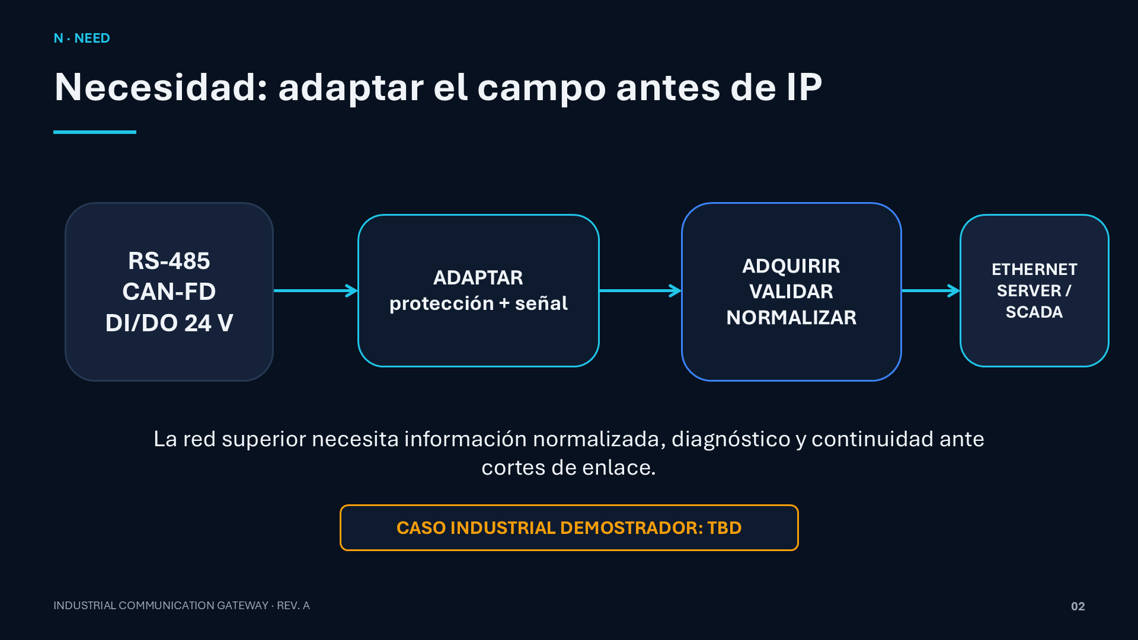
presentation/assets/rendered_slides/Slide2.PNG
