anhenaobe/industrial-comunication-gateway/presentation/assets/rendered_slides/Slide3.PNG

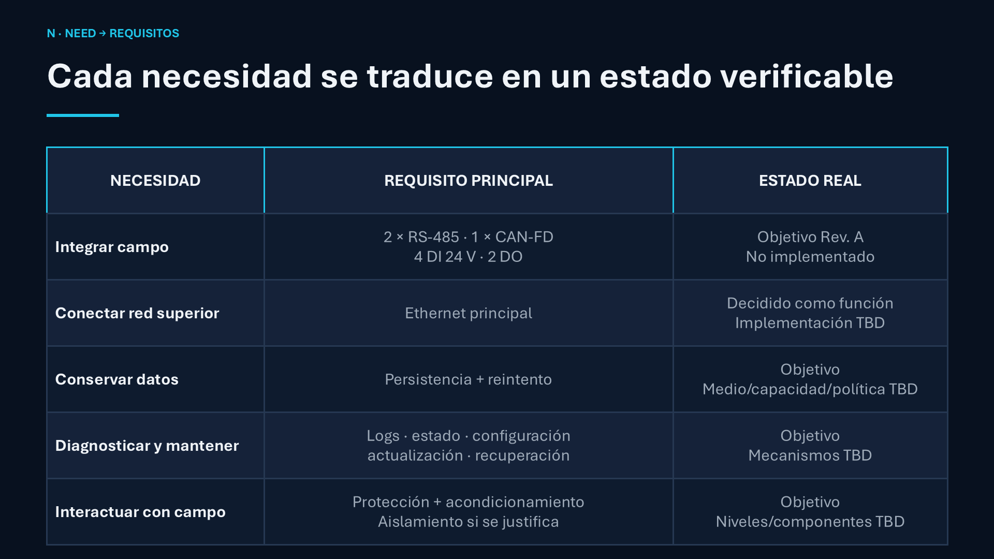
presentation/assets/rendered_slides/Slide3.PNG
