anhenaobe/industrial-comunication-gateway/presentation/assets/rendered_slides/Slide4.PNG

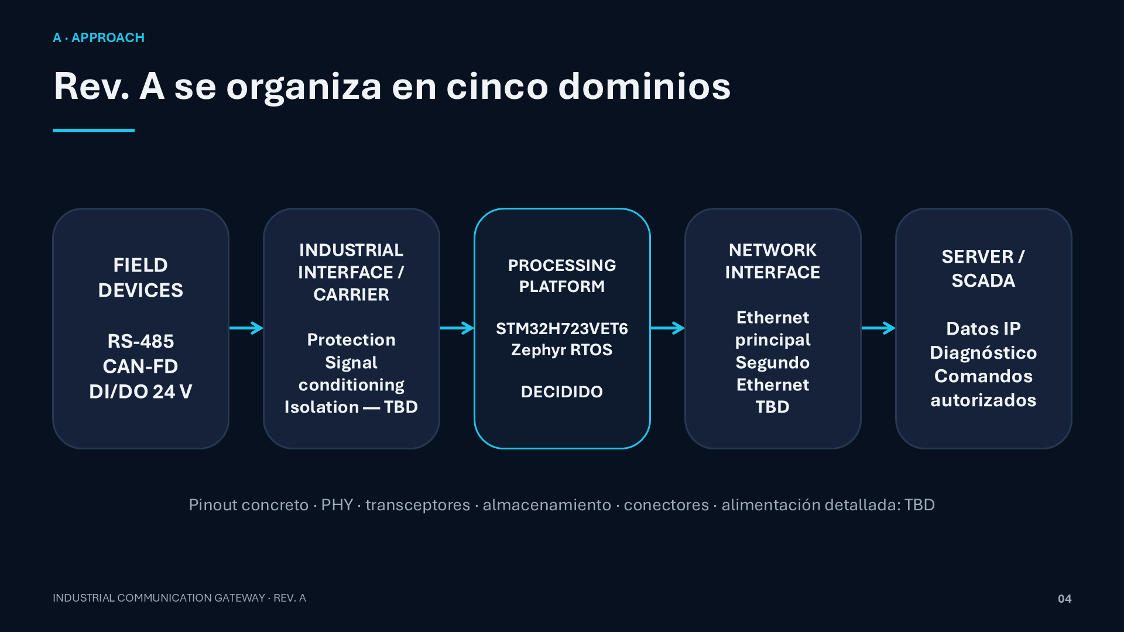
presentation/assets/rendered_slides/Slide4.PNG
