anhenaobe/industrial-comunication-gateway/presentation/assets/rendered_slides/Slide5.PNG

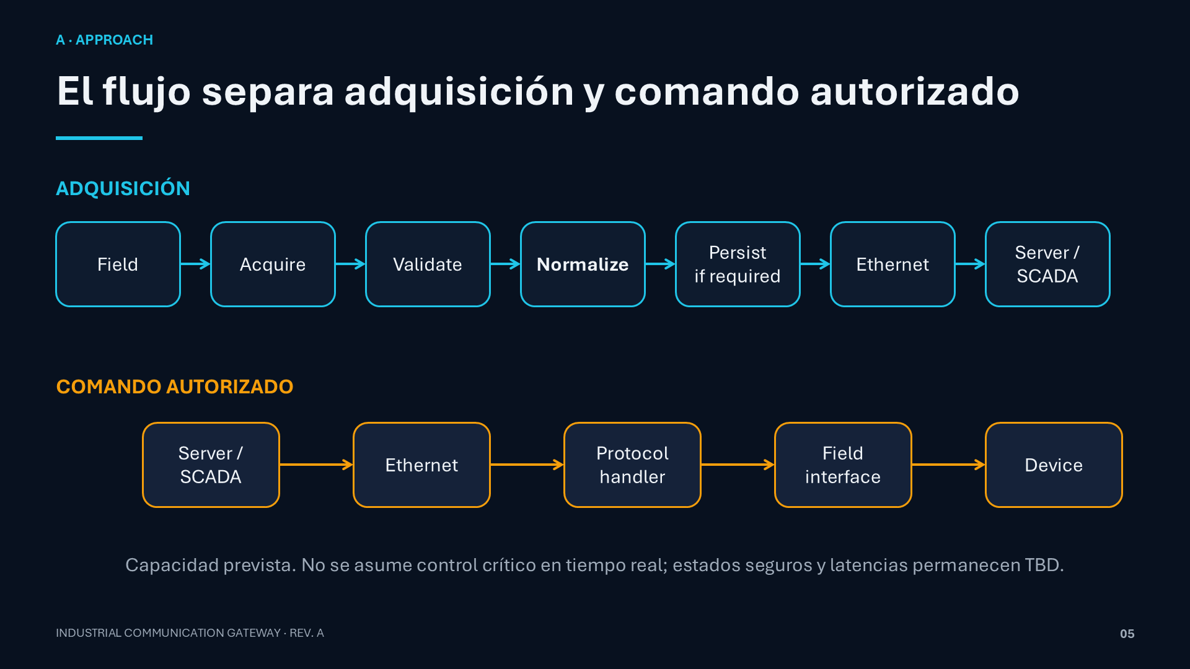
presentation/assets/rendered_slides/Slide5.PNG
