anhenaobe/industrial-comunication-gateway/presentation/assets/rendered_slides/Slide6.PNG

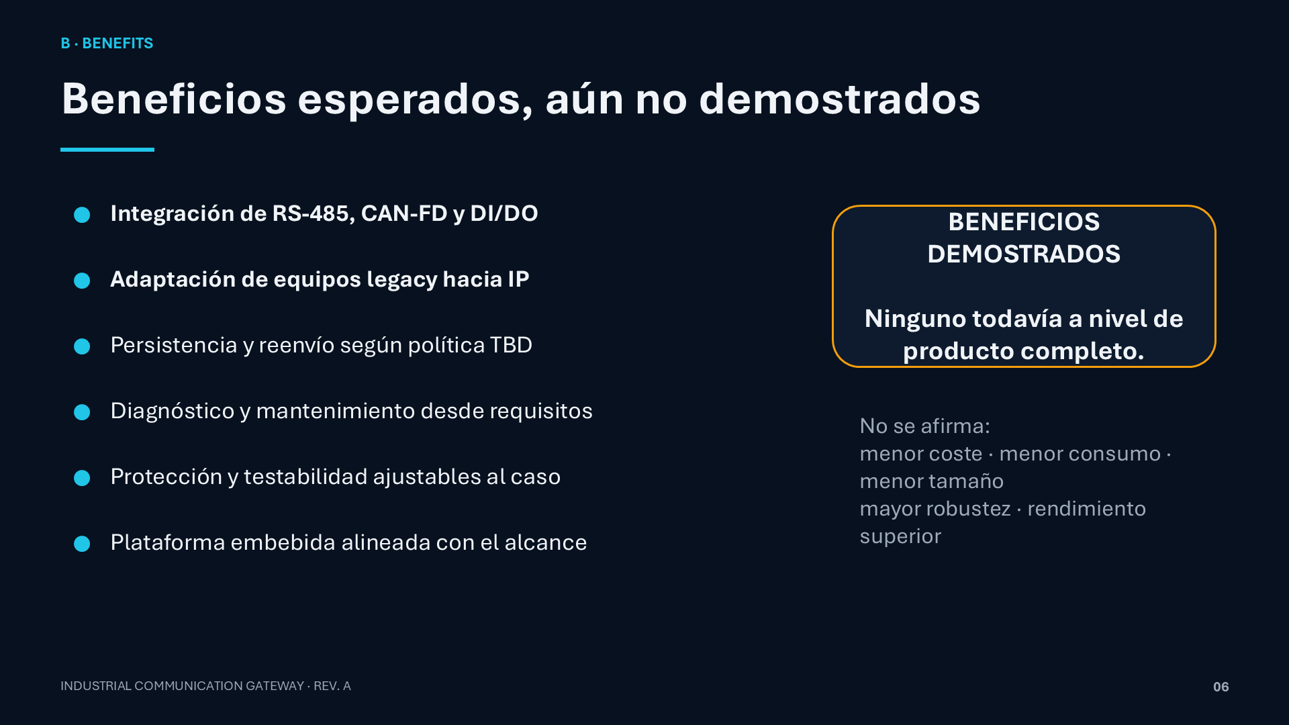
presentation/assets/rendered_slides/Slide6.PNG
