anhenaobe/industrial-comunication-gateway/presentation/assets/rendered_slides/Slide7.PNG

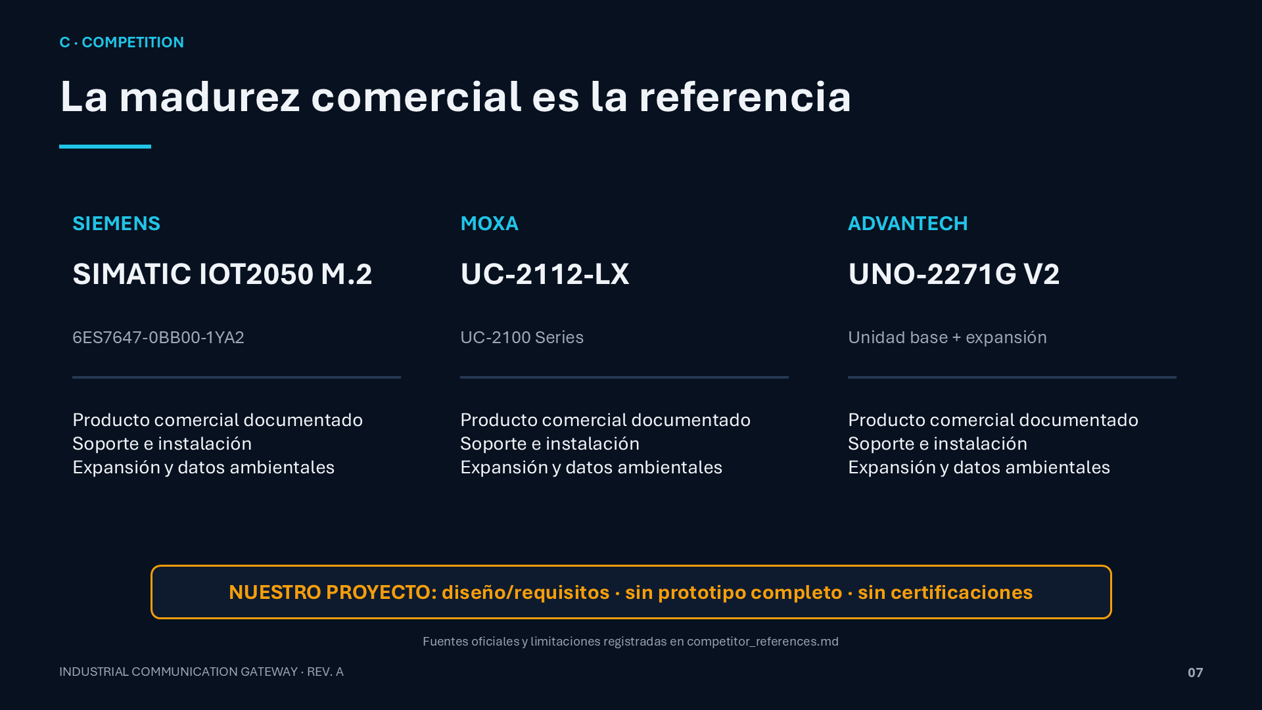
presentation/assets/rendered_slides/Slide7.PNG
