anhenaobe/industrial-comunication-gateway/presentation/assets/rendered_slides/Slide8.PNG

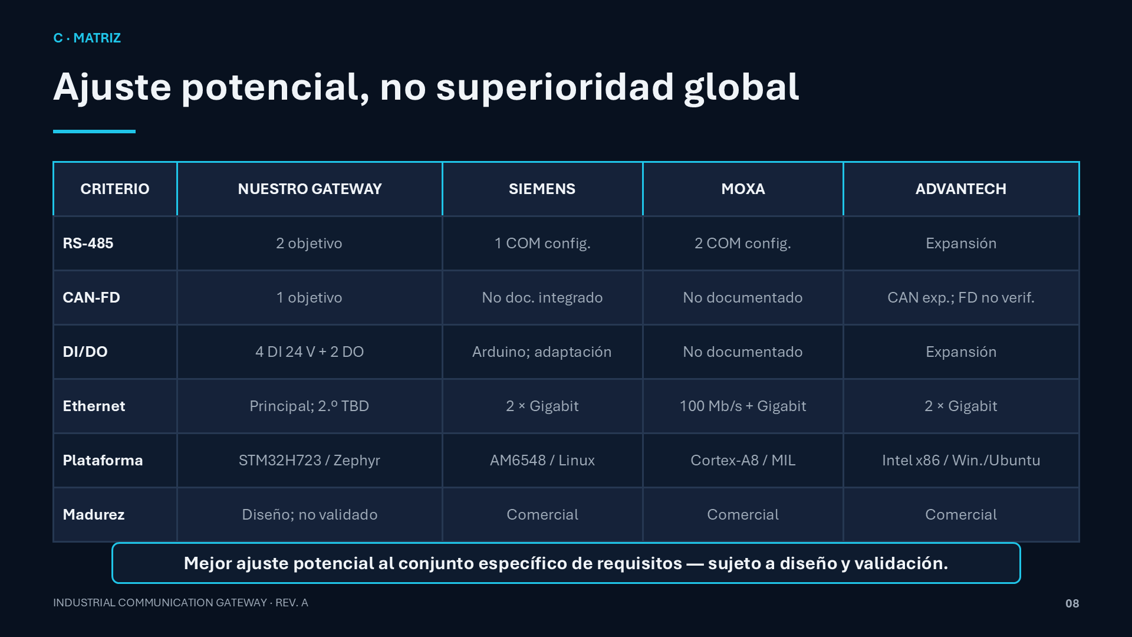
presentation/assets/rendered_slides/Slide8.PNG
