anhenaobe/industrial-comunication-gateway/presentation/assets/rendered_slides/Slide9.PNG

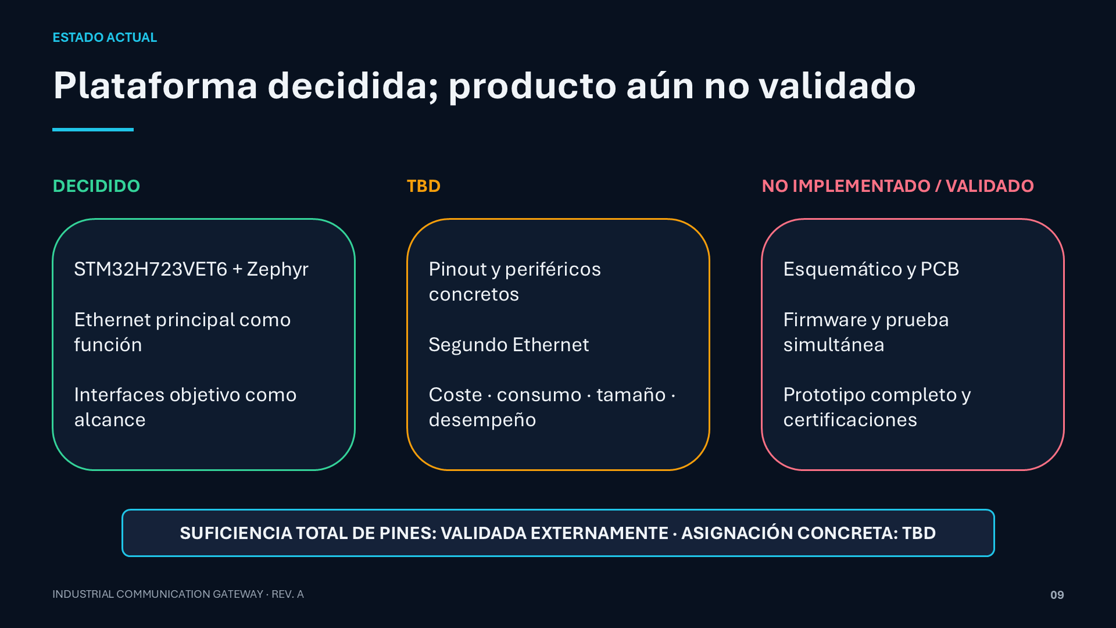
presentation/assets/rendered_slides/Slide9.PNG
