anhenaobe/industrial-comunication-gateway/presentation/assets/rendered_slides/Slide10.PNG

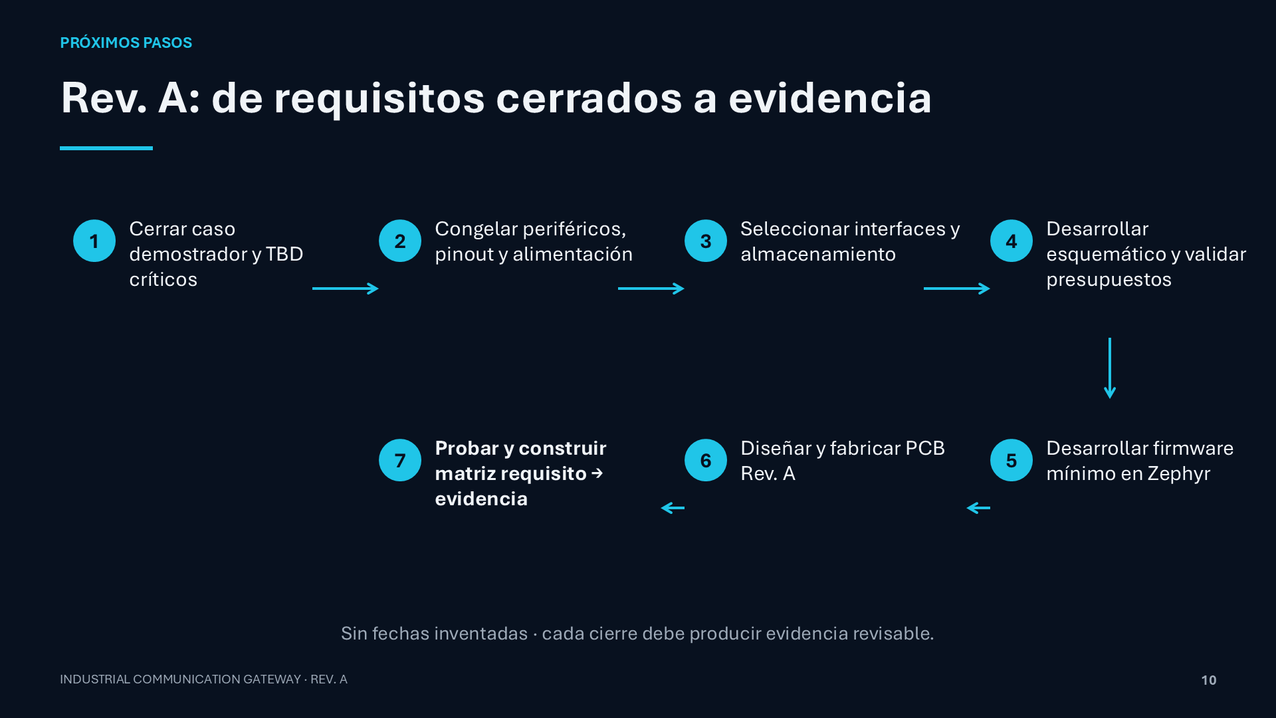
presentation/assets/rendered_slides/Slide10.PNG
