anhenaobe/industrial-comunication-gateway/presentation/industrial_communication_gateway_nabc_preview.png

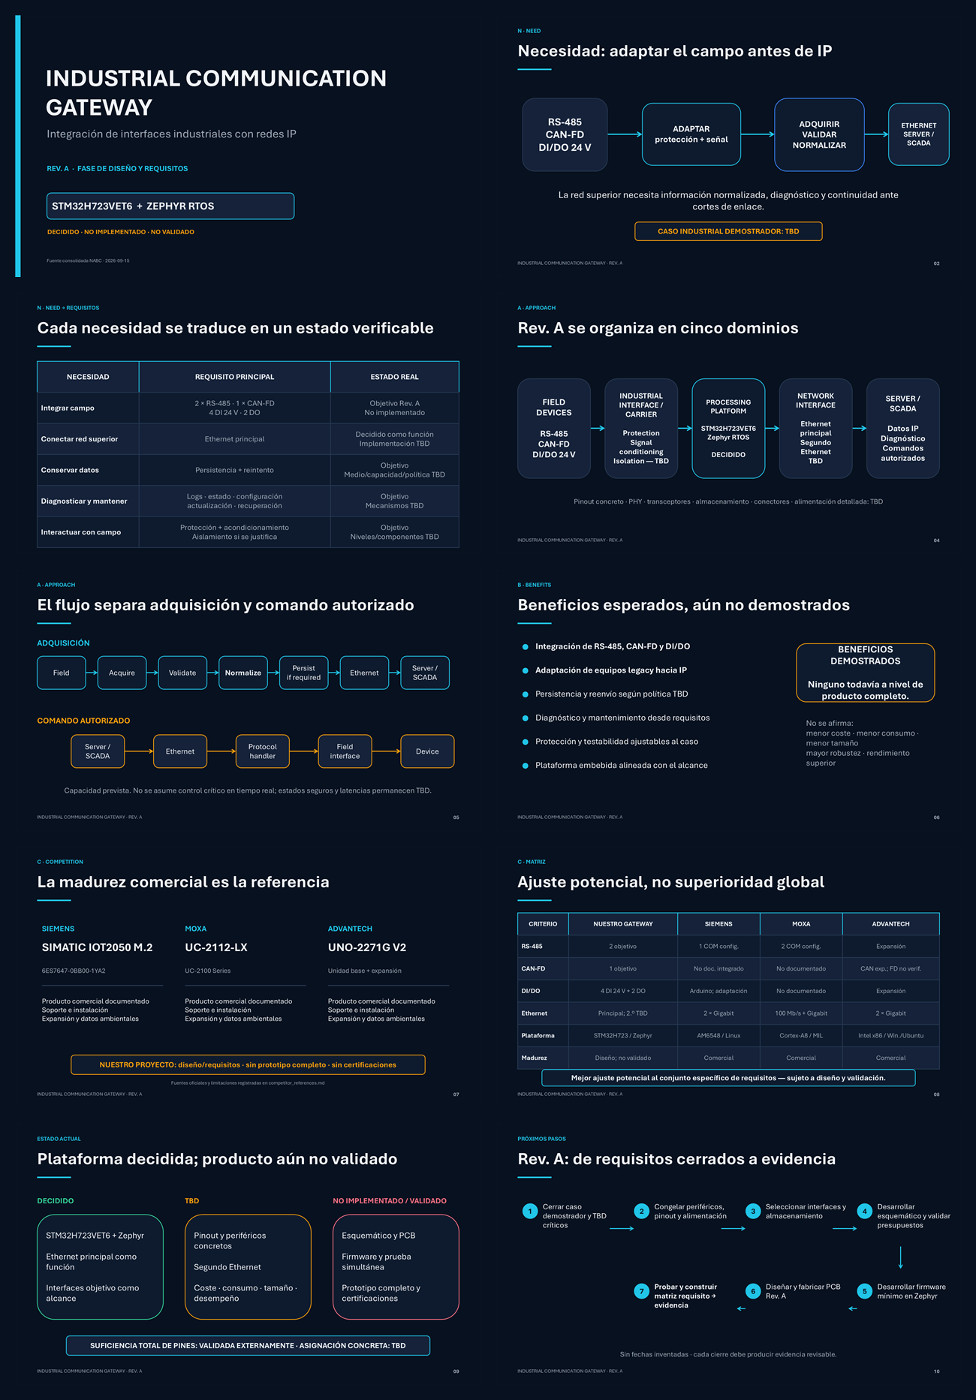
presentation/industrial_communication_gateway_nabc_preview.png
