anhenaobe/industrial-comunication-gateway/docs/hardware/evidence/construction_sync/before_passive_component_selection.md

# Passive and auxiliary component selection - capture revision

Date: November 7, 2026. **CONDITIONAL GO for independent schematic sheets.**
The authoritative current decisions and limits are in
[schematic_readiness_gate.md](schematic_readiness_gate.md). This selection is not
a purchase or manufacturing release. Rev. A is unchanged.

The selected architecture is STM32H723VET6 / DP83826I / HX1188FNL /
SS-7188S-A-NF, one THVD1420, one ATA6561, one ISO1212 for two Type3 inputs,
two BSP75N, one logic-translator candidate and two LMR36015FBRNXR converters,
with one18-30V input. Two independent25MHz active oscillators are selected for
capture; crystal-load networks are DNP. UART default115200baud and CAN nominal1M /
data2M are engineering capture defaults, subject to field-system confirmation.

All111 original requirement IDs remain. The current generator produces122
passive/auxiliary rows and10 active specifications, including one superseded NIS3071
row at quantity0 in final_bom.csv. The current eFuse is TPS26620DRCR. The29 mandatory
passive specifications comprise the historical26-specification scope plus the three
UV/OV ladder specifications; changing MPN/value bindings does not delete requirement IDs.
There are88 known mandatory passive placements, zero unresolved mandatory quantity
groups, and8 conditional placements. CAD active-specification rows retain blank
quantities to avoid counting them as passive placements. These are inventory counts,
not verification claims. See [current input plan](input_protection_reference.md) and
[regenerated counts](evidence/passive_selection_counts.json).

The BOM explicitly changes the MPN/quantity/assembly fields supported by this
closure: confirmed magnetics/jack; complete EVM Ethernet termination variant;
MM2041k threshold resistors; Yageo10k replacing the unqualified FOJAN identity;
two oscillator bypasses; and unselected crystal/filter/split-termination networks
marked DNP. The generator applies [original closure decisions](evidence/electrical_closure/bom_decisions.json),
[academic freeze](evidence/input_protection_freeze/bom_decisions.json), then the latest
[TPS26620 decisions](evidence/tps26620/bom_decisions.json). Regeneration
consumes that overlay and the saved CAD additions, so it cannot restore old
unselected magnetics, crystal loads or FOJAN identities. Original files are
preserved in `evidence/electrical_closure/baseline/`.

Library resources now have64 symbols and35 footprints. Source libraries pass
file structural validation; the existing46-symbol/23-footprint compiled IntLib is
stale. TPS26620's thermal-pad native custom-shape/net inheritance check remains
unfinished. Six warnings from the historical compilation are not current validation.
CAD_CANDIDATE is independent of electrical/application approval. The graphics and
preserved pin/footprint mappings are documented in
[symbol_library_verification.md](symbol_library_verification.md). The BSP75N numbered
map remains unfinished; no schematic or PCB was modified.

Availability: no unobserved part is labelled JLC Basic/Preferred. C233005/MM204
has public Extended classification and incomplete out-of-stock evidence; exact
assembly quantity is unknown. Other stock is unknown. Confirmed RJ45 selection
is retained independently from sourcing risk. No P0 design was changed to save
a small passive cost.

## Source identifiers used in the CSV

| ID | Manufacturer source and decisive locator |
|---|---|
| S1 | ST DS13313 Rev5, existing `DS_stm32h723zg.pdf`: LQFP100 fig5/table7; VCAP table14; HSE table31; IO table51; current table20 |
| S2 | [ST AN5419 Rev3](https://www.st.com/resource/en/application_note/an5419-getting-started-with-stm32h723733-stm32h725735-and-stm32h730-mcu-hardware-development-stmicroelectronics.pdf): table2, figures3/15/19, sections3/6 |
| S3 | TI SNLS647I `dp83826i.pdf`: pin table5-1, section7.6 clocks/reset, section8.3.10, straps tables8-6..8-10, section9 |
| S4 | Existing DP83826EVM SNLU262A: fig6-2/native sheet3, table7-1. Current CEXT requirement overrides its older C57 value |
| S5 | TI SNVSB49D `lmr36015.pdf`: exact FB variant; section10.1, table10-1 explicitly RATED COUT columns; equations3-11; sections11-12 |
| S6 | TI SLLSF78B `thvd1400.pdf`: shared1400/1420 bus ratings, figure8-5/table8-1, section9/10.1. Example uses1400/5V and two10ohm resistors |
| S7 | Existing Microchip ATA656x EVKit DS50002649A: sections3.3-3.8, appendixA/tableB-2 |
| S8 | Microchip DS20005991B `20005991B.pdf`: ATA6561 pin table, modes, figure1-6 and table2.0 |
| S9 | TI SCES516N `sn74lvc2t45.pdf`: table5.5 loaded VOH, supply sequencing and DIR; no OE |
| S10 | Diodes DS33016 Rev7-2 `BSP75N.pdf`: Source-tab note, VIN>=4.5V protection, input current, thermal/current tables and single-pulse conditions |
| S11 | TI SLLSEY7G `iso1212.pdf`: table4-2 SUB ownership, DC table5.9, equations1-4, figure8-2/table8-1, section8.4 |
| FCLK | Local Kyocera TNY1T-H1-DEX01-11: pp3-4,6 pinout, standby, CMOS limits, load,10nF bypass and lands |
| FETH | Local Pulse HX1188FNL revB sheets2-3; Cinch CT710001 B0 component-side numbered/hole drawing |
| FESD / FSM | Local TI SLVSBO7O table4-2 and DQA0010A; Bourns CDSOT23-SM712 pp1-3 |
| FDI | Manufacturer-authored Firstohm MM Rev08-March-2023 pp75-78, acquired from Alfatec; MM204 normal curve and reflow lands, not MM204P |
| FL | Local Coilcraft document806 Rev02/25/26 pp1,4 exact XAL4030/XAL4040 data/lands |
| FIN | TDK-Lambda external DC-DC components figure5; Vishay88987; Littelfuse SMBJ electrical table. Prototype front-end remains unqualified |
| P1-P5/P10 | Existing exact KEMET/Yageo nominal-value sheets in `hardware/academic_rev1/libraries/sources/passives/` and DI source PDFs |
| P6-P9 | Coilcraft/TDK/Samsung exact-part data from earlier work; TDK DC-bias/ESR qualification remains open, not filled with nominal capacitance |

Supporting calculations, manufacturer acquisition URLs/hashes, compiler messages,
native-file preservation checks and change records are under
`evidence/electrical_closure/`. The generated tables below are the current CSV
view, including explicit unresolved and DNP requirements.

<!-- GENERATED_BOM_TABLES -->

### BOM MCU

| ID | Subsistema | Funcion | Referencia principal (fabricante) | Valor nominal | Tolerancia | Tension/corriente nominal | Potencia | Encapsulado | MPN recomendado/candidato | Simbolo candidato | Footprint candidato | Origen CAD | Fuente valor electrico | Estado global | Observaciones | Cantidad | Montaje | Estado electrico | Estado CAD |
|---|---|---|---|---|---|---|---|---|---|---|---|---|---|---|---|---|---|---|---|
| MCU_CVDD1 | MCU | Desacoplo VDD pin 11 | STM32H723VET6 | 100 nF | 10% | 50 V; X7R; -55..125 C | N/A | 0603 | C0603C104K5RACTU | GW_C0603C104K5RACTU_dc5e12a5 | GW_CAND_0603_cap | hardware/academic_rev1/libraries/Gateway_Academic.SchLib + Gateway_Academic.PcbLib | S1 fig5/tabla7; S2 tabla2 p7 | PROVISIONAL | Ficha KEMET local p1. Adaptar parametros; no usar el Y5V 0603F104Z500CT como equivalente. Modelo candidato existente; sin cotejo visual de pads/pines en Altium. | 1 | REQUIRED | PROVISIONAL | CAD_CANDIDATE |
| MCU_CVDD2 | MCU | Desacoplo VDD pin 27 | STM32H723VET6 | 100 nF | 10% | 50 V; X7R; -55..125 C | N/A | 0603 | C0603C104K5RACTU | GW_C0603C104K5RACTU_dc5e12a5 | GW_CAND_0603_cap | hardware/academic_rev1/libraries/Gateway_Academic.SchLib + Gateway_Academic.PcbLib | S1 fig5/tabla7; S2 tabla2 p7 | PROVISIONAL | Ficha KEMET local p1. Adaptar parametros; no usar el Y5V 0603F104Z500CT como equivalente. Modelo candidato existente; sin cotejo visual de pads/pines en Altium. | 1 | REQUIRED | PROVISIONAL | CAD_CANDIDATE |
| MCU_CVDD3 | MCU | Desacoplo VDD pin 50 | STM32H723VET6 | 100 nF | 10% | 50 V; X7R; -55..125 C | N/A | 0603 | C0603C104K5RACTU | GW_C0603C104K5RACTU_dc5e12a5 | GW_CAND_0603_cap | hardware/academic_rev1/libraries/Gateway_Academic.SchLib + Gateway_Academic.PcbLib | S1 fig5/tabla7; S2 tabla2 p7 | PROVISIONAL | Ficha KEMET local p1. Adaptar parametros; no usar el Y5V 0603F104Z500CT como equivalente. Modelo candidato existente; sin cotejo visual de pads/pines en Altium. | 1 | REQUIRED | PROVISIONAL | CAD_CANDIDATE |
| MCU_CVDD4 | MCU | Desacoplo VDD pin 75 | STM32H723VET6 | 100 nF | 10% | 50 V; X7R; -55..125 C | N/A | 0603 | C0603C104K5RACTU | GW_C0603C104K5RACTU_dc5e12a5 | GW_CAND_0603_cap | hardware/academic_rev1/libraries/Gateway_Academic.SchLib + Gateway_Academic.PcbLib | S1 fig5/tabla7; S2 tabla2 p7 | PROVISIONAL | Ficha KEMET local p1. Adaptar parametros; no usar el Y5V 0603F104Z500CT como equivalente. Modelo candidato existente; sin cotejo visual de pads/pines en Altium. | 1 | REQUIRED | PROVISIONAL | CAD_CANDIDATE |
| MCU_CVDD5 | MCU | Desacoplo VDD pin 100 | STM32H723VET6 | 100 nF | 10% | 50 V; X7R; -55..125 C | N/A | 0603 | C0603C104K5RACTU | GW_C0603C104K5RACTU_dc5e12a5 | GW_CAND_0603_cap | hardware/academic_rev1/libraries/Gateway_Academic.SchLib + Gateway_Academic.PcbLib | S1 fig5/tabla7; S2 tabla2 p7 | PROVISIONAL | Ficha KEMET local p1. Adaptar parametros; no usar el Y5V 0603F104Z500CT como equivalente. Modelo candidato existente; sin cotejo visual de pads/pines en Altium. | 1 | REQUIRED | PROVISIONAL | CAD_CANDIDATE |
| MCU_CBULK | MCU | Reserva VDD | STM32H723VET6 | 4.7 uF | 10% | 16 V; X7R | N/A | 0805 | C0805C475K4RACTU | GW_C0805C475K4RACTU_82374e08 | GW_CAND_0805_cap | hardware/academic_rev1/libraries/Gateway_Academic.SchLib + Gateway_Academic.PcbLib | S2 tabla2 p7; P3 ficha KEMET p1 | PROVISIONAL | Ceff a 3.3 V pendiente; no sustituir por 10 uF solo por disponibilidad. Modelo candidato existente; sin cotejo visual de pads/pines en Altium. | 1 | REQUIRED | PROVISIONAL | CAD_CANDIDATE |
| MCU_CVDDA1 | MCU | VDDA pin 21; reserva | STM32H723VET6 | 1 uF | 10% | 50 V; X5R; -55..85 C | N/A | 0603 | CL10A105KB8NNNC | GW_CL10A105KB8NNNC_c3932faa | GW_CAND_0603_cap | hardware/academic_rev1/libraries/Gateway_Academic.SchLib + Gateway_Academic.PcbLib | S1 fig5; S2 tabla2 pp7-8 | PROVISIONAL | Samsung ficha oficial; Ceff/ESR pendientes por aplicacion. Limite X5R 85 C: no homologado para ambiente superior. Modelo candidato existente; sin cotejo visual de pads/pines en Altium. | 1 | REQUIRED | PROVISIONAL | CAD_CANDIDATE |
| MCU_CVDDA2 | MCU | VDDA pin 21; HF | STM32H723VET6 | 100 nF | 10% | 50 V; X7R; -55..125 C | N/A | 0603 | C0603C104K5RACTU | GW_C0603C104K5RACTU_dc5e12a5 | GW_CAND_0603_cap | hardware/academic_rev1/libraries/Gateway_Academic.SchLib + Gateway_Academic.PcbLib | S1 fig5; S2 tabla2 pp7-8 | PROVISIONAL | Ficha KEMET local p1. Adaptar parametros; no usar el Y5V 0603F104Z500CT como equivalente. Modelo candidato existente; sin cotejo visual de pads/pines en Altium. | 1 | REQUIRED | PROVISIONAL | CAD_CANDIDATE |
| MCU_CVBAT1 | MCU | VBAT pin 6; reserva | STM32H723VET6 | 1 uF | 10% | 50 V; X5R; -55..85 C | N/A | 0603 | CL10A105KB8NNNC | GW_CL10A105KB8NNNC_c3932faa | GW_CAND_0603_cap | hardware/academic_rev1/libraries/Gateway_Academic.SchLib + Gateway_Academic.PcbLib | S1 fig5; S2 tabla2 pp7-8 | PROVISIONAL | Samsung ficha oficial; Ceff/ESR pendientes por aplicacion. Limite X5R 85 C: no homologado para ambiente superior. Modelo candidato existente; sin cotejo visual de pads/pines en Altium. | 1 | REQUIRED | PROVISIONAL | CAD_CANDIDATE |
| MCU_CVBAT2 | MCU | VBAT pin 6; HF | STM32H723VET6 | 100 nF | 10% | 50 V; X7R; -55..125 C | N/A | 0603 | C0603C104K5RACTU | GW_C0603C104K5RACTU_dc5e12a5 | GW_CAND_0603_cap | hardware/academic_rev1/libraries/Gateway_Academic.SchLib + Gateway_Academic.PcbLib | S1 fig5; S2 tabla2 pp7-8 | PROVISIONAL | Ficha KEMET local p1. Adaptar parametros; no usar el Y5V 0603F104Z500CT como equivalente. Modelo candidato existente; sin cotejo visual de pads/pines en Altium. | 1 | REQUIRED | PROVISIONAL | CAD_CANDIDATE |
| MCU_CVREF1 | MCU | VREF pin 20; reserva | STM32H723VET6 | 1 uF | 10% | 50 V; X5R; -55..85 C | N/A | 0603 | CL10A105KB8NNNC | GW_CL10A105KB8NNNC_c3932faa | GW_CAND_0603_cap | hardware/academic_rev1/libraries/Gateway_Academic.SchLib + Gateway_Academic.PcbLib | S1 fig5; S2 tabla2 pp7-8 | PROVISIONAL | Samsung ficha oficial; Ceff/ESR pendientes por aplicacion. Limite X5R 85 C: no homologado para ambiente superior. Modelo candidato existente; sin cotejo visual de pads/pines en Altium. | 1 | REQUIRED | PROVISIONAL | CAD_CANDIDATE |
| MCU_CVREF2 | MCU | VREF pin 20; HF | STM32H723VET6 | 100 nF | 10% | 50 V; X7R; -55..125 C | N/A | 0603 | C0603C104K5RACTU | GW_C0603C104K5RACTU_dc5e12a5 | GW_CAND_0603_cap | hardware/academic_rev1/libraries/Gateway_Academic.SchLib + Gateway_Academic.PcbLib | S1 fig5; S2 tabla2 pp7-8 | PROVISIONAL | Ficha KEMET local p1. Adaptar parametros; no usar el Y5V 0603F104Z500CT como equivalente. Modelo candidato existente; sin cotejo visual de pads/pines en Altium. | 1 | REQUIRED | PROVISIONAL | CAD_CANDIDATE |
| MCU_CVCAP1 | MCU | Salida LDO VCAP pin 48 | STM32H723VET6 | 2.2 uF | 10% candidato; ST permite 20% | 10 V; X7R; ESR <100 mOhm | N/A | 0603 | C0603C225K8RACTU | GW_C0603C225K8RACTU_46503424 | GW_CAND_0603_cap | hardware/academic_rev1/libraries/Gateway_Academic.SchLib + Gateway_Academic.PcbLib | S1 tabla14 p92; P2 ficha KEMET p1 | PROVISIONAL | Falta ESR y capacitancia bajo VCORE/temperatura/envejecimiento. No conectar 3.3 V ni carga externa a VCAP. Modelo candidato existente; sin cotejo visual de pads/pines en Altium. | 1 | REQUIRED | PROVISIONAL | CAD_CANDIDATE |
| MCU_CVCAP2 | MCU | Salida LDO VCAP pin 73 | STM32H723VET6 | 2.2 uF | 10% candidato; ST permite 20% | 10 V; X7R; ESR <100 mOhm | N/A | 0603 | C0603C225K8RACTU | GW_C0603C225K8RACTU_46503424 | GW_CAND_0603_cap | hardware/academic_rev1/libraries/Gateway_Academic.SchLib + Gateway_Academic.PcbLib | S1 tabla14 p92; P2 ficha KEMET p1 | PROVISIONAL | Falta ESR y capacitancia bajo VCORE/temperatura/envejecimiento. No conectar 3.3 V ni carga externa a VCAP. Modelo candidato existente; sin cotejo visual de pads/pines en Altium. | 1 | REQUIRED | PROVISIONAL | CAD_CANDIDATE |
| MCU_CNRST | MCU | NRST pin14 a GND | STM32H723VET6 | 100 nF | 10% | 50 V; X7R; -55..125 C | N/A | 0603 | C0603C104K5RACTU | GW_C0603C104K5RACTU_dc5e12a5 | GW_CAND_0603_cap | hardware/academic_rev1/libraries/Gateway_Academic.SchLib + Gateway_Academic.PcbLib | S1 fig18 p135 (0.1 uF) | PROVISIONAL | Ficha KEMET local p1. Adaptar parametros; no usar el Y5V 0603F104Z500CT como equivalente. Modelo candidato existente; sin cotejo visual de pads/pines en Altium. | 1 | REQUIRED | PROVISIONAL | CAD_CANDIDATE |
| MCU_RBOOT | MCU | BOOT0 pin94 a GND | STM32H723VET6 | 10 kOhm | 1% | 75 V maximum; power-limited working voltage | 0.1 W at70C | 0603 | RC0603FR-0710KL | RC0603FR-0710KL | GW_CAND_0603_res | hardware/academic_rev1/libraries/Gateway_Academic.SchLib + Gateway_Academic.PcbLib | S2 seccion5.2 fig19 p30: 10 kOhm ejemplo tipico | CALCULATED | 10k Yageo to GND, BOOT0 recovery access to3V3; AN5419 example adopted. Check option bytes during commissioning. | 1 | REQUIRED | ELECTRICAL_VERIFIED | CAD_CANDIDATE |
| MCU_YHSE | MCU | Independent MCU HSE bypass clock | STM32H723VET6 | 25 MHz active CMOS | total +/-30 ppm | 1.71..3.63 V supply; 3.3 V selected; load <=15 pF | N/A | 2.0x1.6 mm 4-pad | KC2016Z25.0000C15XXK | KC2016Z25.0000C15XXK | GW_KC2016Z_KYOCERA | hardware/academic_rev1/libraries/Gateway_Academic.SchLib + Gateway_Academic.PcbLib | FCLK Kyocera TNY1T-H1-DEX01-11 pp3-4,6; S1 table31; S3 sections7.6,8.3.10 | PROVISIONAL | Selected independent 25MHz CMOS oscillator, one receiver each. VCC4=3V3; GND2=GND; EN1=3V3; OUT3 to PH0 or PHY XI9. No load capacitors. <=15pF total load and PHY phase-noise mask remain qualification gates. | 1 | REQUIRED | PROVISIONAL | CAD_CANDIDATE |
| MCU_CHSE | MCU | Capacitores de carga HSE | STM32H723VET6 | TBD | TBD | TBD | N/A | TBD | TBD | MISSING | MISSING | MISSING | FCLK Kyocera TNY1T-H1-DEX01-11 pp3-4,6; S1 table31; S3 sections7.6,8.3.10 | CALCULATED | Not applicable to selected active CMOS oscillator; retain original requirement ID as DNP. No crystal load/drive network selected. | 0 | DNP | ELECTRICAL_VERIFIED | CAD_BLOCKED |
| MCU_RHSE | MCU | Limitacion drive oscilador HSE si necesaria | STM32H723VET6 | TBD | TBD | TBD | N/A | TBD | TBD | MISSING | MISSING | MISSING | FCLK Kyocera TNY1T-H1-DEX01-11 pp3-4,6; S1 table31; S3 sections7.6,8.3.10 | CALCULATED | Not applicable to selected active CMOS oscillator; retain original requirement ID as DNP. No crystal load/drive network selected. | 0 | DNP | ELECTRICAL_VERIFIED | CAD_BLOCKED |
| MCU_LSE | MCU | Red LSE RTC | STM32H723VET6 | TBD | TBD | TBD | N/A | TBD | TBD | MISSING | MISSING | MISSING | S2 seccion3 | PROVISIONAL | Sin requisito RTC preciso en alcance reducido; no incorporar cristal ni dos cargas por defecto. | 0 | DNP | PROVISIONAL | CAD_BLOCKED |
| MCU_JSWD | MCU | SWD | STM32H723VET6 | 6 posiciones | TBD | TBD | N/A | TBD | TBD | GW_H_Male_6x1_TH_100mil_c0450d1e | GW_CAND_H_6x1_TH_100mil | hardware/academic_rev1/libraries/Gateway_Academic.SchLib + Gateway_Academic.PcbLib | S2 seccion6; propuesta pinout pendiente | BLOCKED | Pinout, MPN y orientacion pendientes. No alimentar VDD desde VTref; SWD PA13/PA14 y NRST. Modelo candidato existente; sin cotejo visual de pads/pines en Altium. | 1 | REQUIRED | ELECTRICAL_BLOCKED | CAD_CANDIDATE |
| MCU_SRESET | MCU | Pulsador reset | STM32H723VET6 | SPST-NO | TBD | TBD | N/A | TBD | TBD | GW_Sw_PUSH_4.5x4.5x5.0xmm_0f078dd9 | MISSING | hardware/academic_rev1/libraries/Gateway_Academic.SchLib + Gateway_Academic.PcbLib | S2 seccion6; propuesta pinout pendiente | BLOCKED | Pinout, MPN y orientacion pendientes. No alimentar VDD desde VTref; SWD PA13/PA14 y NRST. Modelo candidato existente; sin cotejo visual de pads/pines en Altium. | 1 | REQUIRED | ELECTRICAL_BLOCKED | CAD_BLOCKED |
| MCU_JBOOT | MCU | Recuperacion BOOT | STM32H723VET6 | 2 posiciones | TBD | TBD | N/A | TBD | TBD | GW_H_Male_2x1_TH_100mil_f89d9046 | GW_CAND_H_2x1_TH_100mil | hardware/academic_rev1/libraries/Gateway_Academic.SchLib + Gateway_Academic.PcbLib | S2 seccion6; propuesta pinout pendiente | BLOCKED | Pinout, MPN y orientacion pendientes. No alimentar VDD desde VTref; SWD PA13/PA14 y NRST. Modelo candidato existente; sin cotejo visual de pads/pines en Altium. | 1 | REQUIRED | ELECTRICAL_BLOCKED | CAD_CANDIDATE |
| MCU_COSC | MCU | 10nF bypass for MCU active oscillator | KC2016Z25.0000C15XXK | 10 nF | 10% | 100 V; X7R; -55..125 C | N/A | 0603 | C0603C103K1RACTU | GW_C0603C103K1RACTU_97f3ee33 | GW_CAND_0603_cap | hardware/academic_rev1/libraries/Gateway_Academic.SchLib + Gateway_Academic.PcbLib | FCLK Kyocera TNY1T-H1-DEX01-11 pp3-4,6; S1 table31; S3 sections7.6,8.3.10 | CALCULATED | Kyocera section8 requires10nF close toVCC4/GND2. No crystal load capacitors. | 1 | REQUIRED | ELECTRICAL_VERIFIED | CAD_CANDIDATE |

### BOM Ethernet

| ID | Subsistema | Funcion | Referencia principal (fabricante) | Valor nominal | Tolerancia | Tension/corriente nominal | Potencia | Encapsulado | MPN recomendado/candidato | Simbolo candidato | Footprint candidato | Origen CAD | Fuente valor electrico | Estado global | Observaciones | Cantidad | Montaje | Estado electrico | Estado CAD |
|---|---|---|---|---|---|---|---|---|---|---|---|---|---|---|---|---|---|---|---|
| ETH_CVDDA3V3_HF | Ethernet | VDDA3V3 HF | DP83826IRHBR | 100 nF | 10% | 50 V; X7R; -55..125 C | N/A | 0603 | C0603C104K5RACTU | GW_C0603C104K5RACTU_dc5e12a5 | GW_CAND_0603_cap | hardware/academic_rev1/libraries/Gateway_Academic.SchLib + Gateway_Academic.PcbLib | S3 fig9-6 p99 | PROVISIONAL | Ficha KEMET local p1. Adaptar parametros; no usar el Y5V 0603F104Z500CT como equivalente. Modelo candidato existente; sin cotejo visual de pads/pines en Altium. | 1 | REQUIRED | PROVISIONAL | CAD_CANDIDATE |
| ETH_CVDDA3V3_10N | Ethernet | VDDA3V3 HF | DP83826IRHBR | 10 nF | 10% | 100 V; X7R; -55..125 C | N/A | 0603 | C0603C103K1RACTU | GW_C0603C103K1RACTU_97f3ee33 | GW_CAND_0603_cap | hardware/academic_rev1/libraries/Gateway_Academic.SchLib + Gateway_Academic.PcbLib | S3 fig9-6 p99 | PROVISIONAL | Ficha KEMET local DI_CIN p1; no confundir con externo CL10B103KA8WPNC 25 V. Modelo candidato existente; sin cotejo visual de pads/pines en Altium. | 1 | REQUIRED | PROVISIONAL | CAD_CANDIDATE |
| ETH_CVDDA3V3_1U | Ethernet | VDDA3V3 reserva | DP83826IRHBR | 1 uF | 10% | 50 V; X5R; -55..85 C | N/A | 0603 | CL10A105KB8NNNC | GW_CL10A105KB8NNNC_c3932faa | GW_CAND_0603_cap | hardware/academic_rev1/libraries/Gateway_Academic.SchLib + Gateway_Academic.PcbLib | S3 fig9-6 p99 | PROVISIONAL | Samsung ficha oficial; Ceff/ESR pendientes por aplicacion. Limite X5R 85 C: no homologado para ambiente superior. Modelo candidato existente; sin cotejo visual de pads/pines en Altium. | 1 | REQUIRED | PROVISIONAL | CAD_CANDIDATE |
| ETH_CVDDA3V3_10U | Ethernet | VDDA3V3 reserva | DP83826IRHBR | 10 uF | 10% | 25 V; X5R; -55..85 C | N/A | 0805 | CL21A106KAYNNNE | GW_CL21A106KAYNNNE_c6e24382 | GW_CAND_0805_cap | hardware/academic_rev1/libraries/Gateway_Academic.SchLib + Gateway_Academic.PcbLib | S3 fig9-6 p99; Samsung ficha oficial | PROVISIONAL | Ceff a 3.3 V y temperatura pendientes. No usar para entrada 30 V. Modelo candidato existente; sin cotejo visual de pads/pines en Altium. | 1 | REQUIRED | PROVISIONAL | CAD_CANDIDATE |
| ETH_CVDDIO_HF | Ethernet | VDDIO HF | DP83826IRHBR | 100 nF | 10% | 50 V; X7R; -55..125 C | N/A | 0603 | C0603C104K5RACTU | GW_C0603C104K5RACTU_dc5e12a5 | GW_CAND_0603_cap | hardware/academic_rev1/libraries/Gateway_Academic.SchLib + Gateway_Academic.PcbLib | S3 fig9-6 p99 | PROVISIONAL | Ficha KEMET local p1. Adaptar parametros; no usar el Y5V 0603F104Z500CT como equivalente. Modelo candidato existente; sin cotejo visual de pads/pines en Altium. | 1 | REQUIRED | PROVISIONAL | CAD_CANDIDATE |
| ETH_CVDDIO_10N | Ethernet | VDDIO HF | DP83826IRHBR | 10 nF | 10% | 100 V; X7R; -55..125 C | N/A | 0603 | C0603C103K1RACTU | GW_C0603C103K1RACTU_97f3ee33 | GW_CAND_0603_cap | hardware/academic_rev1/libraries/Gateway_Academic.SchLib + Gateway_Academic.PcbLib | S3 fig9-6 p99 | PROVISIONAL | Ficha KEMET local DI_CIN p1; no confundir con externo CL10B103KA8WPNC 25 V. Modelo candidato existente; sin cotejo visual de pads/pines en Altium. | 1 | REQUIRED | PROVISIONAL | CAD_CANDIDATE |
| ETH_CVDDIO_1U | Ethernet | VDDIO reserva | DP83826IRHBR | 1 uF | 10% | 50 V; X5R; -55..85 C | N/A | 0603 | CL10A105KB8NNNC | GW_CL10A105KB8NNNC_c3932faa | GW_CAND_0603_cap | hardware/academic_rev1/libraries/Gateway_Academic.SchLib + Gateway_Academic.PcbLib | S3 fig9-6 p99 | PROVISIONAL | Samsung ficha oficial; Ceff/ESR pendientes por aplicacion. Limite X5R 85 C: no homologado para ambiente superior. Modelo candidato existente; sin cotejo visual de pads/pines en Altium. | 1 | REQUIRED | PROVISIONAL | CAD_CANDIDATE |
| ETH_CVDDIO_10U | Ethernet | VDDIO reserva | DP83826IRHBR | 10 uF | 10% | 25 V; X5R; -55..85 C | N/A | 0805 | CL21A106KAYNNNE | GW_CL21A106KAYNNNE_c6e24382 | GW_CAND_0805_cap | hardware/academic_rev1/libraries/Gateway_Academic.SchLib + Gateway_Academic.PcbLib | S3 fig9-6 p99; Samsung ficha oficial | PROVISIONAL | Ceff a 3.3 V y temperatura pendientes. No usar para entrada 30 V. Modelo candidato existente; sin cotejo visual de pads/pines en Altium. | 1 | REQUIRED | PROVISIONAL | CAD_CANDIDATE |
| ETH_CEXT | Ethernet | CEXT pin2 a GND | DP83826IRHBR | 2 nF | 5% seleccion | 50 V; C0G | N/A | 0603 | C0603C202J5GACTU | GW_C0603C202J5GACTU_fa733a70 | GW_CAND_0603_cap | hardware/academic_rev1/libraries/Gateway_Academic.SchLib + Gateway_Academic.PcbLib | S3 tabla5-1 p5; P4 ficha KEMET p1 | CALCULATED | Conflicto EVM C57=100 nF; prevalece requisito actual 2 nF, no copiar C57. Modelo candidato existente; sin cotejo visual de pads/pines en Altium. | 1 | REQUIRED | ELECTRICAL_VERIFIED | CAD_CANDIDATE |
| ETH_RBIAS | Ethernet | RBIAS pin10 a GND | DP83826IRHBR | 6.49 kOhm | 1% | 75 V max; limite sqrt(P*R) | 0.1 W @70 C | 0603 | RC0603FR-076K49L | GW_RC0603FR-076K49L_f42a9329 | GW_CAND_0603_res | hardware/academic_rev1/libraries/Gateway_Academic.SchLib + Gateway_Academic.PcbLib | S3 tabla5-1; P5 ficha Yageo p1 | CALCULATED | P<3.3^2/6490=1.68 mW; actualizacion de valor/MPN sobre simbolo generico pendiente. Modelo candidato existente; sin cotejo visual de pads/pines en Altium. | 1 | REQUIRED | ELECTRICAL_VERIFIED | CAD_CANDIDATE |
| ETH_RRMII | Ethernet | RX_D2 strap8 pull-up a VDDIO | DP83826IRHBR | 2.49 kOhm | 1% | 75 V max; limite sqrt(P*R) | 0.1 W @70 C | 0603 | RC0603FR-072K49L | GW_RC0603FR-072K49L_b905c5f0 | GW_CAND_0603_res | hardware/academic_rev1/libraries/Gateway_Academic.SchLib + Gateway_Academic.PcbLib | S3 tables8-6/8-7,8-9/8-10, fig8-13 | CALCULATED | Freeze ENHANCED, RMII Leader, PHY address0; RX_D2/strap8=1 with2.49k pull-up; strap1 internal1, strap5 default0. Other default straps retained with no LEDs. GPIOs HiZ during POR sampling. | 1 | REQUIRED | ELECTRICAL_VERIFIED | CAD_CANDIDATE |
| ETH_Y25 | Ethernet | Independent PHY XI clock for RMII Leader | DP83826IRHBR | 25 MHz active CMOS | total +/-30 ppm | 1.71..3.63 V supply; 3.3 V selected; load <=15 pF | N/A | 2.0x1.6 mm 4-pad | KC2016Z25.0000C15XXK | KC2016Z25.0000C15XXK | GW_KC2016Z_KYOCERA | hardware/academic_rev1/libraries/Gateway_Academic.SchLib + Gateway_Academic.PcbLib | FCLK Kyocera TNY1T-H1-DEX01-11 pp3-4,6; S1 table31; S3 sections7.6,8.3.10 | PROVISIONAL | Selected independent 25MHz CMOS oscillator, one receiver each. VCC4=3V3; GND2=GND; EN1=3V3; OUT3 to PH0 or PHY XI9. No load capacitors. <=15pF total load and PHY phase-noise mask remain qualification gates. | 1 | REQUIRED | PROVISIONAL | CAD_CANDIDATE |
| ETH_CXTAL | Ethernet | Cargas del cristal PHY | DP83826IRHBR | TBD segun CL y Cstray | C0G <=5% | >= VDDIO | N/A | 0603 candidato | TBD | MISSING | MISSING | MISSING | FCLK Kyocera TNY1T-H1-DEX01-11 pp3-4,6; S1 table31; S3 sections7.6,8.3.10 | CALCULATED | Not applicable to selected active CMOS oscillator; retain original requirement ID as DNP. No crystal load/drive network selected. | 0 | DNP | ELECTRICAL_VERIFIED | CAD_BLOCKED |
| ETH_RXTAL | Ethernet | R1 de oscilador si requerido | DP83826IRHBR | TBD | TBD | TBD | N/A | TBD | TBD | MISSING | MISSING | MISSING | FCLK Kyocera TNY1T-H1-DEX01-11 pp3-4,6; S1 table31; S3 sections7.6,8.3.10 | CALCULATED | Not applicable to selected active CMOS oscillator; retain original requirement ID as DNP. No crystal load/drive network selected. | 0 | DNP | ELECTRICAL_VERIFIED | CAD_BLOCKED |
| ETH_FB | Ethernet | Ferritas de alimentacion opcionales | DP83826IRHBR | 60 Ohm @100 MHz candidato | 25% | 2 A; DCR 100 mOhm segun CAD | N/A | 0603 | HCB1608KF-600T20 | GW_HCB1608KF-600T20_c68e3ad6 | GW_CAND_0603_fb | hardware/academic_rev1/libraries/Gateway_Academic.SchLib + Gateway_Academic.PcbLib | S3 fig9-6: opcional | PROVISIONAL | No exigir filtro adicional sin EMC; verificar curva de impedancia y resonancia con banco local si se monta. Modelo candidato existente; sin cotejo visual de pads/pines en Altium. | 0 | DNP | PROVISIONAL | CAD_CANDIDATE |
| ETH_TMAG | Ethernet | Magnetics aislados | DP83826IRHBR | 1:1; 350 uH candidato | Relacion +/-2% | HPOT >=1500 Vrms; limites tabla9-1 | N/A | Pulse16 SMT 12.7x9.09 mm | HX1188FNL | HX1188FNL | GW_HX1188FNL_PULSE | hardware/academic_rev1/libraries/Gateway_Academic.SchLib + Gateway_Academic.PcbLib | FETH Pulse HX1188FNL revB sheets2-3; S4 sheet3/fig6-2 | CALCULATED | Selected exact HX1188FNL. TD1/3 CT2; RD6/8 CT7; cableTX16/14 CT15; cableRX11/9 CT10; NC4/5/12/13. FNLT differs by tape packaging. | 1 | REQUIRED | ELECTRICAL_VERIFIED | CAD_CANDIDATE |
| ETH_CCT | Ethernet | Derivacion center taps lado PHY | DP83826IRHBR | 100 nF | 10% | 50 V; X7R | N/A | 0603 | C0603C104K5RACTU | GW_C0603C104K5RACTU_dc5e12a5 | GW_CAND_0603_cap | hardware/academic_rev1/libraries/Gateway_Academic.SchLib + Gateway_Academic.PcbLib | S4 fig6-2 sheet3, C45/C46/C55/C56; S3 current-mode MDI | CALCULATED | Adopt complete HX1188 EVM termination variant: two parallel100nF at CT2 and two at CT7 to logic GND. No CT tie to3V3 and no extra49.9Ohm MDI terminations. | 4 | REQUIRED | ELECTRICAL_VERIFIED | CAD_CANDIDATE |
| ETH_RBOB | Ethernet | Terminacion lado cable | DP83826IRHBR | 75 Ohm | 1% | TBD | 0.125 W | 0805 resistor | CRCW080575R0FKEA | MISSING | MISSING | MISSING | S4 fig6-2 and table7-1 R43..46 | CALCULATED | Four75Ohm EVM resistors: CT15/CT10 to common node feeding CBOB1; RJ45(4+5)/(7+8) each through75Ohm to second node feeding CBOB2. No DC short to logic ground. | 4 | REQUIRED | ELECTRICAL_VERIFIED | CAD_MISSING |
| ETH_CBOB | Ethernet | Acoplo terminacion a chasis | DP83826IRHBR | 1 nF | 10% | 2000 V; X7R; safety class unverified | N/A | 1206 | C1206C102KGRACAUTO | MISSING | MISSING | MISSING | S4 fig6-2 and table7-1 C58/C59 | CALCULATED | Two separate1nF/2kV EVM AC terminations to chassis. Component2kV rating is not safety certification; verify system insulation classification and exact land pattern before layout. | 2 | REQUIRED | PROVISIONAL | CAD_MISSING |
| ETH_CCHASSIS | Ethernet | Acoplo chasis/GND | DP83826IRHBR | 4.7 nF candidato EVM | TBD | 2 kV candidato; seguridad por revisar | N/A | 1812 EVM; >=1206 segun S3 | 1812GC472KAT1A | MISSING | MISSING | MISSING | S4 C61/R51; S3 section9.4.1; schematic_readiness_gate.md E4 | BLOCKED | Leave EVM logic-GND/chassis coupling unpopulated until PE/insulation policy is defined. Shield and cable terminations use chassis, not logic GND. | 0 | DNP | ELECTRICAL_BLOCKED | CAD_BLOCKED |
| ETH_RCHASSIS | Ethernet | Descarga chasis/GND | DP83826IRHBR | 1 MOhm candidato EVM | TBD | TBD aislamiento | N/A | TBD | TBD | MISSING | MISSING | MISSING | S4 C61/R51; S3 section9.4.1; schematic_readiness_gate.md E4 | BLOCKED | Leave EVM logic-GND/chassis coupling unpopulated until PE/insulation policy is defined. Shield and cable terminations use chassis, not logic GND. | 0 | DNP | ELECTRICAL_BLOCKED | CAD_BLOCKED |
| ETH_JRJ45 | Ethernet | Jack RJ45 blindado separado de magnetics | DP83826IRHBR | 8P8C shielded | TBD | TBD | N/A | CT710001 B0 through-hole | SS-7188S-A-NF | SS-7188S-A-NF | GW_SS7188SANF_STEWART | hardware/academic_rev1/libraries/Gateway_Academic.SchLib + Gateway_Academic.PcbLib | FETH Cinch CT710001 revB0 10-Jul-2023; S4 J17 | CALCULATED | Confirmed SS-7188S-A-NF, separate shielded 8P8C. Pin1/2=TX pair,3/6=RX pair;4+5 and7+8 spare pair common-mode terminations. Shield S1/S2 to chassis. Stock risk does not revoke selection. | 1 | REQUIRED | ELECTRICAL_VERIFIED | CAD_CANDIDATE |
| ETH_DESD | Ethernet | Proteccion cuatro lineas MDI | DP83826IRHBR | 4 canales baja C | TBD | TBD | N/A | DQA USON10 | TPD4E05U06DQAR | TPD4E05U06DQAR | GW_DQA0010A_TI | hardware/academic_rev1/libraries/Gateway_Academic.SchLib + Gateway_Academic.PcbLib | S4 sheet3 U13; FESD TI SLVSBO7O table4-2 pp4,29-30 | PROVISIONAL | Selected PHY-side TPD4E05U06: PHY TD+/TD- to1/2, RD+/RD- to4/5; grounds3/8 to logic GND. Optional NC pass-through10/9/7/6. Never bridge to cable-side or claim a cable surge rating. | 1 | REQUIRED | PROVISIONAL | CAD_CANDIDATE |
| ETH_RESET | Ethernet | Reset temporizado desde MCU | DP83826IRHBR | TBD | TBD | TBD | N/A | TBD | TBD | MISSING | MISSING | MISSING | S3 reset timing seccion7; pines RST_N | PROVISIONAL | Sin RC arbitrario. Usar GPIO/supervisor tras definir secuencia y tiempos de strap; no compartir a ciegas NRST MCU. | 0 | DNP | PROVISIONAL | CAD_BLOCKED |
| ETH_RMDIO | Ethernet | Pull-up MDIO adicional | DP83826IRHBR | TBD | TBD | TBD | N/A | TBD | TBD | MISSING | MISSING | MISSING | S3 tabla5-1: PU interno | PROVISIONAL | No duplicar por defecto. Dimensionar solo tras verificar subida a MDC real, capacitancia y pull-up interno. | 0 | DNP | PROVISIONAL | CAD_BLOCKED |
| ETH_COSC | Ethernet | 10nF bypass for PHY active oscillator | KC2016Z25.0000C15XXK | 10 nF | 10% | 100 V; X7R; -55..125 C | N/A | 0603 | C0603C103K1RACTU | GW_C0603C103K1RACTU_97f3ee33 | GW_CAND_0603_cap | hardware/academic_rev1/libraries/Gateway_Academic.SchLib + Gateway_Academic.PcbLib | FCLK Kyocera TNY1T-H1-DEX01-11 pp3-4,6; S1 table31; S3 sections7.6,8.3.10 | CALCULATED | Kyocera section8 requires10nF close toVCC4/GND2. | 1 | REQUIRED | ELECTRICAL_VERIFIED | CAD_CANDIDATE |

### BOM Buck3V3

| ID | Subsistema | Funcion | Referencia principal (fabricante) | Valor nominal | Tolerancia | Tension/corriente nominal | Potencia | Encapsulado | MPN recomendado/candidato | Simbolo candidato | Footprint candidato | Origen CAD | Fuente valor electrico | Estado global | Observaciones | Cantidad | Montaje | Estado electrico | Estado CAD |
|---|---|---|---|---|---|---|---|---|---|---|---|---|---|---|---|---|---|---|---|
| B3_L | Buck3V3 | Inductor buck | LMR36015FBRNXR (propuesto) | 6.8 uH | 20% | Isat25C 3.6 A; Irms20C 3.0 A | N/A | XAL4030 | XAL4030-682MEC | XAL4030-682MEC | GW_XAL4030_COILCRAFT | hardware/academic_rev1/libraries/Gateway_Academic.SchLib + Gateway_Academic.PcbLib | S5 equations4-5; FL Coilcraft doc806-1 and806-4 | CALCULATED | Retain exact Coilcraft6.8uH(B3)/10uH(B5). Nominal/load ripple and DCR calculations in electrical_calculations.json.25C Isat/Irms suffice for normal design load; hot/fault Isat and core loss still unqualified. | 1 | REQUIRED | DERIVED_PENDING_REVIEW | CAD_CANDIDATE |
| B3_CIN | Buck3V3 | Banco ceramico entrada | LMR36015FBRNXR (propuesto) | 4.7 uF | 10% | 100 V X7R | N/A | 2220 | C5750X7R2A475K230KA | C5750X7R2A475K230KA | GW_C5750_TDK_REFLOW | hardware/academic_rev1/libraries/Gateway_Academic.SchLib + Gateway_Academic.PcbLib | Approved academic freeze; input_protection_reference section10; manufacturer evidence/input_protection_freeze | VERIFIED | Two per regulator. ExactTDK bias graph~3.6uF per part at30V;~6.48uF bank after10% allowance. Prototype confirmation by ripple/startup; no industrial characterization gate. | 2 | REQUIRED | ELECTRICAL_VERIFIED | CAD_VERIFIED |
| B3_CHF | Buck3V3 | Bypass de cada par VIN-PGND | LMR36015FBRNXR (propuesto) | 220 nF | 10% | 100 V X7R | N/A | 0805 | C0805C224K1RACTU | C0805C224K1RACTU | GW_0805_KEMET_NOMINAL | hardware/academic_rev1/libraries/Gateway_Academic.SchLib + Gateway_Academic.PcbLib | Approved academic freeze; input_protection_reference section10; manufacturer evidence/input_protection_freeze | VERIFIED | Preserve one220nF at each VIN/PGND pair;exactKemet0805 body and manufacturer nominal lands checked. | 2 | REQUIRED | ELECTRICAL_VERIFIED | CAD_VERIFIED |
| B3_COUT | Buck3V3 | Banco salida | LMR36015FBRNXR (propuesto) | 15 uF | 20% | 16 V X7R | N/A | 1210 | C3225X7R1C156M250AB | C3225X7R1C156M250AB | GW_C3225_TDK_REFLOW | hardware/academic_rev1/libraries/Gateway_Academic.SchLib + Gateway_Academic.PcbLib | Approved academic freeze; input_protection_reference section10; manufacturer evidence/input_protection_freeze | VERIFIED | Preserves TI1MHz table10-1 RATED45uF example. Output only,never24V rail. Bias/stability confirmed during academic load-step test; manufacturerdimensioned footprint now available. | 3 | REQUIRED | ELECTRICAL_VERIFIED | CAD_VERIFIED |
| B3_CBOOT | Buck3V3 | BOOT a SW | LMR36015FBRNXR (propuesto) | 100 nF | 10% | 50 V; X7R; -55..125 C | N/A | 0603 | C0603C104K5RACTU | GW_C0603C104K5RACTU_dc5e12a5 | GW_CAND_0603_cap | hardware/academic_rev1/libraries/Gateway_Academic.SchLib + Gateway_Academic.PcbLib | S5 seccion10.2.1.2.7:100nF >=16V | PROVISIONAL | Ficha KEMET local p1. Adaptar parametros; no usar el Y5V 0603F104Z500CT como equivalente. Modelo candidato existente; sin cotejo visual de pads/pines en Altium. | 1 | REQUIRED | PROVISIONAL | CAD_CANDIDATE |
| B3_CVCC | Buck3V3 | VCC interno a GND | LMR36015FBRNXR (propuesto) | 2.2 uF | 10% | 50 V X7R | N/A | 0805 | C0805C225K5RACTU | C0805C225K5RACTU | GW_0805_KEMET_NOMINAL | hardware/academic_rev1/libraries/Gateway_Academic.SchLib + Gateway_Academic.PcbLib | Approved academic freeze; input_protection_reference section10; manufacturer evidence/input_protection_freeze | VERIFIED | Replaces prior1uF/50VX5R with known0.656uF effective at5V. Prototype assumption>=60% retention gives>=1.188uF. Verify VCC startup and steady ripple; no externalVCC load exceptPG pull-up. | 1 | REQUIRED | ELECTRICAL_VERIFIED | CAD_VERIFIED |
| B3_RFBT | Buck3V3 | Divisor feedback RFBT | LMR36015FBRNXR (propuesto) | 100 kOhm | 1% | 75 V max; limite sqrt(P*R) | 0.1 W @70 C | 0603 | RC0603FR-07100KL | GW_RC0603FR-07100KL_ac663db8 | GW_CAND_0603_res | hardware/academic_rev1/libraries/Gateway_Academic.SchLib + Gateway_Academic.PcbLib | S5 tabla10-1 y ecuacion3; ficha Yageo local p1 | CALCULATED | Vout nominal calculado 3.31481 V; ver esquinas de tolerancia. Cambiar parametros en copia docente. Modelo candidato existente; sin cotejo visual de pads/pines en Altium. | 1 | REQUIRED | ELECTRICAL_VERIFIED | CAD_CANDIDATE |
| B3_RFBB | Buck3V3 | Divisor feedback RFBB | LMR36015FBRNXR (propuesto) | 43.2 kOhm | 1% | 75 V max; limite sqrt(P*R) | 0.1 W @70 C | 0603 | RC0603FR-0743K2L | GW_RC0603FR-0743K2L_a8308c0c | GW_CAND_0603_res | hardware/academic_rev1/libraries/Gateway_Academic.SchLib + Gateway_Academic.PcbLib | S5 tabla10-1 y ecuacion3; ficha Yageo local p1 | CALCULATED | Vout nominal calculado 3.31481 V; ver esquinas de tolerancia. Cambiar parametros en copia docente. Modelo candidato existente; sin cotejo visual de pads/pines en Altium. | 1 | REQUIRED | ELECTRICAL_VERIFIED | CAD_CANDIDATE |
| B3_CFF | Buck3V3 | Feed-forward sobre RFBT | LMR36015FBRNXR (propuesto) | 20 pF | 5% | 50 V; C0G | N/A | 0603 | C0603C200J5GACTU | GW_C0603C200J5GACTU_c75b007a | GW_CAND_0603_cap | hardware/academic_rev1/libraries/Gateway_Academic.SchLib + Gateway_Academic.PcbLib | S5 tabla10-1 y seccion10.2.1.2.9; ficha KEMET p1 | PROVISIONAL | Valor guia fabricante; validar lazo. Con RFBT100k no obligatorio universal; reservar DNP hasta respuesta/Bode. Modelo candidato existente; sin cotejo visual de pads/pines en Altium. | 1 | CONDITIONAL | PROVISIONAL | CAD_CANDIDATE |
| B3_RENP | Buck3V3 | UVLO externo/PG si se utilizan | LMR36015FBRNXR (propuesto) | TBD | TBD | TBD | N/A | TBD | TBD | MISSING | MISSING | MISSING | S5 pines; ecuacion10; seccion10.2.1.2.8 | PROVISIONAL | EN a VIN, PG sin uso: cero resistencias. Si se exige UVLO18 V o PG, dimensionar redes por ecuacion10 y cargas; no contar pull-up inexistente. | 0 | DNP | PROVISIONAL | CAD_BLOCKED |
| B3_CDAMP | Buck3V3 | Bulk amortiguador de cableado si se requiere | LMR36015FBRNXR (propuesto) | TBD | TBD | TBD | N/A | TBD | TBD | MISSING | MISSING | MISSING | S5 seccion11 y10.2.1.2.6 | BLOCKED | C/ESR dependen impedancia fuente/cable y front-end. Electrolitico docente35 V no aprobado frente transitorios. | TBD | CONDITIONAL | ELECTRICAL_BLOCKED | CAD_BLOCKED |

### BOM Buck5V

| ID | Subsistema | Funcion | Referencia principal (fabricante) | Valor nominal | Tolerancia | Tension/corriente nominal | Potencia | Encapsulado | MPN recomendado/candidato | Simbolo candidato | Footprint candidato | Origen CAD | Fuente valor electrico | Estado global | Observaciones | Cantidad | Montaje | Estado electrico | Estado CAD |
|---|---|---|---|---|---|---|---|---|---|---|---|---|---|---|---|---|---|---|---|
| B5_L | Buck5V | Inductor buck | LMR36015FBRNXR (propuesto) | 10 uH | 20% | Isat25C 3.0 A; Irms20C 2.2 A | N/A | XAL4040 | XAL4040-103MEC | XAL4040-103MEC | GW_XAL4040_COILCRAFT | hardware/academic_rev1/libraries/Gateway_Academic.SchLib + Gateway_Academic.PcbLib | S5 equations4-5; FL Coilcraft doc806-1 and806-4 | CALCULATED | Retain exact Coilcraft6.8uH(B3)/10uH(B5). Nominal/load ripple and DCR calculations in electrical_calculations.json.25C Isat/Irms suffice for normal design load; hot/fault Isat and core loss still unqualified. | 1 | REQUIRED | DERIVED_PENDING_REVIEW | CAD_CANDIDATE |
| B5_CIN | Buck5V | Banco ceramico entrada | LMR36015FBRNXR (propuesto) | 4.7 uF | 10% | 100 V X7R | N/A | 2220 | C5750X7R2A475K230KA | C5750X7R2A475K230KA | GW_C5750_TDK_REFLOW | hardware/academic_rev1/libraries/Gateway_Academic.SchLib + Gateway_Academic.PcbLib | Approved academic freeze; input_protection_reference section10; manufacturer evidence/input_protection_freeze | VERIFIED | Two per regulator. ExactTDK bias graph~3.6uF per part at30V;~6.48uF bank after10% allowance. Prototype confirmation by ripple/startup; no industrial characterization gate. | 2 | REQUIRED | ELECTRICAL_VERIFIED | CAD_VERIFIED |
| B5_CHF | Buck5V | Bypass de cada par VIN-PGND | LMR36015FBRNXR (propuesto) | 220 nF | 10% | 100 V X7R | N/A | 0805 | C0805C224K1RACTU | C0805C224K1RACTU | GW_0805_KEMET_NOMINAL | hardware/academic_rev1/libraries/Gateway_Academic.SchLib + Gateway_Academic.PcbLib | Approved academic freeze; input_protection_reference section10; manufacturer evidence/input_protection_freeze | VERIFIED | Preserve one220nF at each VIN/PGND pair;exactKemet0805 body and manufacturer nominal lands checked. | 2 | REQUIRED | ELECTRICAL_VERIFIED | CAD_VERIFIED |
| B5_COUT | Buck5V | Banco salida | LMR36015FBRNXR (propuesto) | 15 uF | 20% | 16 V X7R | N/A | 1210 | C3225X7R1C156M250AB | C3225X7R1C156M250AB | GW_C3225_TDK_REFLOW | hardware/academic_rev1/libraries/Gateway_Academic.SchLib + Gateway_Academic.PcbLib | Approved academic freeze; input_protection_reference section10; manufacturer evidence/input_protection_freeze | VERIFIED | Preserves TI1MHz table10-1 RATED45uF example. Output only,never24V rail. Bias/stability confirmed during academic load-step test; manufacturerdimensioned footprint now available. | 3 | REQUIRED | ELECTRICAL_VERIFIED | CAD_VERIFIED |
| B5_CBOOT | Buck5V | BOOT a SW | LMR36015FBRNXR (propuesto) | 100 nF | 10% | 50 V; X7R; -55..125 C | N/A | 0603 | C0603C104K5RACTU | GW_C0603C104K5RACTU_dc5e12a5 | GW_CAND_0603_cap | hardware/academic_rev1/libraries/Gateway_Academic.SchLib + Gateway_Academic.PcbLib | S5 seccion10.2.1.2.7:100nF >=16V | PROVISIONAL | Ficha KEMET local p1. Adaptar parametros; no usar el Y5V 0603F104Z500CT como equivalente. Modelo candidato existente; sin cotejo visual de pads/pines en Altium. | 1 | REQUIRED | PROVISIONAL | CAD_CANDIDATE |
| B5_CVCC | Buck5V | VCC interno a GND | LMR36015FBRNXR (propuesto) | 2.2 uF | 10% | 50 V X7R | N/A | 0805 | C0805C225K5RACTU | C0805C225K5RACTU | GW_0805_KEMET_NOMINAL | hardware/academic_rev1/libraries/Gateway_Academic.SchLib + Gateway_Academic.PcbLib | Approved academic freeze; input_protection_reference section10; manufacturer evidence/input_protection_freeze | VERIFIED | Replaces prior1uF/50VX5R with known0.656uF effective at5V. Prototype assumption>=60% retention gives>=1.188uF. Verify VCC startup and steady ripple; no externalVCC load exceptPG pull-up. | 1 | REQUIRED | ELECTRICAL_VERIFIED | CAD_VERIFIED |
| B5_RFBT | Buck5V | Divisor feedback RFBT | LMR36015FBRNXR (propuesto) | 100 kOhm | 1% | 75 V max; limite sqrt(P*R) | 0.1 W @70 C | 0603 | RC0603FR-07100KL | GW_RC0603FR-07100KL_ac663db8 | GW_CAND_0603_res | hardware/academic_rev1/libraries/Gateway_Academic.SchLib + Gateway_Academic.PcbLib | S5 tabla10-1 y ecuacion3; ficha Yageo local p1 | CALCULATED | Vout nominal calculado 5.01606 V; ver esquinas de tolerancia. Cambiar parametros en copia docente. Modelo candidato existente; sin cotejo visual de pads/pines en Altium. | 1 | REQUIRED | ELECTRICAL_VERIFIED | CAD_CANDIDATE |
| B5_RFBB | Buck5V | Divisor feedback RFBB | LMR36015FBRNXR (propuesto) | 24.9 kOhm | 1% | 75 V max; limite sqrt(P*R) | 0.1 W @70 C | 0603 | RC0603FR-0724K9L | GW_RC0603FR-0724K9L_10698e9e | GW_CAND_0603_res | hardware/academic_rev1/libraries/Gateway_Academic.SchLib + Gateway_Academic.PcbLib | S5 tabla10-1 y ecuacion3; ficha Yageo local p1 | CALCULATED | Vout nominal calculado 5.01606 V; ver esquinas de tolerancia. Cambiar parametros en copia docente. Modelo candidato existente; sin cotejo visual de pads/pines en Altium. | 1 | REQUIRED | ELECTRICAL_VERIFIED | CAD_CANDIDATE |
| B5_CFF | Buck5V | Feed-forward sobre RFBT | LMR36015FBRNXR (propuesto) | 20 pF | 5% | 50 V; C0G | N/A | 0603 | C0603C200J5GACTU | GW_C0603C200J5GACTU_c75b007a | GW_CAND_0603_cap | hardware/academic_rev1/libraries/Gateway_Academic.SchLib + Gateway_Academic.PcbLib | S5 tabla10-1 y seccion10.2.1.2.9; ficha KEMET p1 | PROVISIONAL | Valor guia fabricante; validar lazo. Con RFBT100k no obligatorio universal; reservar DNP hasta respuesta/Bode. Modelo candidato existente; sin cotejo visual de pads/pines en Altium. | 1 | CONDITIONAL | PROVISIONAL | CAD_CANDIDATE |
| B5_RENP | Buck5V | UVLO externo/PG si se utilizan | LMR36015FBRNXR (propuesto) | TBD | TBD | TBD | N/A | TBD | TBD | MISSING | MISSING | MISSING | S5 pines; ecuacion10; seccion10.2.1.2.8 | PROVISIONAL | EN a VIN, PG sin uso: cero resistencias. Si se exige UVLO18 V o PG, dimensionar redes por ecuacion10 y cargas; no contar pull-up inexistente. | 0 | DNP | PROVISIONAL | CAD_BLOCKED |
| B5_CDAMP | Buck5V | Bulk amortiguador de cableado si se requiere | LMR36015FBRNXR (propuesto) | TBD | TBD | TBD | N/A | TBD | TBD | MISSING | MISSING | MISSING | S5 seccion11 y10.2.1.2.6 | BLOCKED | C/ESR dependen impedancia fuente/cable y front-end. Electrolitico docente35 V no aprobado frente transitorios. | TBD | CONDITIONAL | ELECTRICAL_BLOCKED | CAD_BLOCKED |

### BOM Entrada

| ID | Subsistema | Funcion | Referencia principal (fabricante) | Valor nominal | Tolerancia | Tension/corriente nominal | Potencia | Encapsulado | MPN recomendado/candidato | Simbolo candidato | Footprint candidato | Origen CAD | Fuente valor electrico | Estado global | Observaciones | Cantidad | Montaje | Estado electrico | Estado CAD |
|---|---|---|---|---|---|---|---|---|---|---|---|---|---|---|---|---|---|---|---|
| IN_FUSE | Entrada | Upstream physical fuse F1 | Entrada unica 18..30 V (propuesta pendiente) | 2 A | Manufacturer fuse characteristic | 125 VDC | N/A | Littelfuse451 SMD | 0451002.MRL | 0451002.MRL | GW_0451_LITTELFUSE | hardware/academic_rev1/libraries/Gateway_Academic.SchLib + Gateway_Academic.PcbLib | Approved academic freeze; input_protection_reference section10; manufacturer evidence/input_protection_freeze | VERIFIED | User-approved2A backup fuse. Lab current limit0.5A initially; no industrial coordination claim. Manufacturer land pattern saved. | 1 | REQUIRED | ELECTRICAL_VERIFIED | CAD_VERIFIED |
| IN_REVERSE | Entrada | Bloqueo polaridad inversa | Entrada unica 18..30 V (propuesta pendiente) | 3 A Schottky | N/A | 60 V reverse | N/A | SMPC TO-277A | SS3P6L-M3/86A | SS3P6L-M3_86A | GW_SS3P6L_VISHAY_88987 | hardware/academic_rev1/libraries/Gateway_Academic.SchLib + Gateway_Academic.PcbLib | Approved academic freeze; input_protection_reference section10; manufacturer evidence/input_protection_freeze | VERIFIED | User-approved series diode. Both anodes1/2 toVIN_FUSED,largeK toVIN_CLAMP. Power off/discharge before changing polarity. | 1 | REQUIRED | ELECTRICAL_VERIFIED | CAD_VERIFIED |
| IN_TVS | Entrada | Supresion sobretension/transitorios | Entrada unica 18..30 V (propuesta pendiente) | 33 V working | Manufacturer table | 42 V maximum specified35A pulse | N/A | DFN6 1.6x1.6 | TDS3311P.C | TDS3311P.C | GW_TDS3311P_SEMTECH | hardware/academic_rev1/libraries/Gateway_Academic.SchLib + Gateway_Academic.PcbLib | Approved academic freeze; input_protection_reference section10; manufacturer evidence/input_protection_freeze | VERIFIED | User-approved replacement for TDS3011P and unreleasedSMBJ33A draft. Pins4/5/6VIN_CLAMP;1/2/3GND. Not continuousOV protection. | 1 | REQUIRED | ELECTRICAL_VERIFIED | CAD_VERIFIED |
| IN_BULK | Entrada | NIS local input bypass | TPS26620DRCR | 4.7 uF | 10% | 100 V X7R | N/A | 2220 | C5750X7R2A475K230KA | C5750X7R2A475K230KA | GW_C5750_TDK_REFLOW | hardware/academic_rev1/libraries/Gateway_Academic.SchLib + Gateway_Academic.PcbLib | Approved academic freeze; input_protection_reference section10; manufacturer evidence/input_protection_freeze | VERIFIED | Retained input bypass: VIN_CLAMP/pin1 to GND_PWR/pin6, NOT EF_RTN; TI section9.3.8 explicit IN-to-GND recommendation. Local short return. | 1 | REQUIRED | ELECTRICAL_VERIFIED | CAD_VERIFIED |
| IN_FILTER | Entrada | Filtro EMC si necesario | Entrada unica 18..30 V (propuesta pendiente) | TBD | TBD | TBD | N/A | TBD | TBD | MISSING | MISSING | MISSING | S5 section11; FIN TDK-Lambda input filter guidance | CALCULATED | No additional LC stage selected; local mandated buck decoupling remains. Bulk/damping needs source/cable impedance. Avoid unreviewed high-Q input resonance. | 0 | DNP | ELECTRICAL_VERIFIED | CAD_BLOCKED |
| IN_J | Entrada | Conector entrada | 18..30 VDC | 2 polos + politica PE | TBD | >=30 V continuo mas transitorios; corriente TBD | N/A | TBD | JL126-50002G01 | GW_JL126-50002G01_16238e52 | GW_CAND_CON_2x1_TH_5MM | hardware/academic_rev1/libraries/Gateway_Academic.SchLib + Gateway_Academic.PcbLib | Alcance usuario; inventario borneras docente | BLOCKED | Priorizar bornera docente tras MPN/tension/corriente/taladros, no jack ambiguo2.0/2.1 mm. Modelo candidato existente; sin cotejo visual de pads/pines en Altium. | 1 | REQUIRED | ELECTRICAL_BLOCKED | CAD_CANDIDATE |
| IN_RLIM | Entrada | eFuse current-setting resistor | TPS26620DRCR | 13.3 kOhm | 1% | 75 V | 0.1 W | 0603 | RC0603FR-0713K3L | RC0603FR-0713K3L | GW_RC0603_YAGEO_REFLOW | hardware/academic_rev1/libraries/Gateway_Academic.SchLib + Gateway_Academic.PcbLib | TI SLVSDT4F Table6-1/Table7.5, Eq2/5/6/7, Fig10-1; input_protection_reference section10 | CALCULATED | Pin7 ILIM to EF_RTN pin5; Eq5 6.636/13.3=0.49895A. Table7.5 0.47/0.50/0.52A at13.3k test condition. Supersedes NIS62k, not buck FB resistors. | 1 | REQUIRED | DERIVED_PENDING_REVIEW | CAD_VERIFIED |
| IN_RFAULT | Entrada | FAULT pull-up | TPS26620DRCR | 15.0 kOhm | 1% | 75 V | 0.1 W | 0603 | RC0603FR-0715KL | RC0603FR-0715KL | GW_RC0603_YAGEO_REFLOW | hardware/academic_rev1/libraries/Gateway_Academic.SchLib + Gateway_Academic.PcbLib | TI SLVSDT4F Table6-1/Table7.5, Eq2/5/6/7, Fig10-1; input_protection_reference section10 | CALCULATED | DNP historical pull-up option. TPS pin9 FLT left NC in simple capture configuration; no fault line populated. | 0 | DNP | DERIVED_PENDING_REVIEW | CAD_VERIFIED |
| IN_HF | Entrada | NIS input high-frequency bypass | TPS26620DRCR | 220 nF | 10% | 100 V X7R | N/A | 0805 | C0805C224K1RACTU | C0805C224K1RACTU | GW_0805_KEMET_NOMINAL | hardware/academic_rev1/libraries/Gateway_Academic.SchLib + Gateway_Academic.PcbLib | Approved academic freeze; input_protection_reference section10; manufacturer evidence/input_protection_freeze | VERIFIED | Retained input bypass: VIN_CLAMP/pin1 to GND_PWR/pin6, NOT EF_RTN; TI section9.3.8 explicit IN-to-GND recommendation. Local short return. | 1 | REQUIRED | ELECTRICAL_VERIFIED | CAD_VERIFIED |
| IN_CDVDT | Entrada | Optional eFuse slew capacitor | TPS26620DRCR | 10 nF | 10% | 100 V; X7R | N/A | 0603 | C0603C103K1RACTU | C0603C103K1RACTU | GW_0603_KEMET_NOMINAL | hardware/academic_rev1/libraries/Gateway_Academic.SchLib + Gateway_Academic.PcbLib | TI SLVSDT4F Table6-1/Table7.5, Eq2/5/6/7, Fig10-1; input_protection_reference section10 | CALCULATED | Pin8 dVdT to EF_RTN. Eq2 ramp4.92ms at24V; not NIS68pF option. 21.648uF COUT plus0.217A budget gives~0.322A typ startup estimate. | 1 | REQUIRED | DERIVED_PENDING_REVIEW | CAD_VERIFIED |
| IN_SOUT | Entrada | Reserved output-clamp footprint | NIS3071MT4TWG | DNP negative-output clamp option | N/A | 60 V reverse | N/A | SMPC TO-277A | SS3P6L-M3/86A | SS3P6L-M3_86A | GW_SS3P6L_VISHAY_88987 | hardware/academic_rev1/libraries/Gateway_Academic.SchLib + Gateway_Academic.PcbLib | Approved academic freeze; input_protection_reference section10; manufacturer evidence/input_protection_freeze | VERIFIED | DNP footprint only:anodes1/2GND,K24V_ELEC. No inductive electronics load/long harness assumed. This part is NOT guaranteed-.3V clamp; review before population. | 0 | DNP | ELECTRICAL_VERIFIED | CAD_VERIFIED |
| IN_UV_TOP | Entrada | IN to UVLO divider top | TPS26620DRCR | 768 kOhm | 1% | 75 V | 0.1 W | 0603 | RC0603FR-07768KL | RC0603FR-07768KL | GW_RC0603_YAGEO_REFLOW | hardware/academic_rev1/libraries/Gateway_Academic.SchLib + Gateway_Academic.PcbLib | TI SLVSDT4F Table6-1/Table7.5, Eq2/5/6/7, Fig10-1; input_protection_reference section10 | CALCULATED | IN to UVLO divider top; nominal UV rising15.759V / OV rising33.141V, local IN-to-RTN reference. Proposed academic thresholds. | 1 | REQUIRED | DERIVED_PENDING_REVIEW | CAD_VERIFIED |
| IN_UV_MID | Entrada | UVLO to OVP divider middle | TPS26620DRCR | 33.2 kOhm | 1% | 75 V | 0.1 W | 0603 | RC0603FR-0733K2L | RC0603FR-0733K2L | GW_RC0603_YAGEO_REFLOW | hardware/academic_rev1/libraries/Gateway_Academic.SchLib + Gateway_Academic.PcbLib | TI SLVSDT4F Table6-1/Table7.5, Eq2/5/6/7, Fig10-1; input_protection_reference section10 | CALCULATED | UVLO to OVP divider middle; nominal UV rising15.759V / OV rising33.141V, local IN-to-RTN reference. Proposed academic thresholds. | 1 | REQUIRED | DERIVED_PENDING_REVIEW | CAD_VERIFIED |
| IN_UV_BOTTOM | Entrada | OVP to EF_RTN divider bottom | TPS26620DRCR | 30.1 kOhm | 1% | 75 V | 0.1 W | 0603 | RC0603FR-0730K1L | RC0603FR-0730K1L | GW_RC0603_YAGEO_REFLOW | hardware/academic_rev1/libraries/Gateway_Academic.SchLib + Gateway_Academic.PcbLib | TI SLVSDT4F Table6-1/Table7.5, Eq2/5/6/7, Fig10-1; input_protection_reference section10 | CALCULATED | OVP to EF_RTN divider bottom; nominal UV rising15.759V / OV rising33.141V, local IN-to-RTN reference. Proposed academic thresholds. | 1 | REQUIRED | DERIVED_PENDING_REVIEW | CAD_VERIFIED |

### BOM RS485

| ID | Subsistema | Funcion | Referencia principal (fabricante) | Valor nominal | Tolerancia | Tension/corriente nominal | Potencia | Encapsulado | MPN recomendado/candidato | Simbolo candidato | Footprint candidato | Origen CAD | Fuente valor electrico | Estado global | Observaciones | Cantidad | Montaje | Estado electrico | Estado CAD |
|---|---|---|---|---|---|---|---|---|---|---|---|---|---|---|---|---|---|---|---|
| RS_CVCC | RS485 | VCC 3.3 V | THVD1420DR propuesto | 100 nF | 10% | 50 V; X7R; -55..125 C | N/A | 0603 | C0603C104K5RACTU | GW_C0603C104K5RACTU_dc5e12a5 | GW_CAND_0603_cap | hardware/academic_rev1/libraries/Gateway_Academic.SchLib + Gateway_Academic.PcbLib | S6 seccion9 p19 | PROVISIONAL | Ficha KEMET local p1. Adaptar parametros; no usar el Y5V 0603F104Z500CT como equivalente. Modelo candidato existente; sin cotejo visual de pads/pines en Altium. | 1 | REQUIRED | PROVISIONAL | CAD_CANDIDATE |
| RS_RT | RS485 | Terminacion en extremo de cable | THVD1420DR | 120 Ohm si Z0=120 Ohm | 1% | >=3.3 V continuo; falla de bus aparte | >=0.25 W objetivo a70 C | 1206 candidato; no0603 0.1W | TBD | MISSING | MISSING | MISSING | S6 fig8-1/section8.2; calculated3.412V squared/118.8Ohm=98mW | CALCULATED | 120Ohm end termination only if physical bus end, jumper normally OPEN at intermediate node.0.25W minimum candidate; max fault/ambient rating still required. No external bias by default. | 1 | CONDITIONAL | DERIVED_PENDING_REVIEW | CAD_BLOCKED |
| RS_RDE | RS485 | DE a GND durante arranque | THVD1420DR | 10 kOhm | 1% | 75 V maximum; power-limited working voltage | 0.1 W at70C | 0603 | RC0603FR-0710KL | RC0603FR-0710KL | GW_CAND_0603_res | hardware/academic_rev1/libraries/Gateway_Academic.SchLib + Gateway_Academic.PcbLib | S6 seccion10.1 item6:1..10k; fig8-5:10k | CALCULATED | 10k Yageo selected: DE low and nRE high at MCU reset;115200baud8N1 half-duplex. Exact local Yageo datasheet replaces unqualified FOJAN identity. | 1 | REQUIRED | ELECTRICAL_VERIFIED | CAD_CANDIDATE |
| RS_RRE | RS485 | nRE a VCC durante arranque | THVD1420DR | 10 kOhm | 1% | 75 V maximum; power-limited working voltage | 0.1 W at70C | 0603 | RC0603FR-0710KL | RC0603FR-0710KL | GW_CAND_0603_res | hardware/academic_rev1/libraries/Gateway_Academic.SchLib + Gateway_Academic.PcbLib | S6 seccion10.1 item6:1..10k; fig8-5:10k | CALCULATED | 10k Yageo selected: DE low and nRE high at MCU reset;115200baud8N1 half-duplex. Exact local Yageo datasheet replaces unqualified FOJAN identity. | 1 | REQUIRED | ELECTRICAL_VERIFIED | CAD_CANDIDATE |
| RS_RPULSE | RS485 | Limitacion residual en A/B si surge1kV | THVD1420DR | 10 Ohm | 5% | Pulse-proof segun ficha exacta | Pulsos por verificar | 0603 | CRCW0603010RJNEAHP | GW_CRCW0603010RJNEAHP_c8eb51d2 | GW_CAND_0603_res | hardware/academic_rev1/libraries/Gateway_Academic.SchLib + Gateway_Academic.PcbLib | S6 fig8-5/table8-1; FSM Bourns CDSOT23-SM712 pp1-3 | BLOCKED | UNQUALIFIED optional THVD1400 reference network: TWO10Ohm resistors, one in EACH bus line. THVD1420 shares -7..+12V common-mode and +/-16V absmax, but SM712 positive clamp19/20/26V exceeds absmax. Do not transfer1kV claim. Retain conditional positions; selected115200baud circuit uses built-in device protection only. | 2 | CONDITIONAL | ELECTRICAL_BLOCKED | CAD_CANDIDATE |
| RS_TVS | RS485 | Proteccion A/B | THVD1420DR | Asimetrica -7/+12 V candidata | TBD | TBD | N/A | SOT23 | CDSOT23-SM712 | CDSOT23-SM712 | GW_SM712_BOURNS | hardware/academic_rev1/libraries/Gateway_Academic.SchLib + Gateway_Academic.PcbLib | S6 fig8-5/table8-1; FSM Bourns CDSOT23-SM712 pp1-3 | BLOCKED | UNQUALIFIED optional THVD1400 reference network: TWO10Ohm resistors, one in EACH bus line. THVD1420 shares -7..+12V common-mode and +/-16V absmax, but SM712 positive clamp19/20/26V exceeds absmax. Do not transfer1kV claim. Retain conditional positions; selected115200baud circuit uses built-in device protection only. | 1 | CONDITIONAL | ELECTRICAL_BLOCKED | CAD_CANDIDATE |
| RS_BIAS | RS485 | Bias externo | THVD1420DR | TBD | TBD | TBD | N/A | TBD | TBD | MISSING | MISSING | MISSING | S6 seccion7.4 tabla7-2 fail-safe | PROVISIONAL | Open/short/idle fail-safe integrado; no duplicar polarizacion. Revisar otros nodos si el sistema la exige. | 0 | DNP | PROVISIONAL | CAD_BLOCKED |
| RS_J | RS485 | Bornera A/B/COM | THVD1420DR | 3 polos | TBD | TBD | N/A | TBD | MX126-5.0-03P-GN01-Cu-S-A | GW_MX126-5.0-03P-GN01-Cu-S-A_d57a488f | GW_CAND_CON_3x1_TH_5mm | hardware/academic_rev1/libraries/Gateway_Academic.SchLib + Gateway_Academic.PcbLib | S6 red half-duplex; inventario docente | BLOCKED | Ratings, corrientes de falla, pinout y referencia comun pendientes; no asumir aislamiento galvanico. Modelo candidato existente; sin cotejo visual de pads/pines en Altium. | 1 | REQUIRED | ELECTRICAL_BLOCKED | CAD_CANDIDATE |

### BOM CAN

| ID | Subsistema | Funcion | Referencia principal (fabricante) | Valor nominal | Tolerancia | Tension/corriente nominal | Potencia | Encapsulado | MPN recomendado/candidato | Simbolo candidato | Footprint candidato | Origen CAD | Fuente valor electrico | Estado global | Observaciones | Cantidad | Montaje | Estado electrico | Estado CAD |
|---|---|---|---|---|---|---|---|---|---|---|---|---|---|---|---|---|---|---|---|
| CAN_CVCC5 | CAN | Desacoplo VCC5 | ATA6561-GAQW propuesto | 100 nF | 10% | 50 V; X7R; -55..125 C | N/A | 0603 | C0603C104K5RACTU | GW_C0603C104K5RACTU_dc5e12a5 | GW_CAND_0603_cap | hardware/academic_rev1/libraries/Gateway_Academic.SchLib + Gateway_Academic.PcbLib | S7 tablaB-2 C3/C5; figA-1 | PROVISIONAL | Ficha KEMET local p1. Adaptar parametros; no usar el Y5V 0603F104Z500CT como equivalente. Modelo candidato existente; sin cotejo visual de pads/pines en Altium. | 1 | REQUIRED | PROVISIONAL | CAD_CANDIDATE |
| CAN_CVIO3V3 | CAN | Desacoplo VIO3V3 | ATA6561-GAQW propuesto | 100 nF | 10% | 50 V; X7R; -55..125 C | N/A | 0603 | C0603C104K5RACTU | GW_C0603C104K5RACTU_dc5e12a5 | GW_CAND_0603_cap | hardware/academic_rev1/libraries/Gateway_Academic.SchLib + Gateway_Academic.PcbLib | S7 tablaB-2 C3/C5; figA-1 | PROVISIONAL | Ficha KEMET local p1. Adaptar parametros; no usar el Y5V 0603F104Z500CT como equivalente. Modelo candidato existente; sin cotejo visual de pads/pines en Altium. | 1 | REQUIRED | PROVISIONAL | CAD_CANDIDATE |
| CAN_RSPLIT | CAN | Dos mitades terminacion extremo | ATA6561-GAQW | 62 Ohm | <=1%; matching <1% deseable | Bus CAN; falla DC por verificar | 0.5 W por resistor segun EVM | 1206 | TBD | MISSING | MISSING | MISSING | S7 section3.5/tableB-2; S8 basic bus application | CALCULATED | Retained optional split-termination alternative, NOT selected for simultaneous use. Selected one120Ohm bus-end termination row CAN_RT added separately. Intermediate-node default DNP. | 0 | DNP | ELECTRICAL_VERIFIED | CAD_BLOCKED |
| CAN_CSPLIT | CAN | Punto medio a GND | ATA6561-GAQW | 4.7 nF | TBD | 50 V; X7R candidato | N/A | 0805 | TBD | MISSING | MISSING | MISSING | S7 section3.5 | CALCULATED | DNP with unselected split network. Do not populate alongside selected conventional120Ohm termination. | 0 | DNP | ELECTRICAL_VERIFIED | CAD_BLOCKED |
| CAN_CBULK | CAN | Reserva VCC opcional | ATA6561-GAQW | 47 uF | TBD | 10 V minimo EVM | N/A | 1210 candidato | TBD | MISSING | MISSING | MISSING | S7 tablaB-2 C2 | MISSING | No obligatoria universal si buck y distribucion aportan reserva; comprobar caida/transitorios antes poblar. | 1 | CONDITIONAL | ELECTRICAL_BLOCKED | CAD_BLOCKED |
| CAN_CBUS | CAN | Capacitancias EMC simetricas opcionales | ATA6561-GAQW | 100 pF aprox | Matching lo menor posible | TBD bus | N/A | TBD | TBD | MISSING | MISSING | MISSING | S7 sections3.5-3.8; S8 fig1-6 | CALCULATED | Selected basic CAN-FD transceiver connection; optional bus shunt caps/choke DNP. No unnecessary capacitive load at2Mbps. | 0 | DNP | ELECTRICAL_VERIFIED | CAD_BLOCKED |
| CAN_CMC | CAN | Choke modo comun opcional | ATA6561-GAQW | TBD segun EMC | TBD | TBD | N/A | TBD | TBD | MISSING | MISSING | MISSING | S7 sections3.5-3.8; S8 fig1-6 | CALCULATED | Selected basic CAN-FD transceiver connection; optional bus shunt caps/choke DNP. No unnecessary capacitive load at2Mbps. | 0 | DNP | ELECTRICAL_VERIFIED | CAD_BLOCKED |
| CAN_STBY | CAN | Pull-up STBY externo | ATA6561-GAQW | TBD | TBD | TBD | N/A | TBD | TBD | MISSING | MISSING | MISSING | S8 table2.0 p11 and sections1.1/1.2 | CALCULATED | Internal STBY pull-up75..175k toVIO selects standby while MCU isHiZ. TXD internal20..50k pull-up gives recessive. MCU drives STBY low only after stable supplies; no external pull populated. | 0 | DNP | ELECTRICAL_VERIFIED | CAD_BLOCKED |
| CAN_TVS | CAN | TVS CAN externo segun inmunidad | ATA6561-GAQW | TBD | TBD | TBD | N/A | TBD | TBD | MISSING | MISSING | MISSING | S8 table2.0 absmax/ESD; S7 application schematic | CALCULATED | No external CAN TVS selected. Use manufacturer basic circuit. Built-in test ratings are component-level, not gateway IEC compliance. | 0 | DNP | ELECTRICAL_VERIFIED | CAD_BLOCKED |
| CAN_J | CAN | Bornera CANH/CANL/COM | ATA6561-GAQW | 3 polos | TBD | TBD | N/A | TBD | MX126-5.0-03P-GN01-Cu-S-A | GW_MX126-5.0-03P-GN01-Cu-S-A_d57a488f | GW_CAND_CON_3x1_TH_5mm | hardware/academic_rev1/libraries/Gateway_Academic.SchLib + Gateway_Academic.PcbLib | S7 circuito tipico | BLOCKED | Ratings/pinout, reglas de bus y opcion de terminacion pendientes. Modelo candidato existente; sin cotejo visual de pads/pines en Altium. | 1 | REQUIRED | ELECTRICAL_BLOCKED | CAD_CANDIDATE |
| CAN_RT | CAN | Optional conventional bus-end120Ohm termination | ATA6561-GAQW | 120 Ohm si Z0=120 Ohm | 1% | >=3.3 V continuo; falla de bus aparte | >=0.25 W objetivo a70 C | 1206 candidato; no0603 0.1W | TBD | MISSING | MISSING | MISSING | S8 basic CAN bus120Ohm termination; endpoint assumption | CALCULATED | Populate through jumper only at physical cable end; leave unpopulated at intermediate node. Does not set PCB differential impedance. | 1 | CONDITIONAL | DERIVED_PENDING_REVIEW | CAD_BLOCKED |

### BOM DO

| ID | Subsistema | Funcion | Referencia principal (fabricante) | Valor nominal | Tolerancia | Tension/corriente nominal | Potencia | Encapsulado | MPN recomendado/candidato | Simbolo candidato | Footprint candidato | Origen CAD | Fuente valor electrico | Estado global | Observaciones | Cantidad | Montaje | Estado electrico | Estado CAD |
|---|---|---|---|---|---|---|---|---|---|---|---|---|---|---|---|---|---|---|---|
| DO_CVCCA3V3 | DO | Desacoplo VCCA3V3 | SN74LVC2T45DCUR propuesto | 100 nF | 10% | 50 V; X7R; -55..125 C | N/A | 0603 | C0603C104K5RACTU | GW_C0603C104K5RACTU_dc5e12a5 | GW_CAND_0603_cap | hardware/academic_rev1/libraries/Gateway_Academic.SchLib + Gateway_Academic.PcbLib | S9 seccion8.3 (0.01/0.022uF por VCC multiple; 0.1uF aceptable paralelo) | PROVISIONAL | Ficha KEMET local p1. Adaptar parametros; no usar el Y5V 0603F104Z500CT como equivalente. Modelo candidato existente; sin cotejo visual de pads/pines en Altium. | 1 | REQUIRED | PROVISIONAL | CAD_CANDIDATE |
| DO_CVCCB5 | DO | Desacoplo VCCB5 | SN74LVC2T45DCUR propuesto | 100 nF | 10% | 50 V; X7R; -55..125 C | N/A | 0603 | C0603C104K5RACTU | GW_C0603C104K5RACTU_dc5e12a5 | GW_CAND_0603_cap | hardware/academic_rev1/libraries/Gateway_Academic.SchLib + Gateway_Academic.PcbLib | S9 seccion8.3 (0.01/0.022uF por VCC multiple; 0.1uF aceptable paralelo) | PROVISIONAL | Ficha KEMET local p1. Adaptar parametros; no usar el Y5V 0603F104Z500CT como equivalente. Modelo candidato existente; sin cotejo visual de pads/pines en Altium. | 1 | REQUIRED | PROVISIONAL | CAD_CANDIDATE |
| DO_RPDA | DO | Pulldown A1/A2 arranque | SN74LVC2T45/BSP75N | 10 kOhm | 1% | 75 V maximum; power-limited working voltage | 0.1 W at70C | 0603 | RC0603FR-0710KL | RC0603FR-0710KL | GW_CAND_0603_res | hardware/academic_rev1/libraries/Gateway_Academic.SchLib + Gateway_Academic.PcbLib | S9 table5.5; S10 p4 note8; schematic_readiness_gate.md DO1 | BLOCKED | 10k pull-down intent retained for reset OFF. Translator noOE, correct DIR=VCCA3V3. VOH at actual1.2mA+B pull-down load not guaranteed>=4.5V; full protection drive BLOCKED. Do not approve from nominal5V. | 2 | REQUIRED | ELECTRICAL_BLOCKED | CAD_CANDIDATE |
| DO_RPDB | DO | Pulldown B1/B2 arranque | SN74LVC2T45/BSP75N | 10 kOhm | 1% | 75 V maximum; power-limited working voltage | 0.1 W at70C | 0603 | RC0603FR-0710KL | RC0603FR-0710KL | GW_CAND_0603_res | hardware/academic_rev1/libraries/Gateway_Academic.SchLib + Gateway_Academic.PcbLib | S9 table5.5; S10 p4 note8; schematic_readiness_gate.md DO1 | BLOCKED | 10k pull-down intent retained for reset OFF. Translator noOE, correct DIR=VCCA3V3. VOH at actual1.2mA+B pull-down load not guaranteed>=4.5V; full protection drive BLOCKED. Do not approve from nominal5V. | 2 | REQUIRED | ELECTRICAL_BLOCKED | CAD_CANDIDATE |
| DO_RSER | DO | Resistencias serie control | BSP75N | TBD | TBD | TBD | N/A | TBD | TBD | MISSING | MISSING | MISSING | S10 IINmax1.2mA @5V; S9 VOH | PROVISIONAL | No agregar resistencia arbitraria que reduzca VIN bajo4.5V para protecciones. Revisar VOH con carga1.2mA+pulldown. | 0 | DNP | PROVISIONAL | CAD_BLOCKED |
| DO_SUPPRESS | DO | Supresion carga inductiva externa | BSP75NTA | TBD | TBD | TBD | N/A | TBD | TBD | MISSING | MISSING | MISSING | S10 tablas clamp/avalancha/termica pp3-6 | BLOCKED | Faltan L/ciclo/temperatura/tiempo desmagnetizacion; no declarar550mJ universal ni elegir diodo solo por corriente500mA. | TBD | TBD | ELECTRICAL_BLOCKED | CAD_BLOCKED |
| DO_JLOAD | DO | Bornes Vcampo/DRAIN por carga | BSP75NTA | 2 polos por canal | TBD | >=30 V y0.5 A/canal mas fallas | N/A | TBD | JL126-50002G01 | GW_JL126-50002G01_ddbad43f | GW_CAND_CON_2x1_TH_5MM | hardware/academic_rev1/libraries/Gateway_Academic.SchLib + Gateway_Academic.PcbLib | S10 low-side; requisitos alcance | BLOCKED | Priorizar bornera docente; source/tab a retorno campo; no terminal high-side. Retornos1A fuera GND analogico. Modelo candidato existente; sin cotejo visual de pads/pines en Altium. | 2 | REQUIRED | ELECTRICAL_BLOCKED | CAD_CANDIDATE |

### BOM DI

| ID | Subsistema | Funcion | Referencia principal (fabricante) | Valor nominal | Tolerancia | Tension/corriente nominal | Potencia | Encapsulado | MPN recomendado/candidato | Simbolo candidato | Footprint candidato | Origen CAD | Fuente valor electrico | Estado global | Observaciones | Cantidad | Montaje | Estado electrico | Estado CAD |
|---|---|---|---|---|---|---|---|---|---|---|---|---|---|---|---|---|---|---|---|
| DI_RSENSE1 | DI | SENSE1 a IN1 | ISO1212DBQR propuesto | 562 Ohm | 1% | 75 V max; limite sqrt(P*R) | 0.1 W @70 C | 0603 | RC0603FR-07562RL | GW_RC0603FR-07562RL_a6fad8df | GW_CAND_0603_res | hardware/academic_rev1/libraries/Gateway_Academic.SchLib + Gateway_Academic.PcbLib | S11 equation1 and table5.9; Yageo local exact-value sheet | CALCULATED | 562Ohm1%; current limit2.25mA typical; selected Type3. Conservative P at2.75mA and R+1%=4.29mW. SENSE-IN resistor, not across24V. | 1 | REQUIRED | ELECTRICAL_VERIFIED | CAD_CANDIDATE |
| DI_RTHR1 | DI | Serie entrada124V Type3 | ISO1212DBQR | 1 kOhm | 1% | 200 V maximum working; DC applied drop <3 V; pulse gate separate | 0.25 W at70C, derated to0 at125C | MELF0204 MM204 | MM204F1K00TKRTR3K0 | MM204F1K00TKRTR3K0 | GW_MM204_FIRSTOHM | hardware/academic_rev1/libraries/Gateway_Academic.SchLib + Gateway_Academic.PcbLib | FDI Firstohm MM rev08-March-2023 pp75-78; S11 section8.2.1.2.1/table5.9/table8-1 | CALCULATED | Selected MM2041k1%0.25W for NORMAL Type3 operation. At2.75mA and R+1%,P<=7.64mW. Non-P MM204 curve/overload limits do not establish500V line-FGND or1kV system surge. Reflow lands1.3x1.6 innergap1.6mm. | 1 | REQUIRED | DERIVED_PENDING_REVIEW | CAD_CANDIDATE |
| DI_CIN1 | DI | SENSE1 a FGND1 | ISO1212DBQR | 10 nF | 10% | 100 V; X7R; -55..125 C | N/A | 0603 | C0603C103K1RACTU | GW_C0603C103K1RACTU_97f3ee33 | GW_CAND_0603_cap | hardware/academic_rev1/libraries/Gateway_Academic.SchLib + Gateway_Academic.PcbLib | S11 figure8-2/table8-1/section8.4; local KEMET sheet | CALCULATED | 10nF100V SENSE-to-field COM. TI Type3/10nF test setup lists500V line-FGND,1kV other surge modes; not a demonstrated gateway rating. No extra TVS populated. | 1 | REQUIRED | ELECTRICAL_VERIFIED | CAD_CANDIDATE |
| DI_RSENSE2 | DI | SENSE2 a IN2 | ISO1212DBQR propuesto | 562 Ohm | 1% | 75 V max; limite sqrt(P*R) | 0.1 W @70 C | 0603 | RC0603FR-07562RL | GW_RC0603FR-07562RL_a6fad8df | GW_CAND_0603_res | hardware/academic_rev1/libraries/Gateway_Academic.SchLib + Gateway_Academic.PcbLib | S11 equation1 and table5.9; Yageo local exact-value sheet | CALCULATED | 562Ohm1%; current limit2.25mA typical; selected Type3. Conservative P at2.75mA and R+1%=4.29mW. SENSE-IN resistor, not across24V. | 1 | REQUIRED | ELECTRICAL_VERIFIED | CAD_CANDIDATE |
| DI_RTHR2 | DI | Serie entrada224V Type3 | ISO1212DBQR | 1 kOhm | 1% | 200 V maximum working; DC applied drop <3 V; pulse gate separate | 0.25 W at70C, derated to0 at125C | MELF0204 MM204 | MM204F1K00TKRTR3K0 | MM204F1K00TKRTR3K0 | GW_MM204_FIRSTOHM | hardware/academic_rev1/libraries/Gateway_Academic.SchLib + Gateway_Academic.PcbLib | FDI Firstohm MM rev08-March-2023 pp75-78; S11 section8.2.1.2.1/table5.9/table8-1 | CALCULATED | Selected MM2041k1%0.25W for NORMAL Type3 operation. At2.75mA and R+1%,P<=7.64mW. Non-P MM204 curve/overload limits do not establish500V line-FGND or1kV system surge. Reflow lands1.3x1.6 innergap1.6mm. | 1 | REQUIRED | DERIVED_PENDING_REVIEW | CAD_CANDIDATE |
| DI_CIN2 | DI | SENSE2 a FGND2 | ISO1212DBQR | 10 nF | 10% | 100 V; X7R; -55..125 C | N/A | 0603 | C0603C103K1RACTU | GW_C0603C103K1RACTU_97f3ee33 | GW_CAND_0603_cap | hardware/academic_rev1/libraries/Gateway_Academic.SchLib + Gateway_Academic.PcbLib | S11 figure8-2/table8-1/section8.4; local KEMET sheet | CALCULATED | 10nF100V SENSE-to-field COM. TI Type3/10nF test setup lists500V line-FGND,1kV other surge modes; not a demonstrated gateway rating. No extra TVS populated. | 1 | REQUIRED | ELECTRICAL_VERIFIED | CAD_CANDIDATE |
| DI_CVCC | DI | VCC1 a GND1 logico | ISO1212DBQR | 100 nF | 10% | 50 V; X7R; -55..125 C | N/A | 0603 | C0603C104K5RACTU | GW_C0603C104K5RACTU_dc5e12a5 | GW_CAND_0603_cap | hardware/academic_rev1/libraries/Gateway_Academic.SchLib + Gateway_Academic.PcbLib | S11 seccion8.3 | PROVISIONAL | Ficha KEMET local p1. Adaptar parametros; no usar el Y5V 0603F104Z500CT como equivalente. Modelo candidato existente; sin cotejo visual de pads/pines en Altium. | 1 | REQUIRED | PROVISIONAL | CAD_CANDIDATE |
| DI_CPE | DI | Acoplo FGND a PE opcional | ISO1212DBQR | 500 pF candidato | TBD | 2 kV; seguridad por definir | N/A | TBD | TBD | MISSING | MISSING | MISSING | S11 fig8-2 | BLOCKED | No puente aGND1; solo si existePE/arquitectura aislamiento aprobada. No copiar automaticamente. | 1 | CONDITIONAL | ELECTRICAL_BLOCKED | CAD_BLOCKED |
| DI_TVS | DI | TVS adicional entrada si EMC requiere | ISO1212DBQR | TBD | TBD | TBD | N/A | TBD | TBD | MISSING | MISSING | MISSING | S11 seccion8.2.1.2.5 tabla8-1 | PROVISIONAL | Red TI tiene robustez condicionada aMELF/CIN/layout; no agregarTVS28V sin revisar ubicacion trasRTHR, umbral y clamp. | 0 | DNP | PROVISIONAL | CAD_BLOCKED |
| DI_J | DI | Bornera IN1/IN2/COM campo | ISO1212DBQR | 3 polos si COM comun | TBD | TBD | N/A | TBD | MX126-5.0-03P-GN01-Cu-S-A | GW_MX126-5.0-03P-GN01-Cu-S-A_8a7ef64c | GW_CAND_CON_3x1_TH_5mm | hardware/academic_rev1/libraries/Gateway_Academic.SchLib + Gateway_Academic.PcbLib | S11 figure8-9 common field ground; selected two-channel group-isolated input configuration | PROVISIONAL | IN1/IN2/FIELD_COM. FGND1 and FGND2 share FIELD_COM on field side only; GND1 remains separate. Group isolation selected, no channel-to-channel rating claimed. Exact connector drawing remains pending. | 1 | REQUIRED | PROVISIONAL | CAD_CANDIDATE |
