anhenaobe/industrial-comunication-gateway/docs/hardware/evidence/electrical_closure/baseline/passive_component_selection.md

# Selección de pasivos — candidato académico, 2026-11-05

**Actualización CAD 2026-11-06:** se guardaron 37 símbolos y 15 footprints en
`Gateway_Academic.SchLib/PcbLib`, con validación estructural de archivos sin errores.
Hay 19/26 candidatos de símbolo y 15/26 pares candidatos para las especificaciones
obligatorias. El estado final sigue **Conditional**. La sección de acceso Altium y
la estimación CAD de abajo conservan la evaluación histórica anterior; el estado
vigente, la compilación pendiente y los componentes inconclusos están en el
[informe de preparación](altium_library_preparation_report.md). Las tablas
regeneradas usan los enlaces locales y los estados CAD/eléctricos independientes.

**BOM de preparación y cierre, no liberada para compra ni fabricación.** El alcance de esta tarea es STM32H723VET6, DP83826I, un THVD1420, un ATA6561, un ISO1212 para dos DI, dos BSP75N, un SN74LVC2T45 y dos LMR36015. La entrada única 18–30 V sigue pendiente de arquitectura. No se modifica ni sustituye Rev. A. No hay validación eléctrica del circuito por disponer de esta lista.

Se cuantifican **71 pasivos en posiciones conocidas** del candidato, más **cuatro grupos obligatorios cuya cantidad no puede cerrarse** (dos bancos CIN y dos redes de terminación Ethernet). Hay **14 posiciones pasivas condicionales cuantificadas**, además de redes condicionales/TBD sin cantidad y redes DNP. Estos números no constituyen un total final de compra. Las 71 posiciones siguen pendientes de homologación integral.

Se identifican **26 especificaciones diferentes obligatorias**, incluidas especificaciones pendientes, y **20 MPN concretos candidatos** entre los grupos obligatorios. **57 de las 71 posiciones** tienen una ruta candidata de reutilización de símbolo/footprint docente; **14 requieren resolver recursos externos**. Componentes completamente resueltos con la librería docente: **0**; con CAD externo homologado: **0**. No confundir candidato CAD con equivalente eléctrico verificado.

Los resultados reproducibles están en [passive_bom.csv](passive_bom.csv), [cad_library_mapping.csv](cad_library_mapping.csv) y [recuentos](evidence/passive_selection_counts.json). Las tablas por subsistema al final proceden del CSV. `component_id` es un ID documental estable; `design_reference=UNASSIGNED`: todavía no hay referencias C1/R1/L1 asignadas por un esquemático. `main_reference` identifica el IC que exige la red, nunca la referencia de diseño del pasivo. Las cantidades de una fila son unidades idénticas; filas de diferentes funciones no se eliminan por tener el mismo MPN.

## Evidencia inicial y conservación

Se ejecutó `git status --short` antes de trabajar. Había cambios previos en cuatro archivos de firmware y directorios/archivos sin seguimiento de hardware, informes, IntLib y simulaciones. Se conservaron. Se revisaron `cad_readiness_assessment.md`, el inventario y el maestro real `docs/industrial_gateway_requirements.md`, especialmente §§3–6 y 8. El informe de factibilidad es antecedente: las propuestas de cambiar MCU o eliminar CAN no prevalecen sobre el alcance expresamente indicado aquí.

Maestro SHA256 inicial: `94cf02d2ffda0c162331bf360872836a6e84cea0d94c643ddbf0c56d39a1b4c6`. IntLib original SHA256: `91594ede8aadf6449fff5b44b7443deafeb73cfaf0bc1eb1ff434d8ac1fb6159`. No se editaron estos archivos, ni firmware, ni SchDoc/PcbDoc. No commit/push.

Fuentes locales principales: `C:/dev/7mo/design/Datasheets_industrial_gateway/`. Los PDF de EVM, fichas de DI y modelos existentes están en `hardware/academic_rev1/libraries/`. No se repitió la extracción binaria del inventario ni el análisis histórico de TINA. Los SchLib/PcbLib docentes ya extraídos tienen su procedencia y hashes en `library_manifest.json`; no equivalen a una extracción oficial confirmada en esta sesión.

## Registro de fuentes

Los números de página son los impresos, salvo indicación PDF. Las ecuaciones aplicadas abajo son cálculos propios a partir de los límites citados. Una ficha de un pasivo identifica sus características nominales; no demuestra por sí sola su aplicación ni el pad CAD.

| ID | Fuente primaria / copia | Localizador utilizado |
|---|---|---|
| S1 | ST DS13313 Rev.5, `DS_stm32h723zg.pdf`, [oficial](https://www.st.com/resource/en/datasheet/stm32h723ve.pdf) | Fig.5 p54 LQFP100; tabla7; tabla14 p92; fig.18 p135; características de oscilador y alimentación |
| S2 | [ST AN5419 Rev.3, enero 2026](https://www.st.com/resource/en/application_note/an5419-getting-started-with-stm32h723733-stm32h725735-and-stm32h730-value-line-hardware-development-stmicroelectronic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) | Tabla2 pp7–8; fig.3; §3 relojes; §5.2 fig.19 p30; §6 debug. Consultado web; descarga local agotó tiempo |
| S3 | TI SNLS647I, `dp83826i.pdf`, [oficial](https://www.ti.com/lit/ds/symlink/dp83826i.pdf) | Tabla5-1; §8.3.10; §8.4/tablas8-6 a8-16; figs.9-2/9-4/9-6; tablas9-1/9-2; §9.4 |
| S4 | TI SNLU262A, [DP83826EVM](https://www.ti.com/lit/ug/snlu262a/snlu262a.pdf), copia local disponible | Fig.6-2 p17; BOM tabla7-1 pp21–32. Archivo `DP83826EVM_snlr047.zip` contiene PDF/esquema/Gerber, **no SchLib/PcbLib** |
| S5 | TI SNVSB49D, `lmr36015.pdf`, [oficial](https://www.ti.com/lit/ds/symlink/lmr36015.pdf) | Variantes p3; pines p4; límites §8.5; tabla10-1 p19; ecuaciones3–10 pp21–24; tabla10-5 p30; §§11–12 pp33–35 |
| S6 | TI SLLSF78B, `thvd1400.pdf`, [oficial THVD1420](https://www.ti.com/lit/ds/symlink/thvd1420.pdf) | §7.4; fig.8-1; fig.8-5/tabla8-1 p19; §9; §10.1 p20 |
| S7 | Microchip DS50002649A, `ATA656x_EVKit_50002649A.pdf`, [oficial](https://ww1.microchip.com/downloads/aemDocuments/documents/OTH/ProductDocuments/UserGuides/50002649A.pdf) | §§3.3–3.8 pp17–18; apéndiceA circuito/layout; tablaB-2 p32 para pin5=VIO |
| S8 | Microchip DS20005991B, `20005991B.pdf`, [oficial](https://ww1.microchip.com/downloads/en/DeviceDoc/20005991B.pdf) | Pines y modos; límites y tabla eléctrica; fig.2-1 es **ensayo de timing**, no circuito mínimo de producto |
| S9 | TI SCES516N, `sn74lvc2t45.pdf`, [oficial](https://www.ti.com/lit/ds/symlink/sn74lvc2t45.pdf) | §6.3/6.5; tabla7-1; §7.3 Ioff/HiZ; §§8.3–8.4, fig.8-3 |
| S10 | Diodes DS33016 Rev.7-2 enero2024, `BSP75N.pdf`, [oficial](https://www.diodes.com/assets/Datasheets/BSP75N.pdf) | Pinout p1; ratings/notas5–8 pp3–4; térmica pp5–6; dimensiones/land pattern pp7–8 |
| S11 | TI SLLSEY7G, `iso1212.pdf`, [oficial](https://www.ti.com/lit/ds/symlink/iso1212.pdf) | §8.2.1.2.1 ecuaciones1–4 pp20–21; tabla8-1 p24; fig.8-2; §8.3; §8.4 pp30–32 |
| P1–P4 | Fichas KEMET locales nuevas en `sources/passives/`: C0603C104K5RACTU, C0603C225K8RACTU, C0805C475K4RACTU, C0603C202J5GACTU | p1, Specifications/Dimensions. P1=100 nF50V X7R; P2=2.2 µF10V X7R; P3=4.7 µF16V X7R; P4=2 nF50V C0G |
| P5 | Fichas Yageo locales nuevas RC0603FR-07… | p1: valor,1%,0.1W@70°C,75V máximo y dimensiones. El límite por potencia puede ser menor que75V |
| P6 | [Coilcraft XAL40xx, documento806 Rev.25feb2026](https://www.coilcraft.com/getmedia/6adcb47d-8b55-416c-976e-1e22e0d2848c/xal4000.pdf) | p1 ratings/notas; p4 dibujo. Consulta web disponible; descarga directa403; no CAD descargado |
| P7 | [TDK C5750X7R2A475K230KA](https://product.tdk.com/en/search/capacitor/ceramic/mlcc/info?part_no=C5750X7R2A475K230KA) | Electrical Characteristics/Size; [curvas oficiales](https://product.tdk.com/info/en/documents/chara_sheet/c5750x7r2a475k230ka.pdf), p1; sin lectura numérica certificada de curva |
| P8 | [TDK C3225X7R1C156M250AB](https://product.tdk.com/en/search/capacitor/ceramic/mlcc/info?part_no=C3225X7R1C156M250AB) | Electrical Characteristics/Size; Ceff/ESR bajo bias pendientes; descarga directa403 |
| P9 | [Samsung CL10A105KB8NNN](https://product.samsungsem.com/mlcc/CL10A105KB8NNN.do), [CL21A106KAYNNN](https://product.samsungsem.com/mlcc/CL21A106KAYNNN.do) | Características/dimensiones y muestras JSON `datasheetData/DCBias`; HTML local con hash. C/E son códigos de embalaje |
| P10 | Fichas previas ISO1212_RSENSE_RC0603FR07562RL.pdf y DI_CIN_C0603C103K1RACTU.pdf | p1; 562Ω1%0.1W/75V, 10 nF10%100V X7R. El CL10B103KA8WPNC externo es otro MPN |

Los manifiestos de adquisición conservan fallos 403/404/timeouts. Una URL intentada no demuestra disponibilidad. No se incorporan los MPN KEMET 4.7 µF100V/15 µF cuyos intentos devolvieron404. No se dispone de cotización/inventario físico. Las fichas nominales nuevas se descargaron; los nuevos modelos CAD todavía no.

## MCU — mínimo LDO, sin copiar la Nucleo

El cotejo visual de S1 fig.5 confirma VDD en 11/27/50/75/100, VSS en 10/26/49/74/99, VDDA21, VSSA19, VREF+20, VBAT6 y VCAP48/73. **No hay pines separados VDD33USB, VDD50USB, VDDLDO ni SMPS en este LQFP100.** No añadir el inductor de un H725 ni inventar conexiones a pines ausentes. La tabla CSV de pines existente es auxiliar y conserva correcciones manuales; la figura y tabla del fabricante prevalecen.

El candidato conecta VDDA a3.3V, VREF+ aVDDA con VREFBUF deshabilitado y VBAT aVDD sin batería. Se conserva desacoplo por cada función. Para VCAP se adopta el modo **LDO interno**, dos 2.2 µF ±20% permitidos y ESR<100 mΩ (S1 tabla14). Los KEMET propuestos son2.2 µF10V X7R ±10%; falta verificar ESR/capacidad real aVCORE. No se aprueba reemplazarlos por los22 µF docentes.

NRST usa100 nF según S1 fig.18 y pulsador aGND; pull-up interno, sin sumar uno externo automáticamente. BOOT0 tiene10 kΩ aGND y acceso a3.3V de recuperación; es el ejemplo típico S2, no un valor garantizado universal. Verificar option bytes al poner en marcha. SWD reserva PA13/PA14/NRST/VTref/GND; header docente1x6 es candidato de pinout propio, no conector ARM estándar homologado. Ninguna resistencia serie SWD es obligatoria sin análisis de señal.

HSI permite dibujar el mínimo de alimentación y debug. **La precisión de FDCAN y reloj final sigue abierta**: HSI no demuestra operación CAN-FD con la tolerancia del sistema. Si se requiere HSE, elegir cristal/osc. y frecuencia a partir del árbol de reloj; calcular cargas, ESR, drive y margen de arranque con [ST AN2867 Rev.25, §§3.3–3.8 y 7](https://www.st.com/resource/en/application_note/an2867-oscillator-design-guide-for-stm8afals-stm32-mcus-and-mpus-stmicroelectronics.pdf). No se asignan33 pF por existir en la librería. LSE/RTC externo queda DNP por ausencia de requisito.

## Ethernet — circuito candidato y conflictos pendientes

S3 fig.9-6 se verificó visualmente: **un banco10 µF+1 µF+100 nF+10 nF por alimentación**, dos bancos en total; no duplicar variantes de dibujo. VDDA3V3 pin3 y VDDIO pin17 a3.3V. Ferritas opcionales, sin poblar por defecto. RBIAS pin10=6.49 kΩ1% aGND: usando3.3V como cota conservadora, P<1.68mW; un 0603 0.1W tiene margen estático, sujeto a su derating.

**CEXT pin2=2 nF aGND** según tabla5-1 del datasheet actual. La EVM tiene C57=100 nF: discrepancia documentada, no se traslada ese valor. La red CEXT es distinta de los center taps de magnetics aunque comparta valor nominal.

Propuesta coherente con el presupuesto vigente: **ENHANCED, RMII leader, PHY address0**, autonegociación y Auto-MDIX. El MCU recibe50 MHz desde pin19 del PHY; el PHY necesita25 MHz en XI/XO. No conectar ese reloj a PH0 como si fuera automáticamente HSE; llega al pin MAC ETH_REF_CLK que se asigne.

| Strap | Candidato | Evidencia S3 |
|---|---|---|
| ModeSelect pin1 | NC, PU interno: ENHANCED | tabla5-1 |
| Strap1 pin31 |1 default, sin LED/carga; muestreado solo POR | tabla8-7/fig8-13 |
| Strap8 RX_D2 pin14 |PU externo2.49 kΩ1% aVDDIO, valor1 | tablas8-6/8-7 |
| Strap5 TX_CLK pin22 |0 default: leader | fig8-13 |
| Strap7 RX_D3 pin13 |0 default: CRS_DV, sin repeater | fig8-13 |
| Strap9/0/10 pines15/16/18 |0 default: Auto-MDIX/autonegociación | tabla8-8 |
| Strap2/3/4 pines30/29/28 |000 default: PHY address0 | tabla8-10 |
| Strap6 RX_ER pin20 |0 default: CLKOUT25 MHz pin31, distinto de REF_CLK50 MHz pin19 | tabla8-9 |

Esto es una **propuesta documentada**, no un cambio ya aplicado. El MAC debe estar HiZ durante muestreo; GPIOs/LEDs no deben alterar straps. Con PU interno mínimo7.5 kΩ y pulldown externo si se cambiase modo, usar los umbrales reales, no copiar resistores de otro PHY. No hace falta poblar todos los straps por tener opciones.

El cristal EVM ECS-250-12-33Q-JES-TR y cargas22 pF no cierran la selección: S3 tabla9-2 actual pide CL15–40 pF, ESR≤50Ω y tolerancia **total**±50 ppm. El sufijo12 del candidato EVM requiere cotejo de CL; no se declara compatible por ser25 MHz. Fórmula propia para cargas iguales: C1=C2=2(CL−Cstray). Sin Cstray/drive y cristal seleccionado, C1/C2/R1 continúan BLOCKED.

Magnetics HX1188FNLT y jack SS-7188S-A-NF son candidatos **de la BOM EVM**, no elecciones definitivas. Deben cotejarse relación1:1, HPOT1500 Vrms, inserción/retorno/rechazo de tabla9-1, pinout, taps y conexiones internas. S3 fig.9-2 muestra dos 2 nF, dos 75Ω y 10 nF; la EVM usa otra red con cuatro100 nF, cuatro75Ω y dos 1 nF/2kV. **No superponer ambas.** La BOM mantiene las redes dependientes del jack bloqueadas y sin cantidades falsas. Las terminaciones MDI integradas no autorizan copiar cuatro49.9Ω de otro PHY. El resistor docente49.9 kΩ tampoco es49.9Ω.

TPD4E05U06DQAR, C61=4.7 nF/2kV AVX1812GC472KAT1A y R51=1MΩ de EVM quedan candidatos. Falta revisar fichas/protección/PE; el capacitor docente1 nF50V no sirve de aislamiento. No importar MSP430, hub USB, fuentes, LEDs, magnetics de filtro de alimentación ni jumpers de medición de la EVM. MDIO tiene PU interno; añadir pull-up solo si el tiempo de subida lo requiere. RST_N se controlará con secuencia documentada; no inventar RC ni compartir NRST sin revisar tiempos.

## Alimentación — dos diseños separados FB/1 MHz

Se conserva **LMR36015FBRNXR propuesto**, RNX12, ajustable, FPWM1 MHz, sujeto a congelar pedido. AR es400 kHz/PFM; BR1 MHz sin F tampoco equivale aFB. S5 tabla10-5 corresponde aFB pero usa otras condiciones y 8.5 µH/2×15 µF: no se copia como BOM universal. El candidato parte de tabla10-1 y aplica ecuaciones del mismo IC a18–30V, cargas de diseño0.7A/0.1A. No se toma el consumo antiguo de dos RS-485/cuatro DI como medida del alcance reducido.

### Inductores y límites

Cálculo propio por S5 ecuación4: ΔIL=Vout(1−Vout/Vin)/(L f); K=ΔIL/1.5A, porque TI exige usar la capacidad del IC al elegir rizado aunque la carga sea menor. Ecuación5: Lmin=0.28 Vout/f. No se dimensiona el inductor5V como si el límite interno fuera0.1A.

| Parámetro calculado |3.3V/0.7A |5V/0.1A |
|---|---:|---:|
| L nominal tabla10-1 |6.8 µH |10 µH |
| ΔIL a30V/1 MHz/Lnom |0.432A |0.417A |
| K respecto1.5A |28.8% |27.8% |
| ΔIL a30V/fmin0.85 MHz/L−20% |0.635A |0.613A |
| Pico a carga de diseño en esa esquina |1.018A |0.406A |
| Irms ideal en esa esquina |0.724A |0.203A |
| Lmin ecuación5/fmin |1.087 µH |1.647 µH |
| ton ideal mínimo a30V/fmax1.15 MHz |95.7ns |144.9ns |

La última fila supera ton-min máximo83ns tabulado (§8.5); es comprobación ideal, no prueba de regulador físico. Se ha incluido dispersión de frecuencia0.85–1.15 MHz y toleranciaL; faltan caídaL con I/T, pérdidas y transitorios. En5V la corriente mínima es negativa en FPWM (aprox−0.206A en la esquina anterior), coherente con circulación de corriente a carga ligera; no atribuir eficiencia PFM a ese caso.

Candidatos P6: XAL4030-682MEC, DCRmax25°C74.1 mΩ, Isat3.6A, Irms3.0A para20°C de subida; XAL4040-103MEC,92.4 mΩ, Isat3.0A, Irms2.2A para20°C. Isat es caída típica30% a25°C: **no es un mínimo garantizado en caliente**. Comparar con límite high-side máximo2.8A y low-side máximo2.07A; falta curva en caliente/inductancia residual, núcleo y sobrecorriente. Pcu calculada I²DCR a la esquina anterior es aproximadamente39mW/3.8mW a25°C, sin pérdidasAC/núcleo. No reemplazar por CY54-10UH1.42A sin Isat ni por CYA0630 con descripción contradictoria10/2.2 µH.

### Capacitores, feedback y configuración

Cada buck requiere su bancoCIN, dos 220 nF VIN–PGND,100 nF BOOT–SW≥16V y 1 µF VCC–GND≥16V. VCC es interno, no el rail5V de cargas. EN aVIN y PG sin uso son el mínimo documentado: no se añaden divisoresUVLO/pull-upPG sin función. NC pin3 debe unirse aSW pin12 según S5, aunque se llame NC.

ParaCIN se identificó C5750X7R2A475K230KA,4.7 µF100V X7R2220. No existe equivalente docente eléctrico demostrado. **Cantidad pendiente** para garantizar Ceff≥4.7 µF como criterio conservador de esta selección; TI exige4.7 µF y aconseja tensión preferiblemente dobleVinmax, no afirma que un 4.7 µF nominal mantenga ese valor a30V. Calcular Ceff=Cnom×(1−tolerancia)×factorbias×factorT×factoraging con información del fabricante. Las curvas TDK son típicas, no límites garantizados; no se inventa un porcentaje. BancoCIN: IRMS≈Iout/2 como cota de S5 ec.8,0.35A/0.05A respectivamente. Verificar calentamiento/ESR, reparto y fuente/cable.

ParaCOUT se proponen3×15 µF16V X7R C3225X7R1C156M250AB por salida, siguiendo el **valor nominal** de tabla10-1. Mínimo de tamaño tabulado2×15 µF no es sinónimo de 30 µF efectivos. El fabricante TDK da1210, cuerpo3.20±0.40×2.50±0.30×2.50±0.30mm; comprobar land pattern oficial, sin suponer0805 docente. Falta extraer Ceff/ESR a3.3V y 5V y fijar escalón/rizado admisible. No se pueden cerrar ec.6/7 sin esos requisitos; calcular ΔV≈ΔIL/(8fCeff)+ΔIL×ESR es una cota conservadora inicial, no estabilidad. Para lazo/arranque, incluir todos los desacoplos distribuidos y límites de carga, medir/simular Bode y transitorios FB.

Divisor: RFBT100 kΩ, RFBB43.2 kΩ/24.9 kΩ1% (S5 ec.3). Nominal propio3.31481V/5.01606V. Combinando extremos independientes de resistores1% y VFB0.985–1.015V: **3.21994–3.41200V** y **4.86249–5.17365V**, sin sumar line/load ripple. Pmáx resistor superior<0.18mW. CFF20 pF C0G es guía de tabla10-1; reservar condicional hasta cerrar lazo, no declararlo obligatorio con 100 kΩ. No llevar100 nF de BOOT aGND; va aSW.

**DC bias docente comprobado:** las muestras del fabricanteP9 a25°C/1 kHz/1 Vrms, interpoladas linealmente, dan CL10A105KB8NNN≈0.816 µF a3.3V y≈0.656 µF a5V; CL21A106KAYNNN≈6.95 µF a3.3V. Son curvas típicas antes tolerancia/T/envejecimiento. [Cálculos](evidence/passive_bias_calculations.json). Esto impide declarar el 1 µF docente como 1 µF efectivo en VCC del buck; su fila quedaBLOCKED hasta resolver componente/banco y aplicabilidad. Tampoco usar10 µF25V en 30V ni100 µF35V frente a un clamp no definido. El100 nFY5V queda descartado eléctricamente como equivalenteX7R, aunque su símbolo/patrón0603 sea candidato reutilizable.

### WEBENCH/TINA preservados

`docs/sources/webench/LMR36015_WEBENCH_BOM.csv` corresponde aARNXR/5V;22 µH,47 µF y valores de capacidad efectiva son de ese diseño. Sus310 nF efectivos de CIN y 47 nF de bypass no demuestran el mínimo de S5. `LMR66420_*` pertenece a otro IC y no se utiliza. T9/T10 están identificados documentalmente como ARNXR18–30V a3.3/5V, títulos1A; no se ejecutó TINA ni se reconstruyó netlist binaria. No hay resultadosFB validados. Guardar nueva simulación con MPN,modelo,pasivos,esquinas y carga de cada salida antes de liberación.

## Entrada — requisitos de cierre, sin heredar el front-end anterior

No hay un esquema simplificado aprobado que permita contar sus pasivos. Las cinco filas funcionales no son cinco piezas: fusible/eFuse, polaridad inversa, transitorios/OV continua, reserva/damping y filtro si necesario pueden tener varias piezas o integrarse en otras. Su cantidad queda vacía/TBD. Los dos CIN locales de bucks no sustituyen la reserva de cableado sin comprobar impedancia.

La corriente incluye las dos cargasDO (hasta1A de campo si se alimentan desde esta entrada), másPin_bucks/Vin y DI si salen de la misma fuente. Una expresión inicial es Iin=Icampo+[3.3I3/η3+5I5/η5]/Vin; no asignarη ni calibre de fusible arbitrario. Elegir fusible por corriente,derating,I²t,inrush y capacidad de corteDC; inversión por corriente/VR/caída/térmica; OV continua por desconexión o energía admisible, no por TVS solamente.

Coordinación exigida: VRWM≥máximo continuo con tolerancia de fuente; VC(Ipulso,T)+Ldi/dt inferior al límite del **eslabón más débil**, y energía/corriente de TVS y fusible compatibles. LMR36015:60V operación/66V absmaxVIN; BSP75N:60V continuo, con ratings de clamp internos distintos; ningún valor absoluto es objetivo de diseño. UnTVS33V cuyo clamp sea53.3V podría parecer compatible con 60V, pero ese ejemplo **no selecciona** una protección: falta pulso,overshoot,temperatura y coordinación. Si reaparece LTC4414,40V absoluto vuelve a ser limitante y TDS3011P40V no deja margen. LTC4414/DMP6023LSS/NIS3071 y 43.2 kΩ de ILIM quedan fuera del candidato hasta decisión expresa. Una eventual43.2 kΩ de FB del buck tiene otra función.

S5 §11 desaconseja supresores con snap-back que llevenVIN por debajo de VOUT y descarguenCOUT hacia entrada. CualquierTDS debe comprobarse contra esa condición; su nombre en Rev.A no acredita aplicabilidad aquí. No se ha definido frecuencia de filtroLC, componentes ni cumplimientoEMC.

## RS-485 — un THVD1420 a3.3V

100 nF juntoVCC (S6 §9). DE y nRE independientes aGPIO, con 10 kΩ aGND y VCC respectivamente para reposo deshabilitado, conforme a§10.1 y fig.8-5; si se decide unirlos, redimensionar y sustituir estas filas, no conservar pulls opuestos. Fail-safe open/short/idle integrado: **cero bias de bus externo** por defecto; revisar la red completa si otros nodos lo requieren.

Terminación120Ω solo siZ0=120Ω y esta placa es extremo. A3.3V y RT−1%, P≈3.3²/118.8=91.7mW; ya consume casi los100mW de la pieza docente antes tolerancia de rail/calor. Objetivo candidato≥0.25W, encapsulado1206 por resolver; no homologar0603 por coincidir120Ω. Esto no cubre una falla sostenida24V sobreRT.

Para surge, S6 fig.8-5/tabla8-1 propone dos 10Ω pulse-proof CRCW0603010RJNEAHP y CDSOT23-SM712. La figura usaTHVD1400 a5V; nuestra implementaciónTHVD1420 a3.3V y velocidad aún no definida requiere revisarVOD tras20Ω adicionales, cargaRT, capacitanciaTVS, tiempos y corriente residual. El clampTVS puede superar±16V absmax del bus: no aprobarlo aislado ni suponer que los resistores lo solucionan sin cálculo de pulso. Protección integradaESD/EFT no demuestra inmunidadsurge del sistema. Conector docente3polos candidato A/B/COM; mantener stubs mínimos según topología/velocidad que se apruebe.

## CAN-FD — VCC5V, VIO3.3V

Se adopta de S7 tablaB-2 el desacoplo100 nF de cada rail. No unirVIO a5V por el jumper de evaluación. La fig.2-1 de S8 tiene22 µF,15 pF y RL/CL de ensayo; **no son pasivos universalmente exigidos**. Reserva47 µF/10V de EVM queda condicional a distribución real de 5V.

En un extremo, S7 §3.5 propone split termination2×60Ω o62Ω y 4.7–47 nF al punto medio. Candidato BOM EVM:2×62Ω0.5W1206 y 4.7 nF50V0805;124Ω entreCANH/L, tolerancia entre mitades<1% deseable. No sustituir por dos 120Ω ni montar una resistencia60Ω por nodo: dos extremos120/124Ω generan aproximadamente60/62Ω vistos por el driver. Si es nodo intermedio, DNP toda la terminación. Resistencias/TVS deben evaluarse también para falla a24V.

STBY tienePU interno75–175 kΩ aVIO; dejarGPIOHiZ conserva standby, sin pull-down automático. TXD también tienePU; revisar estado inicial de GPIO. Los100 pF en cada línea y CMC de S7 son opcionesEMC, no obligatorios para5Mbps: no montarlos sin presupuesto de capacitancia y timing. LaTVS y el conector permanecen pendientes de norma/cable. El conector docente3polos es candidato mecánico verificable, no prueba de protección.

## DO — dos low-side y traductor

DIR aVCCA, A→B, VCCA3.3V/VCCB5V. Desacoplo por rail; S9 §8.3 recomienda0.01/0.022 µF por alimentación múltiple y permite paralelos0.1/1 µF. Se propone100 nF por rail como elección de aplicación, **no se atribuye un mandato de 100 nF por cada rail al datasheet**.

Pulldowns10 kΩ candidatos en A1/A2 y B1/B2; no añadir resistencias serie arbitrarias. S9 IOZ/Ioff máximo2 µA: con Rmax10.5 kΩ,21mV en B duranteHiZ es inferior al VIN(TH) mínimo1V de BSP75N. ParaA, VIL0.8V permite una fuga total≤76.2 µA con 10.5 kΩ; comprobar GPIO elegido y condiciones reales frente a ese presupuesto. Estas son verificaciones parciales: Ioff con rail exactamente0V no garantiza todos los puntos de una rampa de alimentación ni un pulso de arranque inocuo.

A5V, un pulldownB consume hasta5/9.5k=0.526 mA y Pmax2.63mW por canal; sumado al IINmax1.2 mA delBSP75N carga aproximadamente1.73 mA la salida del traductor. Las dos redesB añaden hasta≈1.05 mA al rail5V; lasA hasta≈0.695 mA al rail3.3V mientras están altas, aparte de otras pérdidas. No son los500 mA de carga: esas corrientes circulan por campo/drain/source.

**Bloqueo eléctrico a resolver:** S10 requiereVIN≥4.5V para protección de sobretemperatura. S9 solo garantizaVOH cercano aVCC con 100 µA; a32 mA/VCC4.5V garantiza3.8V. La carga real≈1.73 mA no permite interpolar un mínimo garantizado de VOH entre esos ensayos. Combinada con V5,min≈4.862V, no está demostradoVIN_BSP≥4.5V en todas las esquinas. No se declara inválido por una curva típica, ni validado por el nombre5V: obtener garantía de funcionamiento a esa carga/temperatura o revisar la etapa de control con evidencia antes de liberar.

SOT223 de BSP75N Diodes tiene**tab=source**, no es el tab de un LDO ni del MOSFET de otro fabricante. A0.5A, RDSonmax25°C0.675Ω produce169mW/canal, sin extrapolar a caliente. Energía inductiva550mJ es ensayo de pulso único condicionado, no licencia para cualquier bobina/frecuencia. FaltaL,ciclo,T,clamp y tiempo de desmagnetización para decidir flyback/TVS adicional; no asignar uno por comodidad. Dos borneras docentes2polos son candidatas para positivo de carga y DRAIN;S al retorno.

## DI — dos canales de un ISO1212

Propuesta explícita**sinking24V Type3**, todavía a adoptar como requisito: RSENSE562Ω1%, RTHR1 kΩ, CIN10 nF≥50V por canal. S11 ec.1 daIL,typ=2.25 mA×562Ω/RSENSE; ec.2/3 danVIH,typ≈10.50V y VIL,typ≈9.35V con 1 kΩ. Son valores típicos calculados, no límitesIEC garantizados. Las tablas de límites incluyen otras condiciones (por ejemploRTHR0); no trasladarlas a1 kΩ sin comprobar.

Usando2.75 mA solo como cota conservadora documentada para revisión de potencia: PSENSE≈4.30mW, PTHR≈7.56mW. No es Ityp ni prueba de umbrales. La potencia continua no determina la resistencia de surge: S11 exige**MELF0.25W** siRTHR limita surge; la 0603docente1 kΩ0.1W no es equivalente. FaltaMPN con curva de pulso/dimensiones, por esoMISSING. Si se requiereType1, la recomendación esRTHR2.5 kΩ y debe revisarse la fila; no universalizar1 kΩ.

CIN se conectaSENSE–FGND después de RTHR; RSENSE entreSENSE–IN. ConRTHR1 kΩ/CIN10 nF, τ aproximada10µs yfc≈15.9 kHz sirven como estimaciónRC, **no como ancho de banda exacto del receptor no lineal**. Fijar ancho mínimo de pulso/debounce antes de cambiarCIN. Un100 nF en VCC1 lógico; el lado de campo no necesita rail24V dedicado alIC. EN definido alto si no se multiplexa; SUB1/SUB2 NC. FGND noGND1; decidir aislamiento de grupo antes de unificar retornos. S11 tabla8-1 respalda ensayos bajo sus componentes/layout, no certifica esta PCB. Capacitor500 pF/2kV aPE solo condicional, sin cortocircuitar barrera con una bornera.

## Recursos CAD, prioridades y trabajo restante

Se reutilizan las fuentes existentes `Professor_shared.SchLib` y `.PcbLib`. El inventario previo registra71 entradas incluyendo plantilla,70 seleccionables y37 footprints; se usa como inventario de candidatos, sin declarar geometría definitiva mediante interpretación binaria. Para usar el patrón0603 del100nF Y5V con un100nF X7R, crear una copia con el nuevo MPN y parámetros, después de cotejar pads. Aplicar el mismo criterio a valores de resistencias inexistentes: priorizar símbolo/patrón0603_res antes de adquirir otro por comodidad.

Unificar únicamente tras homologación:100nF50V X7R en funciones compatibles;10nF100V X7R enDI/PHY; resistencias0603 de diferentes valores con igual geometría, conservando MPN/tolerancia propios. CL10A105 solo donde Ceff y temperatura lo permitan. No unificar VCAP2.2µF con22µF, terminaciones con0.1W, aislamiento con50V, ni CIN con10µF25V. Los1210/2220, inductores, cristal/magnetics y MELF requieren recursos externos o adaptación dimensional fundamentada. No se crearon footprints.

Ya existen modelos externos SS3P6L-M386A y CL10B103KA8WPNC.SchLib/PcbLib, con hashes y procedencia registrados. El primero no se incorpora al front-end pendiente; el segundo no reemplaza CIN_DI≥50V. **No se descargó ni calificó un nuevo CAD binario en esta tarea.** Los PDF/HTML nuevos son evidencia eléctrica.

AltiumAD26 está instalado (`C:/Program Files/Altium/AD26/X2.EXE`), pero Computer Use devolvió **native pipe unavailable** y el host de navegador no estaba disponible. No se pudo abrir ni inspeccionar Altium; no es evidencia de un problema de licencia. Procedimiento manual oficial de [extracción de bibliotecas integradas](https://www.altium.com/documentation/altium-designer/working-with-integrated-libraries):

1. Copiar la IntLib a una carpeta de trabajo, comprobar hash y abrir esa copia: File→Open→Extract. Conservar el original y guardar LibPkg en una carpeta nueva.
2. Comparar las fuentes extraídas oficialmente con los hashes del manifiesto previo. Si difieren, detener homologación y registrar las diferencias; no sobrescribir la extracción previa silenciosamente.
3. Abrir0603_cap/0805_cap/0603_res y sus símbolos. Confirmar pines1/2 contra pads1/2, dimensiones, separación, cobre, máscara, pasta y3D contra los dibujos exactos de fabricante. El nombre del footprint no acredita sus dimensiones.
4. Crear copias de componentes para nuevos MPN conservando únicamente recursos compatibles demostrados; registrar valor, tolerancia, V/P, dieléctrico y fuente. Revisar bornes/header/pulsador con taladro, pin1 y orientación.
5. Obtener CAD oficial/verificado de tamaños ausentes, comprobando primero patrones genéricos existentes. El archivo TI snlr047 no incluye librerías Altium. Crear/adaptar solo si no existe alternativa compatible y hay dibujo dimensional suficiente.
6. Validar los ICs principales faltantes: símbolo completo, tab/EP y cada pin/pad. Hay10 unidades de8tipos principales; la BOM pasiva no resuelve suCAD. Compilar LibPkg y revisar errores de modelos/mapeo antes de captura.

**Puede dibujarse un borrador trazable** de alimentación/reset/BOOT delMCU en modoLDO, desacoplos delPHY, desacoplos/controlesRS485 yCAN, y redType3 deDI. **Ningún subsistema está liberado completo:** falta homologaciónCAD y cerrar relojes, terminaciones y protecciones. DO exige demostrar drive≥4.5V; los bucks requieren Ceff, lazo y variante; la entrada requiere circuito de referencia aplicable y protección coordinada. No comenzar routing.

Estimación de trabajoCAD para una persona con Altium:3–5h homologar patrones docentes y parámetros;4–8h obtener/verificar pasivos externos y conectores;3–5h verificar los8tipos deICs, compilar y cerrar mapeos. **Total10–18h activas**, condicionado a modelos disponibles y decisiones eléctricas cerradas. No incluye ingeniería pendiente, simulación, captura completa, ERC, routing, compras ni ensayos. Los riesgos pueden ampliar el plazo; no es una promesa para el fin de semana.

## Validación de esta entrega

Se validaron IDs únicos, correspondencia1:1 BOM/mapping, estados permitidos, cantidades enteras o pendientes, y exclusión deDNP/auxiliares del recuento pasivo. Ninguna fila usa VERIFIED. La comprobación reproducible y sus límites están en [passive_delivery_validation.json](evidence/passive_delivery_validation.json). Los hashes del maestro y de la IntLib permanecen iguales. No se ejecutaron ERC/DRC, simulación eléctrica ni validación física.

El recuento consideraR/C/L/cristal/fusible. TVS, diodos y conectores permanecen como AUXILIARY para conservar sus tareas sin mezclarlos con el total pasivo. Se ejecutaron `git diff --stat`, `git diff --check` y `git status`. Los archivos nuevos sin seguimiento no aparecen en el diff ordinario: se revisaron explícitamente y se comprobaron también espacios finales, codificación y estructura.

## Tablas BOM por subsistema

Las tablas se generan desde el mismo origen que elCSV. BLOCKED enCAD impide interpretar CALCULATED eléctrico como homologación integral. MISSING identifica un dato/MPN/modelo faltante; PROVISIONAL requiere comprobaciones; VERIFIED se reserva al cierre eléctrico y dimensional completo.

<!-- GENERATED_BOM_TABLES -->

### BOM MCU

| ID | Subsistema | Funcion | Referencia principal (fabricante) | Valor nominal | Tolerancia | Tension/corriente nominal | Potencia | Encapsulado | MPN recomendado/candidato | Simbolo candidato | Footprint candidato | Origen CAD | Fuente valor electrico | Estado global | Observaciones | Cantidad | Montaje | Estado electrico | Estado CAD |
|---|---|---|---|---|---|---|---|---|---|---|---|---|---|---|---|---|---|---|---|
| MCU_CVDD1 | MCU | Desacoplo VDD pin 11 | STM32H723VET6 | 100 nF | 10% | 50 V; X7R; -55..125 C | N/A | 0603 | C0603C104K5RACTU | GW_C0603C104K5RACTU_dc5e12a5 | GW_CAND_0603_cap | hardware/academic_rev1/libraries/Gateway_Academic.SchLib + Gateway_Academic.PcbLib | S1 fig5/tabla7; S2 tabla2 p7 | PROVISIONAL | Ficha KEMET local p1. Adaptar parametros; no usar el Y5V 0603F104Z500CT como equivalente. Modelo candidato existente; sin cotejo visual de pads/pines en Altium. | 1 | REQUIRED | PROVISIONAL | CAD_CANDIDATE |
| MCU_CVDD2 | MCU | Desacoplo VDD pin 27 | STM32H723VET6 | 100 nF | 10% | 50 V; X7R; -55..125 C | N/A | 0603 | C0603C104K5RACTU | GW_C0603C104K5RACTU_dc5e12a5 | GW_CAND_0603_cap | hardware/academic_rev1/libraries/Gateway_Academic.SchLib + Gateway_Academic.PcbLib | S1 fig5/tabla7; S2 tabla2 p7 | PROVISIONAL | Ficha KEMET local p1. Adaptar parametros; no usar el Y5V 0603F104Z500CT como equivalente. Modelo candidato existente; sin cotejo visual de pads/pines en Altium. | 1 | REQUIRED | PROVISIONAL | CAD_CANDIDATE |
| MCU_CVDD3 | MCU | Desacoplo VDD pin 50 | STM32H723VET6 | 100 nF | 10% | 50 V; X7R; -55..125 C | N/A | 0603 | C0603C104K5RACTU | GW_C0603C104K5RACTU_dc5e12a5 | GW_CAND_0603_cap | hardware/academic_rev1/libraries/Gateway_Academic.SchLib + Gateway_Academic.PcbLib | S1 fig5/tabla7; S2 tabla2 p7 | PROVISIONAL | Ficha KEMET local p1. Adaptar parametros; no usar el Y5V 0603F104Z500CT como equivalente. Modelo candidato existente; sin cotejo visual de pads/pines en Altium. | 1 | REQUIRED | PROVISIONAL | CAD_CANDIDATE |
| MCU_CVDD4 | MCU | Desacoplo VDD pin 75 | STM32H723VET6 | 100 nF | 10% | 50 V; X7R; -55..125 C | N/A | 0603 | C0603C104K5RACTU | GW_C0603C104K5RACTU_dc5e12a5 | GW_CAND_0603_cap | hardware/academic_rev1/libraries/Gateway_Academic.SchLib + Gateway_Academic.PcbLib | S1 fig5/tabla7; S2 tabla2 p7 | PROVISIONAL | Ficha KEMET local p1. Adaptar parametros; no usar el Y5V 0603F104Z500CT como equivalente. Modelo candidato existente; sin cotejo visual de pads/pines en Altium. | 1 | REQUIRED | PROVISIONAL | CAD_CANDIDATE |
| MCU_CVDD5 | MCU | Desacoplo VDD pin 100 | STM32H723VET6 | 100 nF | 10% | 50 V; X7R; -55..125 C | N/A | 0603 | C0603C104K5RACTU | GW_C0603C104K5RACTU_dc5e12a5 | GW_CAND_0603_cap | hardware/academic_rev1/libraries/Gateway_Academic.SchLib + Gateway_Academic.PcbLib | S1 fig5/tabla7; S2 tabla2 p7 | PROVISIONAL | Ficha KEMET local p1. Adaptar parametros; no usar el Y5V 0603F104Z500CT como equivalente. Modelo candidato existente; sin cotejo visual de pads/pines en Altium. | 1 | REQUIRED | PROVISIONAL | CAD_CANDIDATE |
| MCU_CBULK | MCU | Reserva VDD | STM32H723VET6 | 4.7 uF | 10% | 16 V; X7R | N/A | 0805 | C0805C475K4RACTU | GW_C0805C475K4RACTU_82374e08 | GW_CAND_0805_cap | hardware/academic_rev1/libraries/Gateway_Academic.SchLib + Gateway_Academic.PcbLib | S2 tabla2 p7; P3 ficha KEMET p1 | PROVISIONAL | Ceff a 3.3 V pendiente; no sustituir por 10 uF solo por disponibilidad. Modelo candidato existente; sin cotejo visual de pads/pines en Altium. | 1 | REQUIRED | PROVISIONAL | CAD_CANDIDATE |
| MCU_CVDDA1 | MCU | VDDA pin 21; reserva | STM32H723VET6 | 1 uF | 10% | 50 V; X5R; -55..85 C | N/A | 0603 | CL10A105KB8NNNC | GW_CL10A105KB8NNNC_c3932faa | GW_CAND_0603_cap | hardware/academic_rev1/libraries/Gateway_Academic.SchLib + Gateway_Academic.PcbLib | S1 fig5; S2 tabla2 pp7-8 | PROVISIONAL | Samsung ficha oficial; Ceff/ESR pendientes por aplicacion. Limite X5R 85 C: no homologado para ambiente superior. Modelo candidato existente; sin cotejo visual de pads/pines en Altium. | 1 | REQUIRED | PROVISIONAL | CAD_CANDIDATE |
| MCU_CVDDA2 | MCU | VDDA pin 21; HF | STM32H723VET6 | 100 nF | 10% | 50 V; X7R; -55..125 C | N/A | 0603 | C0603C104K5RACTU | GW_C0603C104K5RACTU_dc5e12a5 | GW_CAND_0603_cap | hardware/academic_rev1/libraries/Gateway_Academic.SchLib + Gateway_Academic.PcbLib | S1 fig5; S2 tabla2 pp7-8 | PROVISIONAL | Ficha KEMET local p1. Adaptar parametros; no usar el Y5V 0603F104Z500CT como equivalente. Modelo candidato existente; sin cotejo visual de pads/pines en Altium. | 1 | REQUIRED | PROVISIONAL | CAD_CANDIDATE |
| MCU_CVBAT1 | MCU | VBAT pin 6; reserva | STM32H723VET6 | 1 uF | 10% | 50 V; X5R; -55..85 C | N/A | 0603 | CL10A105KB8NNNC | GW_CL10A105KB8NNNC_c3932faa | GW_CAND_0603_cap | hardware/academic_rev1/libraries/Gateway_Academic.SchLib + Gateway_Academic.PcbLib | S1 fig5; S2 tabla2 pp7-8 | PROVISIONAL | Samsung ficha oficial; Ceff/ESR pendientes por aplicacion. Limite X5R 85 C: no homologado para ambiente superior. Modelo candidato existente; sin cotejo visual de pads/pines en Altium. | 1 | REQUIRED | PROVISIONAL | CAD_CANDIDATE |
| MCU_CVBAT2 | MCU | VBAT pin 6; HF | STM32H723VET6 | 100 nF | 10% | 50 V; X7R; -55..125 C | N/A | 0603 | C0603C104K5RACTU | GW_C0603C104K5RACTU_dc5e12a5 | GW_CAND_0603_cap | hardware/academic_rev1/libraries/Gateway_Academic.SchLib + Gateway_Academic.PcbLib | S1 fig5; S2 tabla2 pp7-8 | PROVISIONAL | Ficha KEMET local p1. Adaptar parametros; no usar el Y5V 0603F104Z500CT como equivalente. Modelo candidato existente; sin cotejo visual de pads/pines en Altium. | 1 | REQUIRED | PROVISIONAL | CAD_CANDIDATE |
| MCU_CVREF1 | MCU | VREF pin 20; reserva | STM32H723VET6 | 1 uF | 10% | 50 V; X5R; -55..85 C | N/A | 0603 | CL10A105KB8NNNC | GW_CL10A105KB8NNNC_c3932faa | GW_CAND_0603_cap | hardware/academic_rev1/libraries/Gateway_Academic.SchLib + Gateway_Academic.PcbLib | S1 fig5; S2 tabla2 pp7-8 | PROVISIONAL | Samsung ficha oficial; Ceff/ESR pendientes por aplicacion. Limite X5R 85 C: no homologado para ambiente superior. Modelo candidato existente; sin cotejo visual de pads/pines en Altium. | 1 | REQUIRED | PROVISIONAL | CAD_CANDIDATE |
| MCU_CVREF2 | MCU | VREF pin 20; HF | STM32H723VET6 | 100 nF | 10% | 50 V; X7R; -55..125 C | N/A | 0603 | C0603C104K5RACTU | GW_C0603C104K5RACTU_dc5e12a5 | GW_CAND_0603_cap | hardware/academic_rev1/libraries/Gateway_Academic.SchLib + Gateway_Academic.PcbLib | S1 fig5; S2 tabla2 pp7-8 | PROVISIONAL | Ficha KEMET local p1. Adaptar parametros; no usar el Y5V 0603F104Z500CT como equivalente. Modelo candidato existente; sin cotejo visual de pads/pines en Altium. | 1 | REQUIRED | PROVISIONAL | CAD_CANDIDATE |
| MCU_CVCAP1 | MCU | Salida LDO VCAP pin 48 | STM32H723VET6 | 2.2 uF | 10% candidato; ST permite 20% | 10 V; X7R; ESR <100 mOhm | N/A | 0603 | C0603C225K8RACTU | GW_C0603C225K8RACTU_46503424 | GW_CAND_0603_cap | hardware/academic_rev1/libraries/Gateway_Academic.SchLib + Gateway_Academic.PcbLib | S1 tabla14 p92; P2 ficha KEMET p1 | PROVISIONAL | Falta ESR y capacitancia bajo VCORE/temperatura/envejecimiento. No conectar 3.3 V ni carga externa a VCAP. Modelo candidato existente; sin cotejo visual de pads/pines en Altium. | 1 | REQUIRED | PROVISIONAL | CAD_CANDIDATE |
| MCU_CVCAP2 | MCU | Salida LDO VCAP pin 73 | STM32H723VET6 | 2.2 uF | 10% candidato; ST permite 20% | 10 V; X7R; ESR <100 mOhm | N/A | 0603 | C0603C225K8RACTU | GW_C0603C225K8RACTU_46503424 | GW_CAND_0603_cap | hardware/academic_rev1/libraries/Gateway_Academic.SchLib + Gateway_Academic.PcbLib | S1 tabla14 p92; P2 ficha KEMET p1 | PROVISIONAL | Falta ESR y capacitancia bajo VCORE/temperatura/envejecimiento. No conectar 3.3 V ni carga externa a VCAP. Modelo candidato existente; sin cotejo visual de pads/pines en Altium. | 1 | REQUIRED | PROVISIONAL | CAD_CANDIDATE |
| MCU_CNRST | MCU | NRST pin14 a GND | STM32H723VET6 | 100 nF | 10% | 50 V; X7R; -55..125 C | N/A | 0603 | C0603C104K5RACTU | GW_C0603C104K5RACTU_dc5e12a5 | GW_CAND_0603_cap | hardware/academic_rev1/libraries/Gateway_Academic.SchLib + Gateway_Academic.PcbLib | S1 fig18 p135 (0.1 uF) | PROVISIONAL | Ficha KEMET local p1. Adaptar parametros; no usar el Y5V 0603F104Z500CT como equivalente. Modelo candidato existente; sin cotejo visual de pads/pines en Altium. | 1 | REQUIRED | PROVISIONAL | CAD_CANDIDATE |
| MCU_RBOOT | MCU | BOOT0 pin94 a GND | STM32H723VET6 | 10 kOhm | 5% | >= 3.3 V; tension de trabajo por verificar | 0.1 W | 0603 | FRC0603J103TS | GW_FRC0603J103TS_7289f91d | GW_CAND_0603_res | hardware/academic_rev1/libraries/Gateway_Academic.SchLib + Gateway_Academic.PcbLib | S2 seccion5.2 fig19 p30: 10 kOhm ejemplo tipico | PROVISIONAL | Ratings transcritos del CAD; falta ficha FOJAN. Alternativa RC0603FR-0710KL con ficha oficial local, mismo footprint candidato. Modelo candidato existente; sin cotejo visual de pads/pines en Altium. | 1 | REQUIRED | PROVISIONAL | CAD_CANDIDATE |
| MCU_YHSE | MCU | Referencia precisa HSE si HSI no satisface FDCAN | STM32H723VET6 | TBD | TBD | TBD | N/A | TBD | TBD | MISSING | MISSING | MISSING | S1 seccion6.3 osciladores; S2 seccion3; ST AN2867 | BLOCKED | Frecuencia/MPN/CL/ESR/drive y margen de arranque no cerrados. HSI permite minimo MCU; no valida temporizacion CAN-FD. | TBD | TBD | ELECTRICAL_BLOCKED | CAD_BLOCKED |
| MCU_CHSE | MCU | Capacitores de carga HSE | STM32H723VET6 | TBD | TBD | TBD | N/A | TBD | TBD | MISSING | MISSING | MISSING | S2 seccion3; ST AN2867 | BLOCKED | Solo si se adopta cristal: CL=(C1*C2)/(C1+C2)+Cstray. No fijar 22/33 pF sin CL/parasiticos. | TBD | TBD | ELECTRICAL_BLOCKED | CAD_BLOCKED |
| MCU_RHSE | MCU | Limitacion drive oscilador HSE si necesaria | STM32H723VET6 | TBD | TBD | TBD | N/A | TBD | TBD | MISSING | MISSING | MISSING | ST AN2867; S1 osciladores | BLOCKED | Solo tras cristal y drive level; no es resistencia obligatoria universal. | TBD | TBD | ELECTRICAL_BLOCKED | CAD_BLOCKED |
| MCU_LSE | MCU | Red LSE RTC | STM32H723VET6 | TBD | TBD | TBD | N/A | TBD | TBD | MISSING | MISSING | MISSING | S2 seccion3 | PROVISIONAL | Sin requisito RTC preciso en alcance reducido; no incorporar cristal ni dos cargas por defecto. | 0 | DNP | PROVISIONAL | CAD_BLOCKED |
| MCU_JSWD | MCU | SWD | STM32H723VET6 | 6 posiciones | TBD | TBD | N/A | TBD | TBD | GW_H_Male_6x1_TH_100mil_c0450d1e | GW_CAND_H_6x1_TH_100mil | hardware/academic_rev1/libraries/Gateway_Academic.SchLib + Gateway_Academic.PcbLib | S2 seccion6; propuesta pinout pendiente | BLOCKED | Pinout, MPN y orientacion pendientes. No alimentar VDD desde VTref; SWD PA13/PA14 y NRST. Modelo candidato existente; sin cotejo visual de pads/pines en Altium. | 1 | REQUIRED | ELECTRICAL_BLOCKED | CAD_CANDIDATE |
| MCU_SRESET | MCU | Pulsador reset | STM32H723VET6 | SPST-NO | TBD | TBD | N/A | TBD | TBD | GW_Sw_PUSH_4.5x4.5x5.0xmm_0f078dd9 | MISSING | hardware/academic_rev1/libraries/Gateway_Academic.SchLib + Gateway_Academic.PcbLib | S2 seccion6; propuesta pinout pendiente | BLOCKED | Pinout, MPN y orientacion pendientes. No alimentar VDD desde VTref; SWD PA13/PA14 y NRST. Modelo candidato existente; sin cotejo visual de pads/pines en Altium. | 1 | REQUIRED | ELECTRICAL_BLOCKED | CAD_BLOCKED |
| MCU_JBOOT | MCU | Recuperacion BOOT | STM32H723VET6 | 2 posiciones | TBD | TBD | N/A | TBD | TBD | GW_H_Male_2x1_TH_100mil_f89d9046 | GW_CAND_H_2x1_TH_100mil | hardware/academic_rev1/libraries/Gateway_Academic.SchLib + Gateway_Academic.PcbLib | S2 seccion6; propuesta pinout pendiente | BLOCKED | Pinout, MPN y orientacion pendientes. No alimentar VDD desde VTref; SWD PA13/PA14 y NRST. Modelo candidato existente; sin cotejo visual de pads/pines en Altium. | 1 | REQUIRED | ELECTRICAL_BLOCKED | CAD_CANDIDATE |

### BOM Ethernet

| ID | Subsistema | Funcion | Referencia principal (fabricante) | Valor nominal | Tolerancia | Tension/corriente nominal | Potencia | Encapsulado | MPN recomendado/candidato | Simbolo candidato | Footprint candidato | Origen CAD | Fuente valor electrico | Estado global | Observaciones | Cantidad | Montaje | Estado electrico | Estado CAD |
|---|---|---|---|---|---|---|---|---|---|---|---|---|---|---|---|---|---|---|---|
| ETH_CVDDA3V3_HF | Ethernet | VDDA3V3 HF | DP83826IRHBR | 100 nF | 10% | 50 V; X7R; -55..125 C | N/A | 0603 | C0603C104K5RACTU | GW_C0603C104K5RACTU_dc5e12a5 | GW_CAND_0603_cap | hardware/academic_rev1/libraries/Gateway_Academic.SchLib + Gateway_Academic.PcbLib | S3 fig9-6 p99 | PROVISIONAL | Ficha KEMET local p1. Adaptar parametros; no usar el Y5V 0603F104Z500CT como equivalente. Modelo candidato existente; sin cotejo visual de pads/pines en Altium. | 1 | REQUIRED | PROVISIONAL | CAD_CANDIDATE |
| ETH_CVDDA3V3_10N | Ethernet | VDDA3V3 HF | DP83826IRHBR | 10 nF | 10% | 100 V; X7R; -55..125 C | N/A | 0603 | C0603C103K1RACTU | GW_C0603C103K1RACTU_97f3ee33 | GW_CAND_0603_cap | hardware/academic_rev1/libraries/Gateway_Academic.SchLib + Gateway_Academic.PcbLib | S3 fig9-6 p99 | PROVISIONAL | Ficha KEMET local DI_CIN p1; no confundir con externo CL10B103KA8WPNC 25 V. Modelo candidato existente; sin cotejo visual de pads/pines en Altium. | 1 | REQUIRED | PROVISIONAL | CAD_CANDIDATE |
| ETH_CVDDA3V3_1U | Ethernet | VDDA3V3 reserva | DP83826IRHBR | 1 uF | 10% | 50 V; X5R; -55..85 C | N/A | 0603 | CL10A105KB8NNNC | GW_CL10A105KB8NNNC_c3932faa | GW_CAND_0603_cap | hardware/academic_rev1/libraries/Gateway_Academic.SchLib + Gateway_Academic.PcbLib | S3 fig9-6 p99 | PROVISIONAL | Samsung ficha oficial; Ceff/ESR pendientes por aplicacion. Limite X5R 85 C: no homologado para ambiente superior. Modelo candidato existente; sin cotejo visual de pads/pines en Altium. | 1 | REQUIRED | PROVISIONAL | CAD_CANDIDATE |
| ETH_CVDDA3V3_10U | Ethernet | VDDA3V3 reserva | DP83826IRHBR | 10 uF | 10% | 25 V; X5R; -55..85 C | N/A | 0805 | CL21A106KAYNNNE | GW_CL21A106KAYNNNE_c6e24382 | GW_CAND_0805_cap | hardware/academic_rev1/libraries/Gateway_Academic.SchLib + Gateway_Academic.PcbLib | S3 fig9-6 p99; Samsung ficha oficial | PROVISIONAL | Ceff a 3.3 V y temperatura pendientes. No usar para entrada 30 V. Modelo candidato existente; sin cotejo visual de pads/pines en Altium. | 1 | REQUIRED | PROVISIONAL | CAD_CANDIDATE |
| ETH_CVDDIO_HF | Ethernet | VDDIO HF | DP83826IRHBR | 100 nF | 10% | 50 V; X7R; -55..125 C | N/A | 0603 | C0603C104K5RACTU | GW_C0603C104K5RACTU_dc5e12a5 | GW_CAND_0603_cap | hardware/academic_rev1/libraries/Gateway_Academic.SchLib + Gateway_Academic.PcbLib | S3 fig9-6 p99 | PROVISIONAL | Ficha KEMET local p1. Adaptar parametros; no usar el Y5V 0603F104Z500CT como equivalente. Modelo candidato existente; sin cotejo visual de pads/pines en Altium. | 1 | REQUIRED | PROVISIONAL | CAD_CANDIDATE |
| ETH_CVDDIO_10N | Ethernet | VDDIO HF | DP83826IRHBR | 10 nF | 10% | 100 V; X7R; -55..125 C | N/A | 0603 | C0603C103K1RACTU | GW_C0603C103K1RACTU_97f3ee33 | GW_CAND_0603_cap | hardware/academic_rev1/libraries/Gateway_Academic.SchLib + Gateway_Academic.PcbLib | S3 fig9-6 p99 | PROVISIONAL | Ficha KEMET local DI_CIN p1; no confundir con externo CL10B103KA8WPNC 25 V. Modelo candidato existente; sin cotejo visual de pads/pines en Altium. | 1 | REQUIRED | PROVISIONAL | CAD_CANDIDATE |
| ETH_CVDDIO_1U | Ethernet | VDDIO reserva | DP83826IRHBR | 1 uF | 10% | 50 V; X5R; -55..85 C | N/A | 0603 | CL10A105KB8NNNC | GW_CL10A105KB8NNNC_c3932faa | GW_CAND_0603_cap | hardware/academic_rev1/libraries/Gateway_Academic.SchLib + Gateway_Academic.PcbLib | S3 fig9-6 p99 | PROVISIONAL | Samsung ficha oficial; Ceff/ESR pendientes por aplicacion. Limite X5R 85 C: no homologado para ambiente superior. Modelo candidato existente; sin cotejo visual de pads/pines en Altium. | 1 | REQUIRED | PROVISIONAL | CAD_CANDIDATE |
| ETH_CVDDIO_10U | Ethernet | VDDIO reserva | DP83826IRHBR | 10 uF | 10% | 25 V; X5R; -55..85 C | N/A | 0805 | CL21A106KAYNNNE | GW_CL21A106KAYNNNE_c6e24382 | GW_CAND_0805_cap | hardware/academic_rev1/libraries/Gateway_Academic.SchLib + Gateway_Academic.PcbLib | S3 fig9-6 p99; Samsung ficha oficial | PROVISIONAL | Ceff a 3.3 V y temperatura pendientes. No usar para entrada 30 V. Modelo candidato existente; sin cotejo visual de pads/pines en Altium. | 1 | REQUIRED | PROVISIONAL | CAD_CANDIDATE |
| ETH_CEXT | Ethernet | CEXT pin2 a GND | DP83826IRHBR | 2 nF | 5% seleccion | 50 V; C0G | N/A | 0603 | C0603C202J5GACTU | GW_C0603C202J5GACTU_fa733a70 | GW_CAND_0603_cap | hardware/academic_rev1/libraries/Gateway_Academic.SchLib + Gateway_Academic.PcbLib | S3 tabla5-1 p5; P4 ficha KEMET p1 | PROVISIONAL | Conflicto EVM C57=100 nF; prevalece requisito actual 2 nF, no copiar C57. Modelo candidato existente; sin cotejo visual de pads/pines en Altium. | 1 | REQUIRED | PROVISIONAL | CAD_CANDIDATE |
| ETH_RBIAS | Ethernet | RBIAS pin10 a GND | DP83826IRHBR | 6.49 kOhm | 1% | 75 V max; limite sqrt(P*R) | 0.1 W @70 C | 0603 | RC0603FR-076K49L | GW_RC0603FR-076K49L_f42a9329 | GW_CAND_0603_res | hardware/academic_rev1/libraries/Gateway_Academic.SchLib + Gateway_Academic.PcbLib | S3 tabla5-1; P5 ficha Yageo p1 | PROVISIONAL | P<3.3^2/6490=1.68 mW; actualizacion de valor/MPN sobre simbolo generico pendiente. Modelo candidato existente; sin cotejo visual de pads/pines en Altium. | 1 | REQUIRED | PROVISIONAL | CAD_CANDIDATE |
| ETH_RRMII | Ethernet | RX_D2 strap8 pull-up a VDDIO | DP83826IRHBR | 2.49 kOhm | 1% | 75 V max; limite sqrt(P*R) | 0.1 W @70 C | 0603 | RC0603FR-072K49L | GW_RC0603FR-072K49L_b905c5f0 | GW_CAND_0603_res | hardware/academic_rev1/libraries/Gateway_Academic.SchLib + Gateway_Academic.PcbLib | S3 tablas8-6/8-7 fig8-13 pp48-49 | PROVISIONAL | Candidato ENHANCED/RMII leader: ModeSelect NC, strap1=1 default, strap8=1, strap5=0 default. Ver tabla del informe; sin LEDs de straps. Modelo candidato existente; sin cotejo visual de pads/pines en Altium. | 1 | REQUIRED | PROVISIONAL | CAD_CANDIDATE |
| ETH_Y25 | Ethernet | Cristal PHY 25 MHz | DP83826IRHBR | 25 MHz | TOTAL <=50 ppm | CL 15..40 pF; ESR <=50 Ohm | N/A | TBD | TBD | MISSING | MISSING | MISSING | S3 tabla9-2 p97; EVM XTAL1 tabla7-1 | BLOCKED | EVM ECS-250-12-33Q-JES-TR (CL12 pF) no demuestra tabla9-2 actual. Seleccion exacta y drive pendientes; no hay cristal docente. | 1 | REQUIRED | ELECTRICAL_BLOCKED | CAD_BLOCKED |
| ETH_CXTAL | Ethernet | Cargas del cristal PHY | DP83826IRHBR | TBD segun CL y Cstray | C0G <=5% | >= VDDIO | N/A | 0603 candidato | TBD | MISSING | MISSING | MISSING | S3 fig9-4; tabla9-2; EVM C43/C44=22 pF | BLOCKED | 33 pF docente solo candidato mecanico; no valor aprobado. Cargas EVM 22 pF no universales. Modelo candidato existente; sin cotejo visual de pads/pines en Altium. | 2 | REQUIRED | ELECTRICAL_BLOCKED | CAD_BLOCKED |
| ETH_RXTAL | Ethernet | R1 de oscilador si requerido | DP83826IRHBR | TBD | TBD | TBD | N/A | TBD | TBD | MISSING | MISSING | MISSING | S3 fig9-4; recomendaciones fabricante cristal | BLOCKED | TBD | TBD | TBD | ELECTRICAL_BLOCKED | CAD_BLOCKED |
| ETH_FB | Ethernet | Ferritas de alimentacion opcionales | DP83826IRHBR | 60 Ohm @100 MHz candidato | 25% | 2 A; DCR 100 mOhm segun CAD | N/A | 0603 | HCB1608KF-600T20 | GW_HCB1608KF-600T20_c68e3ad6 | GW_CAND_0603_fb | hardware/academic_rev1/libraries/Gateway_Academic.SchLib + Gateway_Academic.PcbLib | S3 fig9-6: opcional | PROVISIONAL | No exigir filtro adicional sin EMC; verificar curva de impedancia y resonancia con banco local si se monta. Modelo candidato existente; sin cotejo visual de pads/pines en Altium. | 0 | DNP | PROVISIONAL | CAD_CANDIDATE |
| ETH_TMAG | Ethernet | Magnetics aislados | DP83826IRHBR | 1:1; 350 uH candidato | Relacion +/-2% | HPOT >=1500 Vrms; limites tabla9-1 | N/A | 12.7x9.09 mm segun EVM | HX1188FNLT | MISSING | MISSING | MISSING | S3 tabla9-1; S4 T2 y BOM p28 | BLOCKED | Candidato oficial EVM; falta ficha exacta Pulse/pinout/land pattern. No confundir inductor de buck. | 1 | REQUIRED | ELECTRICAL_BLOCKED | CAD_BLOCKED |
| ETH_CCT | Ethernet | Derivacion center taps lado PHY | DP83826IRHBR | 2 nF | TBD | TBD | N/A | TBD | TBD | MISSING | MISSING | MISSING | S3 fig9-2 p95 | BLOCKED | No copiar 4x100 nF EVM sin revisar red HX1188; coordenar con magnetics y jack. | 2 | REQUIRED | ELECTRICAL_BLOCKED | CAD_BLOCKED |
| ETH_RBOB | Ethernet | Terminacion lado cable | DP83826IRHBR | 75 Ohm | 1% objetivo | TBD | >=0.125 W candidato EVM | TBD | TBD | MISSING | MISSING | MISSING | S3 fig9-2: dos; S4 R43..46: cuatro | BLOCKED | Cantidad depende de pares usados/no usados y circuito interno RJ45; no sumar ambas redes. | TBD | REQUIRED | ELECTRICAL_BLOCKED | CAD_BLOCKED |
| ETH_CBOB | Ethernet | Acoplo terminacion a chasis | DP83826IRHBR | TBD | TBD | Aislamiento por definir; EVM 2 kV | N/A | TBD | TBD | MISSING | MISSING | MISSING | S3 fig9-2 10 nF; S4 C58/C59=1 nF/2 kV | BLOCKED | Topologias diferentes: resolver al seleccionar jack/magnetics. | TBD | REQUIRED | ELECTRICAL_BLOCKED | CAD_BLOCKED |
| ETH_CCHASSIS | Ethernet | Acoplo chasis/GND | DP83826IRHBR | 4.7 nF candidato EVM | TBD | 2 kV candidato; seguridad por revisar | N/A | 1812 EVM; >=1206 segun S3 | 1812GC472KAT1A | MISSING | MISSING | MISSING | S3 seccion9.2.5.3; S4 C61 BOM p22 | BLOCKED | MPN AVX transcrito EVM; ficha dimensional/seguridad pendiente. No usar0603 de50V. Aprobar politica PE/chasis. | 1 | CONDITIONAL | ELECTRICAL_BLOCKED | CAD_BLOCKED |
| ETH_RCHASSIS | Ethernet | Descarga chasis/GND | DP83826IRHBR | 1 MOhm candidato EVM | TBD | TBD aislamiento | N/A | TBD | TBD | MISSING | MISSING | MISSING | S4 R51 fig6-2 | BLOCKED | No aprobar puente resistivo de aislamiento sin politica de chasis. | 1 | CONDITIONAL | ELECTRICAL_BLOCKED | CAD_BLOCKED |
| ETH_JRJ45 | Ethernet | Jack RJ45 blindado separado de magnetics | DP83826IRHBR | 8P8C shielded | TBD | TBD | N/A | TBD | SS-7188S-A-NF candidato EVM | MISSING | MISSING | MISSING | S4 J17 BOM p25; S3 tabla9-1 | BLOCKED | Cotejar circuito interno, pinout, blindaje, HPOT y footprint con ficha del MPN; no coincidencia geometrica solamente. | 1 | REQUIRED | ELECTRICAL_BLOCKED | CAD_BLOCKED |
| ETH_DESD | Ethernet | Proteccion cuatro lineas MDI | DP83826IRHBR | 4 canales baja C | TBD | TBD | N/A | DQA USON10 | TPD4E05U06DQAR | MISSING | MISSING | MISSING | S4 U13 fig6-2 y BOM p29 | BLOCKED | Ficha TI, capacitancia, clamp y retorno pendientes; no sustituir por USBLC6 por footprint. | 1 | REQUIRED | ELECTRICAL_BLOCKED | CAD_BLOCKED |
| ETH_RESET | Ethernet | Reset temporizado desde MCU | DP83826IRHBR | TBD | TBD | TBD | N/A | TBD | TBD | MISSING | MISSING | MISSING | S3 reset timing seccion7; pines RST_N | PROVISIONAL | Sin RC arbitrario. Usar GPIO/supervisor tras definir secuencia y tiempos de strap; no compartir a ciegas NRST MCU. | 0 | DNP | PROVISIONAL | CAD_BLOCKED |
| ETH_RMDIO | Ethernet | Pull-up MDIO adicional | DP83826IRHBR | TBD | TBD | TBD | N/A | TBD | TBD | MISSING | MISSING | MISSING | S3 tabla5-1: PU interno | PROVISIONAL | No duplicar por defecto. Dimensionar solo tras verificar subida a MDC real, capacitancia y pull-up interno. | 0 | DNP | PROVISIONAL | CAD_BLOCKED |

### BOM Buck3V3

| ID | Subsistema | Funcion | Referencia principal (fabricante) | Valor nominal | Tolerancia | Tension/corriente nominal | Potencia | Encapsulado | MPN recomendado/candidato | Simbolo candidato | Footprint candidato | Origen CAD | Fuente valor electrico | Estado global | Observaciones | Cantidad | Montaje | Estado electrico | Estado CAD |
|---|---|---|---|---|---|---|---|---|---|---|---|---|---|---|---|---|---|---|---|
| B3_L | Buck3V3 | Inductor buck | LMR36015FBRNXR (propuesto) | 6.8 uH | 20% | Isat25C 3.6 A; Irms20C 3.0 A | N/A | XAL4030 | XAL4030-682MEC | GW_XAL4030-682MEC_71dfd711 | MISSING | hardware/academic_rev1/libraries/Gateway_Academic.SchLib + Gateway_Academic.PcbLib | S5 tabla10-1; ecuaciones4-5; P6 tabla806-1 | CALCULATED | DCRmax25C 74.1 mOhm. Isat es caida30% tipica; falta derating caliente/curva L(I)/perdidas nucleo y CAD. No usar inductor docente sin Isat verificable. | 1 | REQUIRED | DERIVED_PENDING_REVIEW | CAD_BLOCKED |
| B3_CIN | Buck3V3 | Banco ceramico entrada | LMR36015FBRNXR (propuesto) | 4.7 uF por unidad; Ceff total >=4.7 uF objetivo conservador | 10% | 100 V; X7R | N/A | 2220 | C5750X7R2A475K230KA | GW_C5750X7R2A475K230KA_5f18f946 | MISSING | hardware/academic_rev1/libraries/Gateway_Academic.SchLib + Gateway_Academic.PcbLib | S5 seccion10.2.1.2.6; P7 TDK ficha oficial | BLOCKED | No fijar cantidad hasta curva bias a30 V+tolerancia+temperatura. 4.7 nominal no garantiza 4.7 efectivo. Carga RMS objetivo >= 0.35 A banco; 2220 no presente profesor. | TBD | REQUIRED | ELECTRICAL_BLOCKED | CAD_BLOCKED |
| B3_CHF | Buck3V3 | Bypass de cada par VIN-PGND | LMR36015FBRNXR (propuesto) | 220 nF | 10% | 100 V; X7R | N/A | 0805 | C0805C224K1RACTU | GW_C0805C224K1RACTU_e16e52b8 | GW_CAND_0805_cap | hardware/academic_rev1/libraries/Gateway_Academic.SchLib + Gateway_Academic.PcbLib | S5 seccion10.2.1.2.6 p23; ficha KEMET local p1 | PROVISIONAL | Uno por par VIN-PGND en lados opuestos; falta Ceff y cotejo dimensiones pads. Modelo candidato existente; sin cotejo visual de pads/pines en Altium. | 2 | REQUIRED | PROVISIONAL | CAD_CANDIDATE |
| B3_COUT | Buck3V3 | Banco salida | LMR36015FBRNXR (propuesto) | 15 uF por unidad; 45 uF nominal banco | 20% | 16 V; X7R | N/A | 1210 | C3225X7R1C156M250AB | GW_C3225X7R1C156M250AB_bb412b42 | MISSING | hardware/academic_rev1/libraries/Gateway_Academic.SchLib + Gateway_Academic.PcbLib | S5 tabla10-1: 3x15 uF nominal; P8 TDK ficha oficial | BLOCKED | Ceff a 3.3 V, ESR, escalon de carga y Bode pendientes. No atribuir 45 uF efectivos ni ESR3.04mOhm del modelo AR. Sin footprint1210 docente. | 3 | REQUIRED | ELECTRICAL_BLOCKED | CAD_BLOCKED |
| B3_CBOOT | Buck3V3 | BOOT a SW | LMR36015FBRNXR (propuesto) | 100 nF | 10% | 50 V; X7R; -55..125 C | N/A | 0603 | C0603C104K5RACTU | GW_C0603C104K5RACTU_dc5e12a5 | GW_CAND_0603_cap | hardware/academic_rev1/libraries/Gateway_Academic.SchLib + Gateway_Academic.PcbLib | S5 seccion10.2.1.2.7:100nF >=16V | PROVISIONAL | Ficha KEMET local p1. Adaptar parametros; no usar el Y5V 0603F104Z500CT como equivalente. Modelo candidato existente; sin cotejo visual de pads/pines en Altium. | 1 | REQUIRED | PROVISIONAL | CAD_CANDIDATE |
| B3_CVCC | Buck3V3 | VCC interno a GND | LMR36015FBRNXR (propuesto) | 1 uF | 10% | 50 V; X5R; -55..85 C | N/A | 0603 | CL10A105KB8NNNC | GW_CL10A105KB8NNNC_c3932faa | GW_CAND_0603_cap | hardware/academic_rev1/libraries/Gateway_Academic.SchLib + Gateway_Academic.PcbLib | S5 seccion10.2.1.2.8:1uF >=16V | BLOCKED | Samsung ficha oficial; Ceff/ESR pendientes por aplicacion. Limite X5R 85 C: no homologado para ambiente superior. Modelo candidato existente; sin cotejo visual de pads/pines en Altium. Curva Samsung:0.656uF tip a5V antes tolerancia/temperatura; no demuestra1uF efectivo. Cerrar MPN/banco equivalente antes liberar. | 1 | REQUIRED | ELECTRICAL_BLOCKED | CAD_CANDIDATE |
| B3_RFBT | Buck3V3 | Divisor feedback RFBT | LMR36015FBRNXR (propuesto) | 100 kOhm | 1% | 75 V max; limite sqrt(P*R) | 0.1 W @70 C | 0603 | RC0603FR-07100KL | GW_RC0603FR-07100KL_ac663db8 | GW_CAND_0603_res | hardware/academic_rev1/libraries/Gateway_Academic.SchLib + Gateway_Academic.PcbLib | S5 tabla10-1 y ecuacion3; ficha Yageo local p1 | CALCULATED | Vout nominal calculado 3.31481 V; ver esquinas de tolerancia. Cambiar parametros en copia docente. Modelo candidato existente; sin cotejo visual de pads/pines en Altium. | 1 | REQUIRED | DERIVED_PENDING_REVIEW | CAD_CANDIDATE |
| B3_RFBB | Buck3V3 | Divisor feedback RFBB | LMR36015FBRNXR (propuesto) | 43.2 kOhm | 1% | 75 V max; limite sqrt(P*R) | 0.1 W @70 C | 0603 | RC0603FR-0743K2L | GW_RC0603FR-0743K2L_a8308c0c | GW_CAND_0603_res | hardware/academic_rev1/libraries/Gateway_Academic.SchLib + Gateway_Academic.PcbLib | S5 tabla10-1 y ecuacion3; ficha Yageo local p1 | CALCULATED | Vout nominal calculado 3.31481 V; ver esquinas de tolerancia. Cambiar parametros en copia docente. Modelo candidato existente; sin cotejo visual de pads/pines en Altium. | 1 | REQUIRED | DERIVED_PENDING_REVIEW | CAD_CANDIDATE |
| B3_CFF | Buck3V3 | Feed-forward sobre RFBT | LMR36015FBRNXR (propuesto) | 20 pF | 5% | 50 V; C0G | N/A | 0603 | C0603C200J5GACTU | GW_C0603C200J5GACTU_c75b007a | GW_CAND_0603_cap | hardware/academic_rev1/libraries/Gateway_Academic.SchLib + Gateway_Academic.PcbLib | S5 tabla10-1 y seccion10.2.1.2.9; ficha KEMET p1 | PROVISIONAL | Valor guia fabricante; validar lazo. Con RFBT100k no obligatorio universal; reservar DNP hasta respuesta/Bode. Modelo candidato existente; sin cotejo visual de pads/pines en Altium. | 1 | CONDITIONAL | PROVISIONAL | CAD_CANDIDATE |
| B3_RENP | Buck3V3 | UVLO externo/PG si se utilizan | LMR36015FBRNXR (propuesto) | TBD | TBD | TBD | N/A | TBD | TBD | MISSING | MISSING | MISSING | S5 pines; ecuacion10; seccion10.2.1.2.8 | PROVISIONAL | EN a VIN, PG sin uso: cero resistencias. Si se exige UVLO18 V o PG, dimensionar redes por ecuacion10 y cargas; no contar pull-up inexistente. | 0 | DNP | PROVISIONAL | CAD_BLOCKED |
| B3_CDAMP | Buck3V3 | Bulk amortiguador de cableado si se requiere | LMR36015FBRNXR (propuesto) | TBD | TBD | TBD | N/A | TBD | TBD | MISSING | MISSING | MISSING | S5 seccion11 y10.2.1.2.6 | BLOCKED | C/ESR dependen impedancia fuente/cable y front-end. Electrolitico docente35 V no aprobado frente transitorios. | TBD | CONDITIONAL | ELECTRICAL_BLOCKED | CAD_BLOCKED |

### BOM Buck5V

| ID | Subsistema | Funcion | Referencia principal (fabricante) | Valor nominal | Tolerancia | Tension/corriente nominal | Potencia | Encapsulado | MPN recomendado/candidato | Simbolo candidato | Footprint candidato | Origen CAD | Fuente valor electrico | Estado global | Observaciones | Cantidad | Montaje | Estado electrico | Estado CAD |
|---|---|---|---|---|---|---|---|---|---|---|---|---|---|---|---|---|---|---|---|
| B5_L | Buck5V | Inductor buck | LMR36015FBRNXR (propuesto) | 10 uH | 20% | Isat25C 3.0 A; Irms20C 2.2 A | N/A | XAL4040 | XAL4040-103MEC | GW_XAL4040-103MEC_b36cb917 | MISSING | hardware/academic_rev1/libraries/Gateway_Academic.SchLib + Gateway_Academic.PcbLib | S5 tabla10-1; ecuaciones4-5; P6 tabla806-1 | CALCULATED | DCRmax25C 92.4 mOhm. Isat es caida30% tipica; falta derating caliente/curva L(I)/perdidas nucleo y CAD. No usar inductor docente sin Isat verificable. | 1 | REQUIRED | DERIVED_PENDING_REVIEW | CAD_BLOCKED |
| B5_CIN | Buck5V | Banco ceramico entrada | LMR36015FBRNXR (propuesto) | 4.7 uF por unidad; Ceff total >=4.7 uF objetivo conservador | 10% | 100 V; X7R | N/A | 2220 | C5750X7R2A475K230KA | GW_C5750X7R2A475K230KA_5f18f946 | MISSING | hardware/academic_rev1/libraries/Gateway_Academic.SchLib + Gateway_Academic.PcbLib | S5 seccion10.2.1.2.6; P7 TDK ficha oficial | BLOCKED | No fijar cantidad hasta curva bias a30 V+tolerancia+temperatura. 4.7 nominal no garantiza 4.7 efectivo. Carga RMS objetivo >= 0.05 A banco; 2220 no presente profesor. | TBD | REQUIRED | ELECTRICAL_BLOCKED | CAD_BLOCKED |
| B5_CHF | Buck5V | Bypass de cada par VIN-PGND | LMR36015FBRNXR (propuesto) | 220 nF | 10% | 100 V; X7R | N/A | 0805 | C0805C224K1RACTU | GW_C0805C224K1RACTU_e16e52b8 | GW_CAND_0805_cap | hardware/academic_rev1/libraries/Gateway_Academic.SchLib + Gateway_Academic.PcbLib | S5 seccion10.2.1.2.6 p23; ficha KEMET local p1 | PROVISIONAL | Uno por par VIN-PGND en lados opuestos; falta Ceff y cotejo dimensiones pads. Modelo candidato existente; sin cotejo visual de pads/pines en Altium. | 2 | REQUIRED | PROVISIONAL | CAD_CANDIDATE |
| B5_COUT | Buck5V | Banco salida | LMR36015FBRNXR (propuesto) | 15 uF por unidad; 45 uF nominal banco | 20% | 16 V; X7R | N/A | 1210 | C3225X7R1C156M250AB | GW_C3225X7R1C156M250AB_bb412b42 | MISSING | hardware/academic_rev1/libraries/Gateway_Academic.SchLib + Gateway_Academic.PcbLib | S5 tabla10-1: 3x15 uF nominal; P8 TDK ficha oficial | BLOCKED | Ceff a 5 V, ESR, escalon de carga y Bode pendientes. No atribuir 45 uF efectivos ni ESR3.04mOhm del modelo AR. Sin footprint1210 docente. | 3 | REQUIRED | ELECTRICAL_BLOCKED | CAD_BLOCKED |
| B5_CBOOT | Buck5V | BOOT a SW | LMR36015FBRNXR (propuesto) | 100 nF | 10% | 50 V; X7R; -55..125 C | N/A | 0603 | C0603C104K5RACTU | GW_C0603C104K5RACTU_dc5e12a5 | GW_CAND_0603_cap | hardware/academic_rev1/libraries/Gateway_Academic.SchLib + Gateway_Academic.PcbLib | S5 seccion10.2.1.2.7:100nF >=16V | PROVISIONAL | Ficha KEMET local p1. Adaptar parametros; no usar el Y5V 0603F104Z500CT como equivalente. Modelo candidato existente; sin cotejo visual de pads/pines en Altium. | 1 | REQUIRED | PROVISIONAL | CAD_CANDIDATE |
| B5_CVCC | Buck5V | VCC interno a GND | LMR36015FBRNXR (propuesto) | 1 uF | 10% | 50 V; X5R; -55..85 C | N/A | 0603 | CL10A105KB8NNNC | GW_CL10A105KB8NNNC_c3932faa | GW_CAND_0603_cap | hardware/academic_rev1/libraries/Gateway_Academic.SchLib + Gateway_Academic.PcbLib | S5 seccion10.2.1.2.8:1uF >=16V | BLOCKED | Samsung ficha oficial; Ceff/ESR pendientes por aplicacion. Limite X5R 85 C: no homologado para ambiente superior. Modelo candidato existente; sin cotejo visual de pads/pines en Altium. Curva Samsung:0.656uF tip a5V antes tolerancia/temperatura; no demuestra1uF efectivo. Cerrar MPN/banco equivalente antes liberar. | 1 | REQUIRED | ELECTRICAL_BLOCKED | CAD_CANDIDATE |
| B5_RFBT | Buck5V | Divisor feedback RFBT | LMR36015FBRNXR (propuesto) | 100 kOhm | 1% | 75 V max; limite sqrt(P*R) | 0.1 W @70 C | 0603 | RC0603FR-07100KL | GW_RC0603FR-07100KL_ac663db8 | GW_CAND_0603_res | hardware/academic_rev1/libraries/Gateway_Academic.SchLib + Gateway_Academic.PcbLib | S5 tabla10-1 y ecuacion3; ficha Yageo local p1 | CALCULATED | Vout nominal calculado 5.01606 V; ver esquinas de tolerancia. Cambiar parametros en copia docente. Modelo candidato existente; sin cotejo visual de pads/pines en Altium. | 1 | REQUIRED | DERIVED_PENDING_REVIEW | CAD_CANDIDATE |
| B5_RFBB | Buck5V | Divisor feedback RFBB | LMR36015FBRNXR (propuesto) | 24.9 kOhm | 1% | 75 V max; limite sqrt(P*R) | 0.1 W @70 C | 0603 | RC0603FR-0724K9L | GW_RC0603FR-0724K9L_10698e9e | GW_CAND_0603_res | hardware/academic_rev1/libraries/Gateway_Academic.SchLib + Gateway_Academic.PcbLib | S5 tabla10-1 y ecuacion3; ficha Yageo local p1 | CALCULATED | Vout nominal calculado 5.01606 V; ver esquinas de tolerancia. Cambiar parametros en copia docente. Modelo candidato existente; sin cotejo visual de pads/pines en Altium. | 1 | REQUIRED | DERIVED_PENDING_REVIEW | CAD_CANDIDATE |
| B5_CFF | Buck5V | Feed-forward sobre RFBT | LMR36015FBRNXR (propuesto) | 20 pF | 5% | 50 V; C0G | N/A | 0603 | C0603C200J5GACTU | GW_C0603C200J5GACTU_c75b007a | GW_CAND_0603_cap | hardware/academic_rev1/libraries/Gateway_Academic.SchLib + Gateway_Academic.PcbLib | S5 tabla10-1 y seccion10.2.1.2.9; ficha KEMET p1 | PROVISIONAL | Valor guia fabricante; validar lazo. Con RFBT100k no obligatorio universal; reservar DNP hasta respuesta/Bode. Modelo candidato existente; sin cotejo visual de pads/pines en Altium. | 1 | CONDITIONAL | PROVISIONAL | CAD_CANDIDATE |
| B5_RENP | Buck5V | UVLO externo/PG si se utilizan | LMR36015FBRNXR (propuesto) | TBD | TBD | TBD | N/A | TBD | TBD | MISSING | MISSING | MISSING | S5 pines; ecuacion10; seccion10.2.1.2.8 | PROVISIONAL | EN a VIN, PG sin uso: cero resistencias. Si se exige UVLO18 V o PG, dimensionar redes por ecuacion10 y cargas; no contar pull-up inexistente. | 0 | DNP | PROVISIONAL | CAD_BLOCKED |
| B5_CDAMP | Buck5V | Bulk amortiguador de cableado si se requiere | LMR36015FBRNXR (propuesto) | TBD | TBD | TBD | N/A | TBD | TBD | MISSING | MISSING | MISSING | S5 seccion11 y10.2.1.2.6 | BLOCKED | C/ESR dependen impedancia fuente/cable y front-end. Electrolitico docente35 V no aprobado frente transitorios. | TBD | CONDITIONAL | ELECTRICAL_BLOCKED | CAD_BLOCKED |

### BOM Entrada

| ID | Subsistema | Funcion | Referencia principal (fabricante) | Valor nominal | Tolerancia | Tension/corriente nominal | Potencia | Encapsulado | MPN recomendado/candidato | Simbolo candidato | Footprint candidato | Origen CAD | Fuente valor electrico | Estado global | Observaciones | Cantidad | Montaje | Estado electrico | Estado CAD |
|---|---|---|---|---|---|---|---|---|---|---|---|---|---|---|---|---|---|---|---|
| IN_FUSE | Entrada | Fusible o proteccion electronica | Entrada unica 18..30 V (propuesta pendiente) | TBD | TBD | TBD | N/A | TBD | TBD | MISSING | MISSING | MISSING | S5 seccion11; requisitos usuario; no circuito simplificado aprobado | BLOCKED | Definir fuente, corriente cargas DO, inrush, sobrevoltaje continuo, surge/norma y retorno. No heredar LTC4414/DMP6023LSS/NIS3071 ni sus pasivos. | TBD | TBD | ELECTRICAL_BLOCKED | CAD_BLOCKED |
| IN_REVERSE | Entrada | Bloqueo polaridad inversa | Entrada unica 18..30 V (propuesta pendiente) | TBD | TBD | TBD | N/A | TBD | TBD | MISSING | MISSING | MISSING | S5 seccion11; requisitos usuario; no circuito simplificado aprobado | BLOCKED | Definir fuente, corriente cargas DO, inrush, sobrevoltaje continuo, surge/norma y retorno. No heredar LTC4414/DMP6023LSS/NIS3071 ni sus pasivos. | TBD | TBD | ELECTRICAL_BLOCKED | CAD_BLOCKED |
| IN_TVS | Entrada | Supresion sobretension/transitorios | Entrada unica 18..30 V (propuesta pendiente) | TBD | TBD | TBD | N/A | TBD | TBD | MISSING | MISSING | MISSING | S5 seccion11; requisitos usuario; no circuito simplificado aprobado | BLOCKED | Definir fuente, corriente cargas DO, inrush, sobrevoltaje continuo, surge/norma y retorno. No heredar LTC4414/DMP6023LSS/NIS3071 ni sus pasivos. | TBD | TBD | ELECTRICAL_BLOCKED | CAD_BLOCKED |
| IN_BULK | Entrada | Reserva y amortiguacion entrada | Entrada unica 18..30 V (propuesta pendiente) | TBD | TBD | TBD | N/A | TBD | TBD | MISSING | MISSING | MISSING | S5 seccion11; requisitos usuario; no circuito simplificado aprobado | BLOCKED | Definir fuente, corriente cargas DO, inrush, sobrevoltaje continuo, surge/norma y retorno. No heredar LTC4414/DMP6023LSS/NIS3071 ni sus pasivos. | TBD | TBD | ELECTRICAL_BLOCKED | CAD_BLOCKED |
| IN_FILTER | Entrada | Filtro EMC si necesario | Entrada unica 18..30 V (propuesta pendiente) | TBD | TBD | TBD | N/A | TBD | TBD | MISSING | MISSING | MISSING | S5 seccion11; requisitos usuario; no circuito simplificado aprobado | BLOCKED | Definir fuente, corriente cargas DO, inrush, sobrevoltaje continuo, surge/norma y retorno. No heredar LTC4414/DMP6023LSS/NIS3071 ni sus pasivos. | TBD | TBD | ELECTRICAL_BLOCKED | CAD_BLOCKED |
| IN_J | Entrada | Conector entrada | 18..30 VDC | 2 polos + politica PE | TBD | >=30 V continuo mas transitorios; corriente TBD | N/A | TBD | JL126-50002G01 | GW_JL126-50002G01_16238e52 | GW_CAND_CON_2x1_TH_5MM | hardware/academic_rev1/libraries/Gateway_Academic.SchLib + Gateway_Academic.PcbLib | Alcance usuario; inventario borneras docente | BLOCKED | Priorizar bornera docente tras MPN/tension/corriente/taladros, no jack ambiguo2.0/2.1 mm. Modelo candidato existente; sin cotejo visual de pads/pines en Altium. | 1 | REQUIRED | ELECTRICAL_BLOCKED | CAD_CANDIDATE |

### BOM RS485

| ID | Subsistema | Funcion | Referencia principal (fabricante) | Valor nominal | Tolerancia | Tension/corriente nominal | Potencia | Encapsulado | MPN recomendado/candidato | Simbolo candidato | Footprint candidato | Origen CAD | Fuente valor electrico | Estado global | Observaciones | Cantidad | Montaje | Estado electrico | Estado CAD |
|---|---|---|---|---|---|---|---|---|---|---|---|---|---|---|---|---|---|---|---|
| RS_CVCC | RS485 | VCC 3.3 V | THVD1420DR propuesto | 100 nF | 10% | 50 V; X7R; -55..125 C | N/A | 0603 | C0603C104K5RACTU | GW_C0603C104K5RACTU_dc5e12a5 | GW_CAND_0603_cap | hardware/academic_rev1/libraries/Gateway_Academic.SchLib + Gateway_Academic.PcbLib | S6 seccion9 p19 | PROVISIONAL | Ficha KEMET local p1. Adaptar parametros; no usar el Y5V 0603F104Z500CT como equivalente. Modelo candidato existente; sin cotejo visual de pads/pines en Altium. | 1 | REQUIRED | PROVISIONAL | CAD_CANDIDATE |
| RS_RT | RS485 | Terminacion en extremo de cable | THVD1420DR | 120 Ohm si Z0=120 Ohm | 1% | >=3.3 V continuo; falla de bus aparte | >=0.25 W objetivo a70 C | 1206 candidato; no0603 0.1W | TBD | MISSING | MISSING | MISSING | S6 seccion8.2 fig8-1; calculo P=Vdiff^2/R | CALCULATED | 3.3^2/118.8=91.7mW antes tolerancia rail y derating. Docente120Ohm/0.1W no tiene margen termico demostrado. Solo dos extremos de bus. | 1 | CONDITIONAL | DERIVED_PENDING_REVIEW | CAD_BLOCKED |
| RS_RDE | RS485 | DE a GND durante arranque | THVD1420DR | 10 kOhm | 5% | >= 3.3 V; tension de trabajo por verificar | 0.1 W | 0603 | FRC0603J103TS | GW_FRC0603J103TS_7289f91d | GW_CAND_0603_res | hardware/academic_rev1/libraries/Gateway_Academic.SchLib + Gateway_Academic.PcbLib | S6 seccion10.1 item6:1..10k; fig8-5:10k | PROVISIONAL | Ratings transcritos del CAD; falta ficha FOJAN. Alternativa RC0603FR-0710KL con ficha oficial local, mismo footprint candidato. Modelo candidato existente; sin cotejo visual de pads/pines en Altium. | 1 | REQUIRED | PROVISIONAL | CAD_CANDIDATE |
| RS_RRE | RS485 | nRE a VCC durante arranque | THVD1420DR | 10 kOhm | 5% | >= 3.3 V; tension de trabajo por verificar | 0.1 W | 0603 | FRC0603J103TS | GW_FRC0603J103TS_7289f91d | GW_CAND_0603_res | hardware/academic_rev1/libraries/Gateway_Academic.SchLib + Gateway_Academic.PcbLib | S6 seccion10.1 item6:1..10k; fig8-5:10k | PROVISIONAL | Ratings transcritos del CAD; falta ficha FOJAN. Alternativa RC0603FR-0710KL con ficha oficial local, mismo footprint candidato. Modelo candidato existente; sin cotejo visual de pads/pines en Altium. | 1 | REQUIRED | PROVISIONAL | CAD_CANDIDATE |
| RS_RPULSE | RS485 | Limitacion residual en A/B si surge1kV | THVD1420DR | 10 Ohm | 5% | Pulse-proof segun ficha exacta | Pulsos por verificar | 0603 | CRCW0603010RJNEAHP | GW_CRCW0603010RJNEAHP_c8eb51d2 | GW_CAND_0603_res | hardware/academic_rev1/libraries/Gateway_Academic.SchLib + Gateway_Academic.PcbLib | S6 fig8-5 tabla8-1 p19 | BLOCKED | Referencia usa THVD1400 a5 V. No valida THVD1420/3.3V/12Mbps: verificar VOD tras20Ohm, residuales clamp, pulsos y timing. Modelo candidato existente; sin cotejo visual de pads/pines en Altium. | 2 | CONDITIONAL | ELECTRICAL_BLOCKED | CAD_CANDIDATE |
| RS_TVS | RS485 | Proteccion A/B | THVD1420DR | Asimetrica -7/+12 V candidata | TBD | TBD | N/A | SOT23 | CDSOT23-SM712 | MISSING | MISSING | MISSING | S6 tabla8-1 p19 | BLOCKED | No TVS aislado si clamp excede bus +/-16 V absoluto; red resistiva requerida y verificacion residual. Capacitancia y velocidad pendientes. | 1 | CONDITIONAL | ELECTRICAL_BLOCKED | CAD_BLOCKED |
| RS_BIAS | RS485 | Bias externo | THVD1420DR | TBD | TBD | TBD | N/A | TBD | TBD | MISSING | MISSING | MISSING | S6 seccion7.4 tabla7-2 fail-safe | PROVISIONAL | Open/short/idle fail-safe integrado; no duplicar polarizacion. Revisar otros nodos si el sistema la exige. | 0 | DNP | PROVISIONAL | CAD_BLOCKED |
| RS_J | RS485 | Bornera A/B/COM | THVD1420DR | 3 polos | TBD | TBD | N/A | TBD | MX126-5.0-03P-GN01-Cu-S-A | GW_MX126-5.0-03P-GN01-Cu-S-A_d57a488f | GW_CAND_CON_3x1_TH_5mm | hardware/academic_rev1/libraries/Gateway_Academic.SchLib + Gateway_Academic.PcbLib | S6 red half-duplex; inventario docente | BLOCKED | Ratings, corrientes de falla, pinout y referencia comun pendientes; no asumir aislamiento galvanico. Modelo candidato existente; sin cotejo visual de pads/pines en Altium. | 1 | REQUIRED | ELECTRICAL_BLOCKED | CAD_CANDIDATE |

### BOM CAN

| ID | Subsistema | Funcion | Referencia principal (fabricante) | Valor nominal | Tolerancia | Tension/corriente nominal | Potencia | Encapsulado | MPN recomendado/candidato | Simbolo candidato | Footprint candidato | Origen CAD | Fuente valor electrico | Estado global | Observaciones | Cantidad | Montaje | Estado electrico | Estado CAD |
|---|---|---|---|---|---|---|---|---|---|---|---|---|---|---|---|---|---|---|---|
| CAN_CVCC5 | CAN | Desacoplo VCC5 | ATA6561-GAQW propuesto | 100 nF | 10% | 50 V; X7R; -55..125 C | N/A | 0603 | C0603C104K5RACTU | GW_C0603C104K5RACTU_dc5e12a5 | GW_CAND_0603_cap | hardware/academic_rev1/libraries/Gateway_Academic.SchLib + Gateway_Academic.PcbLib | S7 tablaB-2 C3/C5; figA-1 | PROVISIONAL | Ficha KEMET local p1. Adaptar parametros; no usar el Y5V 0603F104Z500CT como equivalente. Modelo candidato existente; sin cotejo visual de pads/pines en Altium. | 1 | REQUIRED | PROVISIONAL | CAD_CANDIDATE |
| CAN_CVIO3V3 | CAN | Desacoplo VIO3V3 | ATA6561-GAQW propuesto | 100 nF | 10% | 50 V; X7R; -55..125 C | N/A | 0603 | C0603C104K5RACTU | GW_C0603C104K5RACTU_dc5e12a5 | GW_CAND_0603_cap | hardware/academic_rev1/libraries/Gateway_Academic.SchLib + Gateway_Academic.PcbLib | S7 tablaB-2 C3/C5; figA-1 | PROVISIONAL | Ficha KEMET local p1. Adaptar parametros; no usar el Y5V 0603F104Z500CT como equivalente. Modelo candidato existente; sin cotejo visual de pads/pines en Altium. | 1 | REQUIRED | PROVISIONAL | CAD_CANDIDATE |
| CAN_RSPLIT | CAN | Dos mitades terminacion extremo | ATA6561-GAQW | 62 Ohm | <=1%; matching <1% deseable | Bus CAN; falla DC por verificar | 0.5 W por resistor segun EVM | 1206 | TBD | MISSING | MISSING | MISSING | S7 seccion3.5 pp17-18 y tablaB-2 p32 | BLOCKED | 124Ohm diferencial; no usar120Ohm docente en paralelo ni fijar60Ohm total por nodo. MPN0.5W1206 pendiente. | 2 | CONDITIONAL | ELECTRICAL_BLOCKED | CAD_BLOCKED |
| CAN_CSPLIT | CAN | Punto medio a GND | ATA6561-GAQW | 4.7 nF | TBD | 50 V; X7R candidato | N/A | 0805 | TBD | MISSING | MISSING | MISSING | S7 seccion3.5 rango4.7..47nF; tablaB-2 C1 | MISSING | Valor por defecto EVM; no son15pF/CL de circuito de timing. | 1 | CONDITIONAL | ELECTRICAL_BLOCKED | CAD_BLOCKED |
| CAN_CBULK | CAN | Reserva VCC opcional | ATA6561-GAQW | 47 uF | TBD | 10 V minimo EVM | N/A | 1210 candidato | TBD | MISSING | MISSING | MISSING | S7 tablaB-2 C2 | MISSING | No obligatoria universal si buck y distribucion aportan reserva; comprobar caida/transitorios antes poblar. | 1 | CONDITIONAL | ELECTRICAL_BLOCKED | CAD_BLOCKED |
| CAN_CBUS | CAN | Capacitancias EMC simetricas opcionales | ATA6561-GAQW | 100 pF aprox | Matching lo menor posible | TBD bus | N/A | TBD | TBD | MISSING | MISSING | MISSING | S7 seccion3.5 p18 | BLOCKED | Validar CAN-FD5Mbps y carga total de bus antes de agregar; no copiar automaticamente. | 2 | CONDITIONAL | ELECTRICAL_BLOCKED | CAD_BLOCKED |
| CAN_CMC | CAN | Choke modo comun opcional | ATA6561-GAQW | TBD segun EMC | TBD | TBD | N/A | TBD | TBD | MISSING | MISSING | MISSING | S7 seccion3.5:opcional | PROVISIONAL | No adoptar automaticamente B82799 sin validar timing CAN-FD. | 0 | DNP | PROVISIONAL | CAD_BLOCKED |
| CAN_STBY | CAN | Pull-up STBY externo | ATA6561-GAQW | TBD | TBD | TBD | N/A | TBD | TBD | MISSING | MISSING | MISSING | S8 tabla electrica modo control; S7 seccion3.8 | PROVISIONAL | Pull-up interno75..175k aVIO, standby con GPIO HiZ. Controlar por GPIO; no fijar PD que habilite bus al boot. | 0 | DNP | PROVISIONAL | CAD_BLOCKED |
| CAN_TVS | CAN | TVS CAN externo segun inmunidad | ATA6561-GAQW | TBD | TBD | TBD | N/A | TBD | TBD | MISSING | MISSING | MISSING | S8 absmax bus; S7 seccion3.5 | BLOCKED | No especificacion EMC/cable/falla a24V cerrada. Seleccion y capacitancia pendientes; proteccion interna no prueba sistema. | TBD | TBD | ELECTRICAL_BLOCKED | CAD_BLOCKED |
| CAN_J | CAN | Bornera CANH/CANL/COM | ATA6561-GAQW | 3 polos | TBD | TBD | N/A | TBD | MX126-5.0-03P-GN01-Cu-S-A | GW_MX126-5.0-03P-GN01-Cu-S-A_d57a488f | GW_CAND_CON_3x1_TH_5mm | hardware/academic_rev1/libraries/Gateway_Academic.SchLib + Gateway_Academic.PcbLib | S7 circuito tipico | BLOCKED | Ratings/pinout, reglas de bus y opcion de terminacion pendientes. Modelo candidato existente; sin cotejo visual de pads/pines en Altium. | 1 | REQUIRED | ELECTRICAL_BLOCKED | CAD_CANDIDATE |

### BOM DO

| ID | Subsistema | Funcion | Referencia principal (fabricante) | Valor nominal | Tolerancia | Tension/corriente nominal | Potencia | Encapsulado | MPN recomendado/candidato | Simbolo candidato | Footprint candidato | Origen CAD | Fuente valor electrico | Estado global | Observaciones | Cantidad | Montaje | Estado electrico | Estado CAD |
|---|---|---|---|---|---|---|---|---|---|---|---|---|---|---|---|---|---|---|---|
| DO_CVCCA3V3 | DO | Desacoplo VCCA3V3 | SN74LVC2T45DCUR propuesto | 100 nF | 10% | 50 V; X7R; -55..125 C | N/A | 0603 | C0603C104K5RACTU | GW_C0603C104K5RACTU_dc5e12a5 | GW_CAND_0603_cap | hardware/academic_rev1/libraries/Gateway_Academic.SchLib + Gateway_Academic.PcbLib | S9 seccion8.3 (0.01/0.022uF por VCC multiple; 0.1uF aceptable paralelo) | PROVISIONAL | Ficha KEMET local p1. Adaptar parametros; no usar el Y5V 0603F104Z500CT como equivalente. Modelo candidato existente; sin cotejo visual de pads/pines en Altium. | 1 | REQUIRED | PROVISIONAL | CAD_CANDIDATE |
| DO_CVCCB5 | DO | Desacoplo VCCB5 | SN74LVC2T45DCUR propuesto | 100 nF | 10% | 50 V; X7R; -55..125 C | N/A | 0603 | C0603C104K5RACTU | GW_C0603C104K5RACTU_dc5e12a5 | GW_CAND_0603_cap | hardware/academic_rev1/libraries/Gateway_Academic.SchLib + Gateway_Academic.PcbLib | S9 seccion8.3 (0.01/0.022uF por VCC multiple; 0.1uF aceptable paralelo) | PROVISIONAL | Ficha KEMET local p1. Adaptar parametros; no usar el Y5V 0603F104Z500CT como equivalente. Modelo candidato existente; sin cotejo visual de pads/pines en Altium. | 1 | REQUIRED | PROVISIONAL | CAD_CANDIDATE |
| DO_RPDA | DO | Pulldown A1/A2 arranque | SN74LVC2T45/BSP75N | 10 kOhm | 5% | >= 3.3 V; tension de trabajo por verificar | 0.1 W | 0603 | FRC0603J103TS | GW_FRC0603J103TS_7289f91d | GW_CAND_0603_res | hardware/academic_rev1/libraries/Gateway_Academic.SchLib + Gateway_Academic.PcbLib | S9 seccion7.3 Ioff/I/O HiZ; S10 VIN(TH)>=1V; calculo propio seccionDO | CALCULATED | Ratings transcritos del CAD; falta ficha FOJAN. Alternativa RC0603FR-0710KL con ficha oficial local, mismo footprint candidato. Modelo candidato existente; sin cotejo visual de pads/pines en Altium. | 2 | REQUIRED | DERIVED_PENDING_REVIEW | CAD_CANDIDATE |
| DO_RPDB | DO | Pulldown B1/B2 arranque | SN74LVC2T45/BSP75N | 10 kOhm | 5% | >= 3.3 V; tension de trabajo por verificar | 0.1 W | 0603 | FRC0603J103TS | GW_FRC0603J103TS_7289f91d | GW_CAND_0603_res | hardware/academic_rev1/libraries/Gateway_Academic.SchLib + Gateway_Academic.PcbLib | S9 seccion7.3 Ioff/I/O HiZ; S10 VIN(TH)>=1V; calculo propio seccionDO | CALCULATED | Ratings transcritos del CAD; falta ficha FOJAN. Alternativa RC0603FR-0710KL con ficha oficial local, mismo footprint candidato. Modelo candidato existente; sin cotejo visual de pads/pines en Altium. | 2 | REQUIRED | DERIVED_PENDING_REVIEW | CAD_CANDIDATE |
| DO_RSER | DO | Resistencias serie control | BSP75N | TBD | TBD | TBD | N/A | TBD | TBD | MISSING | MISSING | MISSING | S10 IINmax1.2mA @5V; S9 VOH | PROVISIONAL | No agregar resistencia arbitraria que reduzca VIN bajo4.5V para protecciones. Revisar VOH con carga1.2mA+pulldown. | 0 | DNP | PROVISIONAL | CAD_BLOCKED |
| DO_SUPPRESS | DO | Supresion carga inductiva externa | BSP75NTA | TBD | TBD | TBD | N/A | TBD | TBD | MISSING | MISSING | MISSING | S10 tablas clamp/avalancha/termica pp3-6 | BLOCKED | Faltan L/ciclo/temperatura/tiempo desmagnetizacion; no declarar550mJ universal ni elegir diodo solo por corriente500mA. | TBD | TBD | ELECTRICAL_BLOCKED | CAD_BLOCKED |
| DO_JLOAD | DO | Bornes Vcampo/DRAIN por carga | BSP75NTA | 2 polos por canal | TBD | >=30 V y0.5 A/canal mas fallas | N/A | TBD | JL126-50002G01 | GW_JL126-50002G01_ddbad43f | GW_CAND_CON_2x1_TH_5MM | hardware/academic_rev1/libraries/Gateway_Academic.SchLib + Gateway_Academic.PcbLib | S10 low-side; requisitos alcance | BLOCKED | Priorizar bornera docente; source/tab a retorno campo; no terminal high-side. Retornos1A fuera GND analogico. Modelo candidato existente; sin cotejo visual de pads/pines en Altium. | 2 | REQUIRED | ELECTRICAL_BLOCKED | CAD_CANDIDATE |

### BOM DI

| ID | Subsistema | Funcion | Referencia principal (fabricante) | Valor nominal | Tolerancia | Tension/corriente nominal | Potencia | Encapsulado | MPN recomendado/candidato | Simbolo candidato | Footprint candidato | Origen CAD | Fuente valor electrico | Estado global | Observaciones | Cantidad | Montaje | Estado electrico | Estado CAD |
|---|---|---|---|---|---|---|---|---|---|---|---|---|---|---|---|---|---|---|---|
| DI_RSENSE1 | DI | SENSE1 a IN1 | ISO1212DBQR propuesto | 562 Ohm | 1% | 75 V max; limite sqrt(P*R) | 0.1 W @70 C | 0603 | RC0603FR-07562RL | GW_RC0603FR-07562RL_a6fad8df | GW_CAND_0603_res | hardware/academic_rev1/libraries/Gateway_Academic.SchLib + Gateway_Academic.PcbLib | S11 seccion8.2.1.2.1 ecuacion1; ficha Yageo local | CALCULATED | Ityp2.25mA; P conservadora a2.75mA=4.30mW. No es resistor de24V completos; corriente de campo separada deVCC1. Modelo candidato existente; sin cotejo visual de pads/pines en Altium. | 1 | REQUIRED | DERIVED_PENDING_REVIEW | CAD_CANDIDATE |
| DI_RTHR1 | DI | Serie entrada124V Type3 | ISO1212DBQR | 1 kOhm | 1% objetivo | Surge/pulsos por verificar | >=0.25 W MELF pulse rated | MELF segun fabricante | TBD | MISSING | MISSING | MISSING | S11 seccion8.2.1.2.1 ecuaciones2-4; tabla8-1 Type3 | MISSING | TI exige0.25W MELF si limita surge. No sustituir por FOJAN1k0603/0.1W. Type3 pendiente adopcion; Type1 usaria2.5k. | 1 | REQUIRED | ELECTRICAL_BLOCKED | CAD_BLOCKED |
| DI_CIN1 | DI | SENSE1 a FGND1 | ISO1212DBQR | 10 nF | 10% | 100 V; X7R; -55..125 C | N/A | 0603 | C0603C103K1RACTU | GW_C0603C103K1RACTU_97f3ee33 | GW_CAND_0603_cap | hardware/academic_rev1/libraries/Gateway_Academic.SchLib + Gateway_Academic.PcbLib | S11 tabla8-1 y seccion8.4; 10nF >=50V; ficha KEMET local | PROVISIONAL | Ficha KEMET local DI_CIN p1; no confundir con externo CL10B103KA8WPNC 25 V. Modelo candidato existente; sin cotejo visual de pads/pines en Altium. | 1 | REQUIRED | PROVISIONAL | CAD_CANDIDATE |
| DI_RSENSE2 | DI | SENSE2 a IN2 | ISO1212DBQR propuesto | 562 Ohm | 1% | 75 V max; limite sqrt(P*R) | 0.1 W @70 C | 0603 | RC0603FR-07562RL | GW_RC0603FR-07562RL_a6fad8df | GW_CAND_0603_res | hardware/academic_rev1/libraries/Gateway_Academic.SchLib + Gateway_Academic.PcbLib | S11 seccion8.2.1.2.1 ecuacion1; ficha Yageo local | CALCULATED | Ityp2.25mA; P conservadora a2.75mA=4.30mW. No es resistor de24V completos; corriente de campo separada deVCC1. Modelo candidato existente; sin cotejo visual de pads/pines en Altium. | 1 | REQUIRED | DERIVED_PENDING_REVIEW | CAD_CANDIDATE |
| DI_RTHR2 | DI | Serie entrada224V Type3 | ISO1212DBQR | 1 kOhm | 1% objetivo | Surge/pulsos por verificar | >=0.25 W MELF pulse rated | MELF segun fabricante | TBD | MISSING | MISSING | MISSING | S11 seccion8.2.1.2.1 ecuaciones2-4; tabla8-1 Type3 | MISSING | TI exige0.25W MELF si limita surge. No sustituir por FOJAN1k0603/0.1W. Type3 pendiente adopcion; Type1 usaria2.5k. | 1 | REQUIRED | ELECTRICAL_BLOCKED | CAD_BLOCKED |
| DI_CIN2 | DI | SENSE2 a FGND2 | ISO1212DBQR | 10 nF | 10% | 100 V; X7R; -55..125 C | N/A | 0603 | C0603C103K1RACTU | GW_C0603C103K1RACTU_97f3ee33 | GW_CAND_0603_cap | hardware/academic_rev1/libraries/Gateway_Academic.SchLib + Gateway_Academic.PcbLib | S11 tabla8-1 y seccion8.4; 10nF >=50V; ficha KEMET local | PROVISIONAL | Ficha KEMET local DI_CIN p1; no confundir con externo CL10B103KA8WPNC 25 V. Modelo candidato existente; sin cotejo visual de pads/pines en Altium. | 1 | REQUIRED | PROVISIONAL | CAD_CANDIDATE |
| DI_CVCC | DI | VCC1 a GND1 logico | ISO1212DBQR | 100 nF | 10% | 50 V; X7R; -55..125 C | N/A | 0603 | C0603C104K5RACTU | GW_C0603C104K5RACTU_dc5e12a5 | GW_CAND_0603_cap | hardware/academic_rev1/libraries/Gateway_Academic.SchLib + Gateway_Academic.PcbLib | S11 seccion8.3 | PROVISIONAL | Ficha KEMET local p1. Adaptar parametros; no usar el Y5V 0603F104Z500CT como equivalente. Modelo candidato existente; sin cotejo visual de pads/pines en Altium. | 1 | REQUIRED | PROVISIONAL | CAD_CANDIDATE |
| DI_CPE | DI | Acoplo FGND a PE opcional | ISO1212DBQR | 500 pF candidato | TBD | 2 kV; seguridad por definir | N/A | TBD | TBD | MISSING | MISSING | MISSING | S11 fig8-2 | BLOCKED | No puente aGND1; solo si existePE/arquitectura aislamiento aprobada. No copiar automaticamente. | 1 | CONDITIONAL | ELECTRICAL_BLOCKED | CAD_BLOCKED |
| DI_TVS | DI | TVS adicional entrada si EMC requiere | ISO1212DBQR | TBD | TBD | TBD | N/A | TBD | TBD | MISSING | MISSING | MISSING | S11 seccion8.2.1.2.5 tabla8-1 | PROVISIONAL | Red TI tiene robustez condicionada aMELF/CIN/layout; no agregarTVS28V sin revisar ubicacion trasRTHR, umbral y clamp. | 0 | DNP | PROVISIONAL | CAD_BLOCKED |
| DI_J | DI | Bornera IN1/IN2/COM campo | ISO1212DBQR | 3 polos si COM comun | TBD | TBD | N/A | TBD | MX126-5.0-03P-GN01-Cu-S-A | GW_MX126-5.0-03P-GN01-Cu-S-A_8a7ef64c | GW_CAND_CON_3x1_TH_5mm | hardware/academic_rev1/libraries/Gateway_Academic.SchLib + Gateway_Academic.PcbLib | S11 fig8-2 | BLOCKED | Aislamiento de grupo o por canal pendiente. SUB1/SUB2 NC; FGND noGND1. EN definido aVCC1 si salidas permanentes, sin resistor necesario. Modelo candidato existente; sin cotejo visual de pads/pines en Altium. | 1 | REQUIRED | ELECTRICAL_BLOCKED | CAD_CANDIDATE |
