anhenaobe/industrial-comunication-gateway/docs/hardware/assembly_bom_rev1.csv

designator | manufacturer | mpn | value | footprint | assembly_Rev1_Assembly | quantity_fitted | sheet | unique_id | symbol
C1 | KEMET | C0805C224K1RACTU | 220nF10%100VX7R | GW_0805_KEMET_NOMINAL | Fitted | 1 | Power.SchDoc | RKRKFCMQ | C0805C224K1RACTU
C2 | TDK | C5750X7R2A475K230KA | 4.7uF10%100VX7R | GW_C5750_TDK_REFLOW | Fitted | 1 | Power.SchDoc | UTTETZAT | C5750X7R2A475K230KA
C3 | KEMET | C0603C103K1RACTU | 10 nF | GW_0603_KEMET_NOMINAL | Fitted | 1 | Power.SchDoc | ZVSXFFNA | GW_C0603C103K1RACTU_97f3ee33
C4 | TDK | C3225X7R1C156M250AB | 15 uF por unidad; 45 uF nominal banco | GW_C3225_TDK_REFLOW | Fitted | 1 | Power.SchDoc | XJRSGURG | GW_C3225X7R1C156M250AB_bb412b42
C5 | TDK | C3225X7R1C156M250AB | 15 uF por unidad; 45 uF nominal banco | GW_C3225_TDK_REFLOW | Fitted | 1 | Power.SchDoc | GXHOBYAR | GW_C3225X7R1C156M250AB_bb412b42
C6 | TDK | C3225X7R1C156M250AB | 15 uF por unidad; 45 uF nominal banco | GW_C3225_TDK_REFLOW | Fitted | 1 | Power.SchDoc | GYVJIUFB | GW_C3225X7R1C156M250AB_bb412b42
C7 | TDK | C3225X7R1C156M250AB | 15uF20%16VX7R | GW_C3225_TDK_REFLOW | Fitted | 1 | Power.SchDoc | SGAYZVWG | C3225X7R1C156M250AB
C8 | KEMET | C0805C224K1RACTU | 220 nF | GW_0805_KEMET_NOMINAL | Fitted | 1 | Power.SchDoc | XAWODNOW | GW_C0805C224K1RACTU_e16e52b8
C9 | KEMET | C0805C224K1RACTU | 220 nF | GW_0805_KEMET_NOMINAL | Fitted | 1 | Power.SchDoc | YFDKQRST | GW_C0805C224K1RACTU_e16e52b8
C10 | KEMET | C0603C104K5RACTU | 100 nF | GW_0603_KEMET_NOMINAL | Fitted | 1 | Power.SchDoc | DILWSMQE | GW_C0603C104K5RACTU_dc5e12a5
C11 | KEMET | C0603C200J5GACTU | 20 pF | GW_0603_KEMET_NOMINAL | Not Fitted | 0 | Power.SchDoc | OOFJQOSD | GW_C0603C200J5GACTU_c75b007a
C12 | TDK | C5750X7R2A475K230KA | 4.7uF10%100VX7R | GW_C5750_TDK_REFLOW | Fitted | 1 | Power.SchDoc | VDIDGJBL | C5750X7R2A475K230KA
C13 | TDK | C3225X7R1C156M250AB | 15 uF por unidad; 45 uF nominal banco | GW_C3225_TDK_REFLOW | Fitted | 1 | Power.SchDoc | FMATDAQA | GW_C3225X7R1C156M250AB_bb412b42
C14 | TDK | C3225X7R1C156M250AB | 15 uF por unidad; 45 uF nominal banco | GW_C3225_TDK_REFLOW | Fitted | 1 | Power.SchDoc | WKNAIATP | GW_C3225X7R1C156M250AB_bb412b42
C15 | TDK | C3225X7R1C156M250AB | 15 uF por unidad; 45 uF nominal banco | GW_C3225_TDK_REFLOW | Fitted | 1 | Power.SchDoc | RIHZZXDF | GW_C3225X7R1C156M250AB_bb412b42
C16 | KEMET | C0805C225K5RACTU | 2.2uF10%50VX7R | GW_0805_KEMET_NOMINAL | Fitted | 1 | Power.SchDoc | NACSMIJC | C0805C225K5RACTU
C17 | KEMET | C0805C224K1RACTU | 220nF10%100VX7R | GW_0805_KEMET_NOMINAL | Fitted | 1 | Power.SchDoc | EDGIHUFV | C0805C224K1RACTU
C18 | KEMET | C0805C224K1RACTU | 220 nF | GW_0805_KEMET_NOMINAL | Fitted | 1 | Power.SchDoc | AUPIRNQP | GW_C0805C224K1RACTU_e16e52b8
C19 | KEMET | C0603C104K5RACTU | 100 nF | GW_0603_KEMET_NOMINAL | Fitted | 1 | Power.SchDoc | CKIXXZPM | GW_C0603C104K5RACTU_dc5e12a5
C20 | KEMET | C0603C200J5GACTU | 20 pF | GW_0603_KEMET_NOMINAL | Not Fitted | 0 | Power.SchDoc | DFJBIELY | GW_C0603C200J5GACTU_c75b007a
C21 | TDK | C3225X7R1C156M250AB | 15uF20%16VX7R | GW_C3225_TDK_REFLOW | Fitted | 1 | Power.SchDoc | ZRJTUGCW | C3225X7R1C156M250AB
C22 | KEMET | C0603C104K5RACTU | 100 nF | GW_0603_KEMET_NOMINAL | Fitted | 1 | MCU.SchDoc | KQULQVJX | GW_C0603C104K5RACTU_dc5e12a5
C23 | Samsung Electro-Mechanics | CL10A105KB8NNNC | 1 uF | GW_SAMSUNG_CL10_1608_REFLOW | Fitted | 1 | MCU.SchDoc | XCSEVBTV | GW_CL10A105KB8NNNC_c3932faa
C24 | KEMET | C0603C104K5RACTU | 100 nF | GW_0603_KEMET_NOMINAL | Fitted | 1 | MCU.SchDoc | RFWMSFCK | GW_C0603C104K5RACTU_dc5e12a5
C25 | KEMET | C0603C103K1RACTU | 10 nF | GW_0603_KEMET_NOMINAL | Fitted | 1 | MCU.SchDoc | OTVSHVWB | GW_C0603C103K1RACTU_97f3ee33
C26 | KEMET | C0603C104K5RACTU | 100 nF | GW_0603_KEMET_NOMINAL | Fitted | 1 | MCU.SchDoc | YZKFPFLD | GW_C0603C104K5RACTU_dc5e12a5
C27 | KEMET | C0805C475K4RACTU | 4.7 uF | GW_0805_KEMET_NOMINAL | Fitted | 1 | MCU.SchDoc | YPTBYMJC | GW_C0805C475K4RACTU_82374e08
C28 | KEMET | C0603C104K5RACTU | 100 nF | GW_0603_KEMET_NOMINAL | Fitted | 1 | MCU.SchDoc | LGKHVULL | GW_C0603C104K5RACTU_dc5e12a5
C29 | Samsung Electro-Mechanics | CL10A105KB8NNNC | 1 uF | GW_SAMSUNG_CL10_1608_REFLOW | Fitted | 1 | MCU.SchDoc | GUCMBGVU | GW_CL10A105KB8NNNC_c3932faa
C30 | KEMET | C0603C104K5RACTU | 100 nF | GW_0603_KEMET_NOMINAL | Fitted | 1 | MCU.SchDoc | GLVNHTQP | GW_C0603C104K5RACTU_dc5e12a5
C31 | KEMET | C0603C104K5RACTU | 100 nF | GW_0603_KEMET_NOMINAL | Fitted | 1 | MCU.SchDoc | BNBEPVDO | GW_C0603C104K5RACTU_dc5e12a5
C32 | KEMET | C0603C104K5RACTU | 100 nF | GW_0603_KEMET_NOMINAL | Fitted | 1 | MCU.SchDoc | LSWJZRFS | GW_C0603C104K5RACTU_dc5e12a5
C33 | KEMET | C0603C225K8RACTU | 2.2 uF | GW_0603_KEMET_NOMINAL | Fitted | 1 | MCU.SchDoc | JYNLOCNH | GW_C0603C225K8RACTU_46503424
C34 | KEMET | C0603C225K8RACTU | 2.2 uF | GW_0603_KEMET_NOMINAL | Fitted | 1 | MCU.SchDoc | RBNTEYAH | GW_C0603C225K8RACTU_46503424
C35 | KEMET | C0603C104K5RACTU | 100 nF | GW_0603_KEMET_NOMINAL | Fitted | 1 | MCU.SchDoc | ILZXHJRZ | GW_C0603C104K5RACTU_dc5e12a5
C36 | KEMET | C0603C103K1RACTU | 10 nF | GW_0603_KEMET_NOMINAL | Fitted | 1 | Ethernet.SchDoc | KDCUGLRA | GW_C0603C103K1RACTU_97f3ee33
C37 | KEMET | C0603C202J5GACTU | 2 nF | GW_0603_KEMET_NOMINAL | Fitted | 1 | Ethernet.SchDoc | TAHHXFNC | GW_C0603C202J5GACTU_fa733a70
C38 | KEMET | C0603C103K1RACTU | 10 nF | GW_0603_KEMET_NOMINAL | Fitted | 1 | Ethernet.SchDoc | IZIQQNAQ | GW_C0603C103K1RACTU_97f3ee33
C39 | KEMET | C0603C104K5RACTU | 100 nF | GW_0603_KEMET_NOMINAL | Fitted | 1 | Ethernet.SchDoc | RQZPEICP | GW_C0603C104K5RACTU_dc5e12a5
C40 | Samsung Electro-Mechanics | CL10A105KB8NNNC | 1 uF | GW_SAMSUNG_CL10_1608_REFLOW | Fitted | 1 | Ethernet.SchDoc | QFTYFZKS | GW_CL10A105KB8NNNC_c3932faa
C41 | Samsung Electro-Mechanics | CL21A106KAYNNNE | 10 uF | GW_SAMSUNG_CL21_2012_REFLOW | Fitted | 1 | Ethernet.SchDoc | EIFZMQEV | GW_CL21A106KAYNNNE_c6e24382
C42 | KEMET | C0603C104K5RACTU | 100 nF | GW_0603_KEMET_NOMINAL | Fitted | 1 | Ethernet.SchDoc | XTTHKGIP | GW_C0603C104K5RACTU_dc5e12a5
C43 | KEMET | C0603C104K5RACTU | 100 nF | GW_0603_KEMET_NOMINAL | Fitted | 1 | Ethernet.SchDoc | NJVAAZFJ | GW_C0603C104K5RACTU_dc5e12a5
C44 | KEMET | C0603C104K5RACTU | 100 nF | GW_0603_KEMET_NOMINAL | Fitted | 1 | Ethernet.SchDoc | YGKUKIJX | GW_C0603C104K5RACTU_dc5e12a5
C45 | KEMET | C0603C104K5RACTU | 100 nF | GW_0603_KEMET_NOMINAL | Fitted | 1 | Ethernet.SchDoc | IYTKAWMY | GW_C0603C104K5RACTU_dc5e12a5
C46 | KEMET | C1206C102KGRACAUTO | 1 nF | GW_C1206_KEMET_C1076_DENSITY_B | Fitted | 1 | Ethernet.SchDoc | NIJCSQQZ | C1206C102KGRACAUTO
C47 | KEMET | C0603C103K1RACTU | 10 nF | GW_0603_KEMET_NOMINAL | Fitted | 1 | Ethernet.SchDoc | WLLEHORR | GW_C0603C103K1RACTU_97f3ee33
C48 | KEMET | C0603C104K5RACTU | 100 nF | GW_0603_KEMET_NOMINAL | Fitted | 1 | Ethernet.SchDoc | BXGPDHAO | GW_C0603C104K5RACTU_dc5e12a5
C49 | Samsung Electro-Mechanics | CL10A105KB8NNNC | 1 uF | GW_SAMSUNG_CL10_1608_REFLOW | Fitted | 1 | Ethernet.SchDoc | WGKTYEQO | GW_CL10A105KB8NNNC_c3932faa
C50 | Samsung Electro-Mechanics | CL21A106KAYNNNE | 10 uF | GW_SAMSUNG_CL21_2012_REFLOW | Fitted | 1 | Ethernet.SchDoc | NJVBYEAV | GW_CL21A106KAYNNNE_c6e24382
C51 | KEMET | C0603C104K5RACTU | 100 nF | GW_0603_KEMET_NOMINAL | Fitted | 1 | Ethernet.SchDoc | HCWJDRLY | GW_C0603C104K5RACTU_dc5e12a5
C52 | KEMET | C1206C102KGRACAUTO | 1 nF | GW_C1206_KEMET_C1076_DENSITY_B | Fitted | 1 | Ethernet.SchDoc | BXITNTOA | C1206C102KGRACAUTO
C53 | KEMET | C0603C104K5RACTU | 100 nF | GW_0603_KEMET_NOMINAL | Fitted | 1 | Ethernet.SchDoc | HWYTFHHZ | GW_C0603C104K5RACTU_dc5e12a5
C54 | KEMET | C0603C104K5RACTU | 100 nF | GW_0603_KEMET_NOMINAL | Fitted | 1 | Ethernet.SchDoc | NLYTMBUU | GW_C0603C104K5RACTU_dc5e12a5
C55 | KEMET | C0603C103K1RACTU | 10 nF | GW_0603_KEMET_NOMINAL | Fitted | 1 | Field_IO.SchDoc | RNAUMUON | GW_C0603C103K1RACTU_97f3ee33
C56 | KEMET | C0603C104K5RACTU | 100 nF | GW_0603_KEMET_NOMINAL | Fitted | 1 | Field_IO.SchDoc | DRLIHQRN | GW_C0603C104K5RACTU_dc5e12a5
C57 | KEMET | C0603C103K1RACTU | 10 nF | GW_0603_KEMET_NOMINAL | Fitted | 1 | Field_IO.SchDoc | WYHGLROD | GW_C0603C103K1RACTU_97f3ee33
C58 | KEMET | C0603C104K5RACTU | 100 nF | GW_0603_KEMET_NOMINAL | Fitted | 1 | Field_IO.SchDoc | JHIWKOKG | GW_C0603C104K5RACTU_dc5e12a5
C59 | KEMET | C0603C104K5RACTU | 100 nF | GW_0603_KEMET_NOMINAL | Fitted | 1 | Field_IO.SchDoc | HWDGPBOG | GW_C0603C104K5RACTU_dc5e12a5
C60 | TDK | C5750X7R2A475K230KA | 4.7uF10%100VX7R | GW_C5750_TDK_REFLOW | Fitted | 1 | Power.SchDoc | ZLBZMHIR | C5750X7R2A475K230KA
C61 | KEMET | C0805C225K5RACTU | 2.2uF10%50VX7R | GW_0805_KEMET_NOMINAL | Fitted | 1 | Power.SchDoc | EACTPBPA | C0805C225K5RACTU
C62 | Samsung Electro-Mechanics | CL10A105KB8NNNC | 1 uF | GW_SAMSUNG_CL10_1608_REFLOW | Fitted | 1 | MCU.SchDoc | CWUGVEBI | GW_CL10A105KB8NNNC_c3932faa
C63 | KEMET | C0603C104K5RACTU | 100 nF | GW_0603_KEMET_NOMINAL | Fitted | 1 | MCU.SchDoc | SIFCIMEA | GW_C0603C104K5RACTU_dc5e12a5
C65 | KEMET | C1206C102KGRACAUTO | 1 nF | GW_C1206_KEMET_C1076_DENSITY_B | Not Fitted | 0 | Ethernet.SchDoc | LSSDIOIY | C1206C102KGRACAUTO
C66 | TDK | C5750X7R2A475K230KA | 4.7uF10%100VX7R | GW_C5750_TDK_REFLOW | Fitted | 1 | Power.SchDoc | JYDRTDJC | C5750X7R2A475K230KA
C67 | TDK | C5750X7R2A475K230KA | 4.7uF10%100VX7R | GW_C5750_TDK_REFLOW | Fitted | 1 | Power.SchDoc | EUAKJXSD | C5750X7R2A475K230KA
D1 | Vishay | SS3P6L-M3/86A |  | GW_SS3P6L_VISHAY_88987 | Fitted | 1 | Power.SchDoc | IHKGJGCT | SS3P6L-M3_86A
D2 | Semtech | TDS3311P.C | 33V working;42Vmax specified35A pulse | GW_TDS3311P_SEMTECH | Fitted | 1 | Power.SchDoc | WUBXBPPV | TDS3311P.C
D3 | Texas Instruments | TPD4E05U06DQAR |  | GW_DQA0010A_TI | Fitted | 1 | Ethernet.SchDoc | CHFQVBCZ | TPD4E05U06DQAR
D4 | Bourns | CDSOT23-SM712 |  | GW_SM712_BOURNS | Fitted | 1 | Field_IO.SchDoc | AVTRSCHS | CDSOT23-SM712
F1 | Littelfuse | 0451002.MRL |  | GW_0451_LITTELFUSE | Fitted | 1 | Power.SchDoc | MSRHFNGW | 0451002.MRL
J1 | Same Sky (Formerly CUI Devices) | TB002-500-02BE | * | GW_TB002_500_2P_SAMESKY | Fitted | 1 | Power.SchDoc | JQFVLHLV | TB002-500-02BE
J2 | Cinch / Stewart | SS-7188S-A-NF |  | GW_SS7188SANF_STEWART | Fitted | 1 | Ethernet.SchDoc | COZFDHHG | SS-7188S-A-NF
J3 | Wurth Elektronik | 61300611121 | 6 posiciones | GW_WRPHD_6X1_254_WURTH | Fitted | 1 | MCU.SchDoc | COUCKRXB | GW_H_Male_6x1_TH_100mil_c0450d1e
J4 | Same Sky (formerly CUI Devices) | TB002-500-03BE | 3-pole5mm terminal block | GW_TB002_500_3P_SAMESKY | Fitted | 1 | Field_IO.SchDoc | QBMJUTDX | TB002-500-03BE
J5 | Same Sky (formerly CUI Devices) | TB002-500-02BE | 2-pole5mm terminal block | GW_TB002_500_2P_SAMESKY | Fitted | 1 | Field_IO.SchDoc | GEAPITIA | TB002-500-02BE
J6 | Same Sky (formerly CUI Devices) | TB002-500-02BE | 2-pole5mm terminal block | GW_TB002_500_2P_SAMESKY | Fitted | 1 | Field_IO.SchDoc | FRLZEHLZ | TB002-500-02BE
J7 | Same Sky (formerly CUI Devices) | TB002-500-02BE | 2-pole5mm terminal block | GW_TB002_500_2P_SAMESKY | Fitted | 1 | Field_IO.SchDoc | DDGOBXHJ | TB002-500-02BE
J8 | Wurth Elektronik | 61300211121 | 2 posiciones | GW_WRPHD_2X1_254_WURTH | Fitted | 1 | MCU.SchDoc | OGTGRVSS | GW_H_Male_2x1_TH_100mil_f89d9046
J9 | Same Sky (formerly CUI Devices) | TB002-500-03BE | 3-pole5mm terminal block | GW_TB002_500_3P_SAMESKY | Fitted | 1 | Field_IO.SchDoc | OWIWTRZK | TB002-500-03BE
J10 | Same Sky (formerly CUI Devices) | TB002-500-03BE | 3-pole5mm terminal block | GW_TB002_500_3P_SAMESKY | Fitted | 1 | Field_IO.SchDoc | IVYVIXIY | TB002-500-03BE
L1 | Coilcraft | XAL4030-682MEC | 6.8 uH | GW_XAL4030_COILCRAFT | Fitted | 1 | Power.SchDoc | OEWBQQXK | GW_XAL4030-682MEC_71dfd711
L2 | Coilcraft | XAL4040-103MEC | 10 uH | GW_XAL4040_COILCRAFT | Fitted | 1 | Power.SchDoc | RKAKPZLP | GW_XAL4040-103MEC_b36cb917
Q1 | Diodes Incorporated | MMBT3904-7-F | NPN 40V200mA | GW_MMBT3904_BEC_DIODES | Fitted | 1 | Field_IO.SchDoc | ZGPLWPAI | MMBT3904-7-F
Q2 | Diodes Incorporated | DMP2035U-7 | PMOS20V;VGS±10V | GW_DMP2035U_GSD_DIODES | Fitted | 1 | Field_IO.SchDoc | LYKPEOLB | DMP2035U-7
Q3 | Diodes Incorporated | MMBT3904-7-F | NPN 40V200mA | GW_MMBT3904_BEC_DIODES | Fitted | 1 | Field_IO.SchDoc | JWETHJDZ | MMBT3904-7-F
Q4 | Diodes Incorporated | DMP2035U-7 | PMOS20V;VGS±10V | GW_DMP2035U_GSD_DIODES | Fitted | 1 | Field_IO.SchDoc | KCBTBQQQ | DMP2035U-7
R1 | Yageo | RC0603FR-07768KL | 768kOhm1%0.1W75V | GW_RC0603_YAGEO_REFLOW | Fitted | 1 | Power.SchDoc | BLNFQLBZ | RC0603FR-07768KL
R2 | Yageo | RC0603FR-0713K3L | 13.3kOhm1%0.1W75V | GW_RC0603_YAGEO_REFLOW | Fitted | 1 | Power.SchDoc | OWKWZNDC | RC0603FR-0713K3L
R3 | Yageo | RC0603FR-0733K2L | 33.2kOhm1%0.1W75V | GW_RC0603_YAGEO_REFLOW | Fitted | 1 | Power.SchDoc | ROAOTNFT | RC0603FR-0733K2L
R4 | Yageo | RC0603FR-0730K1L | 30.1kOhm1%0.1W75V | GW_RC0603_YAGEO_REFLOW | Fitted | 1 | Power.SchDoc | DZUIXBLP | RC0603FR-0730K1L
R5 | Yageo | RC0603FR-07100KL | 100 kOhm | GW_RC0603_YAGEO_REFLOW | Fitted | 1 | Power.SchDoc | YCPJZLYO | GW_RC0603FR-07100KL_ac663db8
R6 | Yageo | RC0603FR-07100KL | 100 kOhm | GW_RC0603_YAGEO_REFLOW | Not Fitted | 0 | Power.SchDoc | MGEQAODF | GW_RC0603FR-07100KL_ac663db8
R7 | Yageo | RC0603FR-0743K2L | 43.2 kOhm | GW_RC0603_YAGEO_REFLOW | Fitted | 1 | Power.SchDoc | WSVQJHSJ | GW_RC0603FR-0743K2L_a8308c0c
R8 | Yageo | RC0603FR-07100KL | 100 kOhm | GW_RC0603_YAGEO_REFLOW | Fitted | 1 | Power.SchDoc | KBWRAZAY | GW_RC0603FR-07100KL_ac663db8
R9 | Yageo | RC0603FR-07100KL | 100 kOhm | GW_RC0603_YAGEO_REFLOW | Not Fitted | 0 | Power.SchDoc | RURNYBAG | GW_RC0603FR-07100KL_ac663db8
R10 | Yageo | RC0603FR-0724K9L | 24.9 kOhm | GW_RC0603_YAGEO_REFLOW | Fitted | 1 | Power.SchDoc | NOTQJJBT | GW_RC0603FR-0724K9L_10698e9e
R11 | FOJAN | FRC0603J103TS | 10 kOhm | GW_RC0603_YAGEO_REFLOW | Fitted | 1 | MCU.SchDoc | DEJZJHXW | GW_FRC0603J103TS_7289f91d
R12 | Vishay | CRCW080575R0FKEA | 75 Ohm | GW_CRCW0805_VISHAY_20035_REFLOW | Fitted | 1 | Ethernet.SchDoc | IJVLMCAI | CRCW080575R0FKEA
R13 | Yageo | RC0603FR-076K49L | 6.49 kOhm | GW_RC0603_YAGEO_REFLOW | Fitted | 1 | Ethernet.SchDoc | HECPLJIL | GW_RC0603FR-076K49L_f42a9329
R14 | Vishay | CRCW080575R0FKEA | 75 Ohm | GW_CRCW0805_VISHAY_20035_REFLOW | Fitted | 1 | Ethernet.SchDoc | NCGSEMQA | CRCW080575R0FKEA
R15 | Yageo | RC0603FR-072K49L | 2.49 kOhm | GW_RC0603_YAGEO_REFLOW | Fitted | 1 | Ethernet.SchDoc | GOYDQSAU | GW_RC0603FR-072K49L_b905c5f0
R16 | FOJAN | FRC0603J103TS | 10 kOhm | GW_RC0603_YAGEO_REFLOW | Fitted | 1 | Ethernet.SchDoc | CJHZXOPZ | GW_FRC0603J103TS_7289f91d
R17 | Vishay | CRCW080575R0FKEA | 75 Ohm | GW_CRCW0805_VISHAY_20035_REFLOW | Fitted | 1 | Ethernet.SchDoc | MPSWLHLR | CRCW080575R0FKEA
R18 | FOJAN | FRC0603J103TS | 10 kOhm | GW_RC0603_YAGEO_REFLOW | Fitted | 1 | Ethernet.SchDoc | ILPXQPZL | GW_FRC0603J103TS_7289f91d
R19 | Vishay | CRCW080575R0FKEA | 75 Ohm | GW_CRCW0805_VISHAY_20035_REFLOW | Fitted | 1 | Ethernet.SchDoc | BPELKBGI | CRCW080575R0FKEA
R20 | Yageo | RC0603FR-07562RL | 562 Ohm | GW_RC0603_YAGEO_REFLOW | Fitted | 1 | Field_IO.SchDoc | NLIJFTYK | GW_RC0603FR-07562RL_a6fad8df
R21 | Firstohm | MM204F1K00TKRTR3K0 |  | GW_MM204_FIRSTOHM | Fitted | 1 | Field_IO.SchDoc | JUPRMEBQ | MM204F1K00TKRTR3K0
R22 | Firstohm | MM204F1K00TKRTR3K0 |  | GW_MM204_FIRSTOHM | Fitted | 1 | Field_IO.SchDoc | KFWKUEKU | MM204F1K00TKRTR3K0
R23 | Yageo | RC0603FR-07562RL | 562 Ohm | GW_RC0603_YAGEO_REFLOW | Fitted | 1 | Field_IO.SchDoc | UALMXCSK | GW_RC0603FR-07562RL_a6fad8df
R24 | FOJAN | FRC0603J103TS | 10 kOhm | GW_RC0603_YAGEO_REFLOW | Fitted | 1 | Field_IO.SchDoc | MPAKHNYW | GW_FRC0603J103TS_7289f91d
R25 | Yageo | RC0603FR-07100RL | 100 Ohm | GW_RC0603_YAGEO_REFLOW | Fitted | 1 | Field_IO.SchDoc | EIFUFBCH | RC0603FR-07100RL
R26 | Yageo | RC0603FR-074K7L | 4.7 kOhm | GW_RC0603_YAGEO_REFLOW | Fitted | 1 | Field_IO.SchDoc | WWPIMQDJ | RC0603FR-074K7L
R27 | Yageo | RC0603FR-072K49L | 2.49 kOhm | GW_RC0603_YAGEO_REFLOW | Fitted | 1 | Field_IO.SchDoc | GYTFUJGQ | GW_RC0603FR-072K49L_b905c5f0
R28 | Yageo | RC0603FR-07100RL | 100 Ohm | GW_RC0603_YAGEO_REFLOW | Fitted | 1 | Field_IO.SchDoc | FQNRBDVH | RC0603FR-07100RL
R29 | Yageo | RC0603FR-074K7L | 4.7 kOhm | GW_RC0603_YAGEO_REFLOW | Fitted | 1 | Field_IO.SchDoc | SIHMJMSZ | RC0603FR-074K7L
R30 | FOJAN | FRC0603J103TS | 10 kOhm | GW_RC0603_YAGEO_REFLOW | Fitted | 1 | Field_IO.SchDoc | KTKLPTQK | GW_FRC0603J103TS_7289f91d
R31 | Yageo | RC0603FR-072K49L | 2.49 kOhm | GW_RC0603_YAGEO_REFLOW | Fitted | 1 | Field_IO.SchDoc | NYCHPYYK | GW_RC0603FR-072K49L_b905c5f0
R32 | Yageo | RC0603FR-074K7L | 4.7 kOhm | GW_RC0603_YAGEO_REFLOW | Fitted | 1 | Field_IO.SchDoc | RNDWTKPP | RC0603FR-074K7L
R33 | Yageo | RC0603FR-074K7L | 4.7 kOhm | GW_RC0603_YAGEO_REFLOW | Fitted | 1 | Field_IO.SchDoc | INOIRBWY | RC0603FR-074K7L
R34 | Yageo | RC0603FR-071ML |  | GW_RC0603_YAGEO_REFLOW | Not Fitted | 0 | Ethernet.SchDoc | GIKIFSPE | RC0603FR-071ML
R35 | Vishay | CRCW1206120RFKEA | 120 Ohm | GW_CRCW1206_VISHAY_20035_REFLOW | Not Fitted | 0 | Ethernet.SchDoc | LZXKQHYA | CRCW1206120RFKEA
R36 | Vishay | CRCW1206120RFKEA | 120 Ohm | GW_CRCW1206_VISHAY_20035_REFLOW | Not Fitted | 0 | Ethernet.SchDoc | QMYQFUAL | CRCW1206120RFKEA
T1 | Pulse Electronics | HX1188FNL |  | GW_HX1188FNL_PULSE | Fitted | 1 | Ethernet.SchDoc | TZFWBQJG | HX1188FNL
U1 | Texas Instruments | TPS26620DRCR |  | GW_DRC0010J_TI_TPS2662_EPU | Fitted | 1 | Power.SchDoc | PBWRWDQM | TPS26620DRCR
U2 | Texas Instruments | LMR36015FBRNXR | LMR36015FBRNXR | GW_RNX0012A_TI | Fitted | 1 | Power.SchDoc | HRMXGOKP | LMR36015FBRNXR
U3 | Texas Instruments | LMR36015FBRNXR | LMR36015FBRNXR | GW_RNX0012A_TI | Fitted | 1 | Power.SchDoc | JLMOVQWE | LMR36015FBRNXR
U4 | STMicroelectronics | STM32H723VET6 | STM32H723VET6 | GW_LQFP100_ST_1L | Fitted | 1 | MCU.SchDoc | GRNOZAMD | STM32H723VET6
U5 | Texas Instruments | DP83826IRHBR | DP83826IRHBR | GW_RHB0032M_TI | Fitted | 1 | Ethernet.SchDoc | WCLMUURL | DP83826IRHBR
U6 | Texas Instruments | THVD1420DR | THVD1420DR | GW_SOIC8_1P27_5P4 | Fitted | 1 | Ethernet.SchDoc | KYEFSGEW | THVD1420DR
U7 | Microchip | ATA6561-GAQW | ATA6561-GAQW | GW_SOIC8_1P27_5P4 | Fitted | 1 | Ethernet.SchDoc | PDGUCLHA | ATA6561-GAQW
U8 | Texas Instruments | ISO1212DBQR | ISO1212DBQR | GW_DBQ0016A_TI | Fitted | 1 | Field_IO.SchDoc | YBIQUACK | ISO1212DBQR
U10 | Diodes Incorporated | BSP75NTA | BSP75NTA | GW_BSP75N_SOT223_DN_DIODES | Fitted | 1 | Field_IO.SchDoc | HFVWTFFX | BSP75NTA
U11 | Diodes Incorporated | BSP75NTA | BSP75NTA | GW_BSP75N_SOT223_DN_DIODES | Fitted | 1 | Field_IO.SchDoc | HXFRPTPO | BSP75NTA
Y1 | Kyocera | KC2016Z25.0000C15XXK |  | GW_KC2016Z_KYOCERA | Fitted | 1 | MCU.SchDoc | RCWUKIAN | KC2016Z25.0000C15XXK
Y2 | Kyocera | KC2016Z25.0000C15XXK |  | GW_KC2016Z_KYOCERA | Fitted | 1 | Ethernet.SchDoc | FKHSFCWU | KC2016Z25.0000C15XXK
