anhenaobe/industrial-comunication-gateway/docs/hardware/library_inventory.csv

referencia_cad | mpn | fabricante | categoria | funcion | encapsulado_referencia_cad | simbolo | footprint | modelo_3d | detalle_3d | archivo | ruta_simbolo | ruta_footprint | compatibilidad | referencia_tecnica | disponible_fisicamente | disponible_comercialmente | precio | observaciones
CON_USB_TYPEC_16P | TYPE-C-3.1-16PIN | SHOU HAN | Soporte / CON | 3A USB 3.1 1 Surface Mount 16P Female -40?~+85? Type-C SMD USB Connectors ROHS | CON_USB_C_16P_RA | sí | sí | sí | step_temp.STEP | C:\dev\7mo\design\industrial-linux-gateway\shared_lib (1).IntLib | SchLib/0.schlib::CON_USB_TYPEC_16P/Data | PCBLib/0.pcblib::CON_USB_C_16P_RA/Data | Reutilización condicionada a valor, ratings, pinout y dimensiones; no validado eléctricamente | https://lcsc.com/product-detail/USB-Connectors_SHOU-HAN-TYPE-C-3-1-16PIN_C7507405.html | no verificado | no verificado | sin cotización comparable | Metadatos CAD; fabricante/MPN transcritos, no autenticados. Pinout y geometría pendientes de Altium/datasheet.
Cap_0.1uF_0603_50V | 0603F104Z500CT | Walsin Tech Corp | Alimentación / Cap | 50V 100nF Y5V -20%~+80% 0603 Multilayer Ceramic Capacitors MLCC - SMD/SMT ROHS | 0603_cap | sí | sí | sí | CircuitWorks-CAPACITOR 0603.STEP | C:\dev\7mo\design\industrial-linux-gateway\shared_lib (1).IntLib | SchLib/0.schlib::Cap_0.1uF_0603_50V/Data | PCBLib/0.pcblib::0603_cap/Data | Reutilización condicionada a valor, ratings, pinout y dimensiones; no validado eléctricamente | https://www.lcsc.com/product-detail/Multilayer-Ceramic-Capacitors-MLCC-SMD-SMT_Walsin-Tech-Corp-0603F104Z500CT_C83060.html | no verificado | no verificado | sin cotización comparable | Metadatos CAD; fabricante/MPN transcritos, no autenticados. Pinout y geometría pendientes de Altium/datasheet.
Cap_100uF_ALU_TH_35V | 35V100uF CD110 | HRK | Alimentación / Cap | 100uF 35V ±20% Plugin,D6.3xL12mm Aluminum Electrolytic Capacitors - Leaded ROHS | CAP_TH_2.5MM_6.3*12MM | sí | sí | sí | cuerpo extruido CAD | C:\dev\7mo\design\industrial-linux-gateway\shared_lib (1).IntLib | SchLib/0.schlib::Cap_100uF_ALU_TH_35V/Data | PCBLib/0.pcblib::CAP_TH_2.5MM_6.3_12MM/Data | Reutilización condicionada a valor, ratings, pinout y dimensiones; no validado eléctricamente | https://lcsc.com/product-detail/Aluminum-Electrolytic-Capacitors-Leaded_HRK-35V100uF-CD110_C2960381.html | no verificado | no verificado | sin cotización comparable | Metadatos CAD; fabricante/MPN transcritos, no autenticados. Pinout y geometría pendientes de Altium/datasheet.
Cap_10uF_0603_10V | TCC0603X5R106K100CT | CCTC | Alimentación / Cap | 10V 10uF X5R ±10% 0603 Multilayer Ceramic Capacitors MLCC - SMD/SMT ROHS | 0603_cap | sí | sí | sí | CircuitWorks-CAPACITOR 0603.STEP | C:\dev\7mo\design\industrial-linux-gateway\shared_lib (1).IntLib | SchLib/0.schlib::Cap_10uF_0603_10V/Data | PCBLib/0.pcblib::0603_cap/Data | Reutilización condicionada a valor, ratings, pinout y dimensiones; no validado eléctricamente | https://www.lcsc.com/product-detail/Multilayer-Ceramic-Capacitors-MLCC-SMD-SMT_CCTC-TCC0603X5R106K100CT_C380314.html | no verificado | no verificado | sin cotización comparable | Metadatos CAD; fabricante/MPN transcritos, no autenticados. Pinout y geometría pendientes de Altium/datasheet.
Cap_10uF_0805_25V_ | CL21A106KAYNNNE | Samsung Electro-Mechanics | Alimentación / Cap | 25V 10uF X5R ±10% 0805 Multilayer Ceramic Capacitors MLCC - SMD/SMT ROHS | 0805_cap | sí | sí | sí | cuerpo extruido CAD | C:\dev\7mo\design\industrial-linux-gateway\shared_lib (1).IntLib | SchLib/0.schlib::Cap_10uF_0805_25V_/Data | PCBLib/0.pcblib::0805_cap/Data | Reutilización condicionada a valor, ratings, pinout y dimensiones; no validado eléctricamente | https://lcsc.com/product-detail/Multilayer-Ceramic-Capacitors-MLCC-SMD-SMT_Samsung-Electro-Mechanics-CL21A106KAYNNNE_C15850.html | no verificado | no verificado | sin cotización comparable | Metadatos CAD; fabricante/MPN transcritos, no autenticados. Pinout y geometría pendientes de Altium/datasheet.
Cap_1nF_0603_50V | CC0603KRX7R9BB102 | YAGEO | Alimentación / Cap | 50V 1nF X7R ±10% 0603 Multilayer Ceramic Capacitors MLCC - SMD/SMT ROHS | 0603_cap | sí | sí | sí | CircuitWorks-CAPACITOR 0603.STEP | C:\dev\7mo\design\industrial-linux-gateway\shared_lib (1).IntLib | SchLib/0.schlib::Cap_1nF_0603_50V/Data | PCBLib/0.pcblib::0603_cap/Data | Reutilización condicionada a valor, ratings, pinout y dimensiones; no validado eléctricamente | https://www.lcsc.com/product-detail/Multilayer-Ceramic-Capacitors-MLCC-SMD-SMT_YAGEO-CC0603KRX7R9BB102_C100040.html | no verificado | no verificado | sin cotización comparable | Metadatos CAD; fabricante/MPN transcritos, no autenticados. Pinout y geometría pendientes de Altium/datasheet.
Cap_1uF_0603_50V | CL10A105KB8NNNC | Samsung Electro-Mechanics | Alimentación / Cap | 50V 1uF X5R ±10% 0603 Multilayer Ceramic Capacitors MLCC - SMD/SMT ROHS | 0603_cap | sí | sí | sí | CircuitWorks-CAPACITOR 0603.STEP | C:\dev\7mo\design\industrial-linux-gateway\shared_lib (1).IntLib | SchLib/0.schlib::Cap_1uF_0603_50V/Data | PCBLib/0.pcblib::0603_cap/Data | Reutilización condicionada a valor, ratings, pinout y dimensiones; no validado eléctricamente | https://www.lcsc.com/product-detail/Multilayer-Ceramic-Capacitors-MLCC-SMD-SMT_Samsung-Electro-Mechanics-CL10A105KB8NNNC_C15849.html | no verificado | no verificado | sin cotización comparable | Metadatos CAD; fabricante/MPN transcritos, no autenticados. Pinout y geometría pendientes de Altium/datasheet.
Cap_22uF_0603_10V | CGA0603X5R226M100JT | HRE | Alimentación / Cap | 10V 22uF X5R ±20% 0603 Multilayer Ceramic Capacitors MLCC - SMD/SMT ROHS | 0603_cap | sí | sí | sí | CircuitWorks-CAPACITOR 0603.STEP | C:\dev\7mo\design\industrial-linux-gateway\shared_lib (1).IntLib | SchLib/0.schlib::Cap_22uF_0603_10V/Data | PCBLib/0.pcblib::0603_cap/Data | Reutilización condicionada a valor, ratings, pinout y dimensiones; no validado eléctricamente | https://lcsc.com/product-detail/Multilayer-Ceramic-Capacitors-MLCC-SMD-SMT_HRE-CGA0603X5R226M100JT_C6119863.html | no verificado | no verificado | sin cotización comparable | Metadatos CAD; fabricante/MPN transcritos, no autenticados. Pinout y geometría pendientes de Altium/datasheet.
Cap_22uF_0805_16V | HGC0805R5226M160NSLJ | Chinocera | Alimentación / Cap | 16V 22uF X5R ±20% 0805 Multilayer Ceramic Capacitors MLCC - SMD/SMT ROHS | 0805_cap | sí | sí | sí | cuerpo extruido CAD | C:\dev\7mo\design\industrial-linux-gateway\shared_lib (1).IntLib | SchLib/0.schlib::Cap_22uF_0805_16V/Data | PCBLib/0.pcblib::0805_cap/Data | Reutilización condicionada a valor, ratings, pinout y dimensiones; no validado eléctricamente | https://lcsc.com/product-detail/Multilayer-Ceramic-Capacitors-MLCC-SMD-SMT_Chinocera-HGC0805R5226M160NSLJ_C33546008.html | no verificado | no verificado | sin cotización comparable | Metadatos CAD; fabricante/MPN transcritos, no autenticados. Pinout y geometría pendientes de Altium/datasheet.
Cap_22uF_0805_6V3 | CL21A226MQQNNNE | Samsung Electro-Mechanics | Alimentación / Cap | 6.3V 22uF X5R ±20% 0805 Multilayer Ceramic Capacitors MLCC - SMD/SMT ROHS | 0805_cap | sí | sí | sí | cuerpo extruido CAD | C:\dev\7mo\design\industrial-linux-gateway\shared_lib (1).IntLib | SchLib/0.schlib::Cap_22uF_0805_6V3/Data | PCBLib/0.pcblib::0805_cap/Data | Reutilización condicionada a valor, ratings, pinout y dimensiones; no validado eléctricamente | https://www.lcsc.com/product-detail/Multilayer-Ceramic-Capacitors-MLCC-SMD-SMT_Samsung-Electro-Mechanics-CL21A226MQQNNNE_C5674.html | no verificado | no verificado | sin cotización comparable | Metadatos CAD; fabricante/MPN transcritos, no autenticados. Pinout y geometría pendientes de Altium/datasheet.
Cap_33pF_0603_50V | CC0603JRNPO9BN330 | YAGEO | Alimentación / Cap | 50V 33pF NP0 ±5% 0603 Multilayer Ceramic Capacitors MLCC - SMD/SMT ROHS | 0603_cap | sí | sí | sí | CircuitWorks-CAPACITOR 0603.STEP | C:\dev\7mo\design\industrial-linux-gateway\shared_lib (1).IntLib | SchLib/0.schlib::Cap_33pF_0603_50V/Data | PCBLib/0.pcblib::0603_cap/Data | Reutilización condicionada a valor, ratings, pinout y dimensiones; no validado eléctricamente | https://www.lcsc.com/product-detail/Multilayer-Ceramic-Capacitors-MLCC-SMD-SMT_YAGEO-CC0603JRNPO9BN330_C107047.html | no verificado | no verificado | sin cotización comparable | Metadatos CAD; fabricante/MPN transcritos, no autenticados. Pinout y geometría pendientes de Altium/datasheet.
Cap_470nF_0603_50V | HGC0603R7474K500NTHJ | Chinocera | Alimentación / Cap | 50V 470nF X7R ±10% 0603 Multilayer Ceramic Capacitors MLCC - SMD/SMT ROHS | 0603_cap | sí | sí | sí | CircuitWorks-CAPACITOR 0603.STEP | C:\dev\7mo\design\industrial-linux-gateway\shared_lib (1).IntLib | SchLib/0.schlib::Cap_470nF_0603_50V/Data | PCBLib/0.pcblib::0603_cap/Data | Reutilización condicionada a valor, ratings, pinout y dimensiones; no validado eléctricamente | https://lcsc.com/product-detail/Multilayer-Ceramic-Capacitors-MLCC-SMD-SMT_Chinocera-HGC0603R7474K500NTHJ_C33546006.html | no verificado | no verificado | sin cotización comparable | Metadatos CAD; fabricante/MPN transcritos, no autenticados. Pinout y geometría pendientes de Altium/datasheet.
Con_2x1_TH_5mm | JL126-50002G01 | JILN | Soporte / Con | 2POS 5MM | CON_2x1_TH_5MM | sí | sí | sí | cuerpo extruido CAD | C:\dev\7mo\design\industrial-linux-gateway\shared_lib (1).IntLib | SchLib/0.schlib::Con_2x1_TH_5mm/Data | PCBLib/0.pcblib::CON_2x1_TH_5MM/Data | Reutilización condicionada a valor, ratings, pinout y dimensiones; no validado eléctricamente | https://www.lcsc.com/product-detail/Screw-terminal_JILN-JL126-50002G01_C394556.html | no verificado | no verificado | sin cotización comparable | Metadatos CAD; fabricante/MPN transcritos, no autenticados. Pinout y geometría pendientes de Altium/datasheet.
Con_2x1_TH_JST_2MM | S2B-PH-K-S(LF)(SN) | JST | Soporte / Con | 2POS 2MM | CON_2x1_TH_2MM | sí | sí | sí | S2B-PH-K-S(LF)(SN)--3DModel-STEP-56544.STEP | C:\dev\7mo\design\industrial-linux-gateway\shared_lib (1).IntLib | SchLib/0.schlib::Con_2x1_TH_JST_2MM/Data | PCBLib/0.pcblib::CON_2x1_TH_2MM/Data | Reutilización condicionada a valor, ratings, pinout y dimensiones; no validado eléctricamente | https://lcsc.com/product-detail/Wire-To-Board-Connector_JST-S2B-PH-K-S-LF-SN_C173752.html | no verificado | no verificado | sin cotización comparable | Metadatos CAD; fabricante/MPN transcritos, no autenticados. Pinout y geometría pendientes de Altium/datasheet.
Con_3x1_TH_5mm | MX126-5.0-03P-GN01-Cu-S-A | MAX | Soporte / Con | 1x3P 10A -40?~+105? 300V Green 14~26 Through Hole 5mm 2.5 1 3 Plugin,P=5mm Screw Terminal Blocks ROHS | CON_3x1_TH_5mm | sí | sí | sí | pxc_1935174_03_PT-1-5-3-5-0-H_3D.stp | C:\dev\7mo\design\industrial-linux-gateway\shared_lib (1).IntLib | SchLib/0.schlib::Con_3x1_TH_5mm/Data | PCBLib/0.pcblib::CON_3x1_TH_5mm/Data | Reutilización condicionada a valor, ratings, pinout y dimensiones; no validado eléctricamente | https://lcsc.com/product-detail/Screw-Terminal-Blocks_MAX-MX126-5-0-03P-GN01-Cu-S-A_C5188435.html | no verificado | no verificado | sin cotización comparable | Metadatos CAD; fabricante/MPN transcritos, no autenticados. Pinout y geometría pendientes de Altium/datasheet.
Con_Mini_USB_B | KH-MINI-SMT-5P-Cu | EDAC Inc. | Soporte / Con | CONN RCPT USB2.0 MINI B SMD R/A | CON_5x1_SMD_miniUSB_B | sí | sí | sí | usb_a-usb_b-m5-smd-c.stp | C:\dev\7mo\design\industrial-linux-gateway\shared_lib (1).IntLib | SchLib/0.schlib::Con_Mini_USB_B/Data | PCBLib/0.pcblib::CON_5x1_SMD_miniUSB_B/Data | Reutilización condicionada a valor, ratings, pinout y dimensiones; no validado eléctricamente | https://datasheet.lcsc.com/lcsc/2106070035_Shenzhen-Kinghelm-Elec-KH-MINI-SMT-5P-Cu_C2688795.pdf | no verificado | no verificado | sin cotización comparable | Metadatos CAD; fabricante/MPN transcritos, no autenticados. Pinout y geometría pendientes de Altium/datasheet.
Con_Power_Jack_2.1mm_3pins | HC-DC-005-2.0T | HCTL | Soporte / Con | CONN PWR JACK 2X5.5MM SOLDER | CON_POWER_BARREL_2.1MM_3CONN | sí | sí | sí | pj-002a.stp | C:\dev\7mo\design\industrial-linux-gateway\shared_lib (1).IntLib | SchLib/0.schlib::Con_Power_Jack_2.1mm_3pins/Data | PCBLib/0.pcblib::CON_POWER_BARREL_2.1MM_3CONN/Data | Reutilización condicionada a valor, ratings, pinout y dimensiones; no validado eléctricamente | https://www.lcsc.com/product-detail/AC-DC-Power-Connectors_HCTL-HC-DC-005-2-0T_C3010533.html | no verificado | no verificado | sin cotización comparable | Metadatos CAD; fabricante/MPN transcritos, no autenticados. Pinout y geometría pendientes de Altium/datasheet. Nombre 2.1mm frente a MPN HC-DC-005-2.0T: verificar diámetro real.
DCDC_SW_BOOST_4A_SOT23-6 | MT3608B | XI'AN Aerosemi Tech | Alimentación / DCDC | IC REG BUCK ADJ 4A SOT23 | SOT_23_6 | sí | sí | sí | SOT23-6-2.step | C:\dev\7mo\design\industrial-linux-gateway\shared_lib (1).IntLib | SchLib/0.schlib::DCDC_SW_BOOST_4A_SOT23-6/Data | PCBLib/0.pcblib::SOT_23_6/Data | Boost; descripción CAD dice BUCK: contradicción a resolver; no sustituye buck 24 V | https://lcsc.com/product-detail/DC-DC-Converters_XI-AN-Aerosemi-Tech-MT3608B_C19189893.html | no verificado | no verificado | sin cotización comparable | Metadatos CAD; fabricante/MPN transcritos, no autenticados. Pinout y geometría pendientes de Altium/datasheet.
DCDC_SW_BUCK_4A_SOT23-6 | TPS564201DDCR | Texas Instruments | Alimentación / DCDC | IC REG BUCK ADJ 4A SOT23 | SOT_23_6 | sí | sí | sí | SOT23-6-2.step | C:\dev\7mo\design\industrial-linux-gateway\shared_lib (1).IntLib | SchLib/0.schlib::DCDC_SW_BUCK_4A_SOT23-6/Data | PCBLib/0.pcblib::SOT_23_6/Data | Útil con entrada de baja tensión; TPS564201 17 V / TPS56528 18 V: no conectar a 24 V | https://lcsc.com/product-detail/DC-DC-Converters_Texas-Instruments-TPS564201DDCR_C464812.html | no verificado | no verificado | sin cotización comparable | Metadatos CAD; fabricante/MPN transcritos, no autenticados. Pinout y geometría pendientes de Altium/datasheet.
DCDC_SW_BUCK_5A_SOIC8 | TPS56528DDAR | Texas Instruments | Alimentación / DCDC | IC REG BUCK ADJ 5A 8SOPWR | SOIC_8_3.9mm_EP | sí | sí | sí | step_temp.STEP | C:\dev\7mo\design\industrial-linux-gateway\shared_lib (1).IntLib | SchLib/0.schlib::DCDC_SW_BUCK_5A_SOIC8/Data | PCBLib/0.pcblib::SOIC_8_3.9mm_EP/Data | Útil con entrada de baja tensión; TPS564201 17 V / TPS56528 18 V: no conectar a 24 V | https://lcsc.com/product-detail/DC-DC-Converters_Texas-Instruments-TPS56528DDAR_C138716.html | no verificado | no verificado | sin cotización comparable | Metadatos CAD; fabricante/MPN transcritos, no autenticados. Pinout y geometría pendientes de Altium/datasheet.
D_Schottky_40V_1A_SOD_123F | PSBD1DF40V1H | Shanghai Prisemi Elec | Alimentación / D | DIODE SCHOTTKY 40V 1A SOD123F | SOD_123 | sí | sí | sí | SOD123.step | C:\dev\7mo\design\industrial-linux-gateway\shared_lib (1).IntLib | SchLib/0.schlib::D_Schottky_40V_1A_SOD_123F/Data | PCBLib/0.pcblib::SOD_123/Data | Reutilización condicionada a valor, ratings, pinout y dimensiones; no validado eléctricamente | https://www.lcsc.com/product-detail/Switching-Diode_Shanghai-Prisemi-Elec-PSBD1DF40V1H_C110730.html | no verificado | no verificado | sin cotización comparable | Metadatos CAD; fabricante/MPN transcritos, no autenticados. Pinout y geometría pendientes de Altium/datasheet.
D_Schottky_40V_3A_SMA | SS34-TD | TDSEMIC | Alimentación / D | 40V Independent 3A 550mV@3A SMA Schottky Diodes ROHS | SMA | sí | sí | sí | SMASeries_LTF.step | C:\dev\7mo\design\industrial-linux-gateway\shared_lib (1).IntLib | SchLib/0.schlib::D_Schottky_40V_3A_SMA/Data | PCBLib/0.pcblib::SMA/Data | Reutilización condicionada a valor, ratings, pinout y dimensiones; no validado eléctricamente | https://lcsc.com/product-detail/Schottky-Diodes_TDSEMIC-SS34-TD_C46550832.html | no verificado | no verificado | sin cotización comparable | Metadatos CAD; fabricante/MPN transcritos, no autenticados. Pinout y geometría pendientes de Altium/datasheet.
FB_60_0603_2A | HCB1608KF-600T20 | TAI-TECH | Alimentación / FB | 2A 1 100mO 60O@100MHz ±25% 0603 Ferrite Beads ROHS | 0603_fb | sí | sí | sí | 742792602.stp | C:\dev\7mo\design\industrial-linux-gateway\shared_lib (1).IntLib | SchLib/0.schlib::FB_60_0603_2A/Data | PCBLib/0.pcblib::0603_fb/Data | Reutilización condicionada a valor, ratings, pinout y dimensiones; no validado eléctricamente | https://www.lcsc.com/product-detail/Ferrite-Beads_TAI-TECH-HCB1608KF-600T20_C369516.html | no verificado | no verificado | sin cotización comparable | Metadatos CAD; fabricante/MPN transcritos, no autenticados. Pinout y geometría pendientes de Altium/datasheet.
H_Male_2x1_TH_100mil | no consignado | no consignado | Soporte / H | H_Male_2x1_TH_100mil | H_2x1_TH_100mil | sí | sí | sí | PH1-02-UA.STEP | C:\dev\7mo\design\industrial-linux-gateway\shared_lib (1).IntLib | SchLib/0.schlib::H_Male_2x1_TH_100mil/Data | PCBLib/0.pcblib::H_2x1_TH_100mil/Data | Reutilización condicionada a valor, ratings, pinout y dimensiones; no validado eléctricamente | sin enlace en CAD | no verificado | no verificado | sin cotización comparable | Metadatos CAD; fabricante/MPN transcritos, no autenticados. Pinout y geometría pendientes de Altium/datasheet. MPN no consignado; referencia CAD genérica.
H_Male_3x1_TH_100mil | no consignado | no consignado | Soporte / H | H_Male_3x1_TH_100mil | H_3X1_TH_100mil | sí | sí | sí | 5-146278-3--3DModel-STEP-1.STEP | C:\dev\7mo\design\industrial-linux-gateway\shared_lib (1).IntLib | SchLib/0.schlib::H_Male_3x1_TH_100mil/Data | PCBLib/0.pcblib::H_3X1_TH_100mil/Data | Reutilización condicionada a valor, ratings, pinout y dimensiones; no validado eléctricamente | sin enlace en CAD | no verificado | no verificado | sin cotización comparable | Metadatos CAD; fabricante/MPN transcritos, no autenticados. Pinout y geometría pendientes de Altium/datasheet. MPN no consignado; referencia CAD genérica.
H_Male_4x1_TH_100mil | no consignado | no consignado | Soporte / H | H_Male_4x1_TH_100mil | H_4x1_TH_2.54mm | sí | sí | sí | TSW-104-14-T-S.step | C:\dev\7mo\design\industrial-linux-gateway\shared_lib (1).IntLib | SchLib/0.schlib::H_Male_4x1_TH_100mil/Data | PCBLib/0.pcblib::H_4x1_TH_2.54mm/Data | Reutilización condicionada a valor, ratings, pinout y dimensiones; no validado eléctricamente | sin enlace en CAD | no verificado | no verificado | sin cotización comparable | Metadatos CAD; fabricante/MPN transcritos, no autenticados. Pinout y geometría pendientes de Altium/datasheet. MPN no consignado; referencia CAD genérica.
H_Male_5x1_TH_100mil | no consignado | no consignado | Soporte / H | H_Male_5x1_TH_100mil | H_5x1_TH_100mil | sí | sí | sí | CircuitWorks-HEADER 2_54 VERTICAL 5X.STEP | C:\dev\7mo\design\industrial-linux-gateway\shared_lib (1).IntLib | SchLib/0.schlib::H_Male_5x1_TH_100mil/Data | PCBLib/0.pcblib::H_5x1_TH_100mil/Data | Reutilización condicionada a valor, ratings, pinout y dimensiones; no validado eléctricamente | sin enlace en CAD | no verificado | no verificado | sin cotización comparable | Metadatos CAD; fabricante/MPN transcritos, no autenticados. Pinout y geometría pendientes de Altium/datasheet. MPN no consignado; referencia CAD genérica.
H_Male_6x1_TH_100mil | no consignado | no consignado | Soporte / H | H_Male_6x1_TH_100mil | H_6x1_TH_100mil | sí | sí | no | no encontrado | C:\dev\7mo\design\industrial-linux-gateway\shared_lib (1).IntLib | SchLib/0.schlib::H_Male_6x1_TH_100mil/Data | PCBLib/0.pcblib::H_6x1_TH_100mil/Data | Reutilización condicionada a valor, ratings, pinout y dimensiones; no validado eléctricamente | sin enlace en CAD | no verificado | no verificado | sin cotización comparable | Metadatos CAD; fabricante/MPN transcritos, no autenticados. Pinout y geometría pendientes de Altium/datasheet. MPN no consignado; referencia CAD genérica.
H_Male_7x1_TH_100mil | no consignado | no consignado | Soporte / H | H_Male_7x1_TH_100mil | H_7x1_TH_100mil | sí | sí | no | no encontrado | C:\dev\7mo\design\industrial-linux-gateway\shared_lib (1).IntLib | SchLib/0.schlib::H_Male_7x1_TH_100mil/Data | PCBLib/0.pcblib::H_7x1_TH_100mil/Data | Reutilización condicionada a valor, ratings, pinout y dimensiones; no validado eléctricamente | sin enlace en CAD | no verificado | no verificado | sin cotización comparable | Metadatos CAD; fabricante/MPN transcritos, no autenticados. Pinout y geometría pendientes de Altium/datasheet. MPN no consignado; referencia CAD genérica.
IC_BAT_CHG_4.2V_1A | TP4056 | YONGYUTAI | Alimentación / IC | -300mV~8V Lithium-ion/Polymer 1 1A ESOP-8 Battery Management ROHS | SOIC_8_3.9mm | sí | sí | sí | SOIC127P600X173-8N.step | C:\dev\7mo\design\industrial-linux-gateway\shared_lib (1).IntLib | SchLib/0.schlib::IC_BAT_CHG_4.2V_1A/Data | PCBLib/0.pcblib::SOIC_8_3.9mm/Data | Cargador Li-ion; fuera de alcance | https://lcsc.com/product-detail/Battery-Management_YONGYUTAI-TP4056_C20199357.html | no verificado | no verificado | sin cotización comparable | Metadatos CAD; fabricante/MPN transcritos, no autenticados. Pinout y geometría pendientes de Altium/datasheet.
IC_FLASH_ZD25WQ16BTIGR_8SOP | ZD25WQ16BTIGR | Zetta | Procesamiento / memoria | IC FLASH 16M SPI 85MHZ 8SOP | SOIC_8_3.9mm | sí | sí | sí | SOIC127P600X173-8N.step | C:\dev\7mo\design\industrial-linux-gateway\shared_lib (1).IntLib | SchLib/0.schlib::IC_FLASH_ZD25WQ16BTIGR_8SOP/Data | PCBLib/0.pcblib::SOIC_8_3.9mm/Data | Memoria externa diferible | https://www.lcsc.com/product-detail/NOR-FLASH_Zetta-ZD25WQ16BTIGR_C2896790.html | no verificado | no verificado | sin cotización comparable | Metadatos CAD; fabricante/MPN transcritos, no autenticados. Pinout y geometría pendientes de Altium/datasheet.
IC_SGL_USB2UART-BRIDGE_20QFN | CP2102N-A02-GQFN20R | Silicon Labs | Comunicaciones / USB-UART | IC USB TO UART BRIDGE QFN20 | WFQFN_20_EP_3X3MM | sí | sí | sí | cuerpo extruido CAD | C:\dev\7mo\design\industrial-linux-gateway\shared_lib (1).IntLib | SchLib/0.schlib::IC_SGL_USB2UART-BRIDGE_20QFN/Data | PCBLib/0.pcblib::WFQFN_20_EP_3X3MM/Data | Consola/carga opcional; no es RS-485 ni depurador JTAG/SWD | https://www.lcsc.com/product-detail/USB-ICs_SILICON-LABS-CP2102N-A02-GQFN20R_C969913.html | no verificado | no verificado | sin cotización comparable | Metadatos CAD; fabricante/MPN transcritos, no autenticados. Pinout y geometría pendientes de Altium/datasheet.
IC_STM32F030C8T6TR_LQFP48_7x7MM | STM32F030C8T6TR | STMicroelectronics | Procesamiento / MCU | IC MCU 32BIT 64KB FLASH 48LQFP | LQFP48_7x7mm | sí | sí | sí | LQFP48-7x7mm.step | C:\dev\7mo\design\industrial-linux-gateway\shared_lib (1).IntLib | SchLib/0.schlib::IC_STM32F030C8T6TR_LQFP48_7x7MM/Data | PCBLib/0.pcblib::LQFP48_7x7mm/Data | No recomendado para migración directa PoC Zephyr/IP: 64 KiB Flash y 8 KiB RAM; sin MAC | https://www.lcsc.com/product-detail/ST-Microelectronics_STMicroelectronics-STM32F030C8T6_C23922.html | no verificado | no verificado | sin cotización comparable | Metadatos CAD; fabricante/MPN transcritos, no autenticados. Pinout y geometría pendientes de Altium/datasheet.
Inductor_10uH_1.42A_5.8*5.2mm | CY54-10UH | SHOU HAN | Alimentación / Inductor | 1.42A 10uH ±10% 87.9mO SMD,5.8x5.2mm Inductors (SMD) ROHS | Ind_5.8*5.2_NS | sí | sí | sí | cuerpo extruido CAD | C:\dev\7mo\design\industrial-linux-gateway\shared_lib (1).IntLib | SchLib/0.schlib::Inductor_10uH_1.42A_5.8_5.2mm/Data | PCBLib/0.pcblib::Ind_5.8_5.2_NS/Data | Reutilización condicionada a valor, ratings, pinout y dimensiones; no validado eléctricamente | https://lcsc.com/product-detail/Inductors-SMD_SHOU-HAN-CY54-4-7UH_C2929429.html | no verificado | no verificado | sin cotización comparable | Metadatos CAD; fabricante/MPN transcritos, no autenticados. Pinout y geometría pendientes de Altium/datasheet.
Inductor_10uH_4A_7.2*6.6mm | CYA0630-10UH | SHOU HAN | Alimentación / Inductor | 4A 2.2uH ±20% 22.1mO SMD,5.8x5.2mm Inductors (SMD) ROHS | Ind_7.2*6.6_NS | sí | sí | sí | cuerpo extruido CAD | C:\dev\7mo\design\industrial-linux-gateway\shared_lib (1).IntLib | SchLib/0.schlib::Inductor_10uH_4A_7.2_6.6mm/Data | PCBLib/0.pcblib::Ind_7.2_6.6_NS/Data | Reutilización condicionada a valor, ratings, pinout y dimensiones; no validado eléctricamente | https://lcsc.com/product-detail/Inductors-SMD_SHOU-HAN-CYA0630-10UH_C5189958.html | no verificado | no verificado | sin cotización comparable | Metadatos CAD; fabricante/MPN transcritos, no autenticados. Pinout y geometría pendientes de Altium/datasheet. Nombre 10uH/7.2x6.6; descripción dice 2.2uH/5.8x5.2: inconsistencia.
Inductor_2.2uH_4A_5.8*5.2mm | CY54-2.2UH | SHOU HAN | Alimentación / Inductor | 4A 2.2uH ±20% 22.1mO SMD,5.8x5.2mm Inductors (SMD) ROHS | Ind_5.8*5.2_NS | sí | sí | sí | cuerpo extruido CAD | C:\dev\7mo\design\industrial-linux-gateway\shared_lib (1).IntLib | SchLib/0.schlib::Inductor_2.2uH_4A_5.8_5.2mm/Data | PCBLib/0.pcblib::Ind_5.8_5.2_NS/Data | Reutilización condicionada a valor, ratings, pinout y dimensiones; no validado eléctricamente | https://lcsc.com/product-detail/Inductors-SMD_SHOU-HAN-CY54-2-2UH_C2929427.html | no verificado | no verificado | sin cotización comparable | Metadatos CAD; fabricante/MPN transcritos, no autenticados. Pinout y geometría pendientes de Altium/datasheet.
Inductor_22uH_1.1A_5.8*5.2mm | CY54-22UH | SHOU HAN | Alimentación / Inductor | 22uH SMD,5.8x5.2mm Inductors (SMD) ROHS | Ind_5.8*5.2_NS | sí | sí | sí | cuerpo extruido CAD | C:\dev\7mo\design\industrial-linux-gateway\shared_lib (1).IntLib | SchLib/0.schlib::Inductor_22uH_1.1A_5.8_5.2mm/Data | PCBLib/0.pcblib::Ind_5.8_5.2_NS/Data | Reutilización condicionada a valor, ratings, pinout y dimensiones; no validado eléctricamente | https://lcsc.com/product-detail/Inductors-SMD_SHOU-HAN-CY54-22UH_C2879694.html | no verificado | no verificado | sin cotización comparable | Metadatos CAD; fabricante/MPN transcritos, no autenticados. Pinout y geometría pendientes de Altium/datasheet.
Inductor_47uH_0.71A_5.8*5.2mm | CY54-47UH | SHOU HAN | Alimentación / Inductor | 710mA 47uH ±10% 355mO SMD,5.8x5.2mm Inductors (SMD) ROHS | Ind_5.8*5.2_NS | sí | sí | sí | cuerpo extruido CAD | C:\dev\7mo\design\industrial-linux-gateway\shared_lib (1).IntLib | SchLib/0.schlib::Inductor_47uH_0.71A_5.8_5.2mm/Data | PCBLib/0.pcblib::Ind_5.8_5.2_NS/Data | Reutilización condicionada a valor, ratings, pinout y dimensiones; no validado eléctricamente | https://lcsc.com/product-detail/Inductors-SMD_SHOU-HAN-CY54-47UH_C2929434.html | no verificado | no verificado | sin cotización comparable | Metadatos CAD; fabricante/MPN transcritos, no autenticados. Pinout y geometría pendientes de Altium/datasheet.
LDO_3V3_1A_FIXED | AMS1117-3.3 | UMW(Youtai Semiconductor Co., Ltd.) | Alimentación / LDO | 1A 60dB@(120Hz) Fixed 3.3V Positive 18V SOT-223 Linear Voltage Regulators (LDO) ROHS | SOT_223 | sí | sí | sí | cuerpo extruido CAD | C:\dev\7mo\design\industrial-linux-gateway\shared_lib (1).IntLib | SchLib/0.schlib::LDO_3V3_1A_FIXED/Data | PCBLib/0.pcblib::SOT_223/Data | Posible 5 V a 3.3 V; verificar dropout, estabilidad y disipación; no entrada directa 24 V | https://www.lcsc.com/product-detail/_UMW-Youtai-Semiconductor-Co-Ltd-_C347222.html | no verificado | no verificado | sin cotización comparable | Metadatos CAD; fabricante/MPN transcritos, no autenticados. Pinout y geometría pendientes de Altium/datasheet.
LED_0805_Green | XL-2012UGC | XINGLIGHT | Soporte / LED | LED GREEN CLEAR 0805 SMD | 0805_LED | sí | sí | sí | cuerpo extruido CAD | C:\dev\7mo\design\industrial-linux-gateway\shared_lib (1).IntLib | SchLib/0.schlib::LED_0805_Green/Data | PCBLib/0.pcblib::0805_LED/Data | Reutilización condicionada a valor, ratings, pinout y dimensiones; no validado eléctricamente | https://www.lcsc.com/product-detail/Light-Emitting-Diodes-LED_XINGLIGHT-XL-2012UGC_C965815.html | no verificado | no verificado | sin cotización comparable | Metadatos CAD; fabricante/MPN transcritos, no autenticados. Pinout y geometría pendientes de Altium/datasheet.
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
