anhenaobe/industrial-comunication-gateway/docs/sources/webench/LMR36015_WEBENCH_BOM.csv

Part | Manufacturer | Part Number | Quantity | Price ($) | Footprint (mm²) | Description
Rfbb | Yageo | RC0603FR-0724K9L | 1 | 0.01 | 4.68 | Resistance: 24.9 kΩ Tolerance: 1.0% Power: 100 mW
Rfbt | Vishay-Dale | CRCW0402100KFKED | 1 | 0.01 | 3 | Resistance: 100 kΩ Tolerance: 1.0% Power: 63 mW
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
