anhenaobe/industrial-comunication-gateway/docs/hardware/evidence/electrical_closure/baseline/manufacturer_layout_guidelines.md

# Placement y routing de fabricante — candidato académico

Fecha: 2026-11-05. **Restricciones documentales; layout sin verificar.** No existe PcbDoc ni stackup del gateway sobre el cual medir distancias, impedancias, retornos o temperatura. Las fuentes S1–S11 se resuelven en [selección de pasivos](passive_component_selection.md#registro-de-fuentes). No se comenzó routing.

## Requisitos por subsistema

| Bloque | Fuente oficial/localizador | Restricciones de implementación | Comprobación pendiente |
|---|---|---|---|
| MCU alimentación | ST AN5419 tabla2/fig3; DS13313 fig5/tabla14 | Desacoplo junto a cada VDD; retorno corto a VSS. VCAP48/73 con2.2µF/ESR<100mΩ en modo LDO, sin cargas externas. VDDA/VREF/VBAT según función; no copiar SMPS de otra variante | Fanout LQFP100, cinco VDD, Ceff/ESR y retornos analógicos |
| MCU oscilador | [ST AN2867 Rev25 §§7.1–7.2 pp45–50](https://www.st.com/resource/en/application_note/an2867-oscillator-design-guide-for-stm8afals-stm32-mcus-and-mpus-stmicroelectronics.pdf); AN5419 §3 | Red compacta junto a OSC_IN/OUT; controlar parasitismos y acoplo. Aplicar ejemplo correspondiente al encapsulado/reloj; preservar retorno de cargas | Cristal, Cstray, drive y margen de arranque sin cerrar |
| MCU debug/reset | AN5419 §§2.2.5/5/6; DS13313 fig18 | NRST con capacitor/pulsador. SWD con GND/VTref/NRST y pin1 inequívoco; VTref es referencia de tensión | Header1x6 propio no homologado como ARM; pinout y temporización pendientes |
| PHY alimentación/bias | [DP83826I §9.3 fig9-6 p99](https://www.ti.com/lit/ds/symlink/dp83826i.pdf), tabla5-1 | Un banco10µF/1µF/100nF/10nF por VDDA3V3 y VDDIO. Retornos locales. RBIAS6.49kΩ/1%, CEXT2nF. EP a GND | Footprint RHB exacto/EP/vías/pasta; no copiar CEXT100nF de EVM |
| RMII/referencia | DP83826I §§9.2.5.2/9.4.1 pp97–101; timing §7 | 50Ω single-ended; <5cm recomendado, <15cm máximo. Matching dentro de grupoTX y grupoRX; evitar stubs y vías. Leader:50MHz pin19 a ETH_REF_CLK | Stackup, anchos, skew permitido, carga y overshoot. No inventar matching±1mm universal |
| MDI/magnetics | DP83826I §§9.2.5.3/9.4.1 y fig9-10; [EVM fig6-2](https://www.ti.com/lit/ug/snlu262a/snlu262a.pdf) | 100Ω diferencial/50Ω a tierra, pares paralelos/acoplados en misma capa. Retorno continuo hasta región aislada. **Ninguna capa metálica bajo transformador.** Blindaje RJ45 a chasis; planos chasis/GND sin solape. Acoplo mediante capacitor≥1206 recomendado | Jack/taps/terminación, HPOT, transición de planos e impedancia. HX1188FNLT y SS-7188S-A-NF son candidatos EVM, pendientes de fichas exactas |
| ESD Ethernet | EVM U13 TPD4E05U06DQAR fig6-2 | Revisar disposición y retorno contra layout oficial y datasheet exacto del protector | Capacitancia/clamp/pinout/retorno sin homologar. No sustituir por USBLC6 por parecido |
| Bucks B3/B5 | [LMR36015 §§12.1–12.2 figs12-1/12-2 pp34–35](https://www.ti.com/lit/ds/symlink/lmr36015.pdf); pinesp4 | CHF220nF junto a cada par VIN-PGND en lados opuestos. CIN próximo, lazo de conmutación mínimo. CVCC/CBOOT junto al IC, conexiones cortas/anchas. SW12 a NC3. FB/CFF cerca de FB/AGND; sense VOUT alejado de SW. Plano GND interno, caminos VIN/VOUT/GND anchos. SW corto/ancho con área mínima | Dimensiones2220/1210/XAL impiden copiar otro placement sin revisión. RNX exacto, sin inventar EP. Lazo de entrada, feedback y térmica por rail |
| Inductores | Coilcraft XAL40xx documento806 p1/notas y dibujo p4 | Dibujo exacto4030/4040, altura, terminales y curvas térmicas; revisar acoplo a reloj/MDI | Isat25°C no garantiza comportamiento en caliente; pérdidasAC/núcleo y temperatura sin verificar |
| Entrada | LMR36015 §11 p33; esquema simplificado pendiente | Fuente/cable/CIN pueden resonar; bulk/damping según impedancia. No añadir LC sin estabilidad. Coordinar clampTVS+Ldi/dt con todos los límites. Evitar snap-back que descargue COUT hacia VIN | Sin circuito aprobado: fusible/inversión/TVS/filtro sin placement definitivo; PE y sobretensión continua pendientes |
| RS-485 | [THVD1420 §10.1/fig10-1 p20](https://www.ti.com/lit/ds/symlink/thvd1420.pdf) | Protección junto al bornero y en camino de señal, retorno corto. Planos VCC/GND, bypass100–220nF junto al IC. TI recomienda≥2vías en VCC/GND de protección/desacoplo. Pulls1–10kΩ; resistores pulse-proof si clamp supera absmax | Topología, velocidad, cable, stubs y terminación. Figura surge usa THVD1400/5V: revisar THVD1420/3.3V antes de copiar |
| CAN-FD | Microchip DS50002649A §§3.5–3.8 y apéndiceA; DS20005991B | 100nF cerca de VCC5V y VIO3V3. Split termination solo en extremo, resistencias pareadas, retorno corto del capacitor central. CMC/100pF solo tras revisar EMC/timing | Stub, carga capacitiva a5Mbps y protección. No copiar jumper que une VIO a5V |
| Traductor DO | [SN74LVC2T45 §§8.3–8.4 fig8-3](https://www.ti.com/lit/ds/symlink/sn74lvc2t45.pdf) | Desacoplo junto a ambos VCC; DIR a VCCA; entradas definidas y GND común para traducción | DCU exacto, VOH hacia BSP75N y rampas de ambos rails; el IC no tiene OE |
| BSP75N | [Diodes DS33016 pp1/3/5–8](https://www.diodes.com/assets/Datasheets/BSP75N.pdf) | Tab SOURCE aislado de DRAIN. Nota5: placa25×25×1.6mm/2oz/cobre6cm² repartido33%source/66%drain. Nota6 con cobre mínimo daRθJA208°C/W frente83°C/W nota5. Son condiciones de ensayo, no área universal garantizada | Dos canales0.5A, ambiente/enclosure, cobre y energía inductiva. Retornos de carga separados de RBIAS/VCAP/FB. SOT223 de LDO no prueba pinout |
| DI ISO1212 | [ISO1212 §§8.3–8.4 pp30–32 figs8-17/8-18](https://www.ti.com/lit/ds/symlink/iso1212.pdf) | RSENSE/CIN/RTHR en lado campo y plano FGND por región. CIN próximo y≥50V. SUB1/SUB2 NC. Terminal externo de altaV de RTHR a≥4mm de pines ISO121x/RSENSE/CIN para evitar flashoverEMC. Desacoplo VCC1 lado lógico | Barrera FGND/GND1 en todas las capas y creepage/clearance según aislamiento. Los4mm citados no establecen por sí solos el aislamiento final. MELF/pulsos y PE pendientes |

## Integración en una PCB común

| Conflicto | Revisión propuesta | Estado |
|---|---|---|
| Retorno continuo RMII/MDI frente a keepout bajo magnetics | Definir keepout del transformador y transición en la barrera; no llevar RMII sobre cortes | BLOCKED: jack/stackup |
| GND lógico/retornos DO frente a FGND aislado y chasis/PE | Dibujar matriz de conexiones permitidas; decidir aislamiento por grupo/canal antes de unir planos o acoplos | BLOCKED: arquitectura |
| Bucks requieren plano interno; PHY recomienda≥4capas,6 si es posible; DI permite2capas | Revisar propuesta de4capas con fabricante y adaptar región aislada en todas ellas; no copiar stackup/ancho EVM | PROVISIONAL |
| Cobre térmico frente a fabricación/impedancia | Confirmar cobre y stackup, recalcular pistas/temperatura. S5 recomienda2oz exteriores y no menos de1oz | BLOCKED |
| Cristales/relojes frente a SW/inductores/retornos de carga | Reservar zonas según figuras oficiales; revisar acoplo y retornos antes de cerrar placement | PROVISIONAL: sin coordenadas |
| Retorno cortoTVS frente a aislamiento/chasis | Definir destino de corriente ESD/surge y revisar clamp con parásitos | BLOCKED |

No se fijan anchos mínimos, vías genéricas, separaciones térmicas ni tolerancias de matching sin evidencia. Se necesitan fabricante, stackup, mecánica, cargas y presupuesto de timing. **Ninguna distancia o temperatura está verificada sobre una PCB del gateway.**

DP83826EVM y ATA656x EVKit están disponibles localmente. [ISO1212EVM](https://www.ti.com/tool/ISO1212EVM) ejemplifica ocho canales: no añadir sus cuatro ICs al alcance de dos DI. La aplicación FB del datasheet LMR36015 es referencia de variante; una EVM AR o de otro IC no sustituye sus condiciones. Para BSP75N y SN74LVC2T45 se usaron dibujos/notas de datasheet; no se afirma haber localizado una EVM oficial específica.
