anhenaobe/industrial-comunication-gateway/docs/hardware/evidence/input_protection/verification_scope.md

# Verification scope

This task uses only Electronics AI `libraries__` file operations and read-only supply catalog queries. No `eda__` operation, UI session, schematic edit, PCB edit, stackup edit, global library registration, installation, commit or push is part of this task.

Manufacturer PDFs copied from `C:/dev/7mo/design/Datasheets_industrial_gateway/` are hash-identical local source copies. Littelfuse official global/legacy/regional PDF downloads returned HTTP403; no fuse PDF file or footprint was fabricated. Manufacturer web PDF text was readable and supports the candidate's electrical ratings and ordering suffix. A readable pad-layout drawing is still required.

The first SchLib append was rejected because a component stream name contained a slash. Independent list readback showed46 symbols and the SHA256 exactly matched the pre-write backup. Only then was the stream name changed to `SS3P6L-M3_86A`; its MPN parameter remains `SS3P6L-M3/86A`. The corrected append succeeded. No existing component was overwritten.

Native Altium compilation was not attempted because the user forbids starting another automation session. File validation and persisted component readback were performed. The previously compiled IntLib remains unchanged and does not include these additions. Compile `Gateway_Academic.LibPkg` manually in an idle Altium session before relying on the integrated library.
