anhenaobe/industrial-comunication-gateway/(list of files, drawings)

Other design files:
docs/hardware/evidence/native_schematic_audit/pcb_source.json
hardware/academic_rev1/backups/autonomous_20261108T195741Z/Ethernet.SchDoc
hardware/academic_rev1/backups/autonomous_20261108T195741Z/Field_IO.SchDoc
hardware/academic_rev1/backups/autonomous_20261108T195741Z/Industrial_Gateway_Academic.PrjPcb
hardware/academic_rev1/backups/autonomous_20261108T195741Z/MCU.SchDoc
hardware/academic_rev1/backups/autonomous_20261108T195741Z/Power.SchDoc
hardware/academic_rev1/backups/autonomous_20261108T195741Z/TopLevel.SchDoc
hardware/academic_rev1/backups/native_schematic_audit_20261107/Ethernet.SchDoc
hardware/academic_rev1/backups/native_schematic_audit_20261107/Field_IO.SchDoc
hardware/academic_rev1/backups/native_schematic_audit_20261107/MCU.SchDoc
hardware/academic_rev1/backups/native_schematic_audit_20261107/Power.SchDoc
hardware/academic_rev1/backups/native_schematic_audit_20261107/TopLevel.SchDoc
hardware/academic_rev1/Ethernet.SchDoc
hardware/academic_rev1/Field_IO.SchDoc
hardware/academic_rev1/Industrial_Gateway_Academic.PrjPcb
hardware/academic_rev1/MCU.SchDoc
hardware/academic_rev1/PCB1.PcbDoc
hardware/academic_rev1/Power.SchDoc
hardware/academic_rev1/TopLevel.SchDoc
