anhenaobe/industrial-comunication-gateway/(commit log)

2026-09-15 docs: align Rev A with STM32H723 and Zephyr
2026-11-10 hardware: add academic Rev1 Altium project, libraries and design docs
    Adds the Rev1 academic gateway Altium project (schematics, PrjPcb, project
    SchLib/PcbLib, datasheet sources, backups) and the hardware documentation
    and evidence under docs/hardware.
    New docs/hardware/project_status_rev1.md records the current state as of
    2026-11-09: items N01-N05, N07, N10 and N11 closed in the saved schematics
    (offline netlist check, no Altium compile/ERC yet), and the remaining
    electrical, CAD and documentation work before PCB.
    Ignores Altium-generated History, __Previews, Project Logs and Project
    Outputs folders.
2026-11-10 hardware: phase 1 - chassis return, field bus connectors, debug headers
    Captures the approved Rev1 decisions in the Altium project:
    - N06 Ethernet: J2 shield S1/S2 and Bob Smith C46.1/C52.1 on new net
    CHASSIS; R34 1 Mohm (RC0603FR-071ML) || C65 1 nF/2 kV between CHASSIS
    and GND. Removed two stale GND power ports that shorted CHASSIS to GND
    and the floating C64. Compiled netlist confirms CHASSIS (6 pins) is
    separate from GND.
    - N08: RS-485 terminal J9 (1=A, 2=B, 3=GND) with SM712 D4; CAN terminal
    J10 (1=CANH, 2=CANL, 3=GND) with R36 120 ohm.
    - Variant Rev1_Assembly: R34, C65, R35, R36 Not Fitted (in addition to
    C11, C20, R6, R9).
    - J3 SWD 1x6 and J8 BOOT 1x2 headers: Wurth 6130061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
2026-11-10 hardware: final Rev1 schematic closure - models, footprints, ERC clean
    - All 136 placed components carry exactly one current PCB model that exists
    in Gateway_Academic.PcbLib; no GW_CAND placeholders remain (63 relinked,
    33 orphaned implementation records repaired, C1/C2 duplicates removed).
    - TPS26620 uses GW_DRC0010J_TI_TPS2662_EPU (exposed-pad segments share pad
    11); PCB1 readback shows all five EP copper pieces on EF_RTN.
    - 18 manufacturer footprints gained assembly outline, courtyard, silkscreen
    with pin-1 marker and extruded 3D body (copper unchanged).
    - Second C5750 input capacitor per buck (C66, C67).
    - Native compile + ERC: 0 unsuppressed errors, 0 missing models; schematic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
2026-11-11 docs(hardware): PCB Rev1 design rules from JLCPCB capabilities and IPC-2221 widths
